ZacharyShaver/FPVTank_Prototype/research/README.md

# Research sprint (2026-10-13 to 2026-10-27)

Evidence for the research plan "Checks That Can Fail" (UM-LANL SPARC AI Research Fellow application, due
2026-10-27). The plan and the sprint schedule live in the FPVTank_Control session folder (`research-plan/`).

| Path | What |
|---|---|
| `data/iterations.csv` | Workstream A: one row per design finding, Sep 27 to Oct 12 (P), plus earlier drivetrain and electronics escapes (E). Retrospective. |
| `data/check_failures.csv` | Every recorded case of an automated check itself being wrong (false pass, false fail, weak control). |
| `analysis/iterations.py` | Statistics (`results/iterations_summary.json`) and `figures/iterations.png`. |
| `paper/` | The research plan, draft v6 (2026-10-25): `checks-that-can-fail-v6.html` and its PDF, Figure 1 `fig1_v6.png` from `make_fig1.py`; the PDF comes from Edge's print dialog, Save as PDF, or `pagefit.py --pdf` (US Letter, 3 pages; `pagefit.py --print` checks the fit first). `review-v3.md`, `review-v4.md` and `review-v5.md` (a cold read by a fresh agent) hold the reviews that made v4, v5 and v6. **Superseded:** drafts v5 and v4 (`checks-that-can-fail-v5.html`, `-v4.html`, their PDFs, `fig1_v4.png`) and draft v3 (`checks-that-can-fail-v3.html`, its PDF, `fig1.png`), kept as they were. The Oct 13 draft stays in the session folder. |

**How the data was made.** Finding times come from the session transcripts (Zach's message reporting the finding) or
from the check or slicer run. Fix times come from G-code and superseded-folder timestamps, or from `docs/decisions.md`
dates. `time_basis` says which: `exact` (minute), `approx`, `day`, `reconstructed`. Only `exact` rows enter the
cycle-time statistics. The transcripts themselves stay out of the repo; findings are paraphrased.

**Categories.** `found_by`:
- `bench`: physical handling or test.
- `review`: Zach looking at a model or view before printing.
- `check`: an automated check during design.
- `agent review`: the AI noticing a fault while designing.
- `slicer`: print preparation.
- `print`: a failure while printing.

Everything except `bench` and `print` counts as caught before printing. `check_had_passed` is `yes` when an existing
automated check had passed the defect.

Prospective data, logged as findings happen from 2026-10-13, goes in `data/iterations_live.csv` and is kept separate. Its times are the times of the commits that recorded each finding (the hash is in `notes`); IDs follow the order things were logged, and are never renumbered, because commits and PROTOCOL.md cite them.

**Hypothesis names.** `tumble/PROTOCOL.md` registered the 30 cm drops as its "H4"; in the paper they are H3b, and the paper's H4 is cycle time. The paper's H3c (15 cm) is PROTOCOL's H3c.
