ZacharyShaver/FPVTank_Prototype/docs/lessons/README.md

# Lessons

One dated file per lesson learned the hard way in CAD work, e.g. `2026-09-19-coincident-faces-and-insertion.md`.

The first three came over from FPVTank_Control's `docs/lessons/` in phase B (2026-09-27). Control keeps
its own drivetrain lesson.
