ZacharyShaver/FPVTank_Prototype/reference/solids/README.md

# Fit-check dummies

Solids of the real hardware, which the checks place next to Zach's parts:
- the servo, turned, with its tabs as bought and as snipped;
- the camera;
- the 6704 bearing;
- screw heads.

Nothing is stored here yet. Until then:
- the servo is built in code (`tools/kit.py`: `servo`, `servo_trimmed`);
- the camera is read from the generator's `camera/camera_dummy.step`;
- the bearing comes from the generator's `bearing_dummy.py`.

The generator is in `head-v2/generator/` now; export them here when a check needs them as files.
