ZacharyShaver/FPVTank_Prototype/head-v2/fusion/rev1-2026-09-24/README.md

# Zach's Fusion revision 1 (exported 2026-09-24)

These are his files as he sent them. `tools/config.py` (`ZACH`) maps them to parts:

| File | Part |
|---|---|
| `BODY_NUMBA1 (1) (1).stl` | ball_plus: the half the servo and camera go into |
| `ball_minus_revised.stl` | ball_minus |
| `ball_servo_post_revised.stl` | the post the tilt servo's spline presses into |

In this revision:
- the tilt servo is turned 90° and boxed in plates;
- the servo's case top stops on a plate at Y 21.24;
- the camera board sits on the front of his wall, at X 10.5.

Rev 2 (`head-v2/fixes/`) is these files plus the fixes.
