ZacharyShaver/FPVTank_Prototype/research/data/drops/README.md

# Physical drop tests (workstream E): raw data

Recorded by hand on paper, one mark per drop, and videoed. Transcribed from the sheet photo before any scoring;
the predictions were committed first (research/results/drop_predictions.json, commit 0718c2f).

## Run 1 (2026-10-13): 3 bodies x 6 starts x 5 drops = 90 drops, 12 US quarters

- `run1_sheet.jpg` is the sheet; `run1.csv` is the transcription, one row per drop.
- Zach's marks: X inverted, O upright, N nose down, T tail down (nose up), R right side, L left side, F front
  (read as nose down).
- Bodies are identified on the sheet by drawn icons. Zach, before scoring: top to bottom E2, E3, E1, so oval =
  E2_dome, rounded square = E3_tall, hill = E1_tub.
- Loading: coins first, then the spacer (Zach), which is **mass high** in DROP_TEST.md. The card asked for mass low
  first; the order of the two runs does not change either prediction.

## The E1 video (`IMG_1617.MOV`, Zach's Downloads, 174 MB, not in git)

- The same 6 cm session as the sheet. The video starts partway through: it holds the last 2 nose-down drops and
  all 25 after them, 27 in total. One more pick-up at 1:24 lifts the body out of frame and isn't a drop.
- `video_E1.csv` is my reading of each drop's landing from the frames, matched to the card's order of starting
  attitudes. It agrees with the sheet's E1 row on 24 of 27. The 3 that differ are drops 2-4 of the left-side block
  (video X O X, sheet O X O). Zach's call (2026-10-13): **go with the video** for E1.
- Correction to my first pass: I read drops 12 and 16 as "standing on end". They are lying on their side (base to
  one side), which is what Zach wrote (R). With that fixed, the right-side, tail-down, upside-down and 45 blocks
  match the sheet exactly.
- Release height: about 4-8 cm by eye. The simulation moves no E1 probability by more than 0.03 across 40-80 mm
  (`results/drop_predictions_E1_40mm.md`, `_E1_80mm.md`), so no drop is redone for height. A rerun at 60 mm reproduced
  the committed predictions exactly.
- **Nose and tail are swapped against the card.** Zach did the nose-down block first (2026-10-13), and the video
  cut off its first 3 drops. In its last 2 (video 1-2), the side profile is widest at the top, where the head's bump
  is. So "nose down" was flown with the head end **up**. In the tail-down block (video 4-7), the head end (the pointed
  end seen from the base) is plainly down. So Zach's "nose down" is the model's tail down, and vice versa. The
  scoring maps by the physical end, and assumes the same convention for E2 and E3 (same session, no video).
- Left and right: all three bodies are mirror-symmetric, so "left side" and "right side" (starts and rest states)
  are the same physics and get merged into "side" when scoring.
- Found while checking this: `tumble.classify` names the on-end rest states opposite to `scale_model.ATTITUDES`
  (+X up is called "nose down"). It doesn't touch P(upright) or anything already reported; when scoring, the
  predicted "nose up"/"nose down" rest labels are swapped back. Probabilities are unchanged.
- `results/drop_predictions_30cm.*` are the same model at 300 mm, for the 30 cm drops (recorded elsewhere, no
  video). They were run after those drops, so they count as post hoc.

## Slow-motion video 1 (`IMG_1628.MOV`, 2026-10-14, 240 fps, 434 MB, not in git)
- 5 drops of E3, weight low, filmed looking along the floor from about a metre away.
- Released from well above 6 cm: the body is in view and falling for about 0.18 s before it lands, already more than
  a 6 cm fall takes (0.11 s), so it fell at least 15 cm.
- The bodies land tilted and tumble; none landed flat.
- The 5th drop split the tape: the coins and the spacer spilled out.
- **Not usable for restitution**, which needs flat drops from 6 cm filmed from the side, close up.
- **Not part of H4.** H4's 30 cm data are the 2026-10-13 session's, which I still haven't seen. These drops I have
  seen, so they can't be a blind test.
- Qualitatively they agree with the bounce reading: after impact the body keeps moving, rocking onto its side and
  back, rather than stopping where it lands.

## Run 3: the 30 cm redo (2026-10-14), H4's primary data
- `run3_30cm_raw.txt` is Zach's message verbatim; `run3_30cm.csv` is the transcription, one row per drop.
- Heights were marked: a US letter sheet on edge plus a finger-width. No video.
- **Readings fixed before scoring.** Zach confirmed 1 and 2 after scoring ("second set was weight low"; x upside down,
  o right side up), so no rescoring was needed. He corrected 3:
  1. x = upside down, o = upright, as in runs 1 and 2. (A literal "x = on its bottom" would have the flat-topped
     E1 righting itself from most upside-down starts.)
  2. The second block, "weight in first then coins then tape", is mass low: the spacer first, coins by the base.
     The first block is mass high.
  3. "c" (E3, mass low, left side down, drop 5) is an unknown mark and is left out. Zach, after the first scoring:
     a typo for x. Corrected, and the run rescored on all 180 drops; the first scoring (179) is in git history.

## Slow-motion videos of the PLA ball (2026-10-14, 240 fps, not in git)
The ball is `models/ball_pla_40.stl`, printed like the bodies: 2 walls, 10% infill. It is dropped by hand onto the
same floor.
- `IMG_1640.MOV`: rough. The camera was too close to read the drop height reliably. Restitution 0.45-0.65.
  Superseded.
- `IMG_1642.MOV` (iPhone 15, 642 MB, 58 s, 13,869 frames, 239.5 fps average): side-on from floor level, against a
  black board. It has 12 drops from 7-12 cm, by the ball's own scale (Zach aimed for 6 cm without a ruler). Measured
  by `tumble/measure_ball.py`, with results in `results/ball_restitution.md`. **First-impact restitution: 0.39 mean,
  range 0.24-0.61.** Later, slower bounces have a median of 0.78.

## Run 4: the 15 cm drops from the drop stand (2026-10-17), H3c's data
- `run4_15cm_raw.txt` is Zach's message verbatim; `run4_15cm.csv` is the transcription, one row per drop.
- Released from the printed drop stand (`tumble/drop_stand.py`, PROTOCOL.md H3c third amendment), with the lowest
  point set at 150 mm by its gauge.
- **Readings fixed before scoring:**
  1. The legend is run 3's: x upside down, o upright, n and t Zach's nose and tail, r and l the sides.
  2. "Quarters against tape" is mass low: the pocket opens in the base (DROP_TEST.md), so coins against the tape sit
     by the base. "Spacer on tape" is mass high. Low came first, as the protocol asks.
  3. Each line names its body (listed E3, E2, E1 this time).
  4. The "c" (E3, mass low, nose down, drop 4) is an unknown mark and was left out of the first scoring. Zach, after
     it: a typo for x, as in run 3. Corrected, and the run rescored on all 180 drops; the first scoring (179) is in
     git history.
- Scored by `tumble/score_15cm.py` (`results/drop_scores_15cm.md`); the result is in PROTOCOL.md, H3c results.
