ZacharyShaver/FPVTank_Prototype/docs/audit/2026-10-25-leak-report.md

# Leak audit, 2026-10-25

**Where it stands (2026-10-26).** Tasks 1-6 are done. For Task 6 Zach chose option B. The history was rewritten:
- emails became the noreply address;
- the Wi-Fi values, private IPs and user name were scrubbed;
- the third-party files not cleared for sharing were removed.

The repo is now public. The old history is archived, still private, as `FPVTank_Prototype-private-old`
(`docs/decisions.md`, 2026-10-26). **The table below describes the history before that rewrite**: rerunning
`leakscan --history` on the public repo gives 0 blocking findings. The gallery still publishes from its own repo.

Scanned: every blob reachable from every branch, local and origin; each commit's author and committer email and its
message; and the metadata in photos, PNGs, PDFs, STEP files, STL headers, MP4s and CAD zips. Values are redacted.
Generated by `python tools/leakscan.py --history`.

**Fixed in the tree (Task 5, committed):**
- The Wi-Fi network name and password in three 2024 files (two Arduino sketches and the MicroPython `code.py`) are read
  from gitignored local files: `wifi_secrets.h` beside each sketch and `wifi_secrets.py` beside `code.py` (templates:
  `wifi_secrets.example.*`). The real values stay only in those local files (Zach, 2026-10-26).
- The printer's address lives in the untracked `tools/config_local.py` (template: `tools/config_local.example.py`), or in `FPVTANK_PRINTER`.
- User paths are repo-relative, or allowlisted as history notes.
- A pre-commit hook, `.githooks/pre-commit`, runs `leakscan --staged`. It refuses a commit that adds a credential, a token or a located photo.

After that commit, HEAD has 0 blocking findings. The 'decide' rows left: 30 private claude.ai links, 4 private IPs (the 2024
archive), and 1 PDF author (the third-party guide).

**Needs Zach:**
- The old Wi-Fi values are gone from the public history. They remain only in the private archive and the local backup,
  so rotating the password matters only if those ever leak. The report's redacted form shows 3 of its characters.
- Turn the hook on once in each clone: `git config core.hooksPath .githooks`. (The audit work is committed, the hook
  with its executable bit.)
- Personal email: done. Every commit in the public history carries the noreply address.
- The four 2024 IPs (the old robot and controller): fine privately. They are off the gallery.
- Private claude.ai links in 9 files (READMEs, HANDOFF.md, NOTES.md, briefs, a .txt): harmless privately. The gallery strips them.
- Third-party models: the files in reference/ and chassis-v1/parts/, and the meshes the chassis 3D pages embed (FPV-Rover
  V2.0 by Markus_p, CC BY-NC-SA 4.0; the Adafruit-layout PCA9685 board, licence not recorded; the Raspberry Pi 5,
  CC0; the MG90S servo, origin not recorded). The gallery holds those pages until he decides.
- The fellowship application drafts (research/paper/): kept off the gallery.
- One third-party PDF in reference/ names its author (the guide's own author). History also holds the same guide under its
  pre-reorganisation folder, `3D - Model Tank/`. The reference/ line above covers it.

**Calls already made:**
- Fusion archives are ignored (Zach, 2026-10-25: nothing in them leaks). They are allowlisted as `unreadable *.f3d`;
  Python 3.10 can't read their zstd members.
- `--staged` scans only what is staged, not the whole index: about a second per commit instead of 30, and committed
  findings aren't flagged again.
- Each report row lists every path it covers.

**Known gaps** (what the scanner doesn't see):
- Credential names other than ssid, password, pwd, psk and pass. A generic `api_key=`, `token=` or `secret=` is caught
  only when the value has a known token prefix. MicroPython's positional `wlan.connect(...)` isn't matched either.
- A path after the escapes `\u000a`, `\x0a`, `\f`, `\b`, `\v` or `\0`, and text glued to a base64 run.
- Annotated-tag messages, and refs that point straight at a blob or tree.
- PDF authors in hex, UTF-16 or XMP; XMP GPS tags; Orca 3MF `.config` members; the zstd members of `.f3d` files.
- Binary types with no reader (gif, webp, woff2, wasm, pkl, npz, glb): reported as 'unreadable' only by `--path`.

| grade | rule | value (redacted) | where | first commit | note |
|---|---|---|---|---|---|
| must | credential | ne…s (13 chars) | FPVT Robot/DCMotorTest/DCMotorTest.ino, FPVT Robot/DCMotorTest/WiFiClient/WiFiClient.ino, FPVT Robot/code.py, archive/v1-2024/robot/DCMotorTest/DCMotorTest.ino, archive/v1-2024/robot/DCMotorTest/WiFiClient/WiFiClient.ino, archive/v1-2024/robot/code.py | 6e3191935f | a credential in source; replace with a placeholder and rotate it (6x) |
| must | credential | Go…! (9 chars) | FPVT Robot/DCMotorTest/DCMotorTest.ino, FPVT Robot/DCMotorTest/WiFiClient/WiFiClient.ino, FPVT Robot/code.py, archive/v1-2024/robot/DCMotorTest/DCMotorTest.ino, archive/v1-2024/robot/DCMotorTest/WiFiClient/WiFiClient.ino, archive/v1-2024/robot/code.py | 6e3191935f | a credential in source; replace with a placeholder and rotate it (6x) |
| decide | artifact_link | cl…H (41 chars) | head-v2/generator/ball-head-validation-handoff.md:26 | 2353965554 | a private claude.ai link (1x) |
| decide | artifact_link | cl…t (41 chars) | head-v2/generator/pan-coil-360-brief.md, head-v2/generator/tree-hood/README.md, head-v2/generator/tree-parts-b/HANDOFF.md | 2353965554 | a private claude.ai link (5x) |
| decide | artifact_link | cl…j (41 chars) | head-v2/fixes/pan_print_set_README.txt, head-v2/NOTES.md | c048280631 | a private claude.ai link (5x) |
| decide | artifact_link | cl…3 (41 chars) | chassis-v2/HANDOFF.md, chassis-v2/README.md | 8f9533fb87 | a private claude.ai link (2x) |
| decide | artifact_link | cl…4 (41 chars) | chassis-v2/HANDOFF.md, chassis-v2/README.md | 8f9533fb87 | a private claude.ai link (2x) |
| decide | artifact_link | cl…q (41 chars) | chassis-v2/HANDOFF.md, chassis-v2/README.md | 8f9533fb87 | a private claude.ai link (2x) |
| decide | artifact_link | cl…q (41 chars) | chassis-v2/HANDOFF.md, chassis-v2/README.md | 8f9533fb87 | a private claude.ai link (2x) |
| decide | artifact_link | cl…R (41 chars) | chassis-v2/HANDOFF.md:25 | 8f9533fb87 | a private claude.ai link (1x) |
| decide | artifact_link | cl…8 (41 chars) | chassis-v2/HANDOFF.md, chassis-v2/README.md | 8f9533fb87 | a private claude.ai link (2x) |
| decide | artifact_link | cl…Q (41 chars) | chassis-v2/HANDOFF.md, chassis-v2/README.md | 8f9533fb87 | a private claude.ai link (2x) |
| decide | artifact_link | cl…s (41 chars) | chassis-v2/HANDOFF.md, chassis-v2/README.md | 8f9533fb87 | a private claude.ai link (2x) |
| decide | artifact_link | cl…2 (41 chars) | chassis-v2/HANDOFF.md, chassis-v2/README.md | 8f9533fb87 | a private claude.ai link (2x) |
| decide | artifact_link | cl…A (41 chars) | chassis-v2/README.md:59 | 8f9533fb87 | a private claude.ai link (1x) |
| decide | artifact_link | cl…J (41 chars) | chassis-v2/README.md:220 | 8f9533fb87 | a private claude.ai link (1x) |
| decide | artifact_link | cl…T (41 chars) | chassis-v2/README.md:229 | 8f9533fb87 | a private claude.ai link (1x) |
| decide | artifact_link | cl…k (41 chars) | head-v2/NOTES.md, head-v2/fixes/print_rev2_README.txt | 8f9533fb87 | a private claude.ai link (2x) |
| decide | artifact_link | cl…k (41 chars) | head-v2/fixes/pan_print_set_README.txt:367 | 8f9533fb87 | a private claude.ai link (1x) |
| decide | author_email | zt…m (20 chars) | (commit metadata) | a061c113c5 | an author or committer email (91x) |
| decide | doc_author | … (3 chars) | 3D - Model Tank/3D Printed FPV Rover V2.0 : 11 Steps (with Pictures) - Instructables.pdf, reference/fpv-rover-v2/FPV Rover V2.0 - Instructables guide.pdf | 4ca9b695d0 | PDF author (2x) |
| decide | private_ip | 19…2 (11 chars) | FPVT Robot/DCMotorTest/WiFiClient/README.md, archive/v1-2024/robot/DCMotorTest/WiFiClient/README.md | 6e3191935f | an address on the home network (2x) |
| decide | private_ip | 10…1 (10 chars) | FPVT Robot/DCMotorTest/WiFiClient/WiFiClient.ino, FPVT Robot/code.py, archive/v1-2024/robot/DCMotorTest/WiFiClient/WiFiClient.ino, archive/v1-2024/robot/code.py | 6e3191935f | an address on the home network (4x) |
| decide | private_ip | 10…2 (9 chars) | FPVT Controller/SocketServer.py, archive/v1-2024/controller/SocketServer.py | 4ddbd823ef | an address on the home network (3x) |
| decide | private_ip | 10…4 (9 chars) | tools/config.py:39 | 8f9533fb87 | an address on the home network (1x) |
| decide | unreadable | … (0 chars) | research/results/search3/screen.npz | 466883b56d | over 8 MB, unscanned (1x) |
| decide | user_path | C:…a (14 chars) | HANDOFF.md, MOVE-PLAN.md, head-v2/NOTES.md, (commit message), head-v2/generator/generators/render2.py, head-v2/generator/generators/render_stl.py, research/results_run.log, research/sweep_run.log, research/results/wheels3/superseded - tune_ledges_soft_floor.log | a061c113c5 | an absolute path with the user name (33x) |
| decide | user_path | On…e (8 chars) | HANDOFF.md, MOVE-PLAN.md, head-v2/NOTES.md, (commit message) | a061c113c5 | an absolute path with the user name (25x) |
