ZacharyShaver/FPVTank_Prototype/head-v2/generator/generators/requirements-cad.txt

# Dev-machine only. NOTHING on the Pi imports any of this.
# Superseded 2026-10-30 by one pinned list for the whole repo: this file and tools/requirements.txt listed the same
# packages, neither with versions (code review). Kept so the old command still works.
#
#   pip install -r requirements-cad.txt
#
-r ../../../tools/requirements.txt
