ZacharyShaver/FPVTank_Prototype/head-v2/generator/tree-parts-b/mesh_report.txt

print/axle.stl               128944 faces  watertight=True  manifold=True  bodies=1  self-int=0  vol=3.67 cm3  bed 19.9 x 19.9, 13.5 tall
print/ball_minus.stl         249952 faces  watertight=True  manifold=True  bodies=1  self-int=0  vol=11.78 cm3  bed 59.2 x 61.4, 24.9 tall
print/ball_plus.stl          250000 faces  watertight=True  manifold=True  bodies=1  self-int=0  vol=11.56 cm3  bed 59.2 x 61.4, 30.3 tall
print/cap_minus.stl          158548 faces  watertight=True  manifold=True  bodies=1  self-int=0  vol=1.87 cm3  bed 35.0 x 35.0, 3.6 tall
print/fork.stl               249976 faces  watertight=True  manifold=True  bodies=1  self-int=0  vol=55.89 cm3  bed 70.3 x 68.0, 62.0 tall
print/post.stl               192076 faces  watertight=True  manifold=True  bodies=1  self-int=0  vol=2.79 cm3  bed 35.0 x 35.0, 8.0 tall
print/roots.stl              163012 faces  watertight=True  manifold=True  bodies=1  self-int=0  vol=17.78 cm3  bed 51.0 x 51.0, 10.5 tall
fusion/axle.obj                4000 faces  watertight=True  manifold=True  bodies=1  self-int=0  vol=3.67 cm3
fusion/ball_minus.obj         20000 faces  watertight=True  manifold=True  bodies=1  self-int=0  vol=11.78 cm3
fusion/ball_plus.obj          20000 faces  watertight=True  manifold=True  bodies=1  self-int=0  vol=11.56 cm3
fusion/cap_minus.obj           4000 faces  watertight=True  manifold=True  bodies=1  self-int=0  vol=1.87 cm3
fusion/fork.obj               60000 faces  watertight=True  manifold=True  bodies=1  self-int=0  vol=55.89 cm3
fusion/post.obj                5000 faces  watertight=True  manifold=True  bodies=1  self-int=0  vol=2.79 cm3
fusion/roots.obj              16000 faces  watertight=True  manifold=True  bodies=1  self-int=0  vol=17.78 cm3
ENVELOPE (assembled) [-42.3 -34.   -0. ] -> [28.5 34.  82.7]  size [70.8 68.  82.7]
print/fork.stl             550000 faces  watertight=True  manifold=True  bodies=1  self-int=26  vol=55.61 cm3   <-- CHECK
fusion/fork.obj             60000 faces  watertight=True  manifold=True  bodies=1  self-int=0  vol=55.61 cm3
ENVELOPE [-42.3 -34.   10.5] -> [28.  34.  72.5]  size [70.3 68.  62. ]
print/fork.stl             550000 faces  watertight=True  manifold=True  bodies=1  self-int=24  vol=55.02 cm3   <-- CHECK
fusion/fork.obj             60000 faces  watertight=True  manifold=True  bodies=1  self-int=0  vol=55.02 cm3
ENVELOPE [-42.3 -34.   10.5] -> [28.  34.  72.5]  size [70.3 68.  62. ]
print/fork.stl             550000 faces  watertight=True  manifold=True  bodies=1  self-int=44  vol=54.51 cm3   <-- CHECK
fusion/fork.obj             60000 faces  watertight=True  manifold=True  bodies=1  self-int=0  vol=54.51 cm3
print/stub.stl             250000 faces  watertight=True  manifold=True  bodies=1  self-int=0  vol=6.72 cm3
fusion/stub.obj              6000 faces  watertight=True  manifold=True  bodies=1  self-int=0  vol=6.72 cm3
ENVELOPE [-42.3 -34.   10.5] -> [28.  34.  72.5]  size [70.3 68.  62. ]
print/fork.stl             550000 faces  watertight=True  manifold=True  bodies=1  self-int=46  vol=54.48 cm3   <-- CHECK
fusion/fork.obj             60000 faces  watertight=True  manifold=True  bodies=1  self-int=0  vol=54.48 cm3
print/stub.stl             250000 faces  watertight=True  manifold=True  bodies=1  self-int=0  vol=6.72 cm3
fusion/stub.obj              6000 faces  watertight=True  manifold=True  bodies=1  self-int=0  vol=6.72 cm3
ENVELOPE [-42.3 -34.   10.5] -> [28.  34.  72.5]  size [70.3 68.  62. ]
print/fork.stl             550000 faces  watertight=True  manifold=True  bodies=1  self-int=44  vol=54.69 cm3   <-- CHECK
fusion/fork.obj             60000 faces  watertight=True  manifold=True  bodies=1  self-int=0  vol=54.69 cm3
ENVELOPE [-42.3 -34.   10.5] -> [28.  34.  72.5]  size [70.3 68.  62. ]
print/fork.stl             550000 faces  watertight=True  manifold=True  bodies=1  self-int=40  vol=55.79 cm3   <-- CHECK
fusion/fork.obj             60000 faces  watertight=True  manifold=True  bodies=1  self-int=0  vol=55.79 cm3
print/stub.stl             250000 faces  watertight=True  manifold=True  bodies=1  self-int=0  vol=6.02 cm3
fusion/stub.obj              6000 faces  watertight=True  manifold=True  bodies=1  self-int=0  vol=6.02 cm3
ENVELOPE [-42.3 -34.   10.5] -> [28.  34.  72.5]  size [70.3 68.  62. ]
print/fork.stl             550000 faces  watertight=True  manifold=True  bodies=1  self-int=40  vol=56.52 cm3   <-- CHECK
fusion/fork.obj             60000 faces  watertight=True  manifold=True  bodies=1  self-int=0  vol=56.52 cm3
ENVELOPE [-42.3 -34.   10.5] -> [28.  34.  72.5]  size [70.3 68.  62. ]
