ZacharyShaver/FPVTank_Prototype/checks/backtests/2026-10-24-adversary-P23/adversary/p_design.txt

design: slide least play to the base 0.20 mm, least travel to the drum 0.65 mm; drum met first at: none
design: turn  first meets the base at +-0.45 deg (0.17 mm at the rib)
