ZacharyShaver/FPVTank_Prototype/THIRD_PARTY.md

# Third-party files

The rest of this repository is Zach Shaver's own work. These files come from others; each folder's record says where
from.

**Tracked, under their own licences:**
- `reference/fpv-rover-v2/` and its copies in `chassis-v1/parts/`: FPV-Rover V2.0 (Tank) by Markus_p, CC BY-NC-SA 4.0
  (`reference/fpv-rover-v2/SOURCE.md`).
- `chassis-v1/parts/third-party/luengoa-flex-track/`: flexible TPU tracks by Luengoa, CC BY-NC (`LICENSE.txt`).
- `reference/raspberry-pi-5/*.stl` and the Pi 5 in `chassis-v1/from_fusion/`: Printables model 727155, CC0
  (`reference/raspberry-pi-5/SOURCE.md`).

**Kept locally and gitignored, not redistributed** (their records say how to get them):
- the saved Printables and Instructables pages for FPV-Rover V2.0 and the Pi 5 (copies of other people's web pages);
- the PCA9685 servo-driver models in `reference/pca9685/` (licence not recorded);
- the Pi 5 case in `reference/downloads/rpi5-case/`, from Printables (link and licence not recorded), which
  `twin/pi_box.py` reads;
- the MG90S servo and horn models in `head-v2/generator/pan-coil-b/` (licence not recorded).

These files were removed from the git history too, on 2026-10-26. The MG90S model's geometry still appears, exported
from Zach's assembly, in `head-v2/generator/pan-coil-b/fusion/servo.obj` and `horn.obj` and in that folder's
`viewer_pan_coil_b.js`. Those stay tracked by Zach's call (2026-10-26). The public gallery shows the servo as a plain
stand-in box.
