ZacharyShaver/FPVTank_Prototype/checks/predictions/2026-11-11-spring-stack.md

# Predictions: the spring stack (PLA plate 2026-11-10, TPU clips 2026-11-11)

The first file here. The TPU lines were written in `docs/decisions.md` before that print started and moved here after;
the PLA lines are the noise screen's numbers and the plate picture's "Tomorrow" steps. Scored 2026-11-11 from Zach's
bench (ledger L19, L20).

| # | Observable | Expected | Rests on | Score |
|---|---|---|---|---|
| 1 | The ESC and PCA boxes drop onto the patch | with no force (screen: 94 % and 88 % at 0.10 error) | error size, press limit: guesses | **held**: "no force, slightly loose", 3 of 3 |
| 2 | Each ESC goes into each box | both fit, the top doesn't press it | his 34.0 caliper | **held**: "both work" |
| 3 | The clips' prongs go in by hand and stay in | yes | prong 3.0 x 4.6 in 5.1: untested | **held**: "lock into the top very well" |
| 4 | Grams to press a clip flat | about 420, 870, 1370 g (0.8, 1.2, 1.6) | TPU stiffness 40 MPa: guess | not tested |
| 5 | The 1.2 blade stops the rattle under the hoop | yes | as 4 | not tested (blade not reported) |
| 6 | Sideways under a crash | not predicted | | **escape** (L20): a kick slides the stack along the hoop |
