ZacharyShaver/FPVTank_Prototype/docs/superpowers/plans/2026-10-25-leak-audit.md

# Repo Leak Audit Implementation Plan

> **For agentic workers:** REQUIRED SUB-SKILL: Use superpowers:subagent-driven-development (recommended) or superpowers:executing-plans to implement this plan task-by-task. Steps use checkbox (`- [ ]`) syntax for tracking.

**Goal:** Find everything in FPVTank_Prototype, in the working tree and in every commit, that shouldn't become public, fix what can be fixed in place, and settle how anything gets published.

**Architecture:** One scanner, `tools/leakscan.py`, with a rule table (regexes plus metadata readers for images, PDFs, STEP and zip-based CAD files). It scans a folder, the tracked files at HEAD, or every blob reachable from every ref plus commit metadata. Findings are deduplicated, redacted (a value is never printed whole) and graded `must` (blocks publishing) or `decide` (Zach's call). Every rule is tested against a planted case that must be found and a near-miss that must not (the repo's negative-control rule, CLAUDE.md). The same scanner gates the Pages site (plan `2026-10-25-pages-showcase.md`) and runs as a pre-commit hook.

**Tech Stack:** Python 3.10 standard library (`re`, `subprocess`, `zipfile`, `unittest`), Pillow 12 (EXIF), git 2.x, gh 2.95.

## Global Constraints

- Run with `python` (Zach's Microsoft Store Python 3.10). No new pip installs except `git-filter-repo`, and only in Task 6 option B, after Zach says yes.
- Never print, log, commit or paste a found secret's value. Reports show `ab…z (9 chars)` at most.
- The repo is PRIVATE (`gh repo view`: `visibility PRIVATE`). Nothing here makes it public; that is Task 6's decision, Zach's.
- Commit only when Zach asks (CLAUDE.md); never push without asking; never rewrite history without his explicit yes.
- Every check ships with a negative control: a planted case it must flag and a near-miss it must not.
- Write documents in the third person; keep them short (CLAUDE.md).

## What a first look already found (2026-10-25, before any of this was built)

| Finding | Where | Grade |
|---|---|---|
| A real Wi-Fi network name and password | `archive/v1-2024/robot/DCMotorTest/DCMotorTest.ino:45-46`, `archive/v1-2024/robot/DCMotorTest/WiFiClient/WiFiClient.ino:20-21`, in every commit since the archive was added | must |
| Zach's personal email as author of 91 commits | git metadata (the other 5 use the GitHub noreply address) | decide |
| Home-network addresses | `tools/config.py:39` (the K2 printer, whose Moonraker API has no login), `archive/v1-2024/controller/SocketServer.py:3`, `archive/v1-2024/robot/code.py:79`, `WiFiClient.ino:23` | decide |
| The Windows user name in absolute paths | 10 tracked files (`research`, `head-v2/generator/generators`, `docs/reorg-2026-09`, `docs/lessons`, `head-v2`) | decide |
| Third-party files: the FPV-Rover download (Instructables PDF, STLs), Raspberry Pi 5 and PCA9685 models | `reference/`, `chassis-v1/parts/` | decide (licences) |
| The fellowship application drafts | `research/paper/` | decide |
| Clean: no EXIF or GPS in `research/data/drops/run1_sheet.jpg`; STEP headers say only "Author"; no API tokens or private keys; nothing sensitive ever deleted from history | | ok |

The tool below makes this repeatable and complete (every blob in history, every binary's metadata), rather than a one-off grep.

---

### Task 1: The scanner's rules, on text, with planted cases

**Files:**
- Create: `tools/leakscan.py`
- Create: `tools/tests/__init__.py` (empty)
- Create: `tools/tests/test_leakscan.py`

**Interfaces:**
- Produces: `Finding` (dataclass: `rule: str`, `grade: str` (`'must'` or `'decide'`), `path: str`, `line: int`, `value: str`, `note: str`, `commit: str = ''`); `scan_text(path: str, text: str) -> list[Finding]`; `redact(value: str) -> str`.

- [ ] **Step 1: Write the failing tests**

```python
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
