ZacharyShaver/FPVTank_Prototype/head-v2/generator/concept/ball_head_render_sheet.png

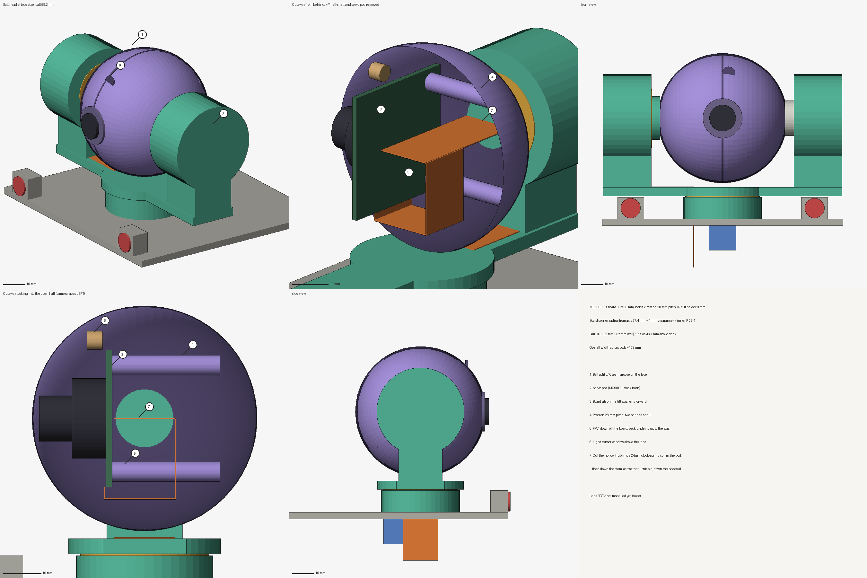
head-v2/generator/concept/ball_head_render_sheet.png
