ZacharyShaver/FPVTank_Prototype/research/data/drops/run1_sheet.jpg

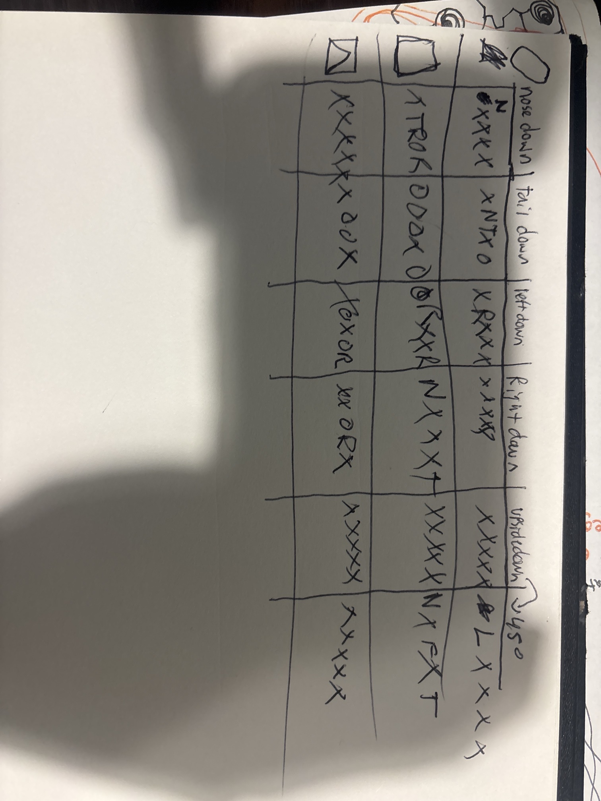
research/data/drops/run1_sheet.jpg
