ZacharyShaver/FPVTank_Prototype/research/figures/chassis3_finalists.png

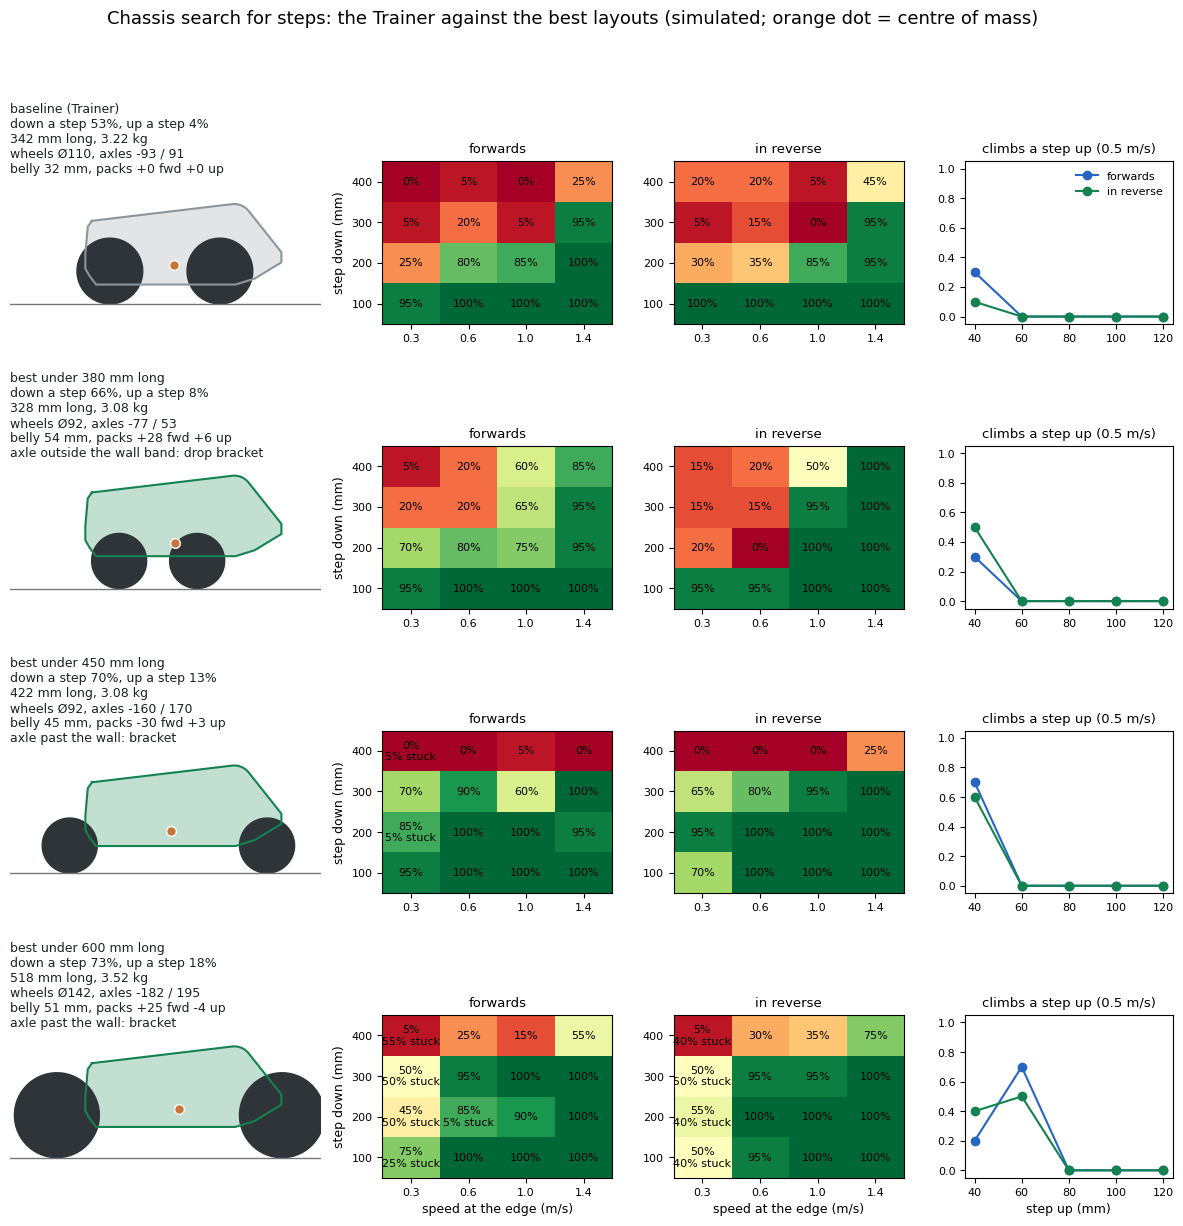
research/figures/chassis3_finalists.png
