ZacharyShaver/FPVTank_Prototype/research/figures/e4_ground.png

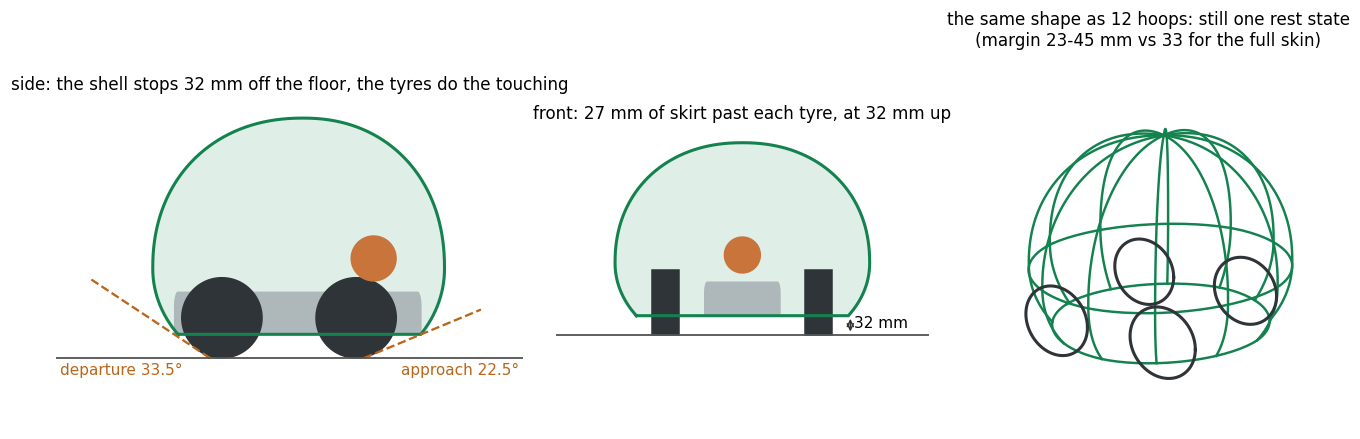
research/figures/e4_ground.png
