ZacharyShaver/FPVTank_Prototype/research/figures/iterations.png

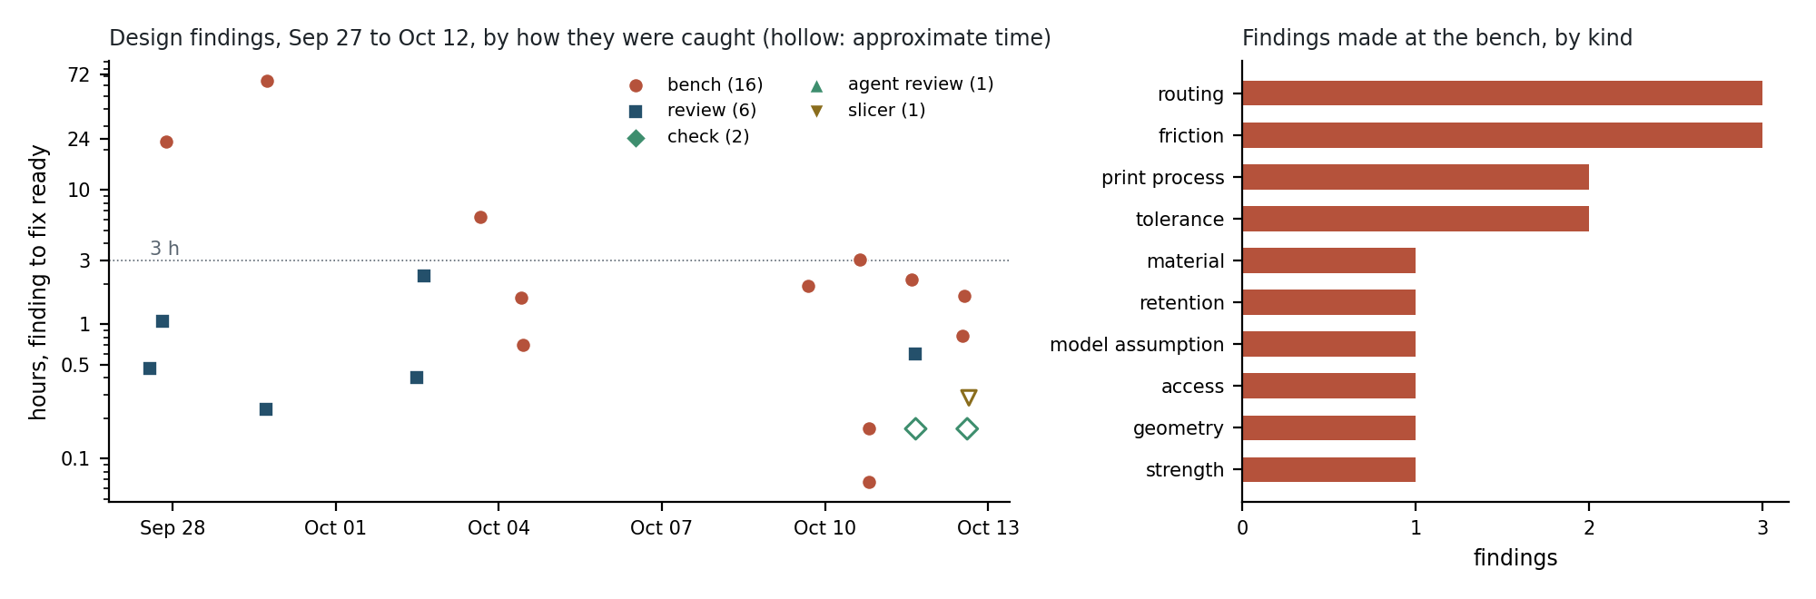
research/figures/iterations.png
