ZacharyShaver/FPVTank_Prototype/research/figures/mutation.png

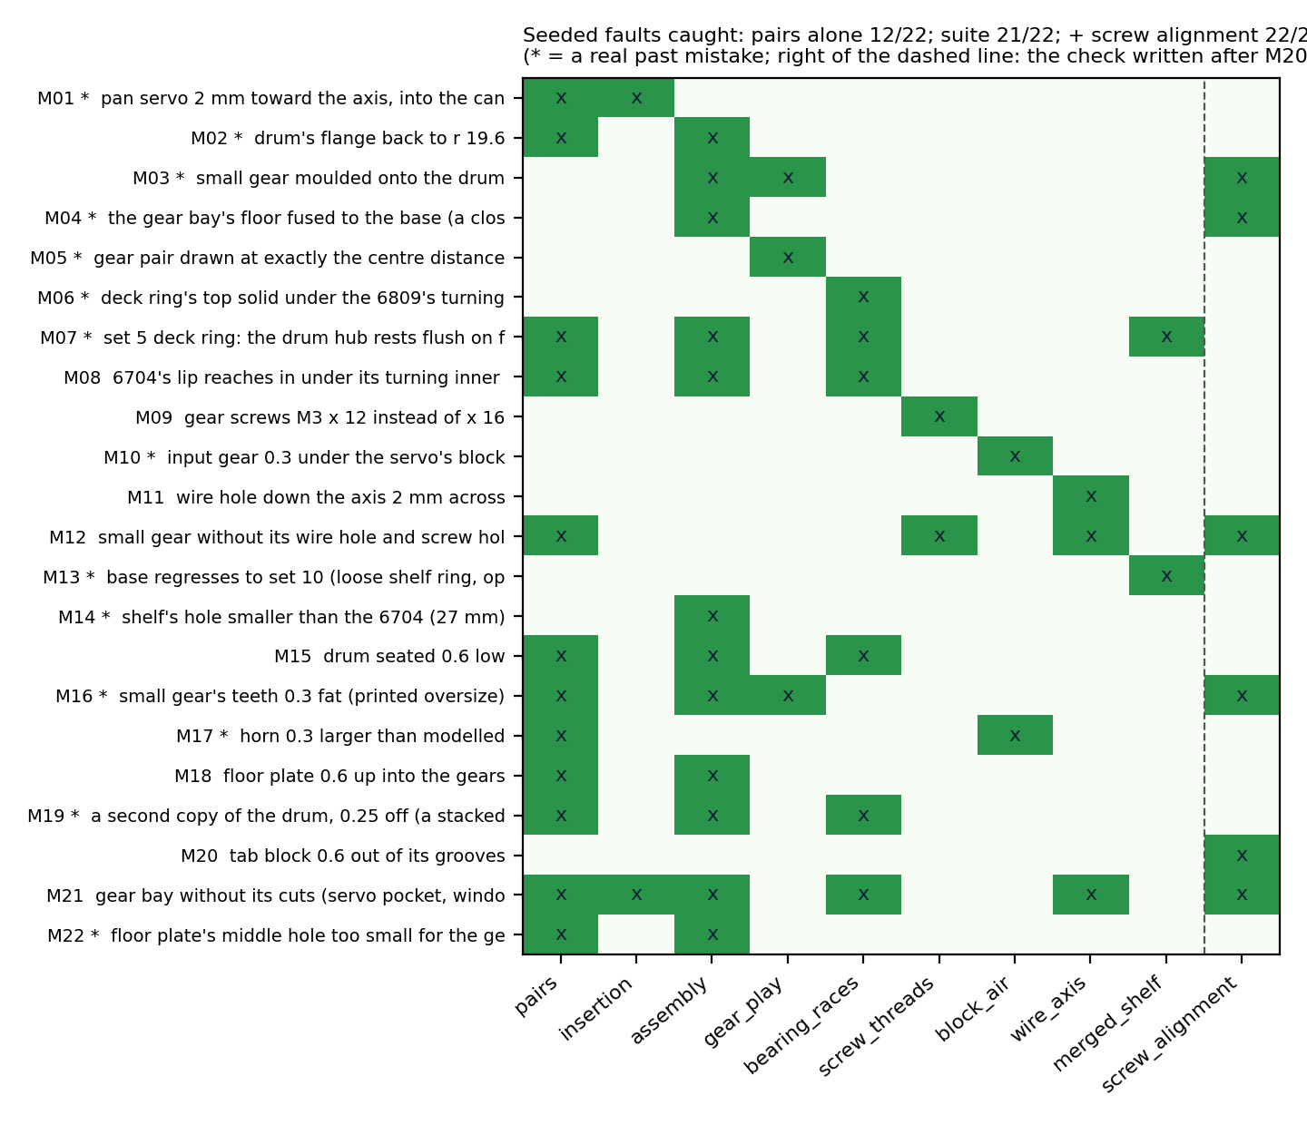
research/figures/mutation.png
