ZacharyShaver/FPVTank_Prototype/research/figures/pose3_poses.png

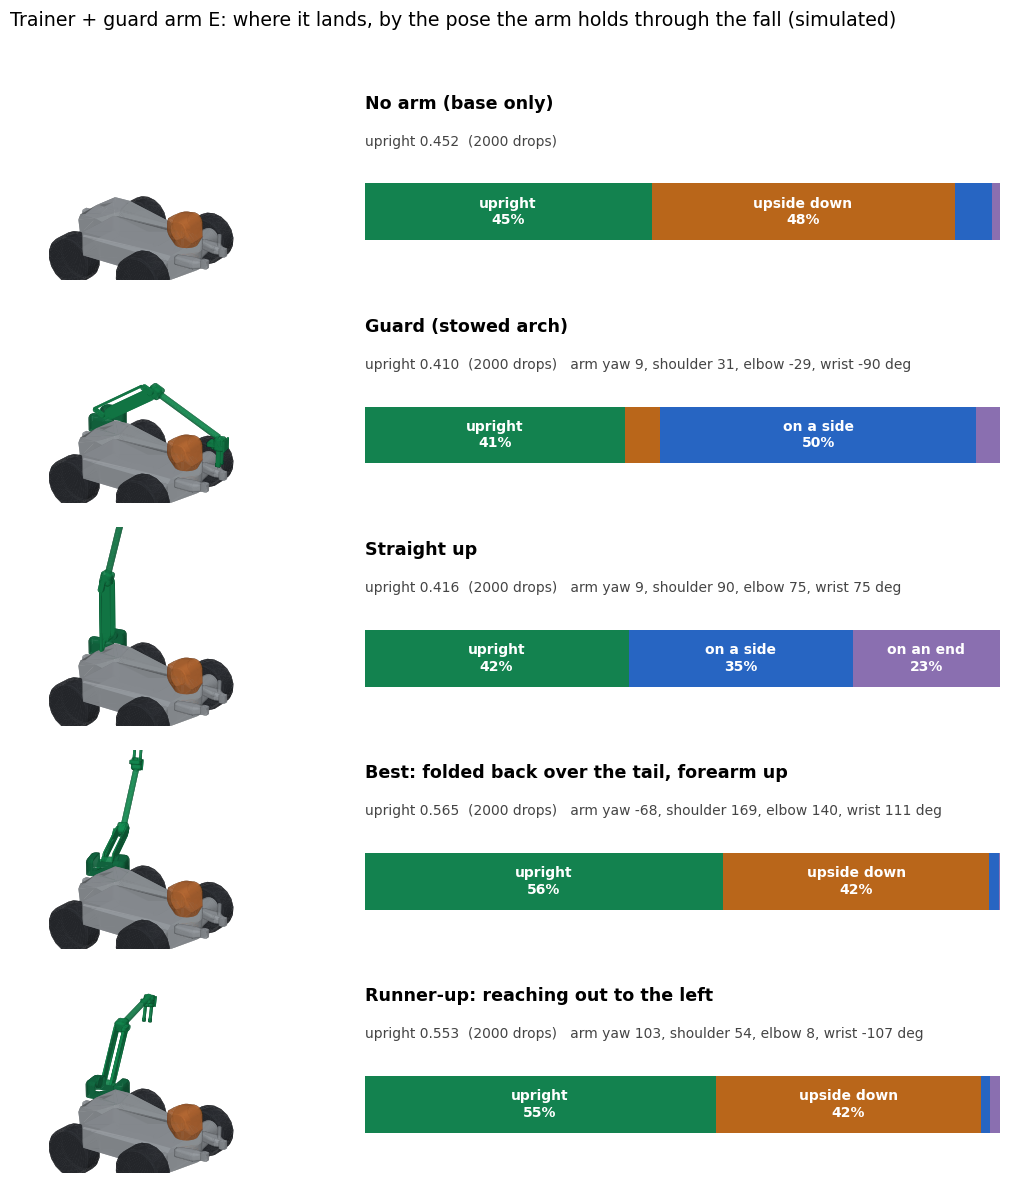
research/figures/pose3_poses.png
