ZacharyShaver/FPVTank_Prototype/research/figures/search3_top_designs.png

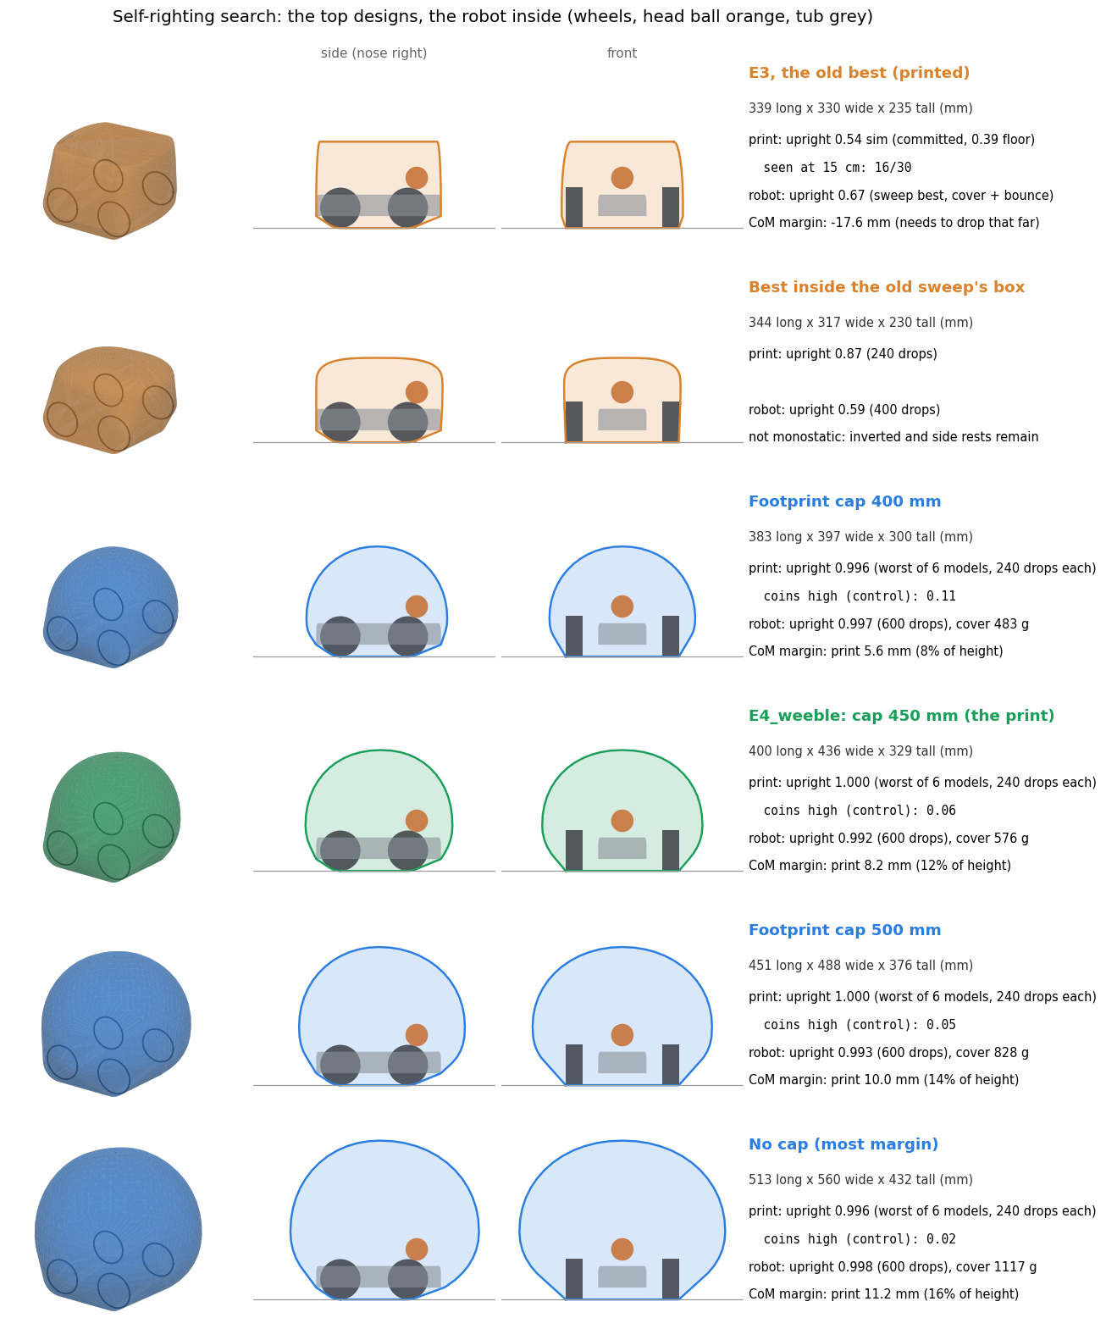
research/figures/search3_top_designs.png
