ZacharyShaver/FPVTank_Prototype/research/figures/sim_drops.png

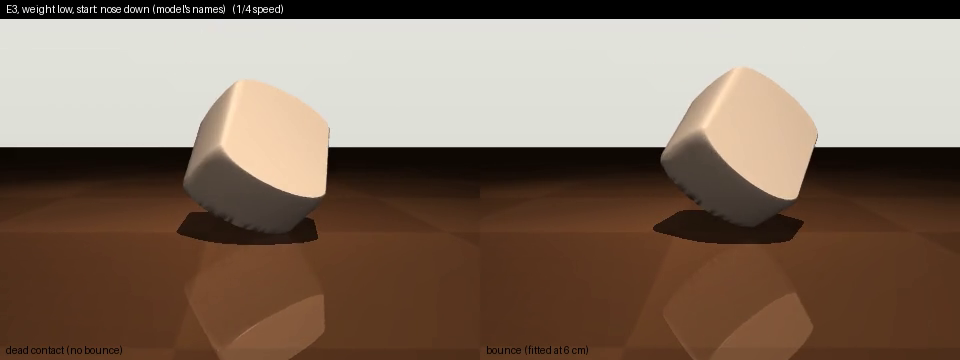
research/figures/sim_drops.png
