ZacharyShaver/FPVTank_Prototype/research/figures/sim_vs_reality.png

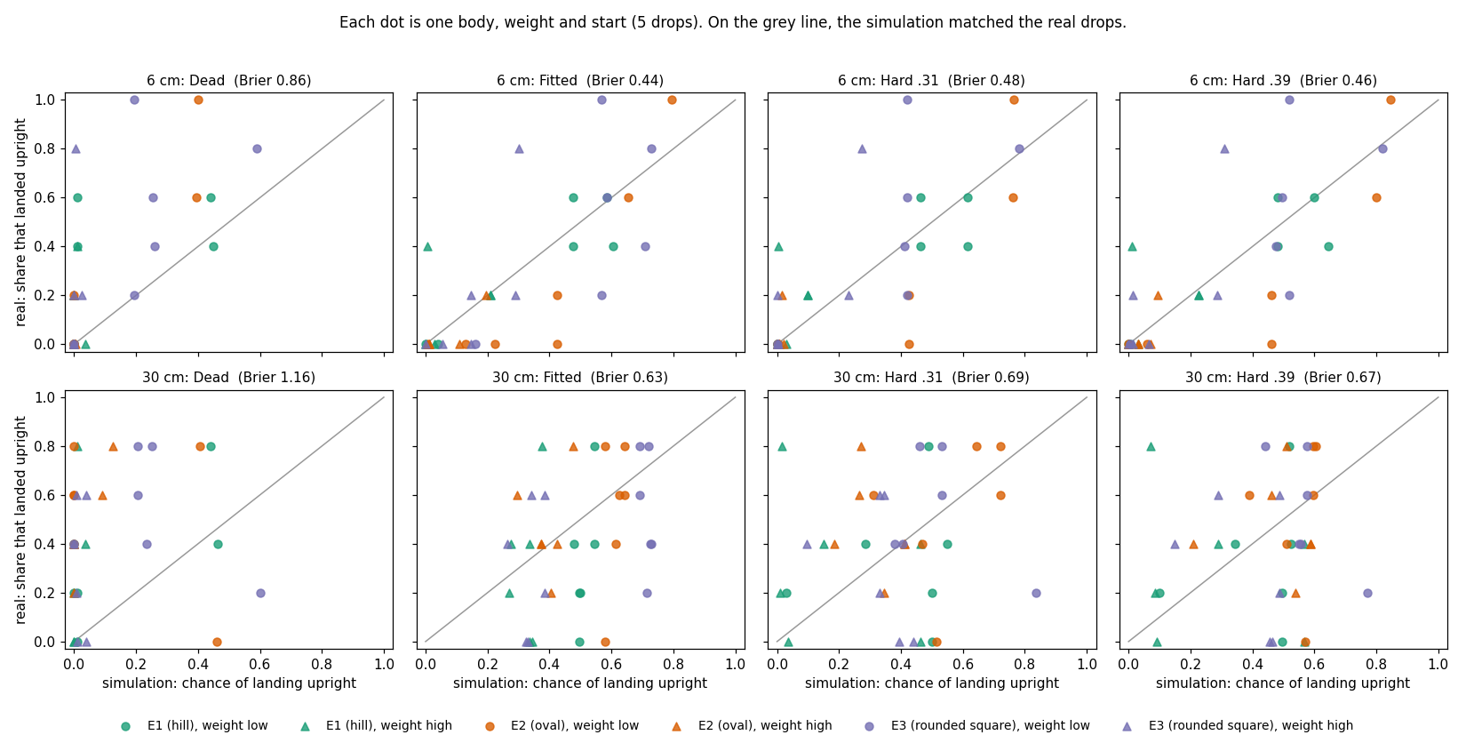
research/figures/sim_vs_reality.png
