ZacharyShaver/FPVTank_Prototype/research/figures/surrogate.png

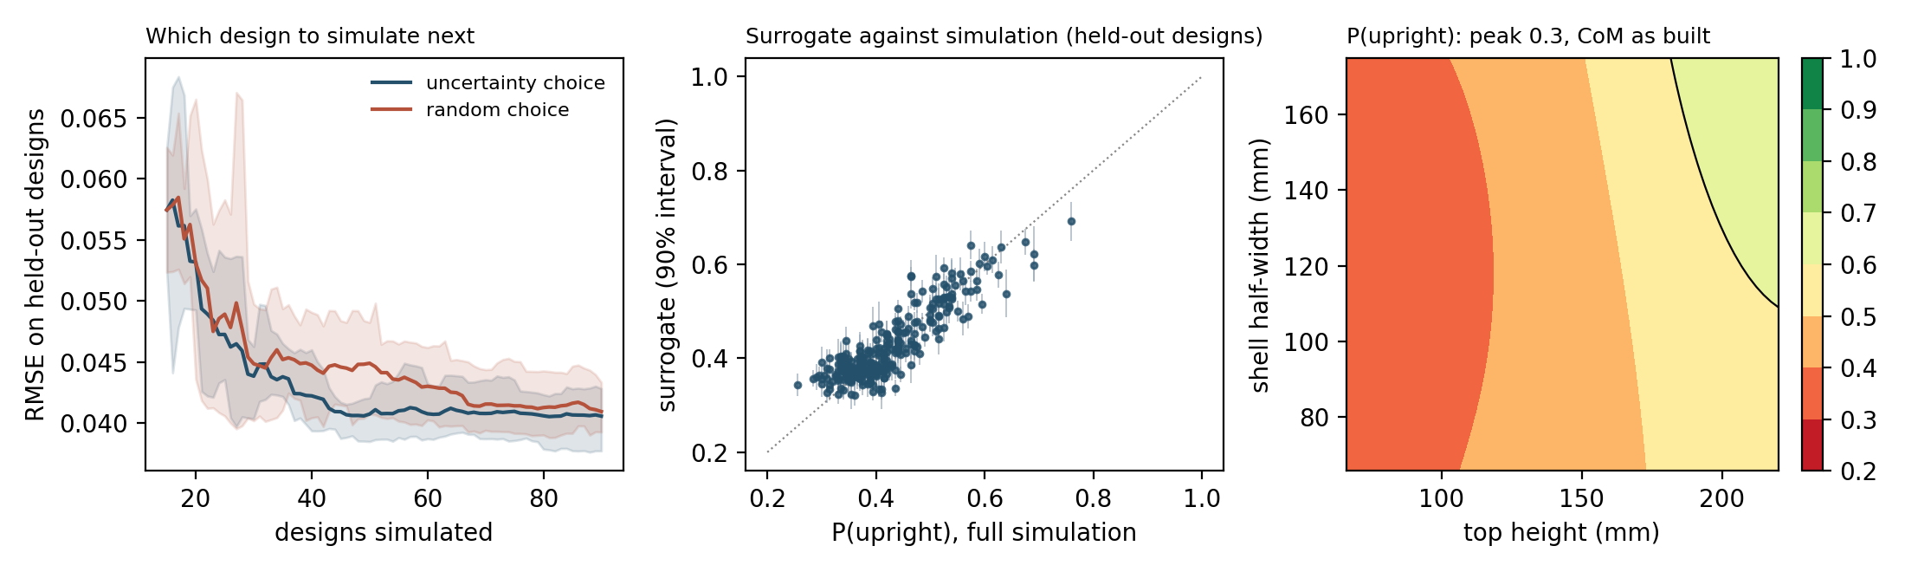
research/figures/surrogate.png
