ZacharyShaver/FPVTank_Prototype/research/figures/surrogate_gp.png

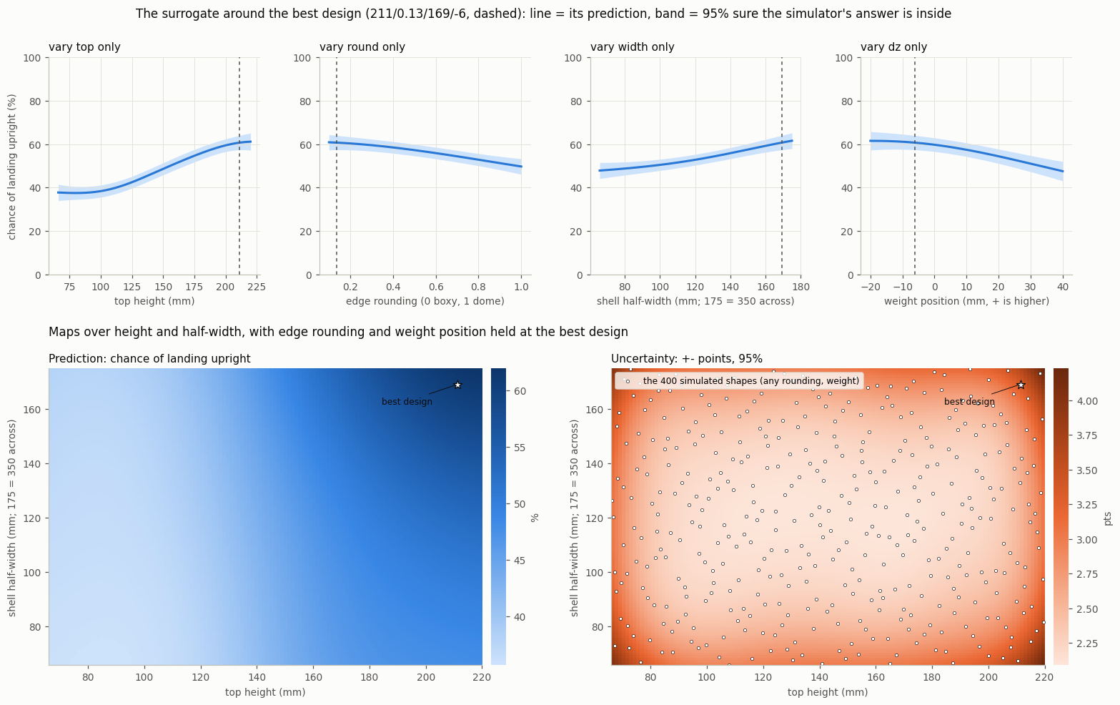
research/figures/surrogate_gp.png
