ZacharyShaver/FPVTank_Prototype/head-v2/generator/tree-parts-b/features.md

# Variant B: feature table for the two MESH parts

Only `fork` and `roots` are here. The other five parts -- `post`, `axle`, `cap_minus`,
`ball_plus`, `ball_minus` -- are not meshes at all any more: they are real solids in
`step/`, with every feature already cut and editable. Nothing below applies to them.

Frame: mm, X forward, Y along the tilt axis (+Y = post side), Z up from the deck top.
Tilt axis at X 0, Z 52. Pan axis is the Z axis.

Workflow: import `fusion-solid/<part>_blank.obj`, convert it to a body, then cut these
natively so they stay editable when a measurement moves. Two rows are marked ALREADY IN
THE BLANK -- they are organic, they could not be redrawn by hand, and they are already there.

Generated by `generators/step_mesh_prep.py`.

## fork

| Feature | Where | Size / note |
|---|---|---|
| +Y bearing seat (6704) | tilt axis, Y 26.5..30.5 | Ø27.1, teardrop roof |
| +Y ball-stub clearance | tilt axis, Y 25..26.5 | Ø20.8 |
| +Y post bore | tilt axis, Y 30.5..35 | Ø16 |
| +Y flange recess | tilt axis, Y 32.2..34 | Ø35.5 × 1.8 deep -- post flange sits flush |
| +Y flange pilots ×3 (M2 thread-forming) | r 15.5 at 30°/150°/270° (from +X toward +Z), from Y 34 inboard | Ø1.7 × 9 |
| -Y bearing seat (6704) | tilt axis, Y -30.5..-26.5 | Ø27.1, teardrop roof |
| -Y axle bore, inboard | tilt axis, Y -30.5..-24.5 | Ø20.8 |
| -Y axle bore, outboard | tilt axis, Y -35..-30.5 | Ø20.8 |
| -Y flange recess | tilt axis, Y -34..-32.2 | Ø35.5 × 1.8 deep -- cap_minus sits flush |
| -Y flange pilots ×3 (M2 thread-forming) | r 15.5 at 30°/150°/270° (from +X toward +Z), from Y -34 inboard | Ø1.7 × 9 |
| Pan horn pocket, up from the underside | X ±17.2, Y ±3.1, Z 10.5..13.2 | plus Ø8.4 boss clearance on the pan axis; corners r1 |
| Pan shaft bore | pan axis (X0 Y0), Z 10.5..24.5 | Ø5.6 |
| Ribbon trough — ALREADY IN THE BLANK, do not re-cut | bezier from the track exit down the trunk, Y centred 0 | 22 × 3 section |
| Rolling-loop track — ALREADY IN THE BLANK, do not re-cut | -76° to 19° from straight back, Y ±11.2 | 8 mm gap outside the ball |

## roots

| Feature | Where | Size / note |
|---|---|---|
| Pan servo body pocket, through | X -17.15..6.15, Y ±6.35, Z 0..top | shaft on the Z axis |
| Pan servo tab recess, from below | X -22.00..11.00, Y ±6.35 | Z 0..1.7 |
| Tab screw pilots ×2 (M2 thread-forming) | X -19.25 and 8.25, Y 0, up from Z 1.7 | Ø1.7 × 6 |
| Deck screw holes ×4 (M3 clearance) | r 30 on the 45° diagonals | Ø3.4 through |
| Slide land (keep as solid) | ring r 15.0..18.0 | top at Z 10.5 = fork underside; rest of roots top at Z 9.5 |
