ZacharyShaver/FPVTank_Prototype/head-v2/generator/tree-parts/features.md

# Tree head parts: feature table

Every pocket, bore and hole in the printable parts, in the shared assembly frame
(mm; X forward, Y along the tilt axis with +Y the servo side, Z up from the deck top).
Import a `_blank.obj`, convert it, then rebuild these as native Fusion features so they stay
editable when the fit coupons change a number. Generated by `generators/tree_parts.py`.

Tilt axis: X 0, Z 48.5. Pan axis: the Z axis.

## roots

| Feature | Where | Size / note |
|---|---|---|
| Pan servo body pocket, through | X -17.15..6.15, Y ±6.35, Z 0..top | shaft on the Z axis |
| Pan servo tab recess, from below | X -22.00..11.00, Y ±6.35 | Z 0..1.7 |
| Tab screw pilots ×2 (M2 thread-forming) | X -19.25 and 8.25, Y 0, up from Z 1.7 | Ø1.7 × 6 |
| Deck screw holes ×4 (M3 clearance) | r 30 on the 45° diagonals | Ø3.4 through |
| Slide land (keep as solid) | ring r 15.0..18.0 | top at Z 10.5 = fork underside; rest of roots top at Z 9.5 |

## fork

| Feature | Where | Size / note |
|---|---|---|
| +Y tilt servo body pocket, open outboard | X ±6.35, Y 27.45..51.5, Z 42.35..65.65 | shaft end DOWN, shaft on the tilt axis |
| +Y tab slot | X ±6.35, Y 33.95..51.5, Z 37.50..70.50 | tabs land on the Y ledge |
| +Y spline boss hole | Ø13.2 on the tilt axis + 13.2 × 6 slot upward, Y 23.0..27.7 |  |
| +Y tab screw pilots ×2 | X 0, Z 40.25 and 67.75, from Y 34.2 inboard | Ø1.7 × 8 |
| +Y servo lead groove | X -9.6..-6.0, Y 46.5..51.5, full pocket height | leads down into the branch channel |
| +Y cap pilots ×4 | (X 14.5, Z 42.5), (X -14.5, Z 42.5), (X 11, Z 61.0), (X -11, Z 61.0), from Y 51.5 | Ø1.7 × 8 |
| -Y axle hole | Ø20.8 on the tilt axis, Y -23.0..-29.0 |  |
| -Y 6704 seat | Ø27.1 × 4.0, Y -25.0..-29.0 | 2 mm inboard lip holds the outer race |
| -Y coil chamber, open outboard | Ø37.6, Y -29.0..-51.5 |  |
| -Y cap pilot | (X 0, Z 72.1) | Ø1.7 × 8 |
| +Y servo lead channel | elliptical 8.3 × 5.2 along the branch centreline, then a curved run out the back of the saddle at Y +13 | servo plug passes; no sharp corner anywhere |
| -Y ribbon trough, enclosed | 17.2 × 2.2 swept down the pod wall and the stem skirt, band centred on Y -39.0 | every turn an in-plane curve, R >= 3.0; opens into the coil chamber at the top and downward at Z 10.5 |
| Pan horn pocket, underside | 34.4 × 6.2 arms along X + Ø8.4 centre, 2.7 deep from Z 10.5 | GENERIC -- measure your horn |
| Pan horn screw access | Ø5.6 on the Z axis, through the saddle |  |

## ball_plus

| Feature | Where | Size / note |
|---|---|---|
| Lens hole | Ø12.4 along X on the tilt axis | through the bezel |
| Light-sensor window | Ø6 along X at Y 2.7, Z 69.0 |  |
| Board post pilots ×2 (this half) | Y +14, Z 34.5 / 62.5, from X 5.6 forward | Ø1.7 × 6; board back face at X 4.0, front at 5.6 |
| Horn pocket | 34.4 × 6.2 arms along Z + Ø8.4 centre, 2.7 deep into the ball flat at Y 24.0 | GENERIC -- measure your horn |
| Horn screw pilots ×2 | X 0, Z 38.5 / 58.5 | Ø1.7 × 6 |
| Seam screw holes ×3 (M2 clearance + head counterbore) | (X -18.0, Z 61.5), (X -18.0, Z 35.5), (X 15.0, Z 29.5) | Ø2.2 through, Ø4.2 × 2.2 from outside |

## ball_minus

| Feature | Where | Size / note |
|---|---|---|
| Lens hole | Ø12.4 along X on the tilt axis |  |
| Board post pilots ×2 (this half) | Y -14, Z 34.5 / 62.5, from X 5.6 forward | Ø1.7 × 6 |
| Axle D-socket | Ø20.1, flat on top at Z axis+8.05, Y -24.0..-17.8 | keys the axle so the coil turns with the ball |
| Ribbon slot | 17.2 × 2.0 (width along X), Y -24.0..-8 |  |
| Seam screw pilots ×3 | (X -18.0, Z 61.5), (X -18.0, Z 35.5), (X 15.0, Z 29.5) | Ø1.7 × 10 from the seam |

## axle

| Feature | Where | Size / note |
|---|---|---|
| Ribbon slot | 17.2 × 2.0 (width along X), Y -46.0..-12.4 (open at the ball end) |  |
| Coil exit slit | 1.2 wide in X, Y -46.0..-30.0, from the slot out through the -Z wall | ribbon folds 90° here and starts the coil |
| D flat | top, at Z axis+7.95, Y -24.1..-17.4 |  |

## cap_servo

| Feature | Where | Size / note |
|---|---|---|
| Screw holes ×4 (M2 clearance) | (X 14.5, Z 42.5), (X -14.5, Z 42.5), (X 11, Z 61.0), (X -11, Z 61.0) | Ø2.2 |

## cap_coil

| Feature | Where | Size / note |
|---|---|---|
| Screw hole (M2 clearance) | (X 0, Z 72.1) | Ø2.2; spigot ring locates it, stub stops the axle walking out |
