ZacharyShaver/FPVTank_Prototype/checks/registry.csv

id | name | class | claim | scope | runner | control | born_from | harness_key | status | status_since | notes
K01 | pairs | invariant | No two parts share solid, turning parts swept over the pan range | pan coil | head-v2/generator/generators/pan_coil_b_check.py::main | --broken: the servo back where Zach saw it, 4 mm in and 2.5 mm up | M01 | pairs | active | 2026-10-13 | The first check (2026-09-19). No unique kill: assembly also kills all 12 of its mutants. Kept as the cheap first look. Backtest 1 (2026-10-24): its 1 mm3 threshold passes slide-fit interference (0.34 mm3 at 0.1 deep); it crashes on any ribbon mutant (at_pan calls P.ribbon itself), which the harness counts as a kill (C18, C19).
K02 | insertion | invariant | The servo reaches its seat through the side window along its real path (-Y) | pan coil | head-v2/generator/generators/pan_coil_b_check.py::insertion | --broken: the shaft's channel out through the window closed (SHAFT_SLOT_R 0), the fault this sweep found 2026-09-28; seated it is clear, so it must read BLOCKED | C02 | insertion | active | 2026-10-13 | No unique kill: its 2 mutants are also killed by other checks. Had no working control until 2026-10-30: its `broken` flag was never used, so --broken couldn't make it fail (found 2026-10-24, building the P23 backtest; C16). Control added 2026-10-30 (code review), and --broken now exits 1 when any controlled check passes.
K03 | assembly | invariant | Each part reaches its seat in assembly order | pan coil | head-v2/generator/generators/pan_coil_b_check.py::assembly | broken: the drum's gear moulded back on, the bay floor glued back on; every row must read BLOCKED | P01;C04 | assembly | active | 2026-10-13 | Unique kill: M14.
K04 | gear_play | invariant | The gear pair has free play, and teeth overlap through a pitch | pan coil | head-v2/generator/generators/pan_coil_b_check.py::gear_play | GEAR_GAP 0 must read 0.0 deg and fail | C04 | gear_play | active | 2026-10-13 | Unique kill: M05.
K05 | bearing_races | invariant | A bearing's turning race touches only turning parts, and its fixed race lands on its ledge | pan coil | head-v2/generator/generators/pan_coil_b_check.py::bearing_races | no relief: the inner race reads 100% | C04;P12 | bearing_races | active | 2026-10-13 | Unique kill: M06. Also runs hub_face (P12), races_688 and races_6704. Race shoulders from the catalogue (source: datasheet). Backtest 1 (2026-10-24): hub_face's control rebuilds set 5 from live code, so an edit to that dead branch fails the check with the design unchanged; freeze it (C17).
K06 | screw_threads | fix guard | The gear screw's thread lies above the step it pulls against (none below, 5 mm above) | drum | head-v2/generator/generators/pan_coil_b_check.py::screw_threads | set 7's drum must read thread in the seat | P14 | screw_threads | active | 2026-10-13 | Unique kill: M09. Runs screw_threads_6704 on the hollow axis. Invariant candidate: thread engagement sits on the load path.
K07 | block_air | fix guard | Air between the servo's block and the turning gear and hub (gear 0.9+, hub 0.5+) | input gear | head-v2/generator/generators/pan_coil_b_check.py::block_air | set 6 as Zach had it, gear 1.0 up, must read the gear into the block | P16 | block_air | active | 2026-10-13 | Unique kill: M10. Born of a real part (spline 1.0 shorter) differing from the model.
K08 | wire_axis | fix guard | The wire bundle's path straight down the pan axis is open (probe r 1.3) | drum | head-v2/generator/generators/pan_coil_b_check.py::wire_axis | set 9, solid barrel, must read blocked | P15 | wire_axis | active | 2026-10-13 | Unique kill: M11.
K09 | merged_shelf | fix guard | The shelf ring is part of the base: floor and cup solid, the old exit hole closed | base | head-v2/generator/generators/pan_coil_b_check.py::merged_shelf | set 10's base must read the floor missing and the hole open | P23 | merged_shelf | active | 2026-10-13 | Unique kill: M13.
K10 | screw_alignment | invariant | Every screw's way is open where it threads in | pan coil | head-v2/generator/generators/pan_coil_b_check.py::screw_alignment | the probes moved 0.6 off axis must read material | C11;M20 | screw_alignment | active | 2026-10-13 | Unique kill: M20, the one S1 survivor.
K11 | snap pins | fix guard | Rev 2 snap pins seat with their designed preload, and the 1.0 mm socket walls hold no air | ball | head-v2/checks/check_snap.py | the same rows on Zach's originals |  |  | legacy | 2026-10-24
K12 | pin free play | fix guard | How far a clicked pin slides inside one socket | ball | head-v2/checks/freeplay.py | the first pins (0.75 mm) |  |  | legacy | 2026-10-24
K13 | ball vs nest | invariant | Both ball halves clear the nest through the whole tilt range | ball | head-v2/checks/ball_nest.py | Zach's originals |  |  | legacy | 2026-10-24
K14 | lens clearance | invariant | The lens clears the nest through the whole tilt range | ball | head-v2/checks/lens_clear.py | none |  |  | legacy | 2026-10-24 | The regression table lists no control for it.
K15 | tilt-axis reach | invariant | The stack along the tilt axis clears at every ball position | post;ball | head-v2/checks/reach_check.py | Zach's post against v3 |  |  | legacy | 2026-10-24
K16 | camera posts | fix guard | The camera snap posts slide in, seat and clear the camera, and nothing else changes | ball | head-v2/checks/check_campost.py | rev 2's parts; a post with barbs |  |  | legacy | 2026-10-24
K17 | camera posts rev 2 | fix guard | The camera posts against Zach's Fusion rev 2 with the real board | ball | head-v2/checks/check_campost_rev2.py | his tubes on the rev-1 axes |  |  | legacy | 2026-10-24
K18 | rev 2 vs nest | invariant | Zach's rev 2 halves and the real lens clear the nest through the tilt range | ball | head-v2/checks/rev2_nest.py | see the script |  |  | legacy | 2026-10-24
K19 | mesh report | export | Print meshes carry no self-intersections, non-manifold edges or stray bodies | all exports | head-v2/checks/mesh_report.py | Zach's own exports, which carry those faults |  |  | legacy | 2026-10-24
K20 | real servo fit | invariant | Zach's MG90S model seats in the pan servo pocket and slides in through the window | pan coil | head-v2/checks/pan_servo_fit.py | see the script | P03 |  | legacy | 2026-10-24
K21 | plug passage | invariant | The tilt servo's plug passes from the bowl into the pan coil's chamber | cradle;pan coil | head-v2/checks/plug_passage.py | see the script | P02;C05 |  | legacy | 2026-10-24
K22 | +Y sleeve fit | fix guard | The ball goes into the +Y sleeve, and the sleeve and the 6704 reach their seats | ball | head-v2/checks/plus_sleeve_fit.py | see the script |  |  | legacy | 2026-10-24
K23 | snap surface | fix guard | Nothing stands proud of the ball and the old screw holes are shut | ball | head-v2/checks/snap_surface.py | Zach's revision |  |  | legacy | 2026-10-24
K24 | wire route round 1 | fix guard | The tilt servo's wires get through, with wall round the hole, and the stub fits | ball;cradle | head-v2/checks/wire_route.py | see the script |  |  | legacy | 2026-10-24
K25 | bench stand clearance | fix guard | The turning screw heads clear the stand's ledge (1.0 wanted) | bench stand | head-v2/fixes/bench_stand.py | no hollow and no trim (redefined after C10) | C10;P25 |  | legacy | 2026-10-24
K26 | clamp-ring lip contact | fix guard | The clamp ring's lip meets its seat on the flat band | nose section | chassis-v2/nose.py::clamp_checks | see the function | C09 |  | legacy | 2026-10-24
K27 | chassis-v2 body checks | invariant | Per-module body checks (concept, hull, rugged, trainer, tail arms, guard arm, flippers) | chassis-v2;nose section | chassis-v2/hull.py::checks | varies by module | P26 |  | legacy | 2026-10-24 | P26 (deck ledges floating 4.2 mm) passed every body check; the slicer caught it. No mutant yet.
K28 | floor penetration | physics | Bodies don't sink into the floor on impact (stiff contact: 0.2 to 1.7 mm) | tumble model | research/tumble/audit/audit_sim.py | see AUDIT.md | C13;L12 |  | legacy | 2026-10-24 | C13: first measured only at rest; now tested on impact.
K29 | time-step convergence | physics | The drop predictions are settled at the 0.5 ms step (rerun at 0.1 ms) | tumble model | research/tumble/audit/hard_floor_convergence.py | see AUDIT.md | C14;L13 |  | legacy | 2026-10-24
K30 | start attitude | physics | Each simulated drop starts with the intended face down | tumble model | research/tumble/scale_model.py::start_check | the old heading code fails 5 of 6 | C12;L06 |  | legacy | 2026-10-24
K31 | drop predictions vs real drops | physics | Committed predictions beat the naive guess and land near the best possible Brier score | tumble model | research/tumble/score_drops.py | the naive predictor; coins moving the centre of mass | C12;L02;L11;L17 |  | legacy | 2026-10-24
K32 | surrogate accuracy and coverage | surrogate | Held-out RMS error and 90% intervals that hold about 90% of the time | surrogate | research/tumble/surrogate.py::evaluate | the training mean and a straight-line fit | C15;L15 |  | watch | 2026-10-24 | C15: holds on average (86.8%), but 1 of 6 at the best designs. Must also be scored where decisions are made.
K33 | surrogate gating | surrogate | Decides P(upright) >= threshold only when the 90% interval clears it | surrogate | research/tumble/surrogate.py::gate | none |  |  | watch | 2026-10-24 | Few real positives: 10 of 280 held-out designs above 0.6 (1 wrongly rejected, 3 accepted), 1 above 0.7. Checked 2026-10-24.
K34 | surrogate sentinels | surrogate | A few sentinel simulations catch a physics change the surrogate can't see | surrogate | research/tumble/surrogate.py::surrogate_mutants | a hidden friction change |  |  | watch | 2026-10-24 | Its registered control failed (paper, H2): the sentinels could not see the friction change, which moved answers by at most 4 points.
K35 | surrogate at the best designs | surrogate | The intervals hold at the best designs against 1000-drop reruns | surrogate | research/tumble/audit/surrogate_peak_check.py | see AUDIT.md | C15;L15 |  | legacy | 2026-10-24
K36 | shell mass | physics | The sweep's shell mass scales with its area | tumble model | research/tumble/audit/shell_mass_check.py | the fixed 600 g shell | L07 |  | legacy | 2026-10-24
K37 | orca plate check | export | Every part sent to Orca lands on the plate that gets sliced | all exports | tools/orca.py | the original six-part drop stand slice fails, naming the four parts left off | L16 |  | legacy | 2026-10-24
K38 | spring stack fit | fix guard | The spring stack (ESC + PCA on two loose pegs, TPU clips, the test hoop) goes together: pegs clear, clips squeeze 0.75, the stop holds before the pegs lift out | brain box: spring stack | twin/spring_stack.py::check | in its output: a box 5 mm off its holes, the top 3.5 lower, a clip 1 mm across, clips moved by the squeeze, a 2.5 travel, a stack 4 mm taller | L18 |  | legacy | 2026-11-11 | Registered 2026-11-11. Its bench: L19 (the PLA parts held) and L20 (the clips held; a kick slides the stack along the hoop, which nothing here reads: K43).
K39 | print noise screen | screen | The share of printed copies of a peg joint that go together, with each peg and hole off by a random error | brain box joints | twin/print_noise.py | control: one pack peg 0.4 out of place reads as a squeeze | L18 |  | legacy | 2026-11-11 | Registered 2026-11-11. Predicted 94 % (ESC box) and 88 % (PCA box) at 0.10 of error; the bench put 3 of 3 boxes together (L19). The error size and the hand-press limit are still guesses.
K40 | part boxes fit | invariant | Each holder box sits on its floor holes, its part fits it, and the boxes stack | brain box: part boxes | twin/part_boxes.py::check | in its output: each box 5 mm off its holes, a case 1 mm longer, a stack 5 mm off | L18 |  | legacy | 2026-11-11 | Registered 2026-11-11. The ESC and PCA boxes are superseded by K38s; the pack, Pi and ESP32 boxes still carry friction pegs.
K41 | peg test fit | fix guard | The peg test piece and ESC frame v2 seat on the floor patch | brain box: floor patch | twin/peg_test.py::check | an ESC 0.4 longer reads as the press; v2 5 mm off its holes | L18 |  | legacy | 2026-11-11 | Registered 2026-11-11. Its bench (2026-11-08): a 5.0 peg wants a 5.1 hole.
K42 | pi box rebuild | fix guard | The rebuilt Pi box matches his printed toolpaths, its notch clears the header, and the bored rings clear the screw heads | brain box: Pi box | twin/pi_box.py | the untouched download; the Pi turned 180 degrees |  |  | legacy | 2026-11-11 | Registered 2026-11-11. Its ring test printed 2026-11-08: "perfect fit".
K43 | sideways stop | invariant | Under a crash, something other than peg and clip friction stops each stack sliding sideways (a wall, a neighbour, an end stop) | brain box | none yet | none yet | L20 |  | proposed | 2026-11-11 | Proposed 2026-11-11 from L20. Partly a test-rig artefact: the hoop has no end stops and the robot's floor and walls do. Needs the layout's walls before it can run.
