ZacharyShaver/FPVTank_Prototype/chassis-v1/parts/SOURCE.md

# chassis-v1 parts: source

The STLs here are byte-identical copies of FPV-Rover V2.0 (Tank) by Markus_p, CC BY-NC-SA 4.0. Their source and
licence are in `reference/fpv-rover-v2/SOURCE.md`.

`third-party/luengoa-flex-track/` holds the flexible TPU tracks for FPV-Rover V2.0 by Luengoa on Thingiverse,
CC BY-NC; see its `LICENSE.txt` and `README.txt`.
