ZacharyShaver/FPVTank_Prototype/reference/fpv-rover-v2/camera-mount-main-v11.stl

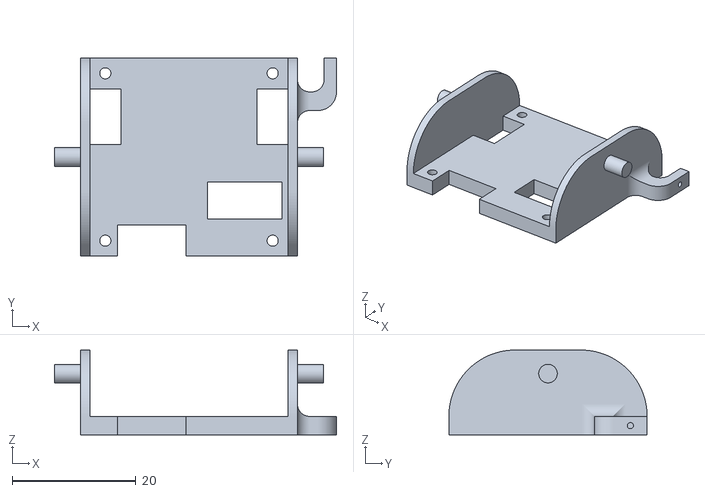
[picture p41: CAD file, 2024-10-14]
reference/fpv-rover-v2/camera-mount-main-v11.stl
45.5 x 32.0 x 13.7
