ZacharyShaver/FPVTank_Prototype/head-v2/fusion/rev1-2026-09-24/BODY_NUMBA1 (1) (1).stl

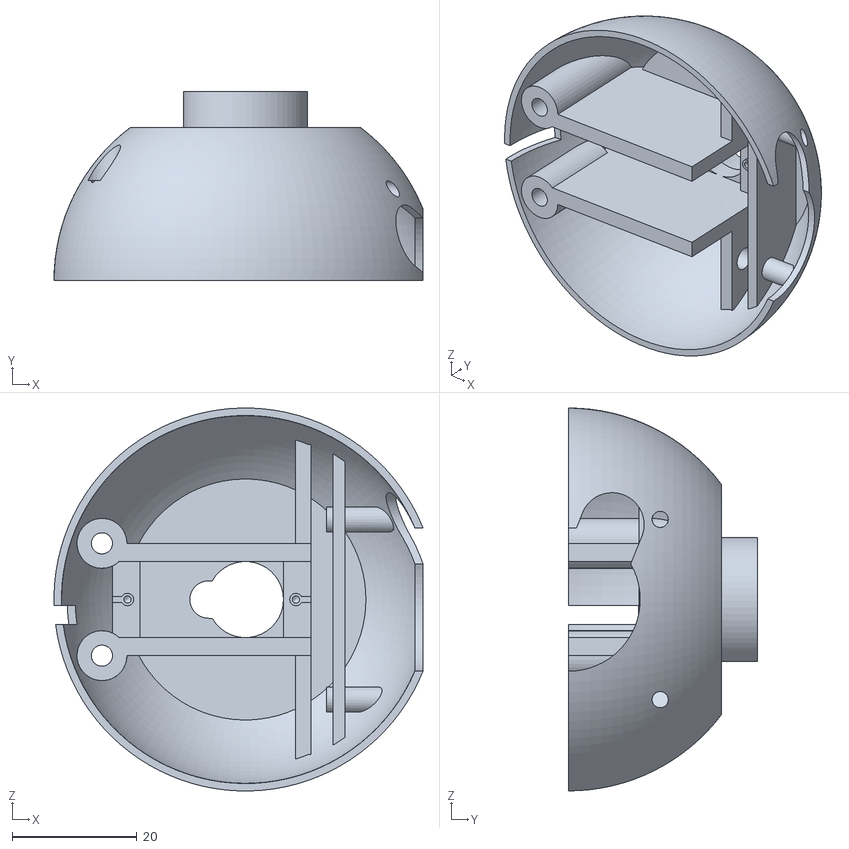
[picture p42: CAD file, 2026-09-26]
head-v2/fusion/rev1-2026-09-24/BODY_NUMBA1 (1) (1).stl
59.2 x 30.3 x 61.4
