ZacharyShaver/FPVTank_Prototype/head-v2/fusion/rev2-2026-09-27/ball_plus_revised_9_27.stl

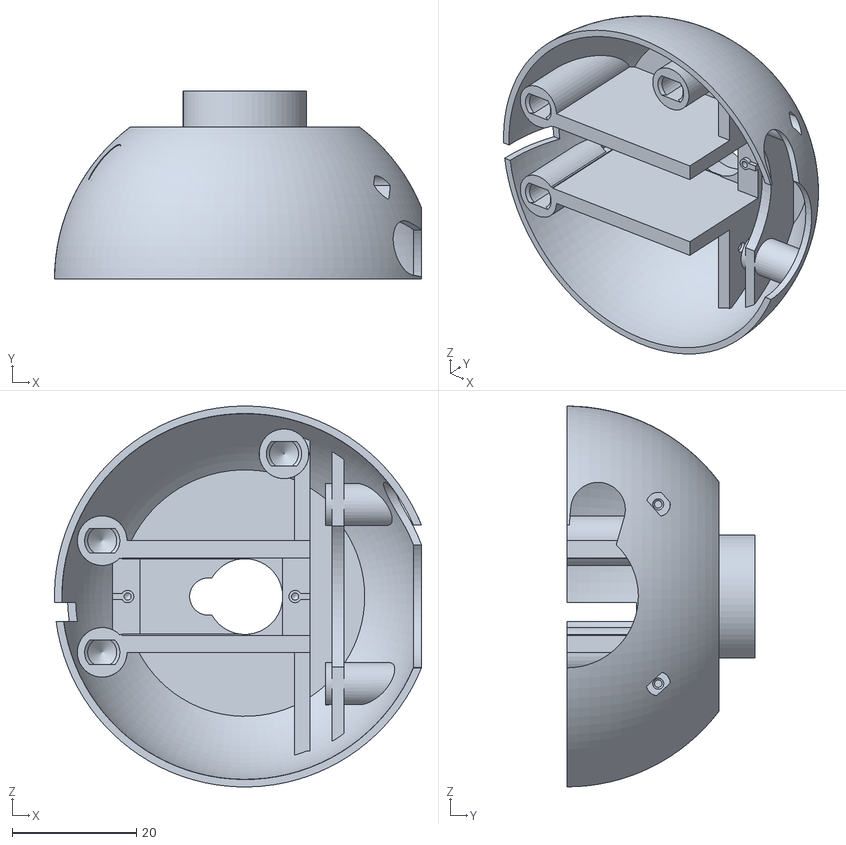
[picture p43: CAD file, 2026-10-02]
head-v2/fusion/rev2-2026-09-27/ball_plus_revised_9_27.stl
59.2 x 30.3 x 61.4
