ZacharyShaver/FPVTank_Prototype/head-v2/generator/camera/camera_dummy_centred.step

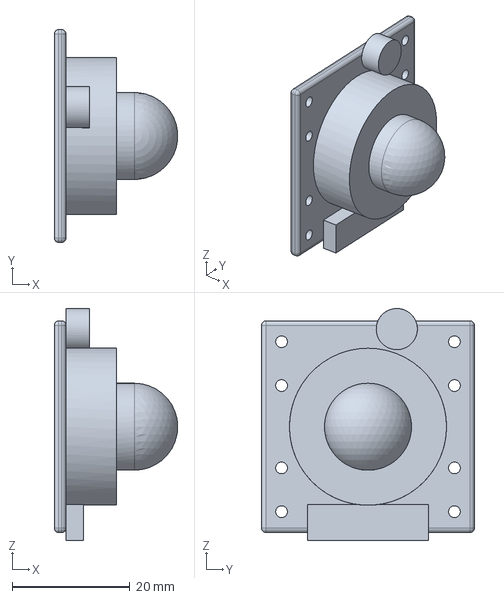
[picture p44: CAD file, 2026-10-02]
head-v2/generator/camera/camera_dummy_centred.step
21.0 x 36.2 x 39.4 mm
