ZacharyShaver/FPVTank_Prototype/head-v2/generator/coil-test/coil_test_lid.stl

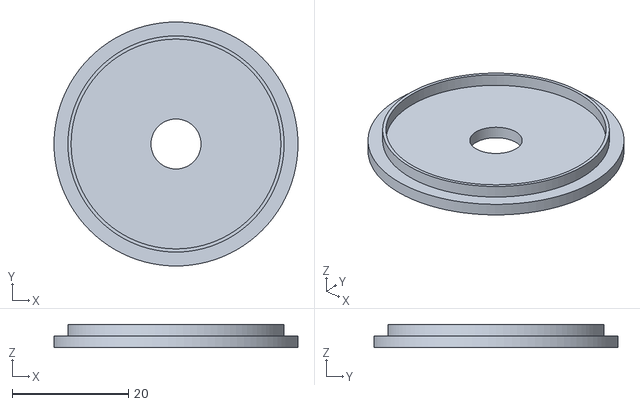
[picture p45: CAD file, 2026-09-27]
head-v2/generator/coil-test/coil_test_lid.stl
42.0 x 42.0 x 4.00
