ZacharyShaver/FPVTank_Prototype/head-v2/generator/concept/ball_concept_fixed.stl

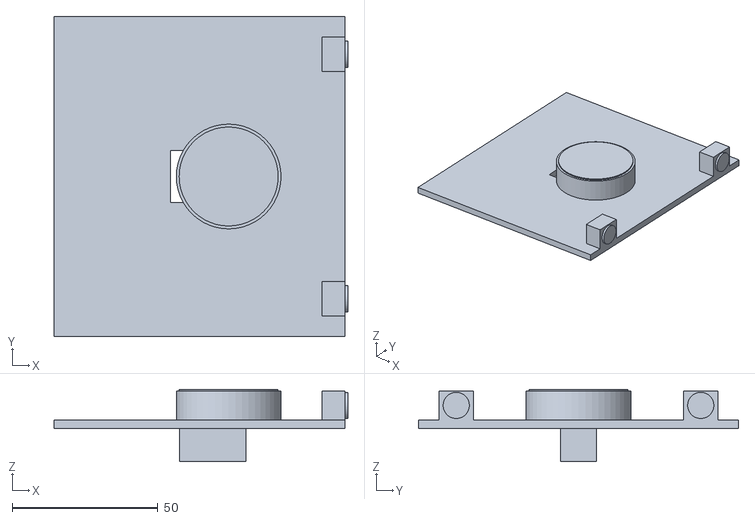
[picture p46: CAD file, 2026-09-27]
head-v2/generator/concept/ball_concept_fixed.stl
101.0 x 110.0 x 24.8
