ZacharyShaver/FPVTank_Prototype/head-v2/generator/pan-coil-b/fusion/bearing688.obj

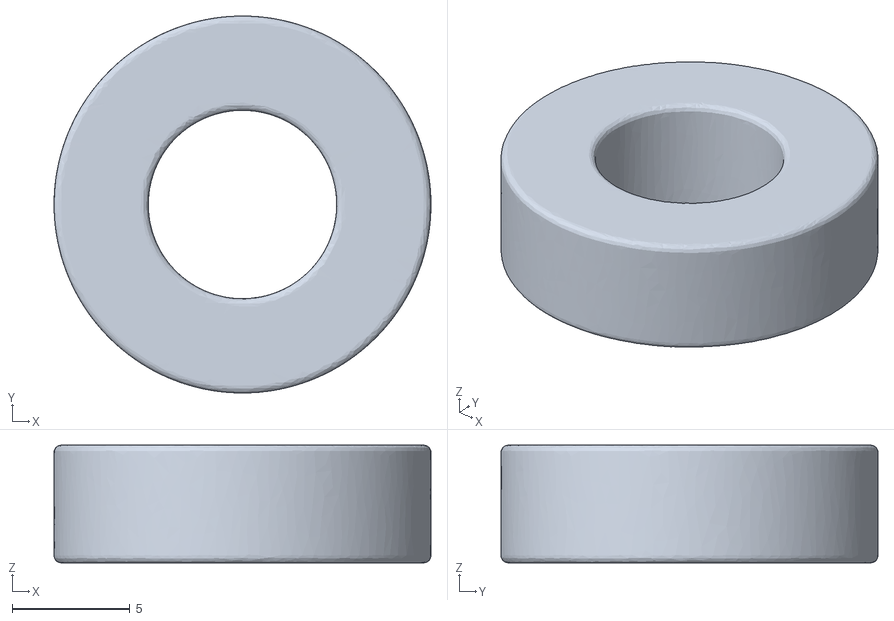
[picture p47: CAD file, 2026-10-13]
head-v2/generator/pan-coil-b/fusion/bearing688.obj
16.0 x 16.0 x 5.00
