ZacharyShaver/FPVTank_Prototype/head-v2/generator/pan-coil/fusion/drum.obj

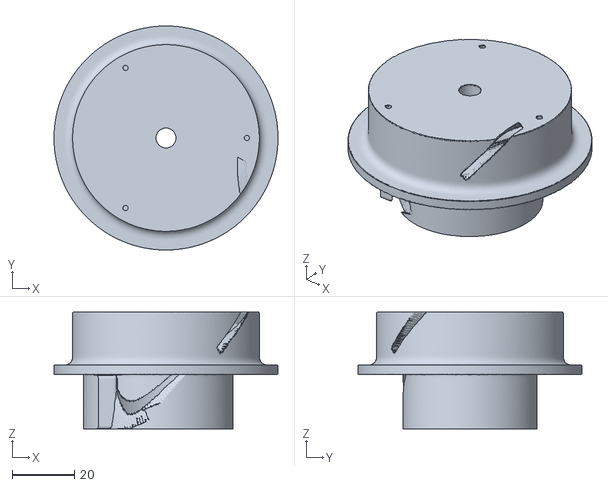
[picture p48: CAD file, 2026-09-27]
head-v2/generator/pan-coil/fusion/drum.obj
72.0 x 72.0 x 37.5
