ZacharyShaver/FPVTank_Prototype/head-v2/generator/tree-arm-test/tree_arm_test_hub.stl

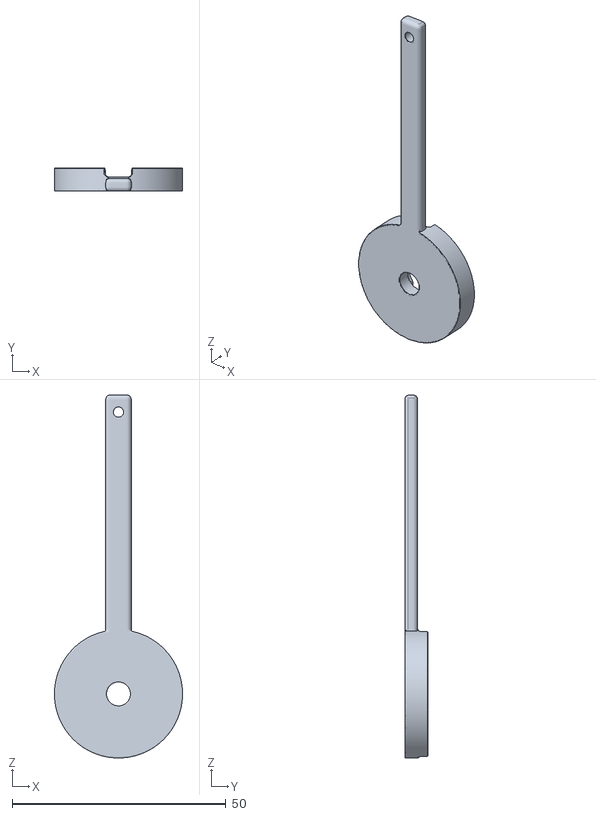
[picture p49: CAD file, 2026-09-27]
head-v2/generator/tree-arm-test/tree_arm_test_hub.stl
30.0 x 5.50 x 85.0
