ZacharyShaver/FPVTank_Prototype/head-v2/generator/tree-hood/fusion/crank.obj

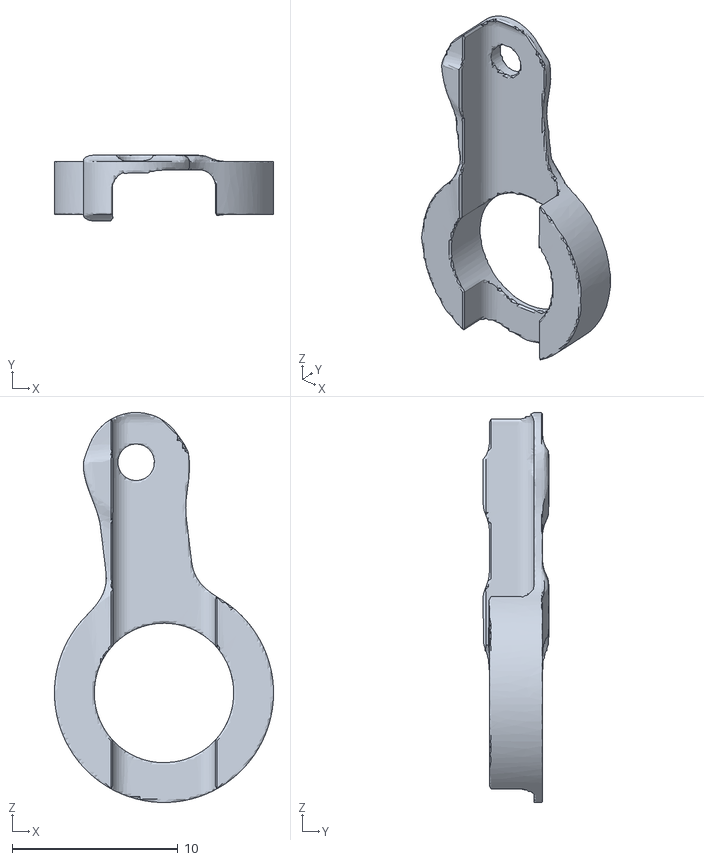
[picture p50: CAD file, 2026-09-27]
head-v2/generator/tree-hood/fusion/crank.obj
13.2 x 3.95 x 23.5
