ZacharyShaver/FPVTank_Prototype/head-v2/generator/tree-parts-b/fusion-convert/ball_minus.obj

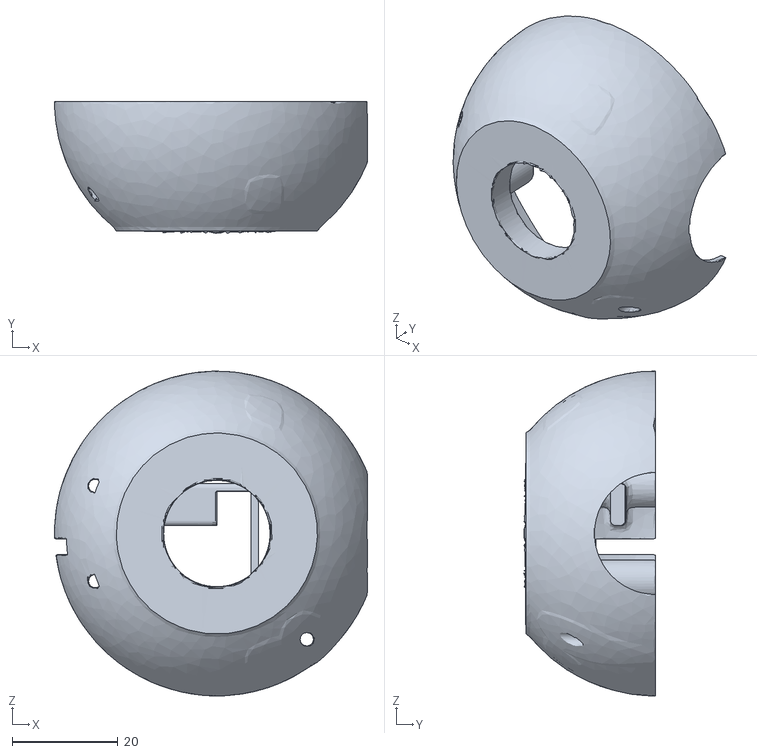
[picture p51: CAD file, 2026-09-27]
head-v2/generator/tree-parts-b/fusion-convert/ball_minus.obj
59.2 x 24.9 x 61.4
