ZacharyShaver/FPVTank_Prototype/head-v2/generator/tree-parts-b/fusion-solid/fork_blank.obj

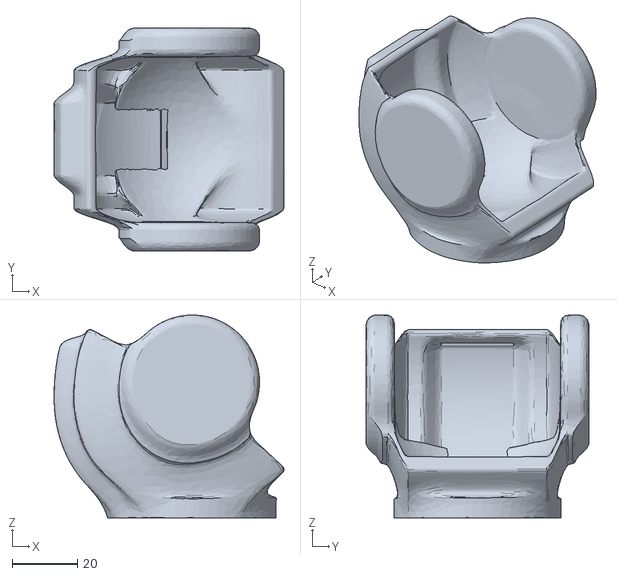
[picture p52: CAD file, 2026-09-27]
head-v2/generator/tree-parts-b/fusion-solid/fork_blank.obj
70.3 x 68.0 x 62.0
