ZacharyShaver/FPVTank_Prototype/head-v2/generator/tree-parts-b/fusion/fork.obj

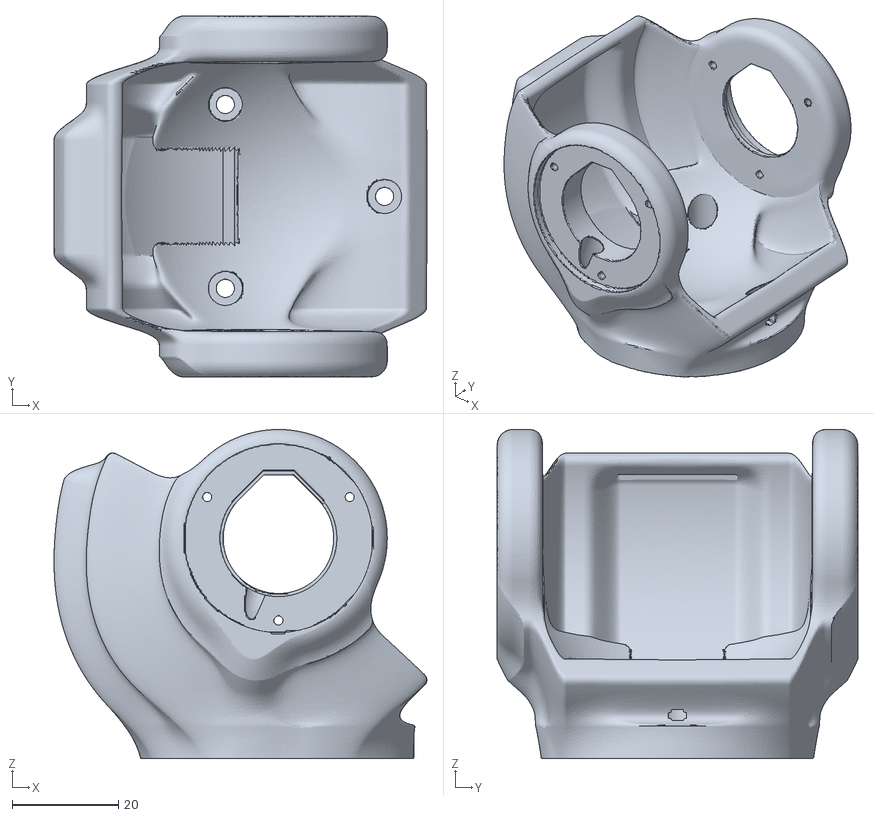
[picture p53: CAD file, 2026-10-13]
head-v2/generator/tree-parts-b/fusion/fork.obj
70.3 x 68.0 x 62.0
