ZacharyShaver/FPVTank_Prototype/head-v2/generator/tree-parts-b/step/post.step

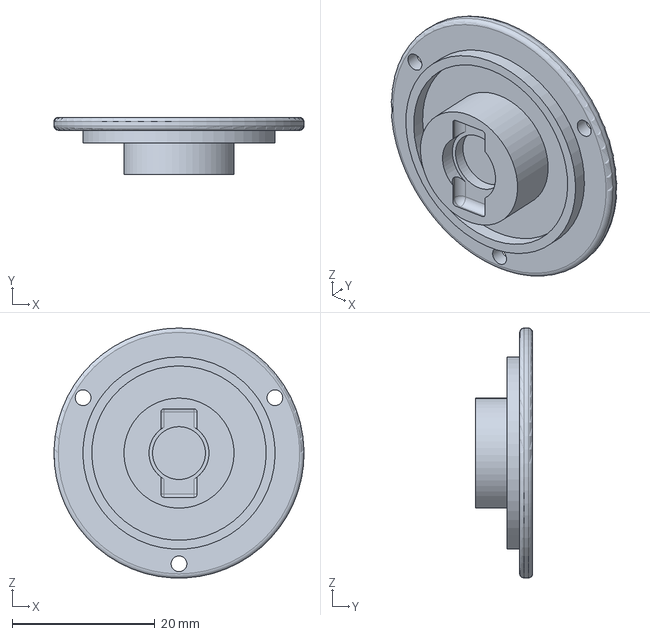
[picture p54: CAD file, 2026-09-27]
head-v2/generator/tree-parts-b/step/post.step
35.0 x 8.00 x 35.0 mm
