ZacharyShaver/FPVTank_Prototype/head-v2/generator/tree-parts-b/test-parts/bearing_dummy.stl

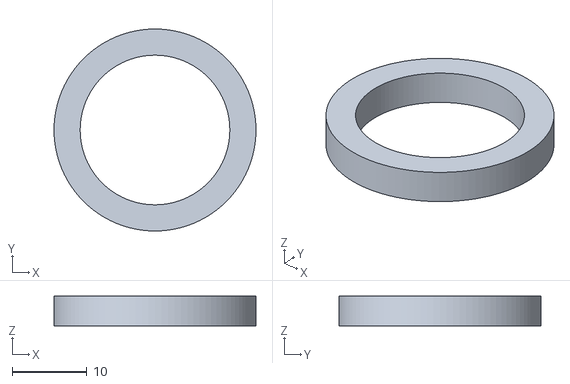
[picture p55: CAD file, 2026-09-27]
head-v2/generator/tree-parts-b/test-parts/bearing_dummy.stl
27.0 x 27.0 x 4.00
