ZacharyShaver/FPVTank_Prototype/head-v2/generator/tree-parts/fusion/cap_coil.obj

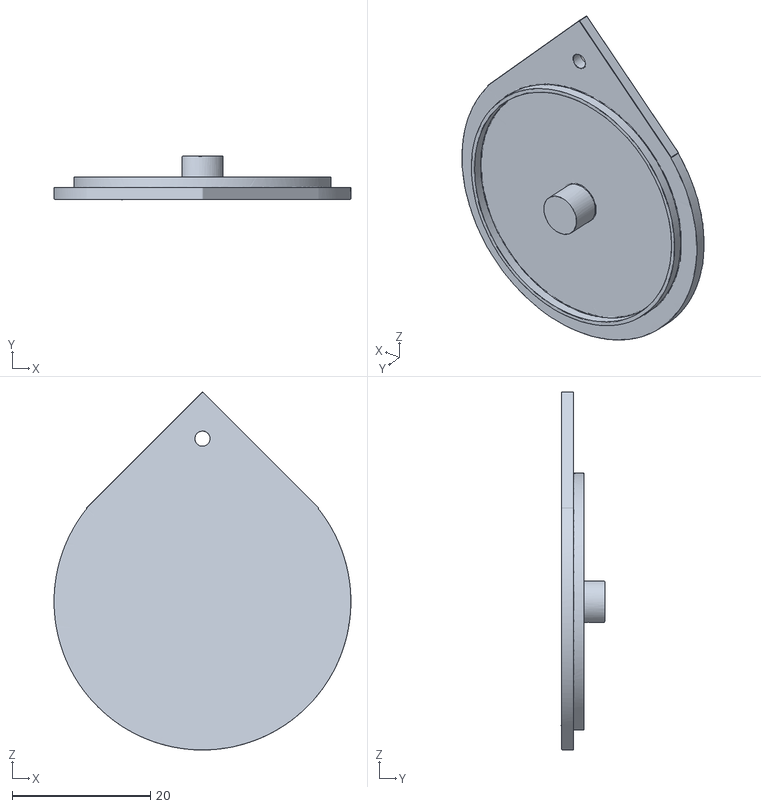
[picture p56: CAD file, 2026-09-27]
head-v2/generator/tree-parts/fusion/cap_coil.obj
43.0 x 6.31 x 51.9
