ZacharyShaver/FPVTank_Prototype/reference/raspberry-pi-5/raspberry_pi_5.stl

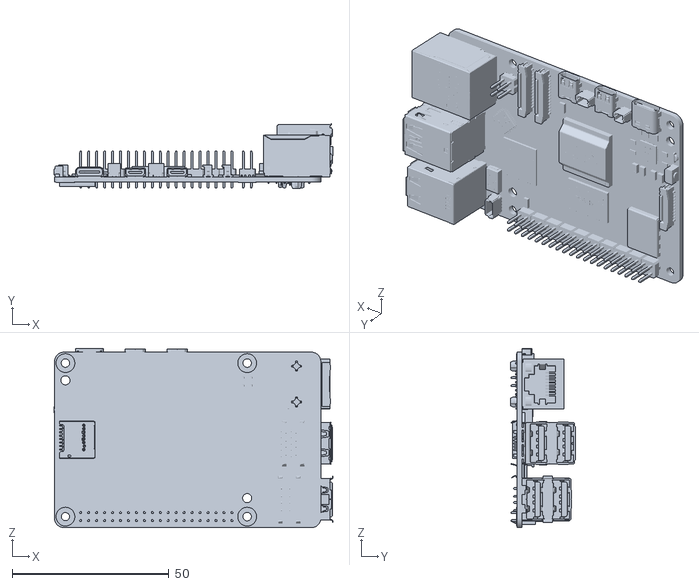
[picture p57: CAD file, 2026-09-26]
reference/raspberry-pi-5/raspberry_pi_5.stl
89.0 x 20.8 x 57.2
