ZacharyShaver/FPVTank_Prototype/research/models/E4_weeble.stl

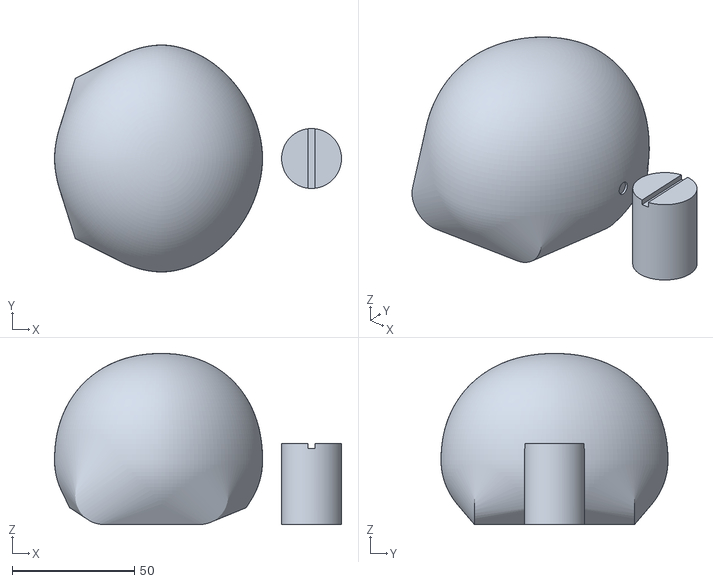
[picture p58: CAD file, 2026-10-25]
research/models/E4_weeble.stl
117.2 x 92.7 x 69.9
