ZacharyShaver/FPVTank_Prototype/head-v2/fusion/rev1-2026-09-24/ball_servo_post_revised.stl

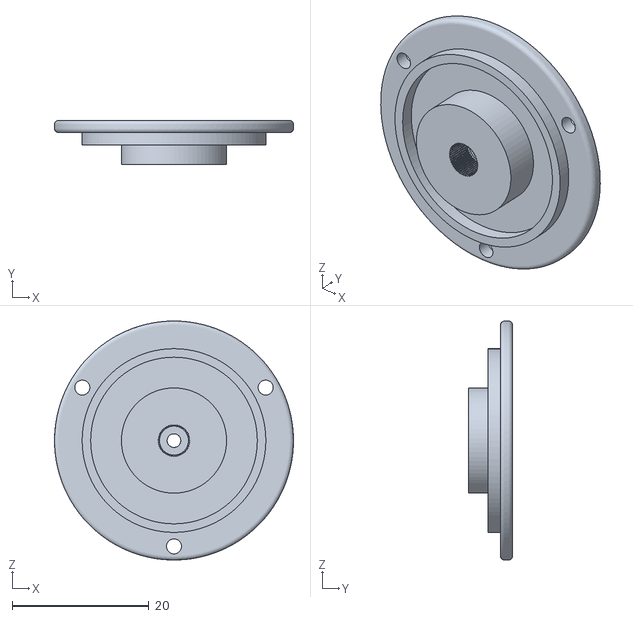
[picture p59: CAD file, 2026-09-26]
head-v2/fusion/rev1-2026-09-24/ball_servo_post_revised.stl
35.0 x 6.50 x 35.0
