ZacharyShaver/FPVTank_Prototype/head-v2/fusion/rev2-2026-09-27/ball_minus_revised_27.stl

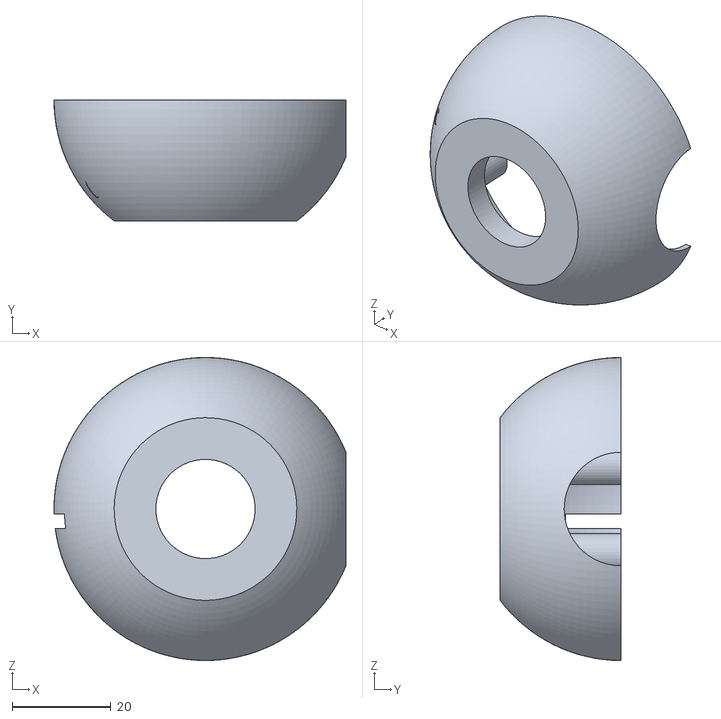
[picture p60: CAD file, 2026-10-02]
head-v2/fusion/rev2-2026-09-27/ball_minus_revised_27.stl
59.2 x 24.5 x 61.4
