ZacharyShaver/FPVTank_Prototype/head-v2/generator/camera/camera_dummy.step

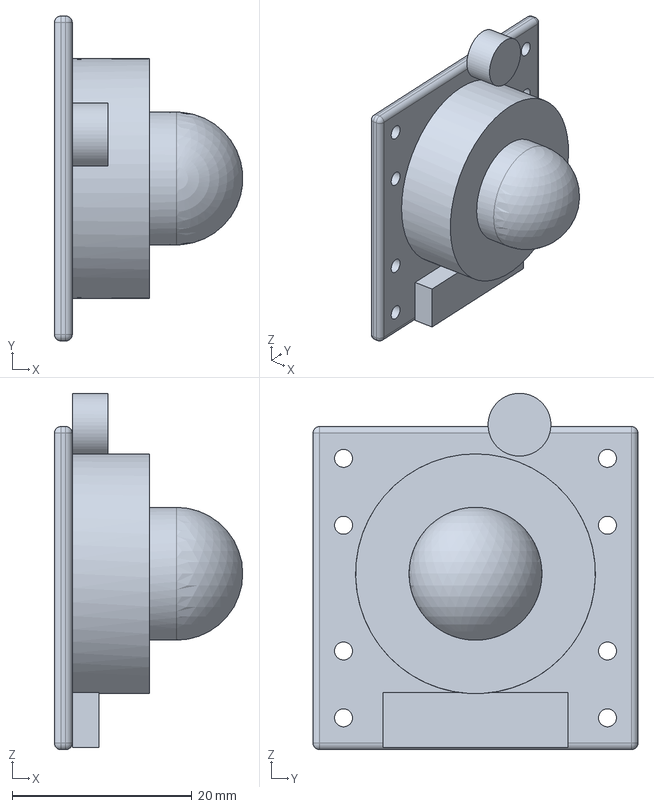
[picture p61: CAD file, 2026-10-02]
head-v2/generator/camera/camera_dummy.step
21.0 x 36.2 x 39.7 mm
