ZacharyShaver/FPVTank_Prototype/head-v2/generator/coil-test/coil_test_knob.stl

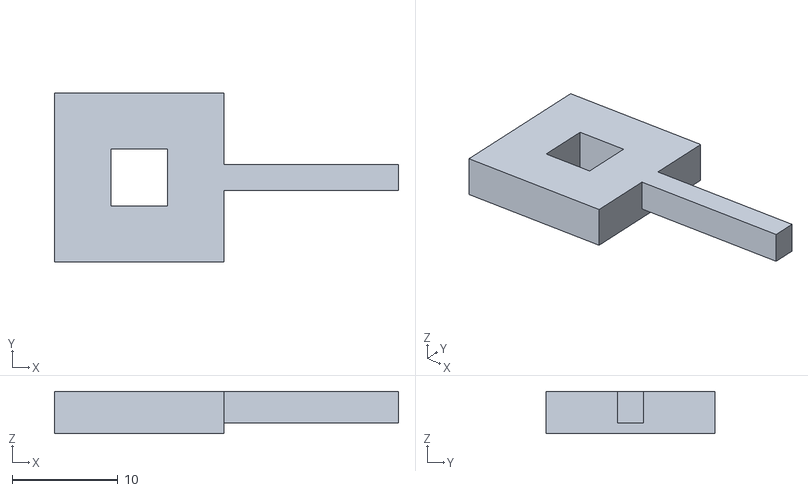
[picture p62: CAD file, 2026-09-27]
head-v2/generator/coil-test/coil_test_knob.stl
32.5 x 16.0 x 4.00
