ZacharyShaver/FPVTank_Prototype/head-v2/generator/concept/ball_concept_pan.stl

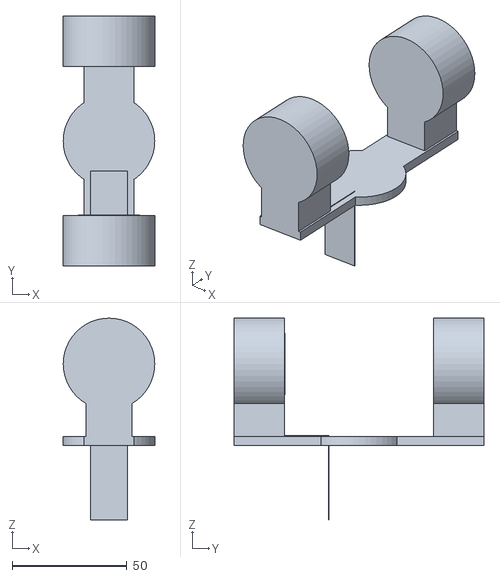
[picture p63: CAD file, 2026-09-27]
head-v2/generator/concept/ball_concept_pan.stl
40.0 x 109.2 x 88.1
