ZacharyShaver/FPVTank_Prototype/head-v2/generator/pan-coil-b/fusion/gear_out.obj

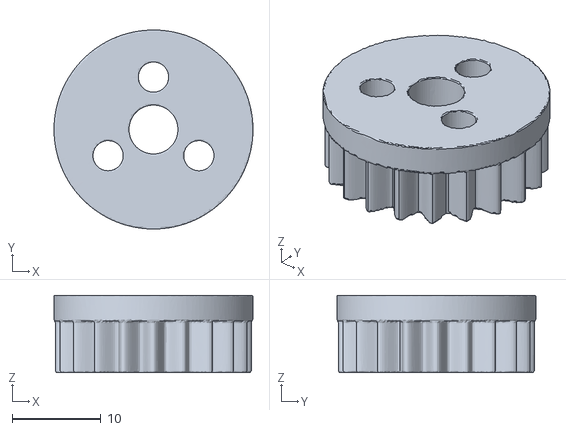
[picture p64: CAD file, 2026-10-13]
head-v2/generator/pan-coil-b/fusion/gear_out.obj
22.4 x 22.4 x 8.70
