ZacharyShaver/FPVTank_Prototype/head-v2/generator/pan-coil/fusion/island.obj

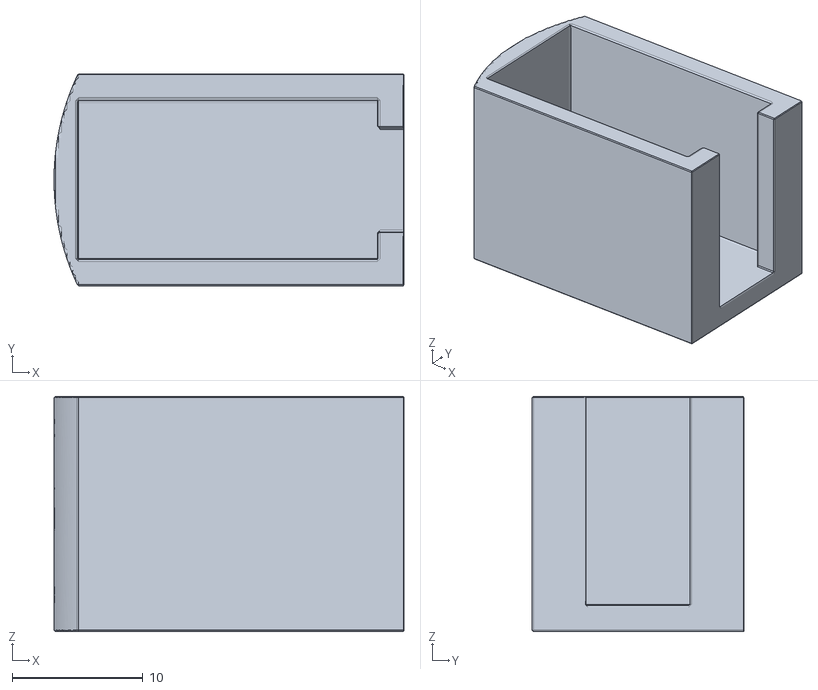
[picture p65: CAD file, 2026-09-27]
head-v2/generator/pan-coil/fusion/island.obj
26.8 x 16.2 x 18.0
