ZacharyShaver/FPVTank_Prototype/head-v2/generator/test-print-2/y_tilt_face.stl

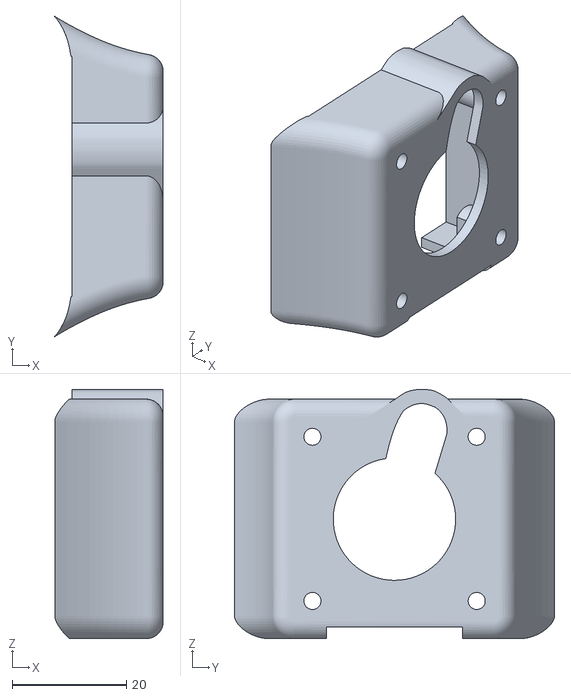
[picture p66: CAD file, 2026-09-27]
head-v2/generator/test-print-2/y_tilt_face.stl
19.0 x 56.1 x 43.7
