ZacharyShaver/FPVTank_Prototype/head-v2/generator/tree-arm-test/tree_arm_servo_side.stl

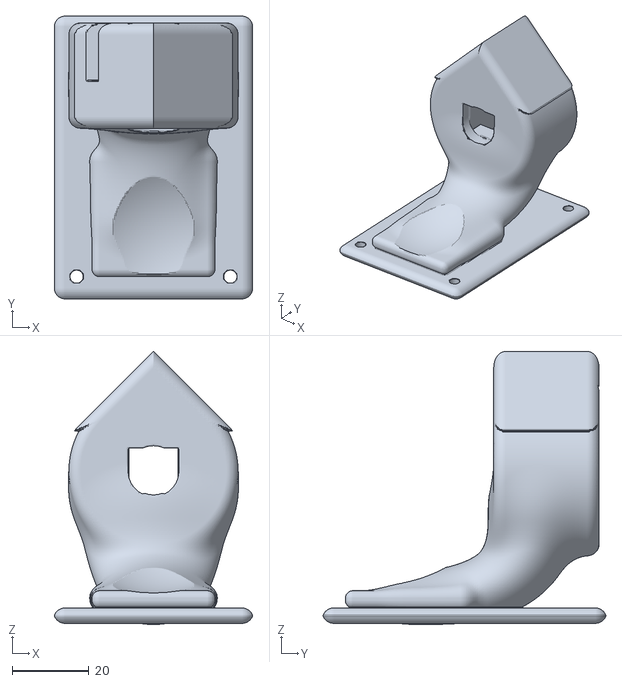
[picture p67: CAD file, 2026-09-27]
head-v2/generator/tree-arm-test/tree_arm_servo_side.stl
51.5 x 73.5 x 71.0
