ZacharyShaver/FPVTank_Prototype/head-v2/generator/tree-hood/fusion/spine.obj

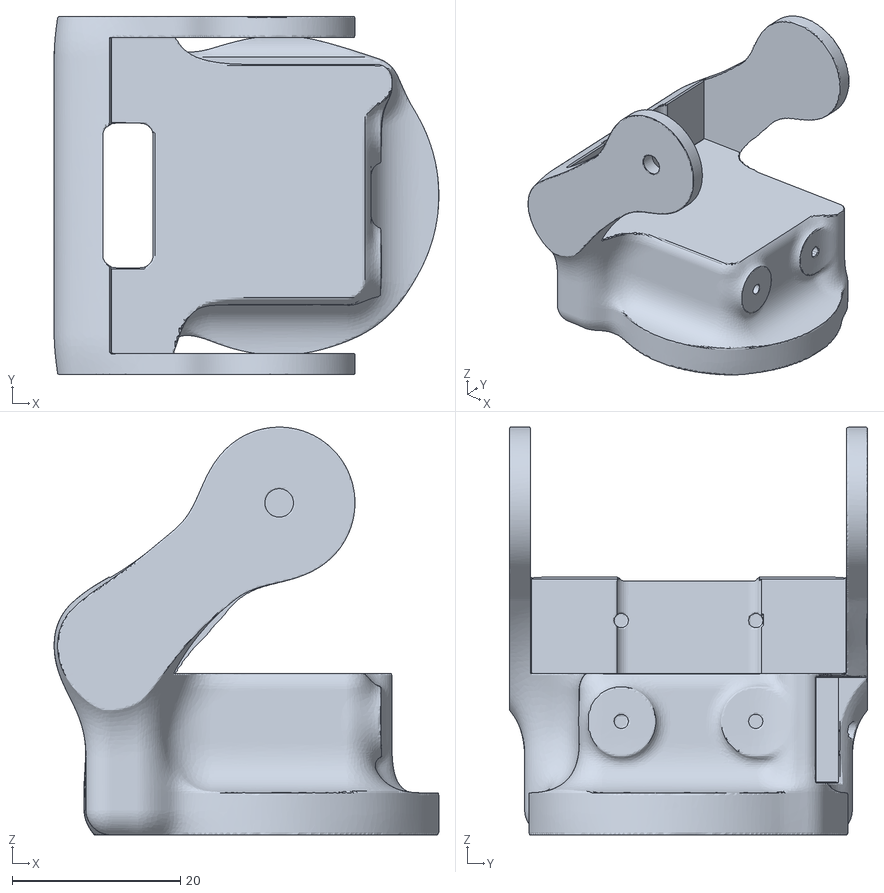
[picture p68: CAD file, 2026-09-27]
head-v2/generator/tree-hood/fusion/spine.obj
45.8 x 42.6 x 48.5
