ZacharyShaver/FPVTank_Prototype/head-v2/generator/tree-parts-b/fusion-solid/roots_blank.obj

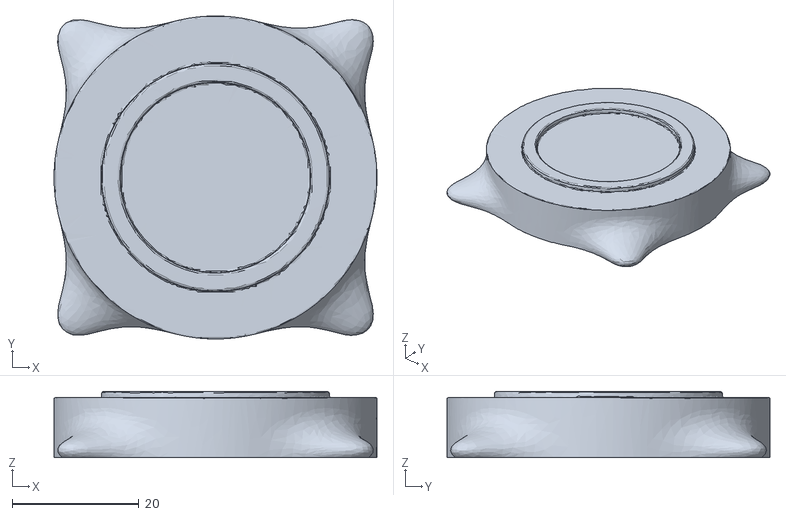
[picture p69: CAD file, 2026-09-27]
head-v2/generator/tree-parts-b/fusion-solid/roots_blank.obj
51.0 x 51.0 x 10.5
