ZacharyShaver/FPVTank_Prototype/head-v2/generator/tree-parts-b/fusion/stub.obj

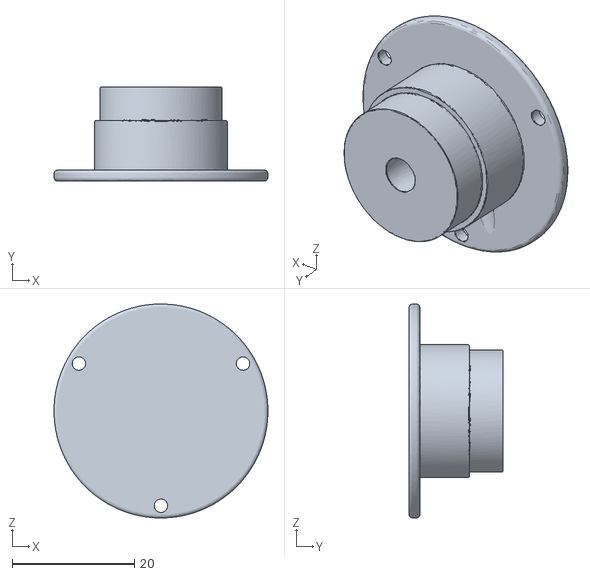
[picture p70: CAD file, 2026-10-13]
head-v2/generator/tree-parts-b/fusion/stub.obj
35.0 x 15.4 x 35.0
