ZacharyShaver/FPVTank_Prototype/head-v2/generator/tree-parts-b/step/ball_plus.step

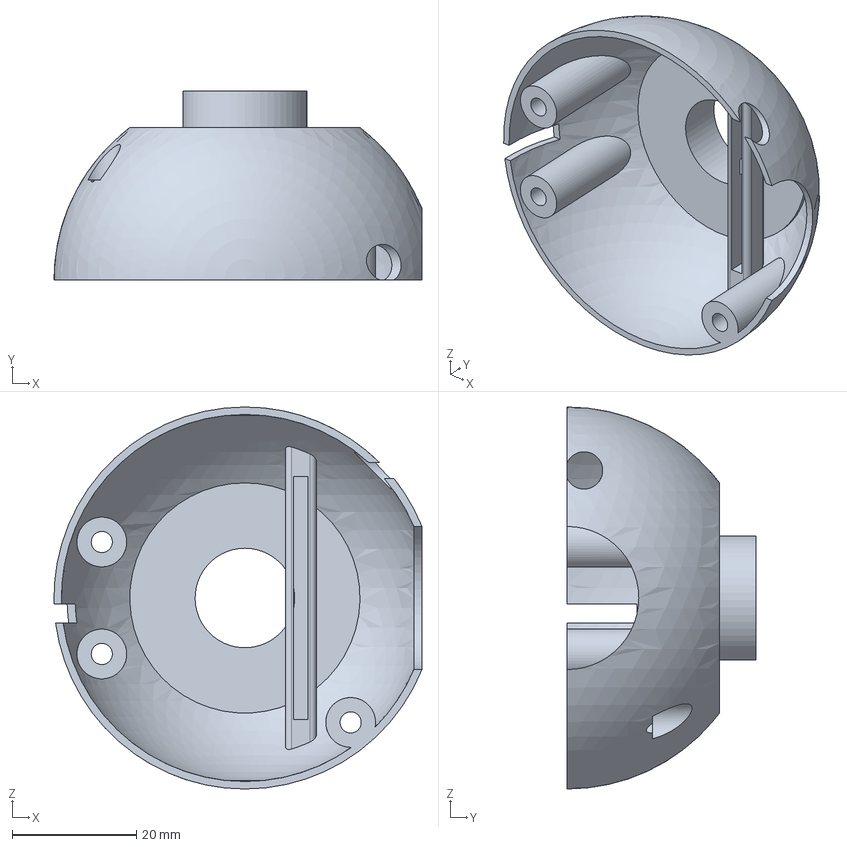
[picture p71: CAD file, 2026-09-27]
head-v2/generator/tree-parts-b/step/ball_plus.step
59.1 x 30.3 x 61.4 mm
