ZacharyShaver/FPVTank_Prototype/head-v2/generator/tree-parts/fusion/axle.obj

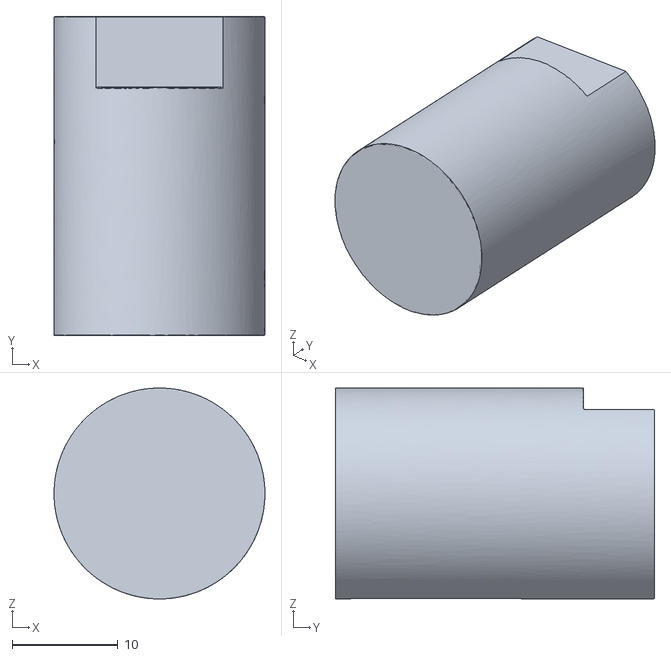
[picture p72: CAD file, 2026-09-27]
head-v2/generator/tree-parts/fusion/axle.obj
19.9 x 30.1 x 19.9
