ZacharyShaver/FPVTank_Prototype/reference/fpv-rover-v2/inner-frame-right-v15.stl

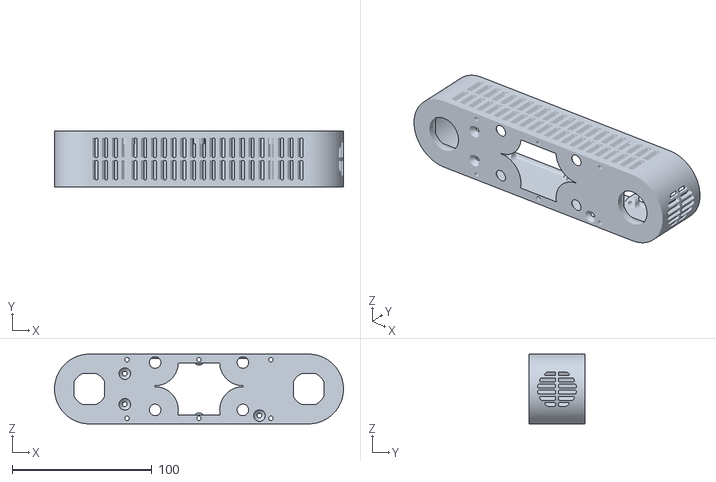
[picture p73: CAD file, 2024-10-14]
reference/fpv-rover-v2/inner-frame-right-v15.stl
207.1 x 40.0 x 50.0
