ZacharyShaver/FPVTank_Prototype/reference/raspberry-pi-5/raspberry_pi_5_with_active_cooler.stl

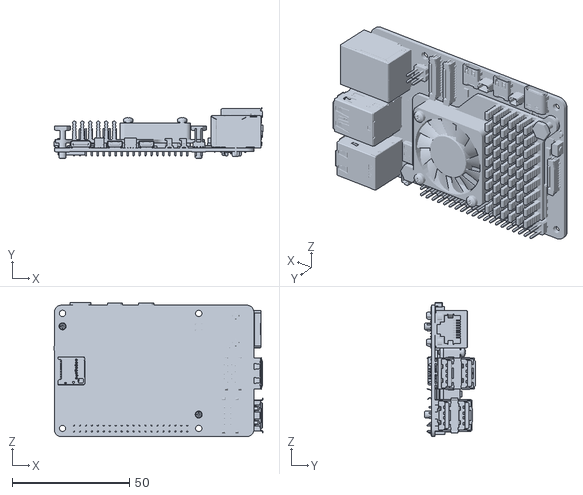
[picture p74: CAD file, 2026-09-26]
reference/raspberry-pi-5/raspberry_pi_5_with_active_cooler.stl
89.0 x 21.6 x 57.2
