ZacharyShaver/FPVTank_Prototype/research/models/drop_stand_base.stl

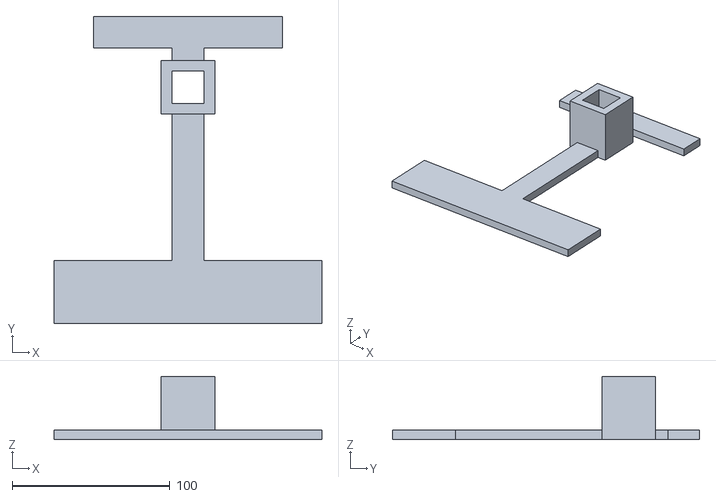
[picture p75: CAD file, 2026-10-17]
research/models/drop_stand_base.stl
170.0 x 195.0 x 40.0
