ZacharyShaver/FPVTank_Prototype/head-v2/generator/coil-test/coil_test_cup.stl

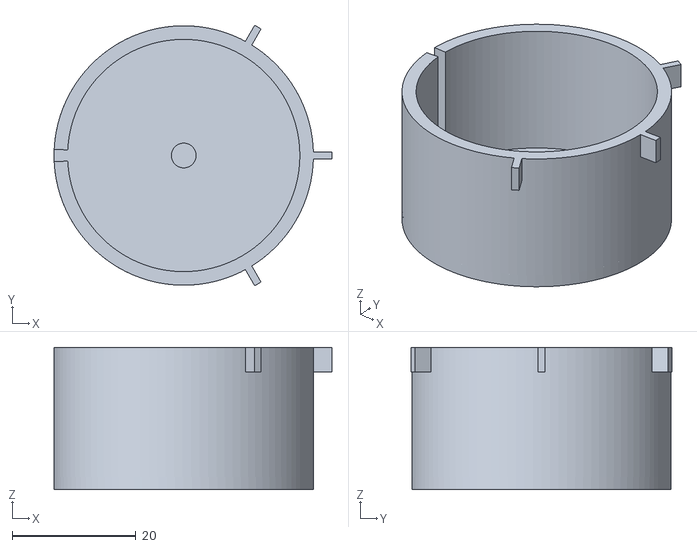
[picture p76: CAD file, 2026-09-27]
head-v2/generator/coil-test/coil_test_cup.stl
45.0 x 42.2 x 23.0
