ZacharyShaver/FPVTank_Prototype/head-v2/generator/concept/ball_concept_tilt.stl

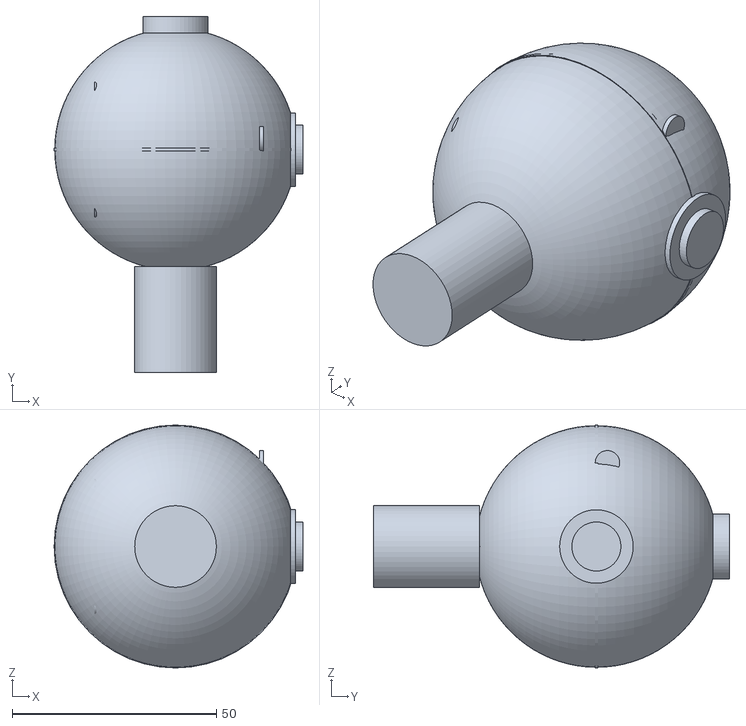
[picture p77: CAD file, 2026-09-27]
head-v2/generator/concept/ball_concept_tilt.stl
60.9 x 87.2 x 59.5
