ZacharyShaver/FPVTank_Prototype/head-v2/generator/pan-coil-b/fusion/drum.obj

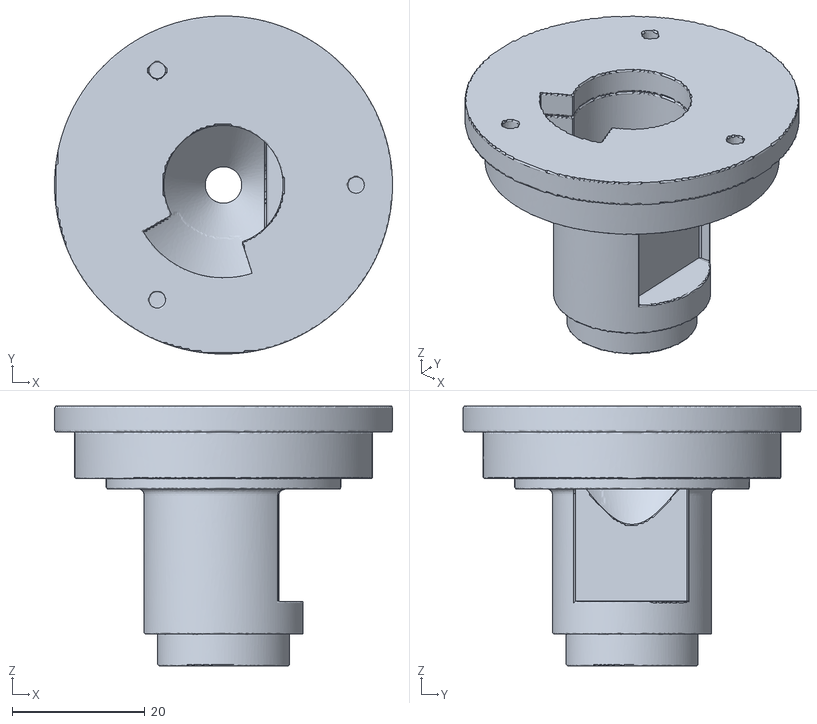
[picture p78: CAD file, 2026-10-13]
head-v2/generator/pan-coil-b/fusion/drum.obj
51.0 x 51.0 x 39.2
