ZacharyShaver/FPVTank_Prototype/head-v2/generator/pan-coil/fusion/well_cut.obj

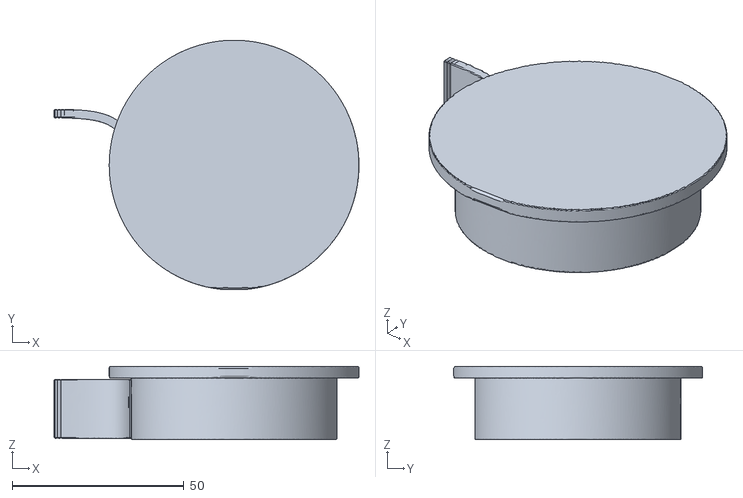
[picture p79: CAD file, 2026-09-27]
head-v2/generator/pan-coil/fusion/well_cut.obj
88.9 x 72.7 x 21.4
