ZacharyShaver/FPVTank_Prototype/head-v2/generator/test-print-2/z_mount_bottom.stl

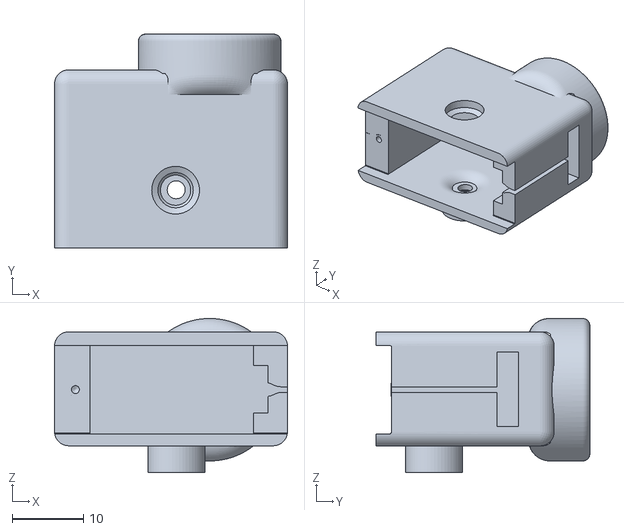
[picture p80: CAD file, 2026-09-27]
head-v2/generator/test-print-2/z_mount_bottom.stl
32.7 x 30.0 x 21.6
