ZacharyShaver/FPVTank_Prototype/head-v2/generator/tree-hood/fusion/yoke.obj

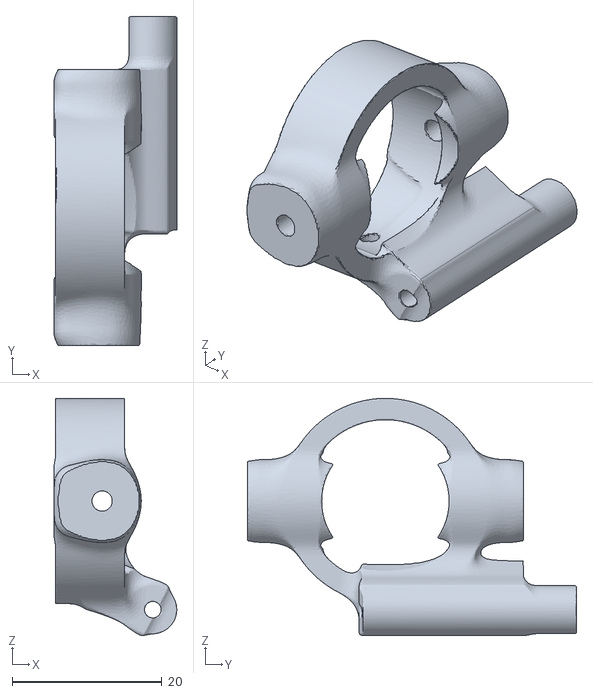
[picture p81: CAD file, 2026-09-27]
head-v2/generator/tree-hood/fusion/yoke.obj
16.4 x 43.9 x 31.7
