ZacharyShaver/FPVTank_Prototype/head-v2/generator/tree-parts-b/step/Body1.3mf

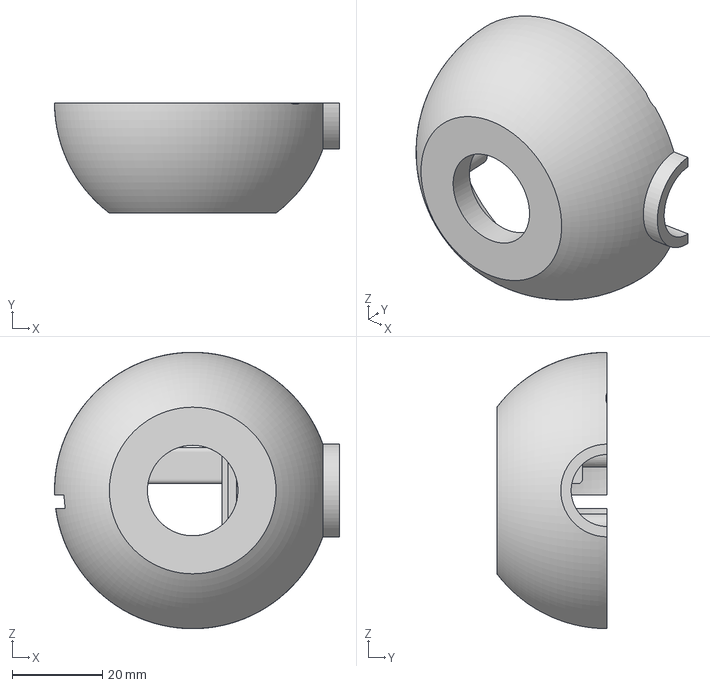
[picture p82: CAD file, 2026-09-27]
head-v2/generator/tree-parts-b/step/Body1.3mf
63.3 x 24.5 x 61.4 mm
