ZacharyShaver/FPVTank_Prototype/head-v2/generator/tree-parts/fusion/cap_servo_blank.obj

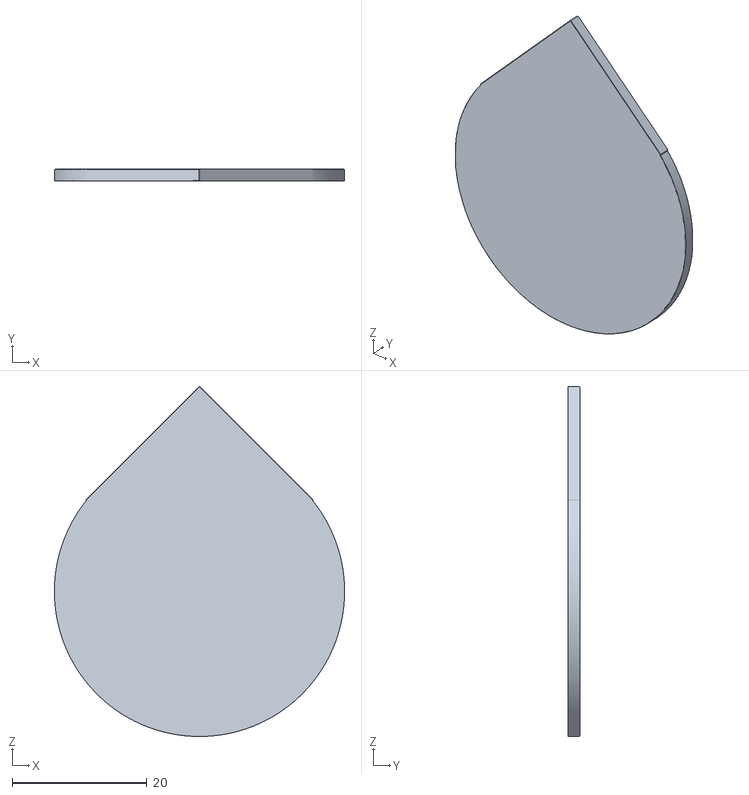
[picture p83: CAD file, 2026-09-27]
head-v2/generator/tree-parts/fusion/cap_servo_blank.obj
43.0 x 1.81 x 51.9
