ZacharyShaver/FPVTank_Prototype/reference/fpv-rover-v2/esc-mount-right-v12.stl

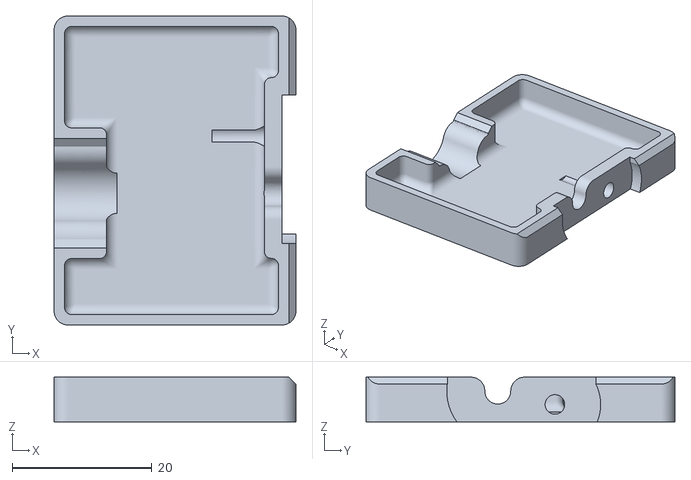
[picture p84: CAD file, 2024-10-14]
reference/fpv-rover-v2/esc-mount-right-v12.stl
34.6 x 44.2 x 6.40
