ZacharyShaver/FPVTank_Prototype/research/models/drop_stand_arm.stl

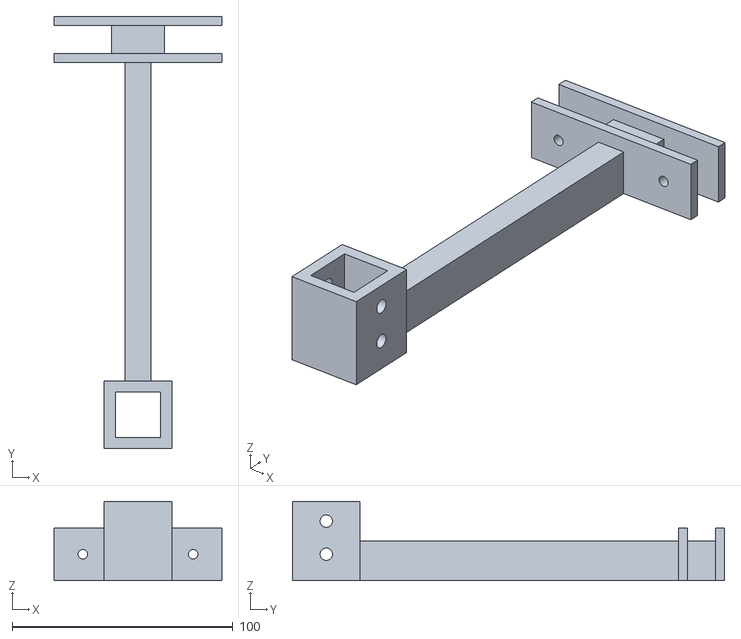
[picture p85: CAD file, 2026-10-17]
research/models/drop_stand_arm.stl
76.0 x 195.7 x 36.0
