ZacharyShaver/FPVTank_Prototype/head-v2/generator/coil-test/coil_test_spool.stl

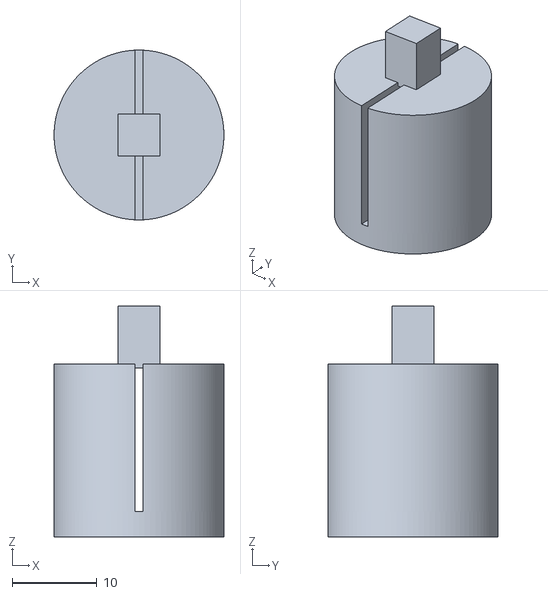
[picture p86: CAD file, 2026-09-27]
head-v2/generator/coil-test/coil_test_spool.stl
20.0 x 20.0 x 27.2
