ZacharyShaver/FPVTank_Prototype/head-v2/generator/pan-coil-b/fusion/floor.obj

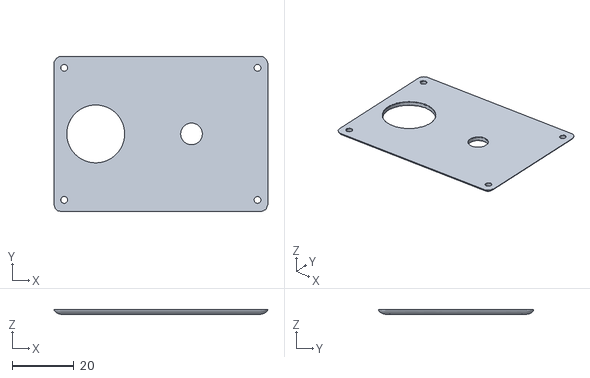
[picture p87: CAD file, 2026-10-13]
head-v2/generator/pan-coil-b/fusion/floor.obj
69.3 x 50.3 x 1.50
