ZacharyShaver/FPVTank_Prototype/head-v2/generator/tree-hood/fusion/hood.obj

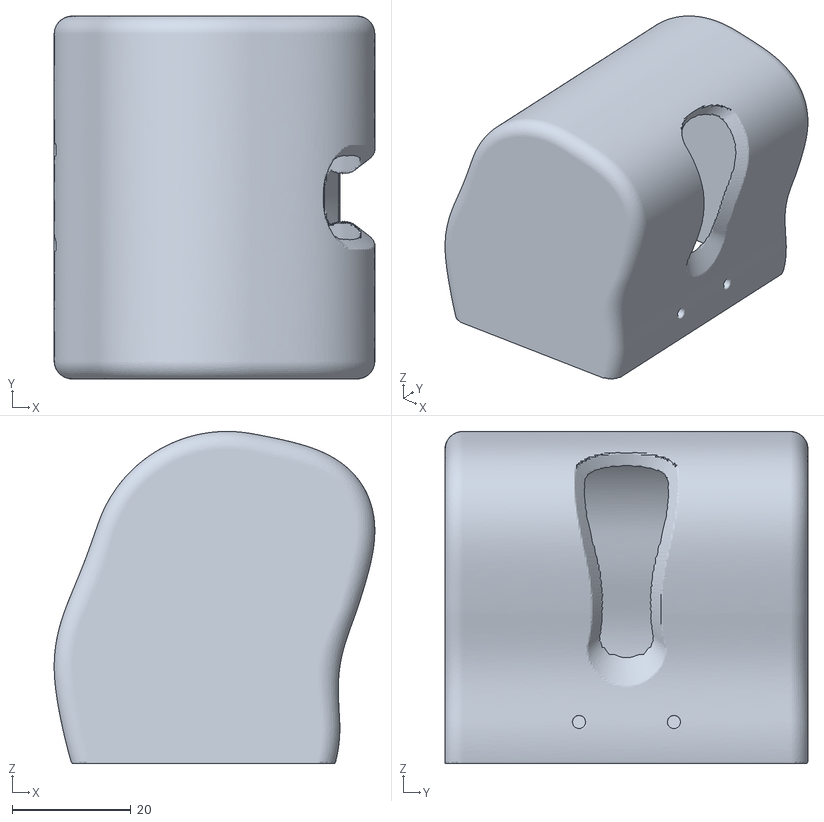
[picture p88: CAD file, 2026-09-27]
head-v2/generator/tree-hood/fusion/hood.obj
54.1 x 61.2 x 56.0
