ZacharyShaver/FPVTank_Prototype/head-v2/generator/tree-parts-b/fusion-convert/axle.obj

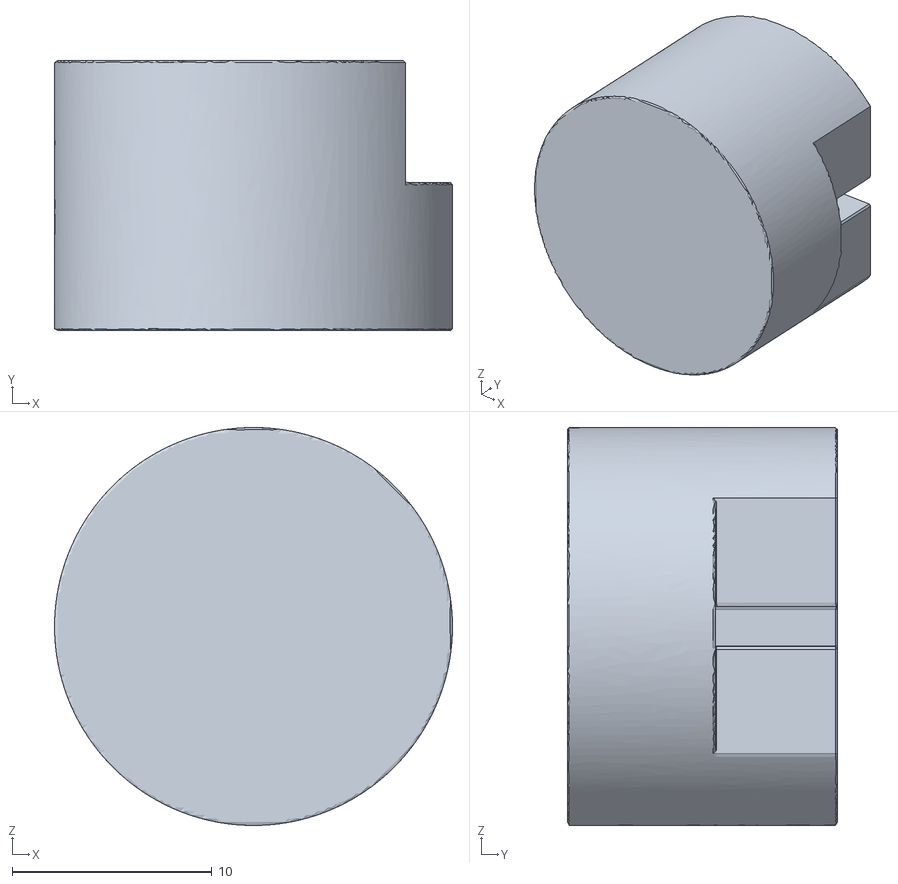
[picture p89: CAD file, 2026-09-27]
head-v2/generator/tree-parts-b/fusion-convert/axle.obj
19.9 x 13.5 x 19.9
