ZacharyShaver/FPVTank_Prototype/head-v2/generator/tree-parts/fusion/roots.obj

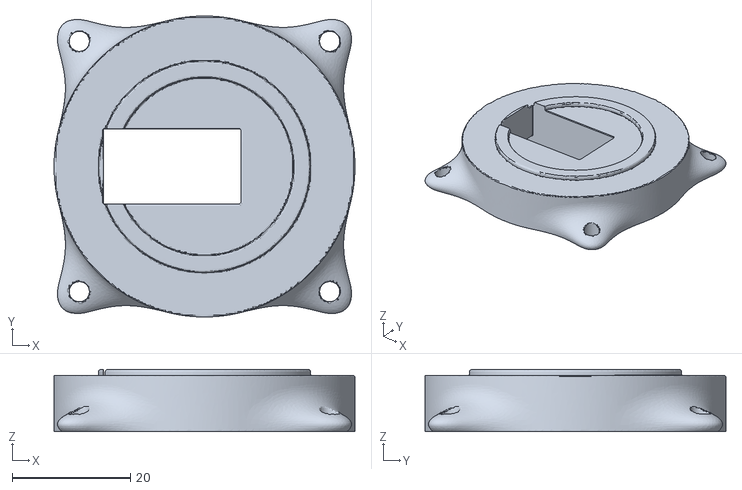
[picture p90: CAD file, 2026-09-27]
head-v2/generator/tree-parts/fusion/roots.obj
51.0 x 51.0 x 10.5
