ZacharyShaver/FPVTank_Prototype/reference/fpv-rover-v2/camera-mount-left-v11.stl

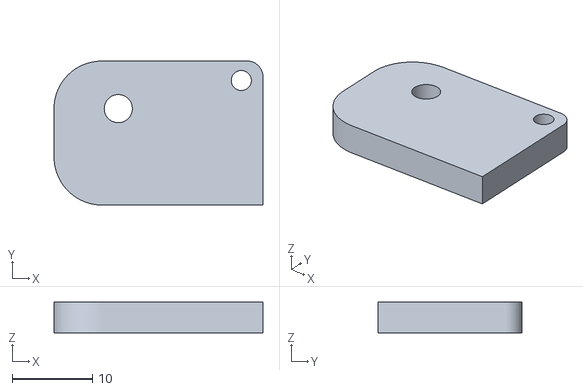
[picture p91: CAD file, 2024-10-14]
reference/fpv-rover-v2/camera-mount-left-v11.stl
26.0 x 17.9 x 3.80
