ZacharyShaver/FPVTank_Prototype/research/models/drop_stand_gauge.stl

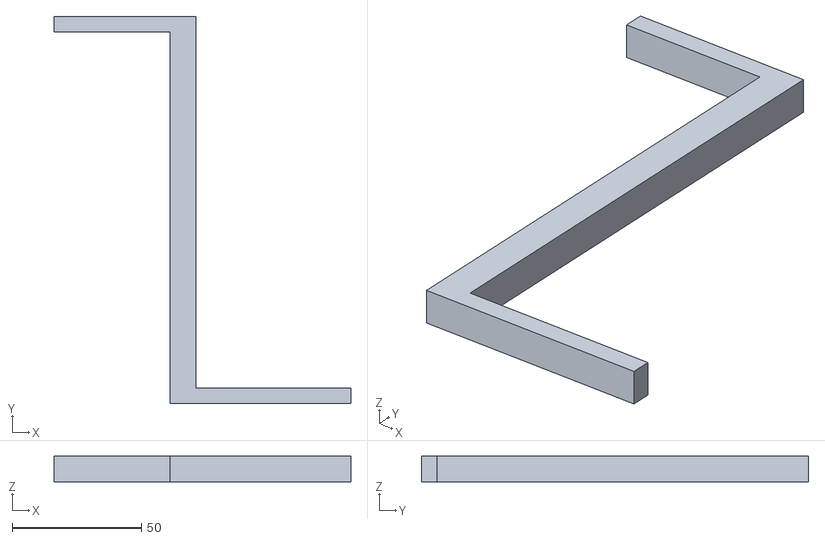
[picture p92: CAD file, 2026-10-17]
research/models/drop_stand_gauge.stl
115.0 x 150.0 x 10.0
