ZacharyShaver/FPVTank_Prototype/head-v2/generator/pan-coil-b/fusion/bay.obj

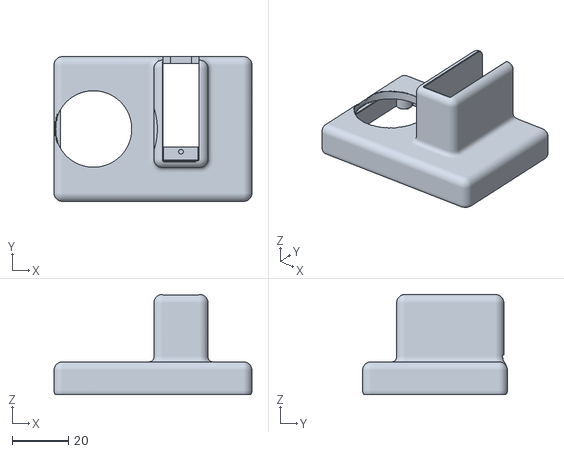
[picture p93: CAD file, 2026-10-13]
head-v2/generator/pan-coil-b/fusion/bay.obj
70.2 x 51.3 x 35.5
