ZacharyShaver/FPVTank_Prototype/head-v2/generator/tree-parts-b/fusion-convert/ball_plus.obj

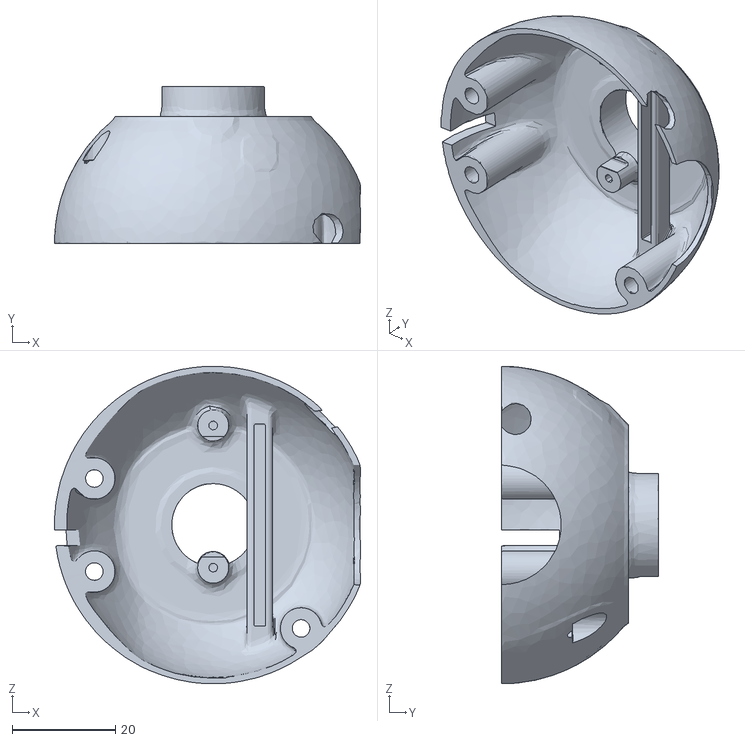
[picture p94: CAD file, 2026-09-27]
head-v2/generator/tree-parts-b/fusion-convert/ball_plus.obj
59.2 x 30.3 x 61.4
