ZacharyShaver/FPVTank_Prototype/head-v2/generator/tree-parts-b/fusion/cap_minus.obj

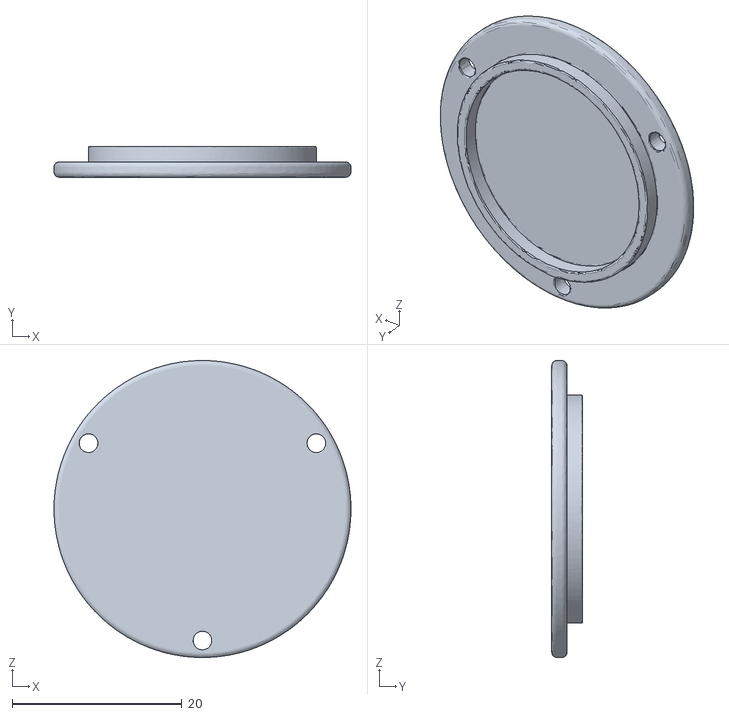
[picture p95: CAD file, 2026-09-27]
head-v2/generator/tree-parts-b/fusion/cap_minus.obj
35.0 x 3.61 x 35.0
