ZacharyShaver/FPVTank_Prototype/head-v2/generator/tree-parts/fusion/ball_minus_blank.obj

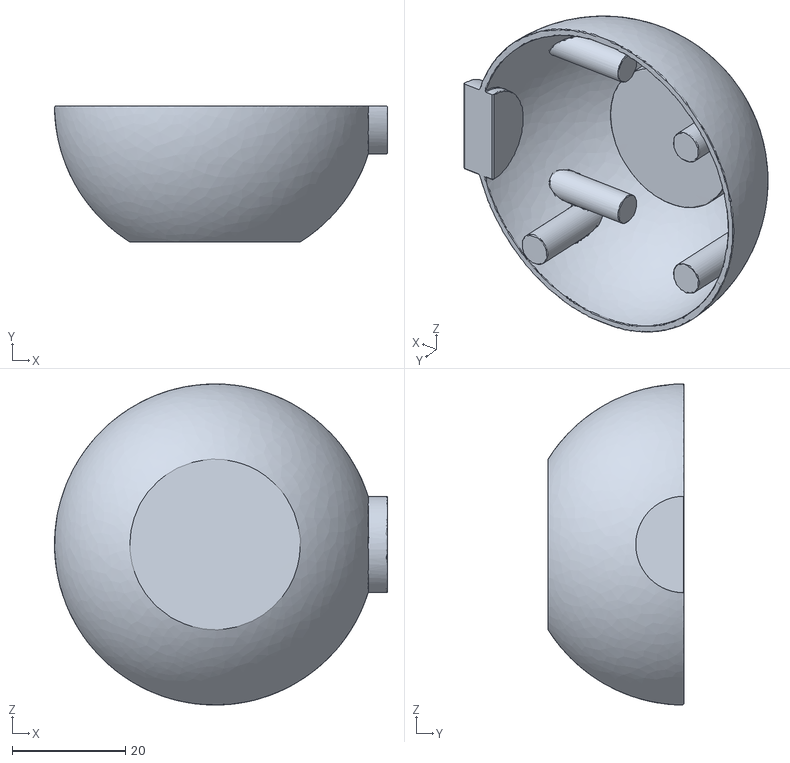
[picture p96: CAD file, 2026-09-27]
head-v2/generator/tree-parts/fusion/ball_minus_blank.obj
58.7 x 24.0 x 56.6
