ZacharyShaver/FPVTank_Prototype/reference/fpv-rover-v2/camera-mount-right-v11.stl

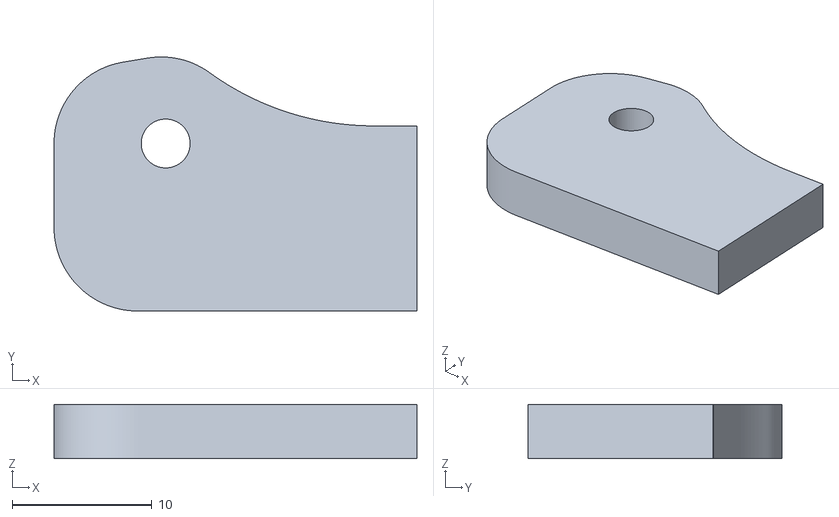
[picture p97: CAD file, 2024-10-14]
reference/fpv-rover-v2/camera-mount-right-v11.stl
26.0 x 18.2 x 3.90
