ZacharyShaver/FPVTank_Prototype/research/models/drop_stand_post.stl

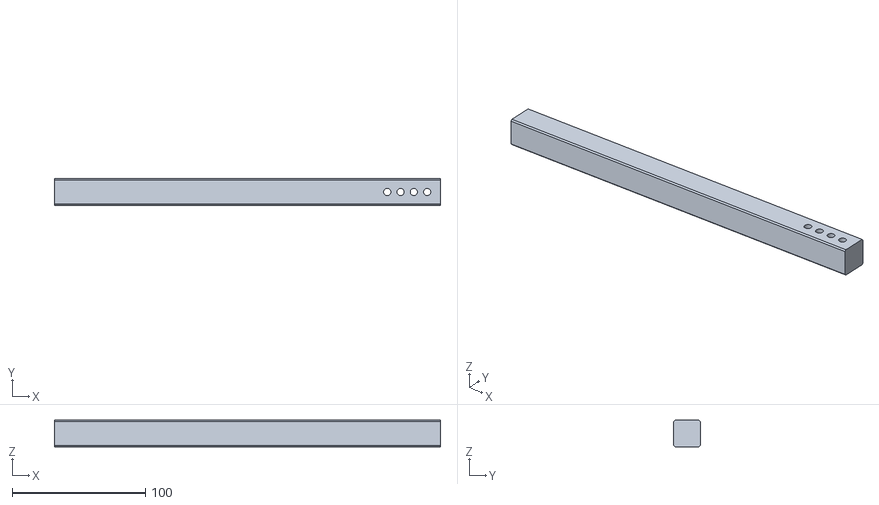
[picture p98: CAD file, 2026-10-17]
research/models/drop_stand_post.stl
290.0 x 20.0 x 20.0
