ZacharyShaver/FPVTank_Prototype/head-v2/generator/pan-coil-b/fusion/well.obj

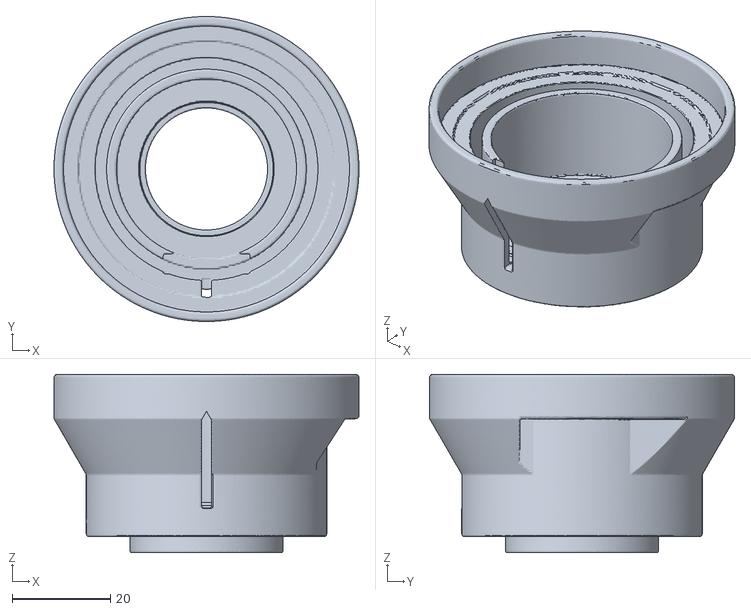
[picture p99: CAD file, 2026-10-13]
head-v2/generator/pan-coil-b/fusion/well.obj
62.0 x 62.0 x 36.2
