ZacharyShaver/FPVTank_Prototype/head-v2/generator/tree-hood/fusion/rod.obj

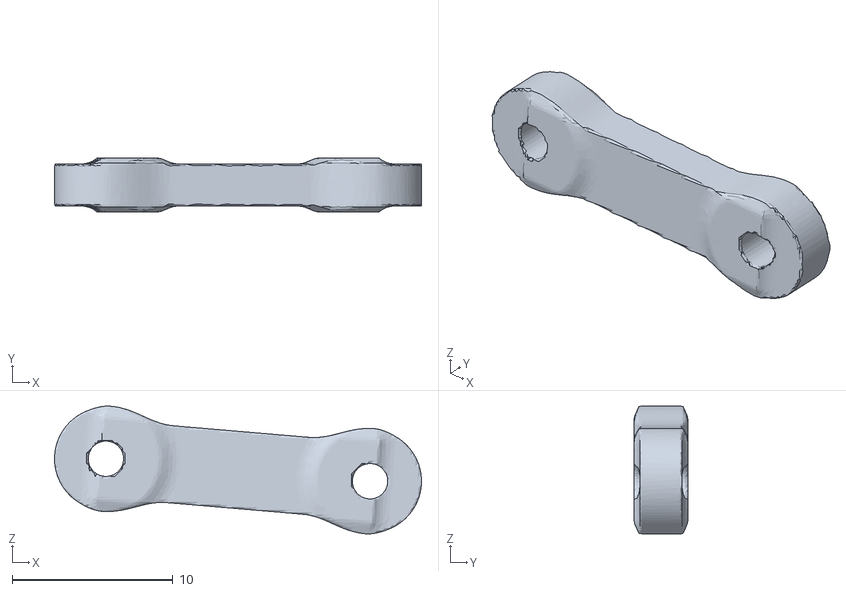
[picture p100: CAD file, 2026-09-27]
head-v2/generator/tree-hood/fusion/rod.obj
22.8 x 3.35 x 7.96
