ZacharyShaver/FPVTank_Prototype/research/models/drop_stand_pins.stl

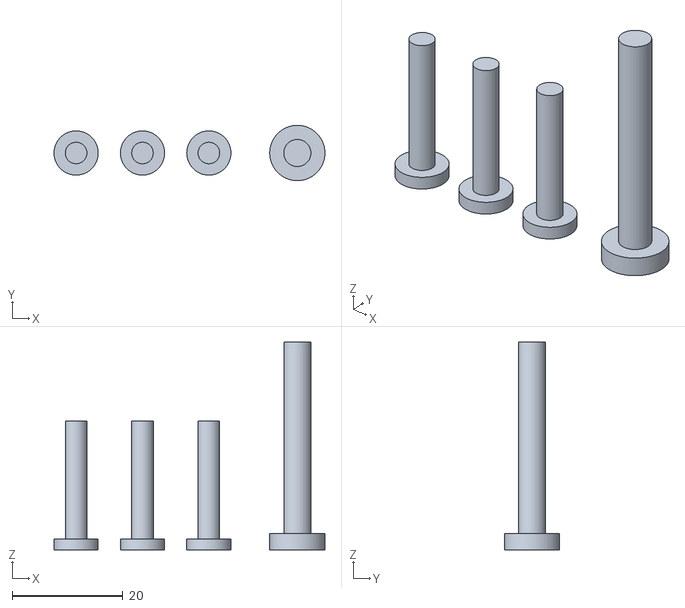
[picture p101: CAD file, 2026-10-17]
research/models/drop_stand_pins.stl
49.0 x 10.0 x 37.6
