ZacharyShaver/FPVTank_Prototype/head-v2/generator/pan-coil-b/fusion/base.obj

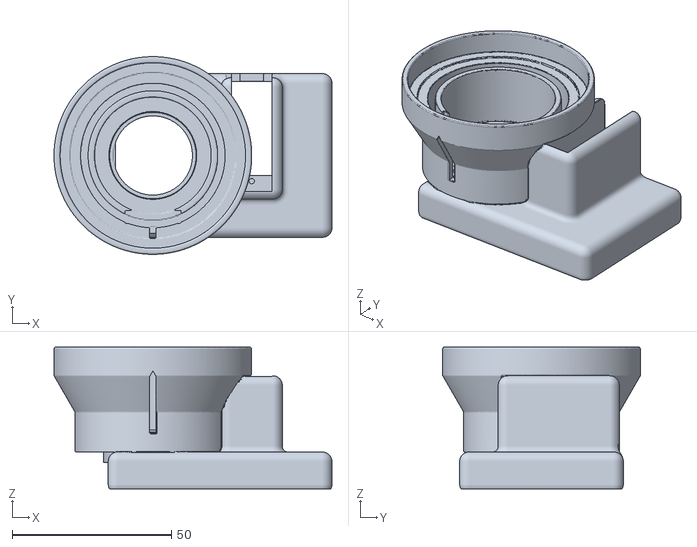
[picture p102: CAD file, 2026-10-13]
head-v2/generator/pan-coil-b/fusion/base.obj
87.2 x 62.0 x 44.5
