ZacharyShaver/FPVTank_Prototype/head-v2/generator/tree-parts/fusion/ball_plus.obj

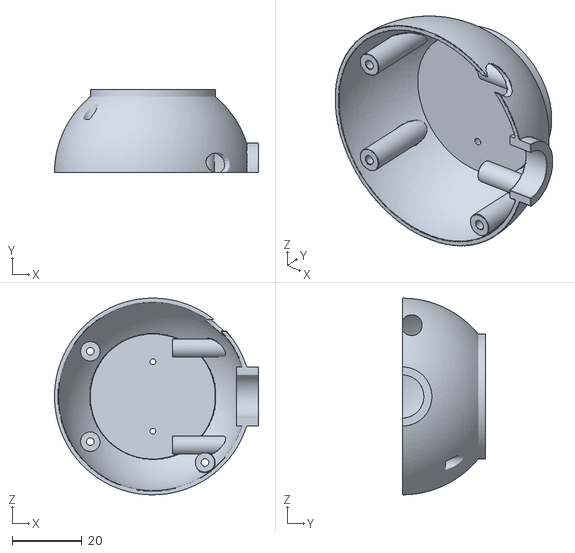
[picture p103: CAD file, 2026-09-27]
head-v2/generator/tree-parts/fusion/ball_plus.obj
58.7 x 24.0 x 56.6
