ZacharyShaver/FPVTank_Prototype/research/models/drop_stand_jaws.stl

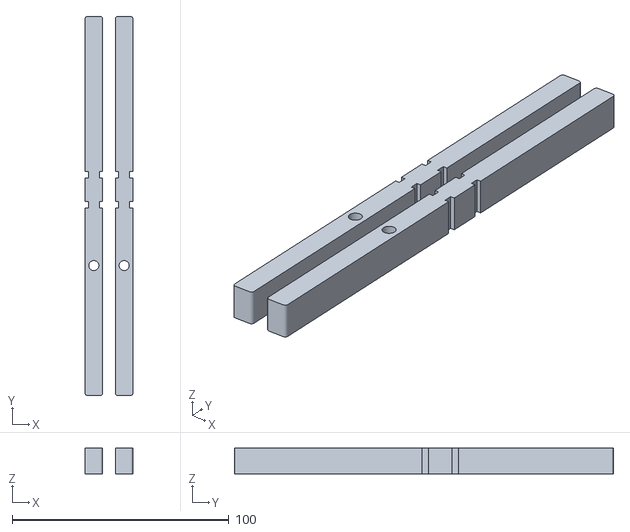
[picture p104: CAD file, 2026-10-17]
research/models/drop_stand_jaws.stl
22.0 x 175.0 x 12.0
