ZacharyShaver/FPVTank_Prototype/head-v2/generator/pan-coil-b/fusion/shelf_ring.obj

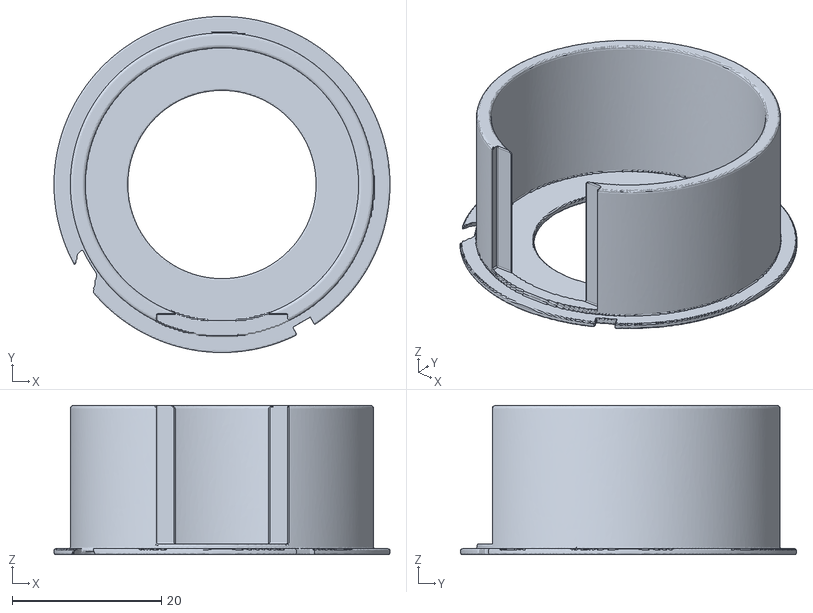
[picture p105: CAD file, 2026-10-13]
head-v2/generator/pan-coil-b/fusion/shelf_ring.obj
45.0 x 45.0 x 20.0
