ZacharyShaver/FPVTank_Prototype/research/models/phone_mount_iphone15.stl

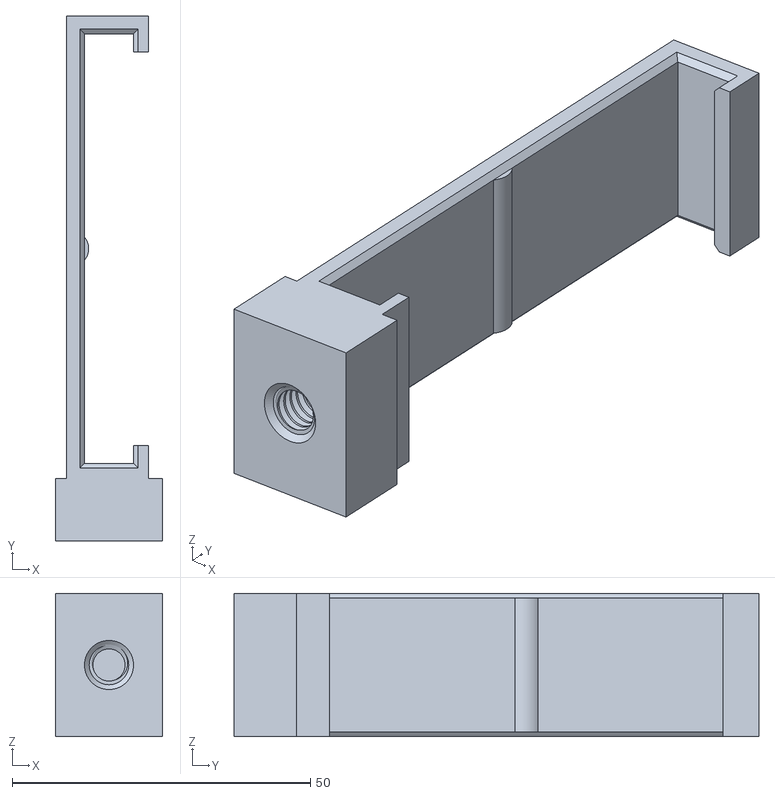
[picture p107: CAD file, 2026-10-14]
research/models/phone_mount_iphone15.stl
18.0 x 88.0 x 24.0
