ZacharyShaver/FPVTank_Prototype/head-v2/generator/pan-coil-b/fusion/gear_in.obj

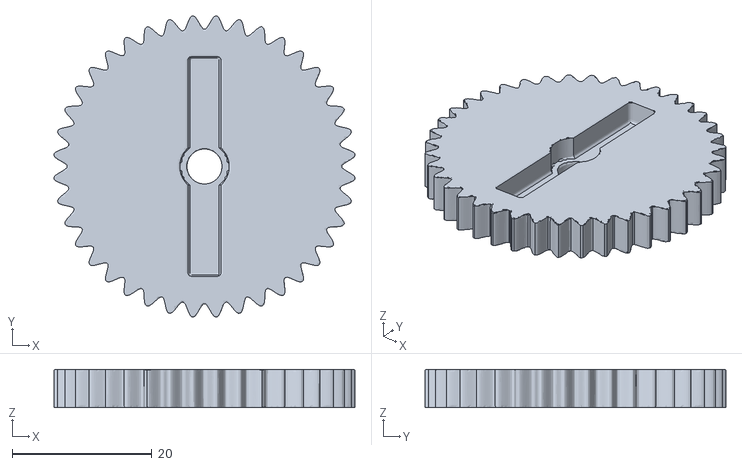
[picture p108: CAD file, 2026-10-13]
head-v2/generator/pan-coil-b/fusion/gear_in.obj
43.1 x 43.1 x 5.51
