ZacharyShaver/FPVTank_Prototype/head-v2/generator/tree-parts/fusion/axle_blank.obj

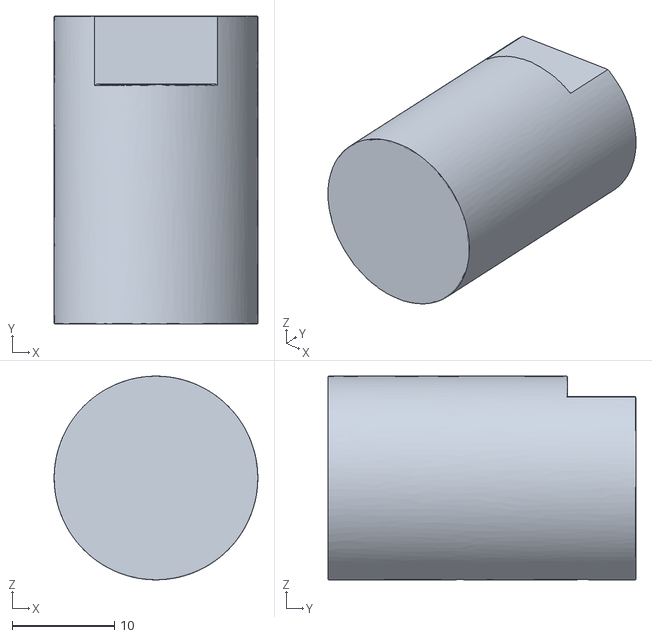
[picture p109: CAD file, 2026-09-27]
head-v2/generator/tree-parts/fusion/axle_blank.obj
19.9 x 30.1 x 19.9
