ZacharyShaver/FPVTank_Prototype/research/models/ball_pla_40.stl

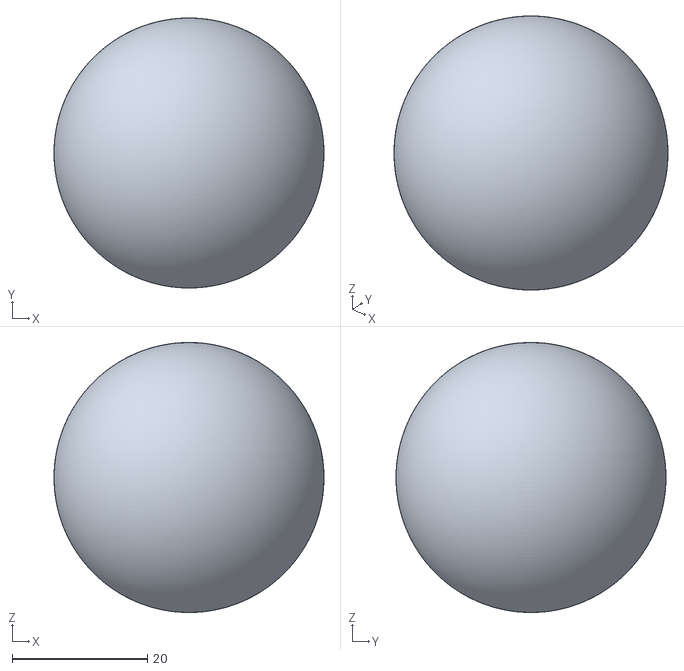
[picture p110: CAD file, 2026-10-14]
research/models/ball_pla_40.stl
40.0 x 40.0 x 40.0
