ZacharyShaver/FPVTank_Prototype/research/models/spacer_v2_E2.stl

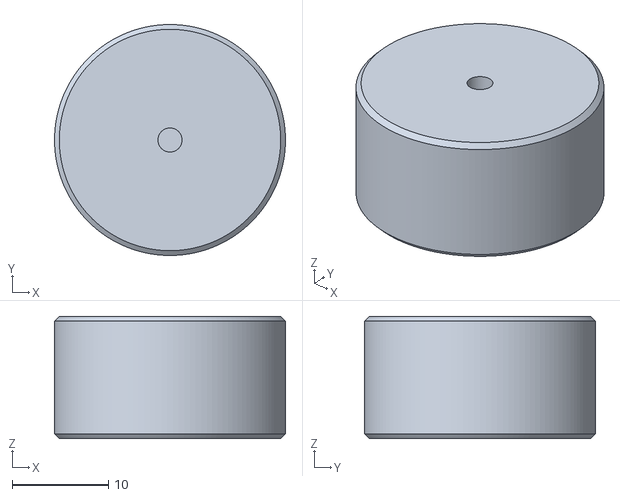
[picture p111: CAD file, 2026-10-14]
research/models/spacer_v2_E2.stl
24.0 x 24.0 x 12.7
