ZacharyShaver/FPVTank_Prototype/head-v2/generator/pan-coil-b/fusion/horn.obj

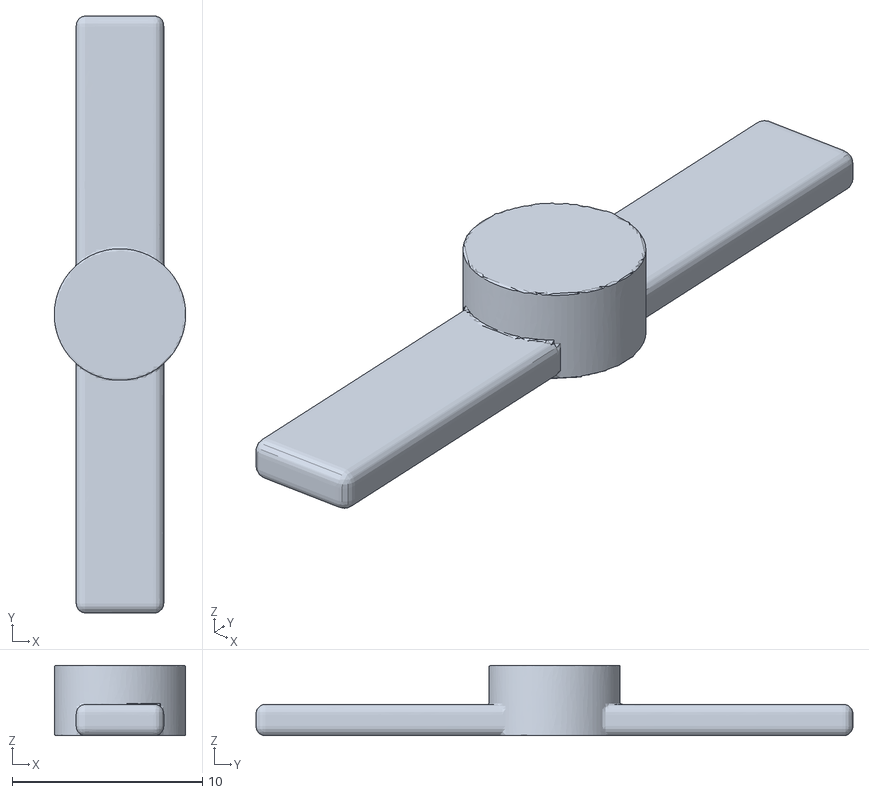
[picture p112: CAD file, 2026-10-13]
head-v2/generator/pan-coil-b/fusion/horn.obj
6.90 x 31.4 x 3.70
