ZacharyShaver/FPVTank_Prototype/research/models/spacer_v2_E3.stl

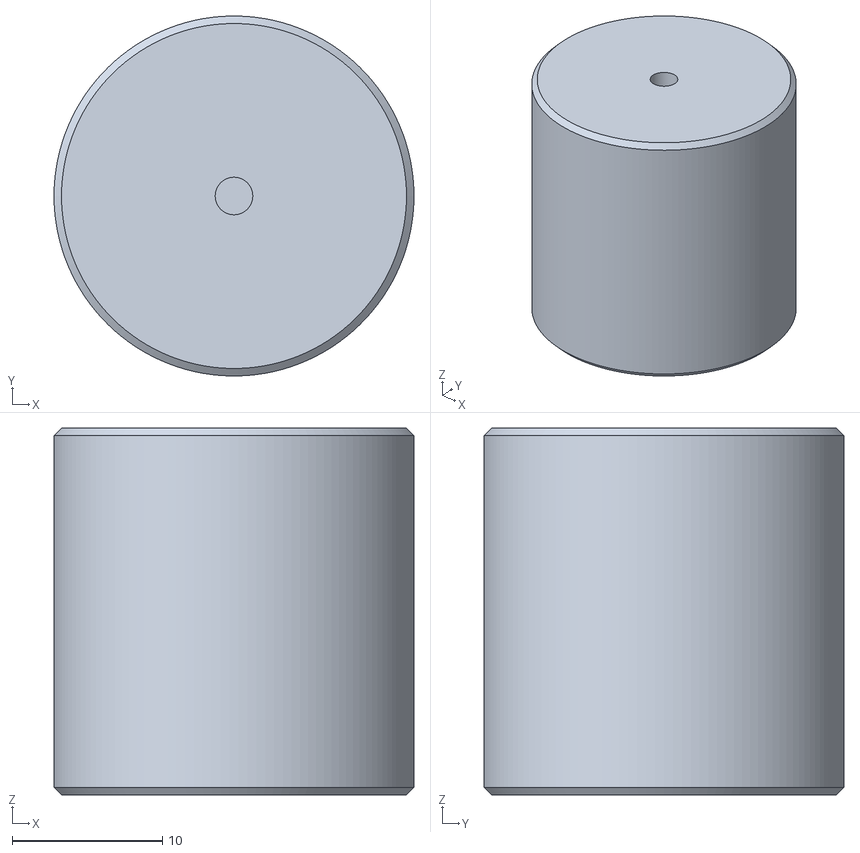
[picture p113: CAD file, 2026-10-14]
research/models/spacer_v2_E3.stl
24.0 x 24.0 x 24.4
