ZacharyShaver/FPVTank_Prototype/research/models/spacer_v2_E1.stl

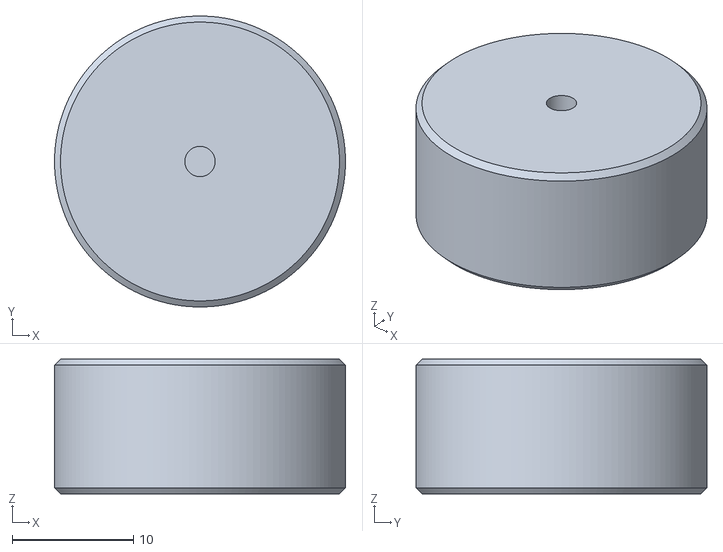
[picture p114: CAD file, 2026-10-14]
research/models/spacer_v2_E1.stl
24.0 x 24.0 x 11.1
