ZacharyShaver/FPVTank_Prototype/head-v2/generator/pan-coil-b/fusion/servo.obj

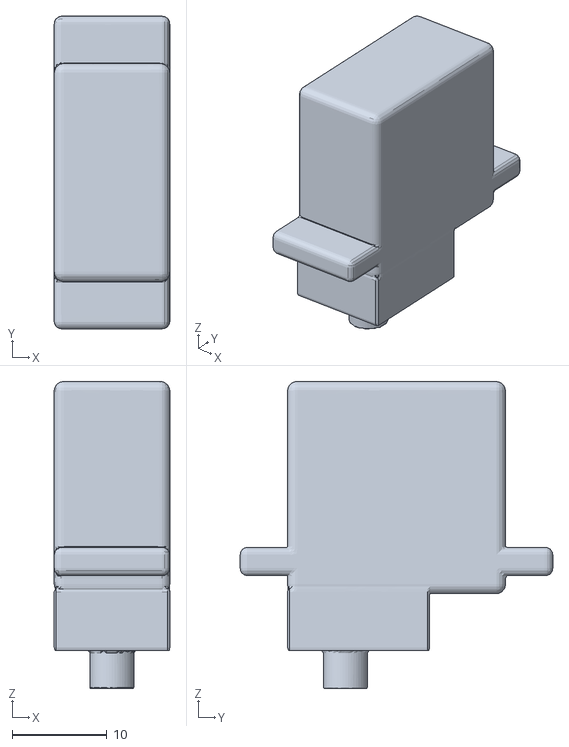
[picture p115: CAD file, 2026-10-02]
head-v2/generator/pan-coil-b/fusion/servo.obj
12.2 x 33.0 x 32.4
