ZacharyShaver/FPVTank_Prototype/head-v2/generator/tree-parts/fusion/fork.obj

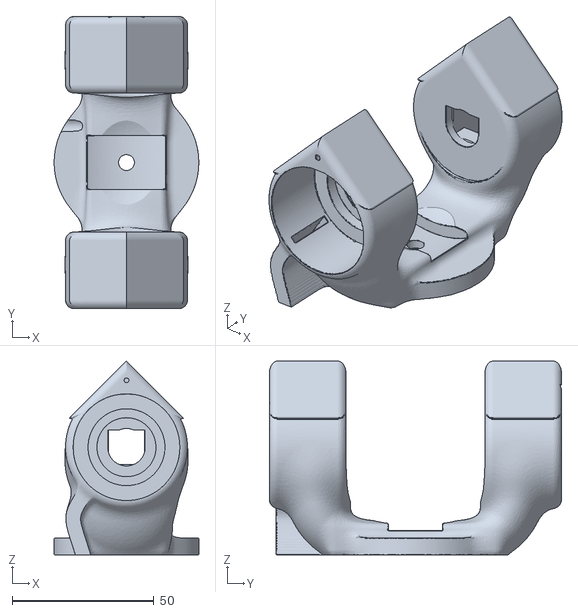
[picture p116: CAD file, 2026-09-27]
head-v2/generator/tree-parts/fusion/fork.obj
51.0 x 103.1 x 68.4
