ZacharyShaver/FPVTank_Prototype/research/models/E3_tall.stl

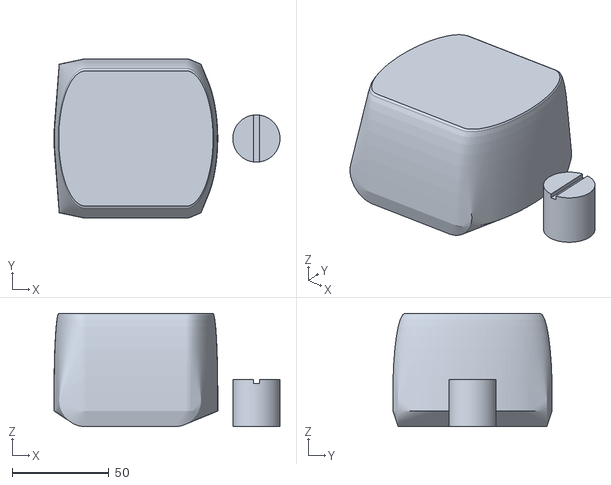
[picture p117: CAD file, 2026-10-13]
research/models/E3_tall.stl
117.1 x 82.5 x 58.8
