ZacharyShaver/FPVTank_Prototype/head-v2/generator/pan-coil-b/fusion/tab_block.obj

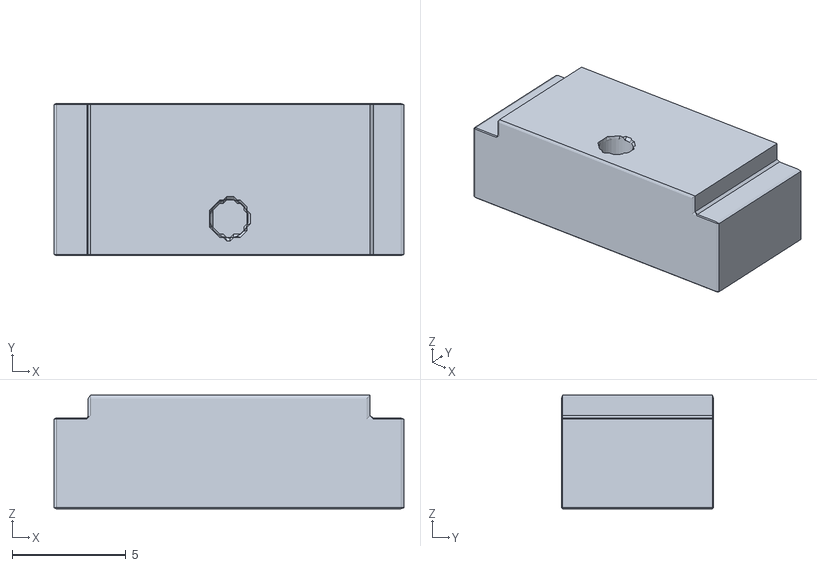
[picture p118: CAD file, 2026-10-02]
head-v2/generator/pan-coil-b/fusion/tab_block.obj
15.4 x 6.70 x 5.00
