ZacharyShaver/FPVTank_Prototype/research/models/test_tall.stl

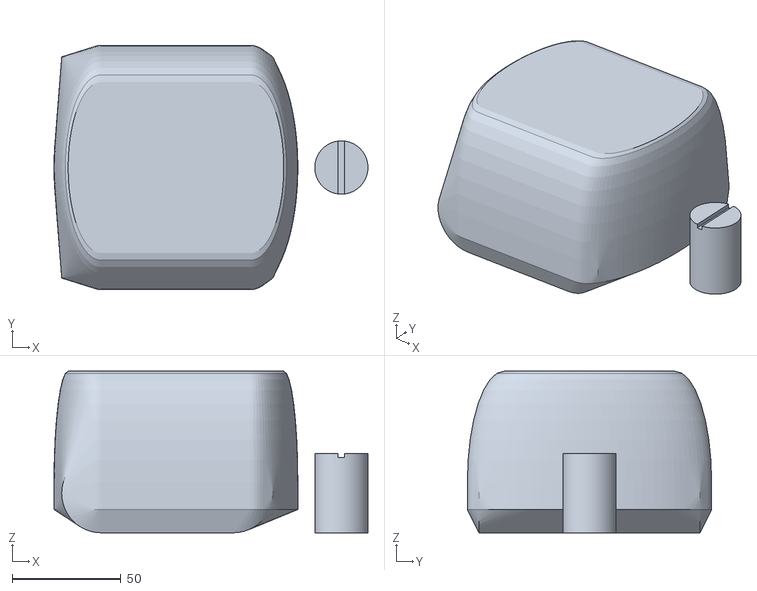
[picture p119: CAD file, 2026-10-13]
research/models/test_tall.stl
144.2 x 112.2 x 74.2
