ZacharyShaver/FPVTank_Prototype/head-v2/generator/pan-coil-b/fusion/ribbon.obj

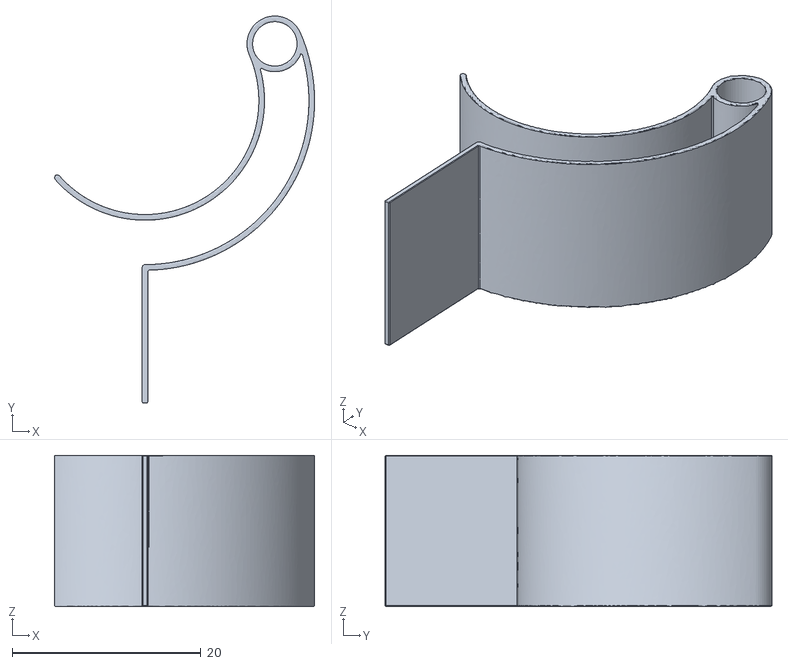
[picture p120: CAD file, 2026-09-27]
head-v2/generator/pan-coil-b/fusion/ribbon.obj
27.5 x 41.0 x 16.0
