ZacharyShaver/FPVTank_Prototype/research/models/E1_tub.stl

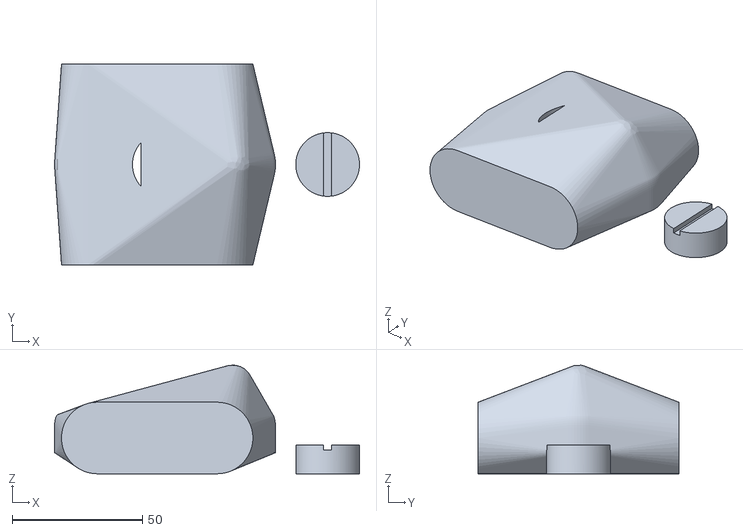
[picture p121: CAD file, 2026-10-13]
research/models/E1_tub.stl
117.1 x 77.0 x 41.7
