ZacharyShaver/FPVTank_Prototype/head-v2/generator/pan-coil-b/fusion/twist_gap.obj

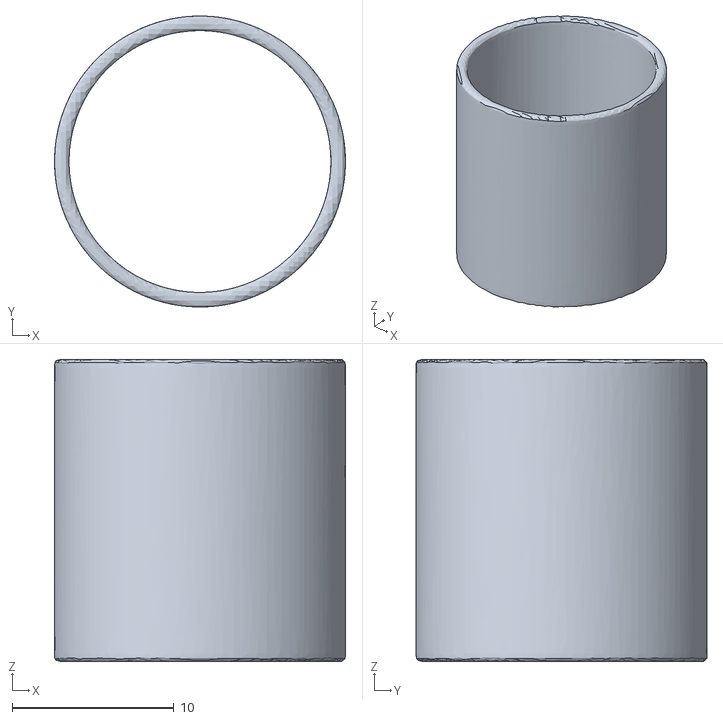
[picture p122: CAD file, 2026-09-27]
head-v2/generator/pan-coil-b/fusion/twist_gap.obj
18.0 x 18.0 x 18.7
