ZacharyShaver/FPVTank_Prototype/research/models/E2_dome.stl

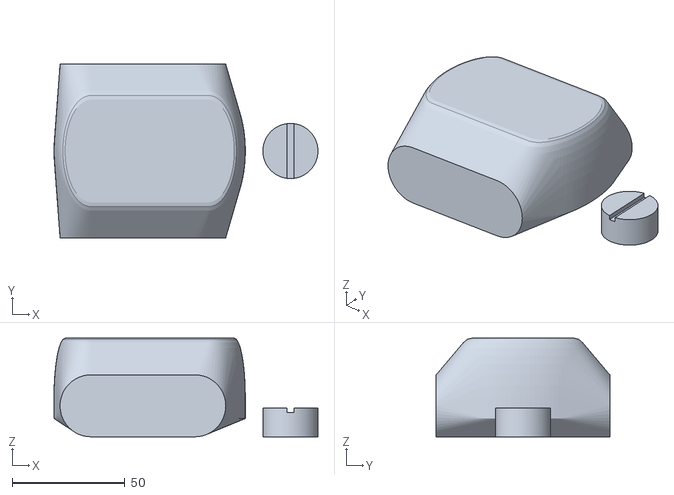
[picture p123: CAD file, 2026-10-13]
research/models/E2_dome.stl
117.1 x 77.0 x 43.8
