ZacharyShaver/FPVTank_Prototype/head-v2/generator/pan-coil-b/fusion/bearing.obj

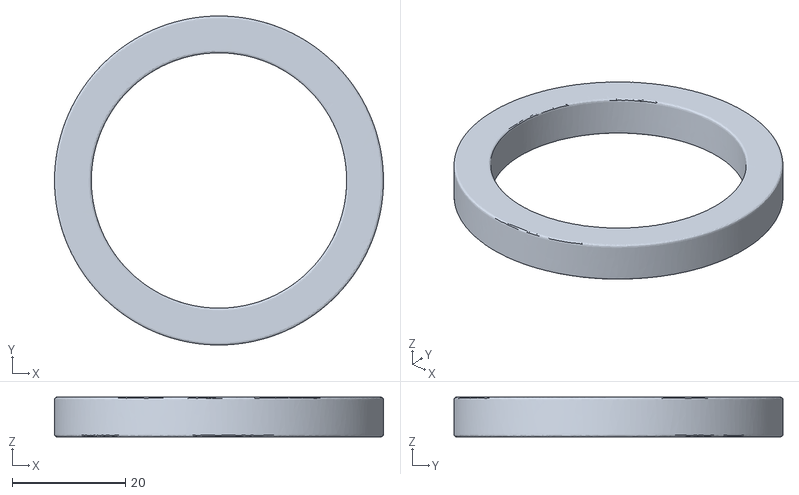
[picture p124: CAD file, 2026-09-27]
head-v2/generator/pan-coil-b/fusion/bearing.obj
58.0 x 58.0 x 7.00
