ZacharyShaver/FPVTank_Prototype/(list of files, cad)

Other CAD files:
head-v2/generator/tree-parts-b/fusion-convert/post.obj
head-v2/fusion/rev1-2026-09-24/ball_minus_revised.stl
head-v2/generator/camera/camera_dummy_centred_origin.step
head-v2/generator/tree-parts-b/fusion-convert/fork.obj
head-v2/generator/tree-parts-b/fusion/ball_minus.obj
head-v2/generator/camera/camera_dummy_origin.step
head-v2/generator/tree-parts-b/fusion/post.obj
head-v2/generator/tree-parts-b/step/ball_minus.step
head-v2/generator/tree-hood/fusion/roots.obj
head-v2/generator/tree-parts-b/step/cap_minus.step
head-v2/generator/tree-parts-b/fusion/roots.obj
head-v2/generator/tree-parts-b/step/axle.step
head-v2/generator/tree-parts/fusion/ball_plus_blank.obj
reference/fpv-rover-v2/inner-frame-left-v15.stl
head-v2/generator/tree-parts-b/fusion-convert/roots.obj
reference/fpv-rover-v2/esc-mount-left-v12.stl
head-v2/generator/tree-parts-b/fusion/ball_plus.obj
head-v2/generator/pan-coil-b/fusion/bearing6704.obj
head-v2/generator/tree-parts/fusion/roots_blank.obj
head-v2/generator/tree-parts/fusion/cap_coil_blank.obj
head-v2/generator/tree-parts/fusion/ball_minus.obj
head-v2/generator/tree-parts/fusion/cap_servo.obj
archive/pan-tilt-2026-08/Body15.stl
archive/pan-tilt-2026-08/Body31.stl
archive/pan-tilt-2026-08/Body55.stl
archive/pan-tilt-2026-08/Body56.stl
archive/pan-tilt-2026-08/Pan_Tilt_pan_cap.stl
archive/pan-tilt-2026-08/pan-tilt-pan-v3.stl
archive/pan-tilt-2026-08/pan-tilt-x-y-v2.stl
archive/pan-tilt-2026-08/tank body section.stl
chassis-v1/from_fusion/Configuration 1.step
chassis-v1/from_fusion/TEST-PRINT-2_Configuration 1_LeftBattery.stl
chassis-v1/from_fusion/TEST-PRINT-2_Configuration 1_Pan_Tilt_pan_cap.stl
chassis-v1/from_fusion/TEST-PRINT-2_Configuration 1_RASPBERRY_PI_5_WITH_ACTIVE_COOLER.stl
chassis-v1/from_fusion/TEST-PRINT-2_Configuration 1_RightBattery.stl
chassis-v1/from_fusion/TEST-PRINT-2_Configuration 1_Tank_body.stl
chassis-v1/from_fusion/TEST-PRINT-2_Configuration 1_ball_brearing_r (1).stl
chassis-v1/from_fusion/TEST-PRINT-2_Configuration 1_ball_brearing_r.stl
chassis-v1/from_fusion/TEST-PRINT-2_Configuration 1_y-tilt-servo.stl
chassis-v1/from_fusion/TEST-PRINT-2_Configuration 1_y_tilt_face.stl
chassis-v1/from_fusion/TEST-PRINT-2_Configuration 1_y_tilt_mount_left (2).stl
chassis-v1/from_fusion/TEST-PRINT-2_Configuration 1_y_tilt_mount_right (1).stl
chassis-v1/from_fusion/TEST-PRINT-2_Configuration 1_z_mount_bottom.stl
chassis-v1/from_fusion/TEST-PRINT-2_Configuration 1_z_mount_top.stl
chassis-v1/from_fusion/Version_1.1.f3d
chassis-v1/parts/big-bevel-gear-21-v11.stl
chassis-v1/parts/big-bevel-gear-41-v13.stl
chassis-v1/parts/big_track_v11.stl
chassis-v1/parts/body-rover-v13.stl
chassis-v1/parts/front-cover-v13.stl
chassis-v1/parts/front-main-cog-v13.stl
chassis-v1/parts/inner-frame-left-high-v10.stl
chassis-v1/parts/inner-frame-right-high-v10.stl
chassis-v1/parts/led-mount-v12.stl
chassis-v1/parts/motor-mount-v13.stl
chassis-v1/parts/outer-frame-v13.stl
chassis-v1/parts/rear-cover-v12.stl
chassis-v1/parts/rear-main-cog-v13.stl
chassis-v1/parts/rubbertrack-v12.stl
chassis-v1/parts/small-bevel-gear-21-v11.stl
chassis-v1/parts/small-bevel-gear-41-v11.stl
chassis-v1/parts/small-cog-v2.stl
chassis-v1/parts/top-parts-v15.stl
chassis-v1/parts/tow-bar-plug-v12.stl
chassis-v1/parts/track-v13.stl
head-v2/generator/camera/camera_dummy.stl
head-v2/generator/camera/camera_dummy_centred.stl
head-v2/generator/camera/camera_dummy_centred_origin.stl
head-v2/generator/camera/camera_dummy_origin.stl
head-v2/generator/pan-coil-b/fusion/screw_out.obj
head-v2/generator/test-print-2/y_tilt_mount_onepiece_superseded.stl
