ZacharyShaver/FPVTank_Prototype/head-v2/generator/test-print-2/review_assembled.png

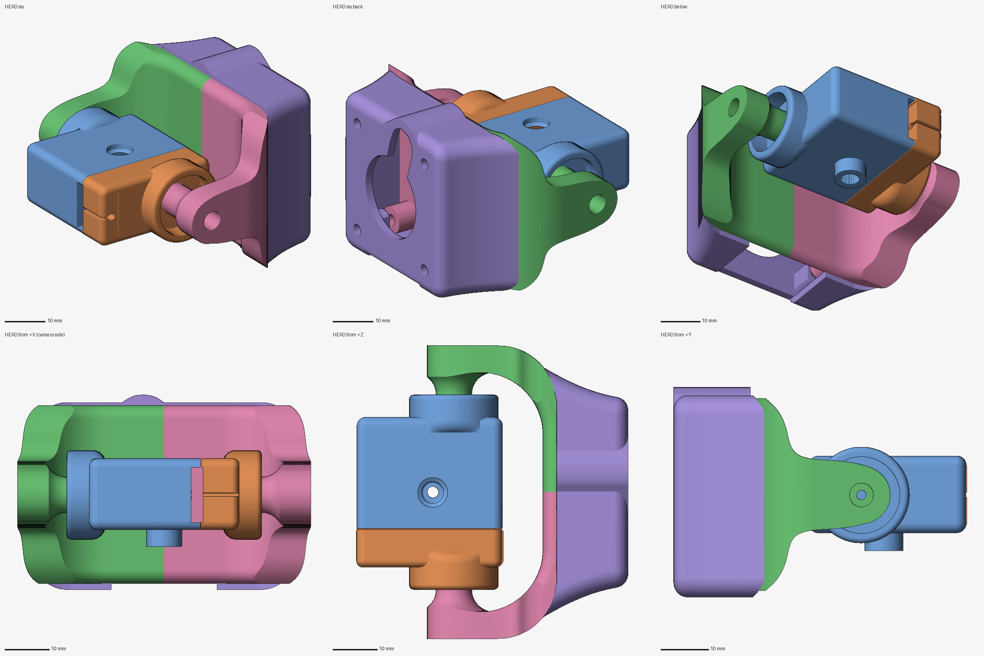
head-v2/generator/test-print-2/review_assembled.png
