ZacharyShaver/FPVTank_Prototype/head-v2/generator/test-print-2/review_tilt_down_collision.png

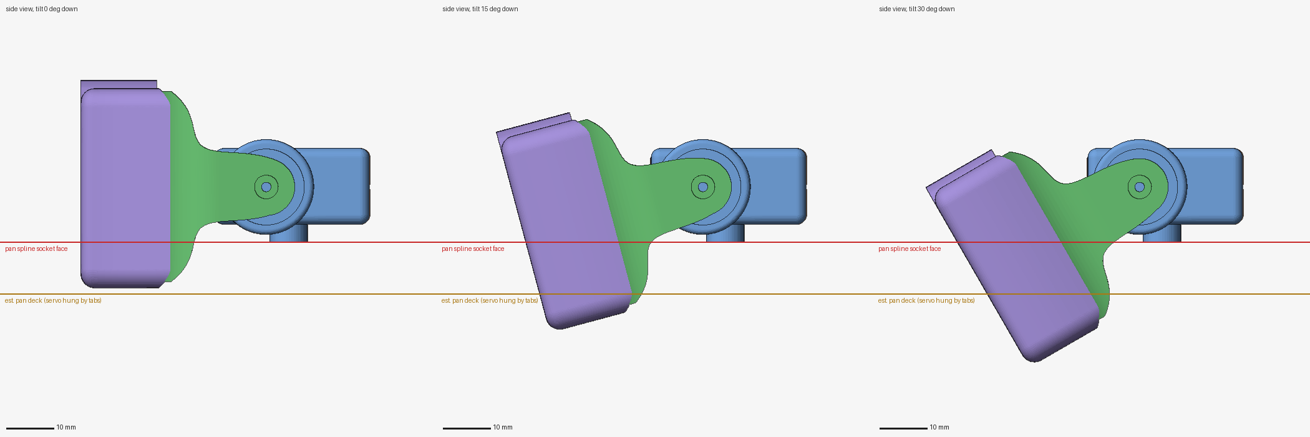
head-v2/generator/test-print-2/review_tilt_down_collision.png
