ZacharyShaver/FPVTank_Prototype/head-v2/generator/tree-parts-b/step/step_vs_obj.png

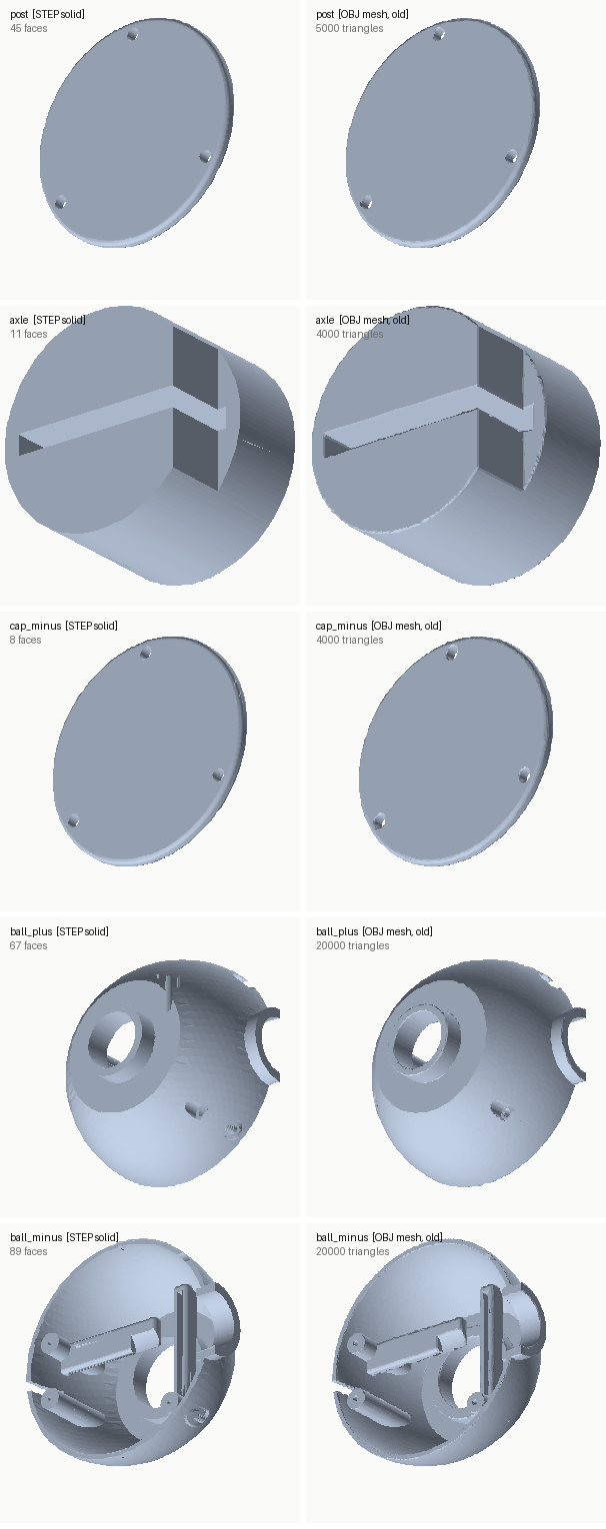
head-v2/generator/tree-parts-b/step/step_vs_obj.png
