ZacharyShaver/FPVTank_Prototype/research/figures/step_down.png

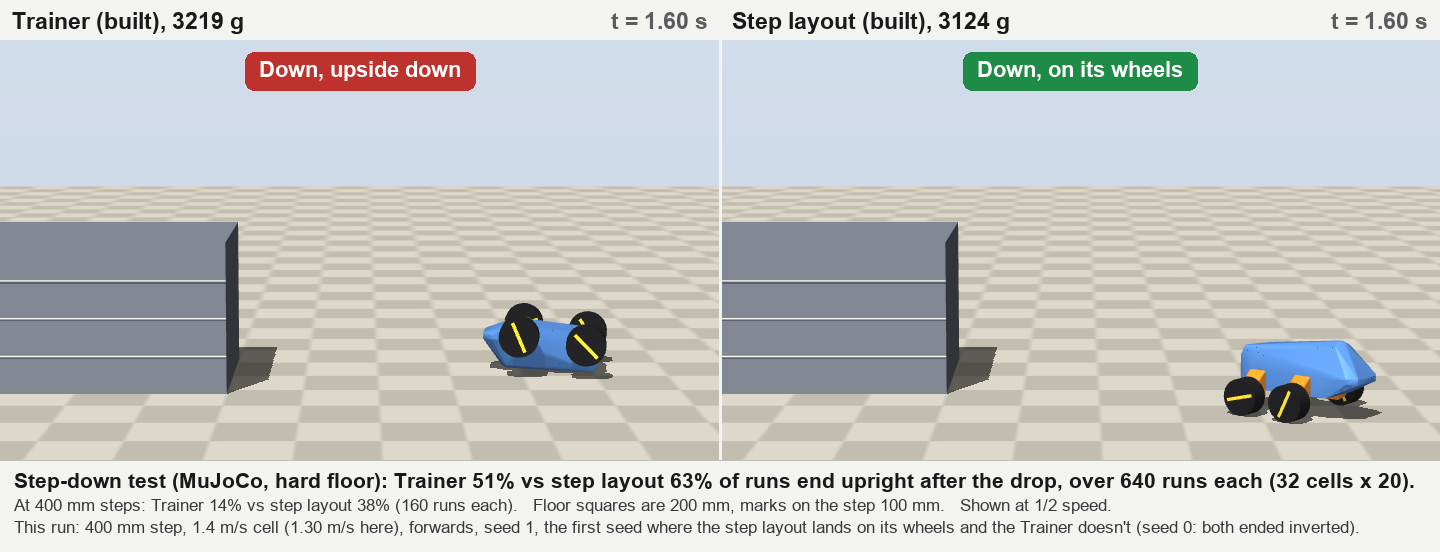
research/figures/step_down.png
