ZacharyShaver/FPVTank_Prototype/research/results/drop_predictions_15cm_E4_weeble_softfit.md

# Drop predictions, E4_weeble, 15 cm from the stand: soft floor, bounce fitted at 6 cm

Committed before the body is dropped. 200 simulated drops per start, +-15 deg jitter, release height 150 mm.
Mass layout: {'gcode': 'E4_weeble_orca_PLA_1h36m.gcode', 'body_g': 60.17, 'spacer_g': 5.07, 'body_com': [2.45, 0.01, 31.84], 'registration_mm': [-0.68, -0.44]}.

## E4_weeble mass low (mass 133.3 g, CoM z 21.2 mm): P(upright) over the six starts 1.000

| start | upright | inverted | side | on an end |
|---|---|---|---|---|
| nose down | 1.000 | 0.000 | 0.000 | 0.000 |
| tail down | 1.000 | 0.000 | 0.000 | 0.000 |
| left side down | 1.000 | 0.000 | 0.000 | 0.000 |
| right side down | 1.000 | 0.000 | 0.000 | 0.000 |
| upside down | 1.000 | 0.000 | 0.000 | 0.000 |
| upside down, 45 to the left | 1.000 | 0.000 | 0.000 | 0.000 |

## E4_weeble mass high (mass 133.3 g, CoM z 37.5 mm): P(upright) over the six starts 0.181

| start | upright | inverted | side | on an end |
|---|---|---|---|---|
| nose down | 0.010 | 0.990 | 0.000 | 0.000 |
| tail down | 0.115 | 0.885 | 0.000 | 0.000 |
| left side down | 0.005 | 0.995 | 0.000 | 0.000 |
| right side down | 0.005 | 0.995 | 0.000 | 0.000 |
| upside down | 0.010 | 0.990 | 0.000 | 0.000 |
| upside down, 45 to the left | 0.940 | 0.060 | 0.000 | 0.000 |
