ZacharyShaver/FPVTank_Prototype/research/results/posthoc_stiff.md

# Post hoc: a hard floor with the measured bounce

Naive: 6 cm 1.293, 30 cm 1.506.

| model | Brier, 6 cm (181) | Brier, 30 cm (180) | top state right, 30 cm |
|---|---|---|---|
| dead contact (start fixed) | 0.861 | 1.156 | 0.283 |
| soft floor, bounce fitted at 6 cm | 0.443 | 0.634 | 0.472 |
| soft floor, bounce measured | - | 0.784 | 0.417 |
| hard floor, bounce measured (this run) | 0.472 | 0.638 | 0.45 |

Hard floor, predicted P(upright) at 30 cm, mass low vs high (seen: E1 10/30 vs 9/30, E2 16/30 vs 14/30, E3 16/30 vs 9/30): E1_tub 0.46 vs 0.32; E2_dome 0.54 vs 0.48; E3_tall 0.66 vs 0.3
