ZacharyShaver/FPVTank_Prototype/research/results/posthoc_cover_weight.md

# Post hoc: P(upright) vs the cover's weight (mm of solid PLA over the shell area beyond the tub)

400 drops each; binomial SE about 0.024 at P = 0.4. The tub has no cover, so its row is the reference.

| design | 0.0 mm | 0.5 mm | 1.0 mm | 1.5 mm | 2.0 mm | 3.0 mm | 5.6 mm |
|---|---|---|---|---|---|---|---|
| tub | 0.39 (3304 g, CoM 42.6) | 0.39 (3304 g, CoM 42.6) | 0.39 (3304 g, CoM 42.6) | 0.39 (3304 g, CoM 42.6) | 0.39 (3304 g, CoM 42.6) | 0.39 (3304 g, CoM 42.6) | 0.39 (3304 g, CoM 42.6) |
| E2-like dome | 0.46 (3304 g, CoM 42.6) | 0.44 (3378 g, CoM 44.6) | 0.42 (3452 g, CoM 46.5) | 0.41 (3526 g, CoM 48.3) | 0.41 (3600 g, CoM 50.1) | 0.39 (3747 g, CoM 53.4) | 0.35 (4132 g, CoM 60.8) |
| E3-like tall | 0.68 (3304 g, CoM 39.9) | 0.66 (3449 g, CoM 45.2) | 0.62 (3594 g, CoM 50.1) | 0.58 (3739 g, CoM 54.6) | 0.54 (3884 g, CoM 58.8) | 0.49 (4174 g, CoM 66.3) | 0.33 (4927 g, CoM 81.6) |
| tall wide 200/0.3/170 | 0.67 (3304 g, CoM 42.6) | 0.65 (3436 g, CoM 47.0) | 0.61 (3568 g, CoM 51.2) | 0.59 (3701 g, CoM 55.0) | 0.55 (3833 g, CoM 58.5) | 0.47 (4097 g, CoM 64.9) | 0.34 (4785 g, CoM 78.2) |
| tall low CoM 180/0.2/150/-20 | 0.62 (3304 g, CoM 37.2) | 0.58 (3414 g, CoM 40.8) | 0.55 (3524 g, CoM 44.2) | 0.53 (3635 g, CoM 47.4) | 0.47 (3745 g, CoM 50.5) | 0.44 (3965 g, CoM 56.0) | 0.38 (4539 g, CoM 67.8) |
