ZacharyShaver/FPVTank_Prototype/research/results/mutation_matrix_S1.csv

mutant | pairs | insertion | assembly | gear_play | bearing_races | screw_threads | block_air | wire_axis | merged_shelf | killed_by_S0 | killed_by_S1 | expected | historical | description
none | 0 | 0 | 0 | 0 | 0 | 0 | 0 | 0 | 0 | 0 | 0 |  |  | unmutated design
M01 | 1 | 1 | 0 | 0 | 0 | 0 | 0 | 0 | 0 | 1 | 1 | pairs, insertion | 2026-09-19: the servo passed through the well; Zach saw it by eye | pan servo 2 mm toward the axis, into the can
M02 | 1 | 0 | 1 | 0 | 0 | 0 | 0 | 0 | 0 | 1 | 1 | pairs | 2026-09-19: the flange ploughed 270 mm3 through the deck ring | drum's flange back to r 19.6
M03 | 0 | 0 | 1 | 1 | 0 | 0 | 0 | 0 | 0 | 0 | 1 | assembly | 2026-09-27 set 1: could not be assembled; all seated checks read zero | small gear moulded onto the drum
M04 | 0 | 0 | 1 | 0 | 0 | 0 | 0 | 0 | 0 | 0 | 1 | assembly | 2026-09-27 set 1 | the gear bay's floor fused to the base (a closed box)
M05 | 0 | 0 | 0 | 1 | 0 | 0 | 0 | 0 | 0 | 0 | 1 | gear_play | 2026-09-27: 0.0 deg of free play | gear pair drawn at exactly the centre distance
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
