ZacharyShaver/FPVTank_Prototype/research/results/drop_predictions_30cm_hard_floor_ball2.md

# POST HOC (the 30 cm drops were seen): hard floor at 0.1 ms, bounce 0.39 (the PLA ball, IMG_1642), 30 cm

Release height 300 mm (lowest point of the body above the table). Contact damping ratio: 0.35. Start: fixed (world heading).

Each cell: the most likely rest state and its probability at the nominal friction, then the range of that
probability across 0.65x to 1.5x friction. 200 simulated drops per cell.

## E1_tub mass low  (mass 108.5 g, CoM z 13.0 mm)

| start | most likely | p | across friction | others |
|---|---|---|---|---|
| nose down | upright | 0.53 | 0.53-0.53 | inverted 0.34, right side 0.07, left side 0.07 |
| tail down | upright | 0.52 | 0.52-0.52 | inverted 0.43, right side 0.03, left side 0.01, nose down 0.01 |
| left side down | upright | 0.60 | 0.60-0.60 | inverted 0.38, left side 0.01, right side 0.01 |
| right side down | inverted | 0.58 | 0.58-0.58 | upright 0.39, right side 0.03, left side 0.01 |
| upside down | inverted | 0.89 | 0.89-0.89 | upright 0.10, right side 0.01 |
| upside down, 45 to the left | inverted | 0.62 | 0.62-0.62 | upright 0.34, left side 0.01, right side 0.01 |

## E1_tub mass high  (mass 108.5 g, CoM z 19.5 mm)

| start | most likely | p | across friction | others |
|---|---|---|---|---|
| nose down | inverted | 0.93 | 0.93-0.93 | upright 0.07 |
| tail down | inverted | 0.69 | 0.69-0.69 | upright 0.29, left side 0.01, right side 0.01 |
| left side down | inverted | 0.50 | 0.50-0.50 | upright 0.48, left side 0.01, right side 0.01 |
| right side down | upright | 0.66 | 0.66-0.66 | inverted 0.32, right side 0.01, left side 0.01 |
| upside down | inverted | 0.90 | 0.90-0.90 | upright 0.09, right side 0.01, left side 0.01 |
| upside down, 45 to the left | inverted | 0.89 | 0.89-0.89 | upright 0.09, left side 0.01, right side 0.01 |

## E2_dome mass low  (mass 118.9 g, CoM z 15.2 mm)

| start | most likely | p | across friction | others |
|---|---|---|---|---|
| nose down | upright | 0.60 | 0.60-0.60 | inverted 0.34, left side 0.02, nose up 0.02, right side 0.01, nose down 0.01 |
| tail down | upright | 0.57 | 0.57-0.57 | inverted 0.33, left side 0.07, right side 0.03, nose up 0.01, nose down 0.01 |
| left side down | upright | 0.63 | 0.63-0.63 | inverted 0.28, right side 0.06, left side 0.03 |
| right side down | upright | 0.56 | 0.56-0.56 | inverted 0.39, left side 0.03, right side 0.02, nose up 0.01 |
| upside down | inverted | 0.47 | 0.47-0.47 | upright 0.39, right side 0.08, left side 0.06, nose down 0.01 |
| upside down, 45 to the left | upright | 0.51 | 0.51-0.51 | inverted 0.40, left side 0.04, right side 0.04, nose up 0.01 |

## E2_dome mass high  (mass 118.9 g, CoM z 21.9 mm)

| start | most likely | p | across friction | others |
|---|---|---|---|---|
| nose down | upright | 0.51 | 0.51-0.51 | inverted 0.42, nose up 0.04, nose down 0.01, left side 0.01, right side 0.01 |
| tail down | inverted | 0.49 | 0.49-0.49 | upright 0.46, nose down 0.03, right side 0.01, left side 0.01 |
| left side down | upright | 0.54 | 0.54-0.54 | inverted 0.40, left side 0.05, nose up 0.01, nose down 0.01 |
| right side down | upright | 0.64 | 0.64-0.64 | inverted 0.29, right side 0.04, nose up 0.02, nose down 0.01 |
| upside down | inverted | 0.71 | 0.71-0.71 | upright 0.21, left side 0.03, right side 0.03, nose down 0.01, nose up 0.01 |
| upside down, 45 to the left | upright | 0.54 | 0.54-0.54 | inverted 0.36, left side 0.09, nose down 0.01 |

## E3_tall mass low  (mass 140.1 g, CoM z 20.4 mm)

| start | most likely | p | across friction | others |
|---|---|---|---|---|
| nose down | upright | 0.56 | 0.56-0.56 | inverted 0.29, nose down 0.10, right side 0.03, nose up 0.01, left side 0.01 |
| tail down | upright | 0.44 | 0.44-0.44 | inverted 0.30, left side 0.11, right side 0.10, nose up 0.03, nose down 0.01 |
| left side down | upright | 0.61 | 0.61-0.61 | inverted 0.30, left side 0.07, right side 0.02 |
| right side down | upright | 0.54 | 0.54-0.54 | inverted 0.32, right side 0.13, left side 0.01 |
| upside down | upright | 0.55 | 0.55-0.55 | inverted 0.18, left side 0.10, right side 0.10, nose up 0.03, nose down 0.03 |
| upside down, 45 to the left | upright | 0.77 | 0.77-0.77 | inverted 0.10, nose down 0.07, right side 0.03, left side 0.02, nose up 0.01 |

## E3_tall mass high  (mass 140.1 g, CoM z 31.2 mm)

| start | most likely | p | across friction | others |
|---|---|---|---|---|
| nose down | upright | 0.46 | 0.46-0.46 | inverted 0.34, nose down 0.08, left side 0.06, right side 0.04, nose up 0.02 |
| tail down | inverted | 0.43 | 0.43-0.43 | upright 0.29, left side 0.13, right side 0.11, nose down 0.04, nose up 0.01 |
| left side down | upright | 0.47 | 0.47-0.47 | inverted 0.35, right side 0.10, left side 0.07, nose down 0.01 |
| right side down | upright | 0.51 | 0.51-0.51 | inverted 0.28, right side 0.11, left side 0.09, nose up 0.01, nose down 0.01 |
| upside down | inverted | 0.49 | 0.49-0.49 | upright 0.15, nose down 0.11, left side 0.10, right side 0.07, nose up 0.07 |
| upside down, 45 to the left | upright | 0.47 | 0.47-0.47 | inverted 0.24, right side 0.12, left side 0.10, nose down 0.05, nose up 0.01 |
