ZacharyShaver/FPVTank_Prototype/research/results/drop_predictions_6cm_bounce_fit.md

# POST HOC (fitted to the 6 cm drops): soft floor, bounce fitted (damping 0.2), start fixed, 6 cm; per-drop numbers for posthoc_bounce_fit (Brier 0.443)

Release height 60 mm (lowest point of the body above the table). Contact damping ratio: 0.2. Start: fixed (world heading).

Each cell: the most likely rest state and its probability at the nominal friction, then the range of that
probability across 0.65x to 1.5x friction. 200 simulated drops per cell.

## E1_tub mass low  (mass 108.5 g, CoM z 13.0 mm)

| start | most likely | p | across friction | others |
|---|---|---|---|---|
| nose down | upright | 0.58 | 0.58-0.58 | inverted 0.34, nose up 0.07, left side 0.01 |
| tail down | upright | 0.60 | 0.60-0.60 | inverted 0.26, nose down 0.06, left side 0.05, right side 0.03 |
| left side down | upright | 0.48 | 0.48-0.48 | inverted 0.40, right side 0.12 |
| right side down | upright | 0.47 | 0.47-0.47 | inverted 0.42, left side 0.10 |
| upside down | inverted | 1.00 | 1.00-1.00 |  |
| upside down, 45 to the left | inverted | 0.95 | 0.95-0.95 | upright 0.04, left side 0.01 |

## E1_tub mass high  (mass 108.5 g, CoM z 19.5 mm)

| start | most likely | p | across friction | others |
|---|---|---|---|---|
| nose down | inverted | 0.99 | 0.99-0.99 | upright 0.01, left side 0.01 |
| tail down | inverted | 0.97 | 0.97-0.97 | upright 0.03 |
| left side down | inverted | 0.74 | 0.74-0.74 | upright 0.17, right side 0.09 |
| right side down | inverted | 0.69 | 0.69-0.69 | upright 0.24, left side 0.06 |
| upside down | inverted | 1.00 | 1.00-1.00 |  |
| upside down, 45 to the left | inverted | 0.99 | 0.99-0.99 | left side 0.01, right side 0.01 |

## E2_dome mass low  (mass 118.9 g, CoM z 15.2 mm)

| start | most likely | p | across friction | others |
|---|---|---|---|---|
| nose down | upright | 0.80 | 0.80-0.80 | inverted 0.12, nose up 0.09 |
| tail down | upright | 0.66 | 0.66-0.66 | inverted 0.25, nose down 0.07, left side 0.01, right side 0.01 |
| left side down | inverted | 0.44 | 0.44-0.44 | upright 0.43, right side 0.12, nose down 0.01 |
| right side down | inverted | 0.47 | 0.47-0.47 | upright 0.41, left side 0.10, right side 0.02 |
| upside down | inverted | 0.81 | 0.81-0.81 | upright 0.13, right side 0.04, left side 0.03, nose down 0.01 |
| upside down, 45 to the left | inverted | 0.68 | 0.68-0.68 | upright 0.23, right side 0.06, left side 0.04 |

## E2_dome mass high  (mass 118.9 g, CoM z 21.9 mm)

| start | most likely | p | across friction | others |
|---|---|---|---|---|
| nose down | inverted | 0.57 | 0.57-0.57 | nose up 0.23, upright 0.20 |
| tail down | inverted | 0.71 | 0.71-0.71 | nose down 0.17, upright 0.11, left side 0.01 |
| left side down | inverted | 0.97 | 0.97-0.97 | right side 0.02, upright 0.01 |
| right side down | inverted | 0.96 | 0.96-0.96 | upright 0.01, left side 0.01, right side 0.01 |
| upside down | inverted | 0.98 | 0.98-0.98 | upright 0.01, nose up 0.01, nose down 0.01 |
| upside down, 45 to the left | inverted | 0.90 | 0.90-0.90 | left side 0.07, upright 0.01, nose up 0.01, nose down 0.01 |

## E3_tall mass low  (mass 140.1 g, CoM z 20.4 mm)

| start | most likely | p | across friction | others |
|---|---|---|---|---|
| nose down | upright | 0.71 | 0.71-0.71 | inverted 0.17, nose up 0.11, right side 0.01 |
| tail down | upright | 0.58 | 0.58-0.58 | nose down 0.14, inverted 0.12, right side 0.09, left side 0.07 |
| left side down | upright | 0.57 | 0.57-0.57 | right side 0.21, inverted 0.20, nose down 0.01 |
| right side down | upright | 0.56 | 0.56-0.56 | left side 0.24, inverted 0.20 |
| upside down | inverted | 0.83 | 0.83-0.83 | upright 0.16, left side 0.01 |
| upside down, 45 to the left | upright | 0.73 | 0.73-0.73 | inverted 0.20, right side 0.04, left side 0.03, nose down 0.01 |

## E3_tall mass high  (mass 140.1 g, CoM z 31.2 mm)

| start | most likely | p | across friction | others |
|---|---|---|---|---|
| nose down | inverted | 0.56 | 0.56-0.56 | upright 0.30, nose up 0.14, left side 0.01 |
| tail down | inverted | 0.41 | 0.41-0.41 | upright 0.29, right side 0.12, left side 0.10, nose down 0.09 |
| left side down | inverted | 0.56 | 0.56-0.56 | right side 0.24, upright 0.19, nose down 0.01 |
| right side down | inverted | 0.60 | 0.60-0.60 | left side 0.29, upright 0.10 |
| upside down | inverted | 0.95 | 0.95-0.95 | nose up 0.03, right side 0.02, left side 0.01 |
| upside down, 45 to the left | inverted | 0.52 | 0.52-0.52 | left side 0.20, nose down 0.12, nose up 0.07, upright 0.06, right side 0.06 |
