ZacharyShaver/FPVTank_Prototype/research/results/drop_predictions_6cm_hard_floor_ball2.md

# POST HOC (the 6 cm drops were seen): hard floor at 0.1 ms, bounce 0.39 (the PLA ball, IMG_1642), 6 cm

Release height 60 mm (lowest point of the body above the table). Contact damping ratio: 0.35. Start: fixed (world heading).

Each cell: the most likely rest state and its probability at the nominal friction, then the range of that
probability across 0.65x to 1.5x friction. 200 simulated drops per cell.

## E1_tub mass low  (mass 108.5 g, CoM z 13.0 mm)

| start | most likely | p | across friction | others |
|---|---|---|---|---|
| nose down | upright | 0.60 | 0.60-0.60 | inverted 0.33, nose up 0.07 |
| tail down | upright | 0.65 | 0.65-0.65 | inverted 0.28, nose down 0.07 |
| left side down | upright | 0.49 | 0.49-0.49 | inverted 0.47, right side 0.04 |
| right side down | upright | 0.47 | 0.47-0.47 | inverted 0.47, left side 0.04, nose up 0.01 |
| upside down | inverted | 1.00 | 1.00-1.00 |  |
| upside down, 45 to the left | inverted | 0.99 | 0.99-0.99 | upright 0.01 |

## E1_tub mass high  (mass 108.5 g, CoM z 19.5 mm)

| start | most likely | p | across friction | others |
|---|---|---|---|---|
| nose down | inverted | 0.99 | 0.99-0.99 | upright 0.01 |
| tail down | inverted | 0.97 | 0.97-0.97 | upright 0.03 |
| left side down | inverted | 0.67 | 0.67-0.67 | upright 0.23, right side 0.10 |
| right side down | inverted | 0.69 | 0.69-0.69 | upright 0.23, left side 0.09 |
| upside down | inverted | 1.00 | 1.00-1.00 |  |
| upside down, 45 to the left | inverted | 1.00 | 1.00-1.00 |  |

## E2_dome mass low  (mass 118.9 g, CoM z 15.2 mm)

| start | most likely | p | across friction | others |
|---|---|---|---|---|
| nose down | upright | 0.84 | 0.84-0.84 | nose up 0.15, right side 0.01 |
| tail down | upright | 0.80 | 0.80-0.80 | nose down 0.18, inverted 0.01, left side 0.01 |
| left side down | inverted | 0.48 | 0.48-0.48 | upright 0.46, right side 0.05, left side 0.01 |
| right side down | inverted | 0.51 | 0.51-0.51 | upright 0.47, left side 0.02, right side 0.01 |
| upside down | inverted | 0.99 | 0.99-0.99 | left side 0.01 |
| upside down, 45 to the left | inverted | 0.86 | 0.86-0.86 | right side 0.07, upright 0.06, left side 0.01 |

## E2_dome mass high  (mass 118.9 g, CoM z 21.9 mm)

| start | most likely | p | across friction | others |
|---|---|---|---|---|
| nose down | inverted | 0.56 | 0.56-0.56 | nose up 0.34, upright 0.10 |
| tail down | inverted | 0.69 | 0.69-0.69 | nose down 0.23, upright 0.07 |
| left side down | inverted | 0.87 | 0.87-0.87 | right side 0.09, upright 0.04, nose up 0.01 |
| right side down | inverted | 0.89 | 0.89-0.89 | left side 0.09, upright 0.03, right side 0.01 |
| upside down | inverted | 1.00 | 1.00-1.00 |  |
| upside down, 45 to the left | inverted | 1.00 | 1.00-1.00 |  |

## E3_tall mass low  (mass 140.1 g, CoM z 20.4 mm)

| start | most likely | p | across friction | others |
|---|---|---|---|---|
| nose down | nose up | 0.53 | 0.53-0.53 | upright 0.47 |
| tail down | upright | 0.49 | 0.49-0.49 | nose down 0.48, left side 0.01, right side 0.01 |
| left side down | upright | 0.51 | 0.51-0.51 | right side 0.49, nose up 0.01 |
| right side down | upright | 0.54 | 0.54-0.54 | left side 0.43, nose up 0.02, right side 0.01 |
| upside down | inverted | 0.99 | 0.99-0.99 | upright 0.01 |
| upside down, 45 to the left | upright | 0.82 | 0.82-0.82 | inverted 0.13, nose down 0.03, left side 0.01, nose up 0.01 |

## E3_tall mass high  (mass 140.1 g, CoM z 31.2 mm)

| start | most likely | p | across friction | others |
|---|---|---|---|---|
| nose down | inverted | 0.54 | 0.54-0.54 | upright 0.31, nose up 0.15 |
| tail down | inverted | 0.29 | 0.29-0.29 | upright 0.28, right side 0.15, nose down 0.14, left side 0.13 |
| left side down | inverted | 0.64 | 0.64-0.64 | right side 0.34, upright 0.01, left side 0.01, nose up 0.01, nose down 0.01 |
| right side down | inverted | 0.57 | 0.57-0.57 | left side 0.36, right side 0.02, upright 0.01, nose up 0.01, nose down 0.01 |
| upside down | inverted | 1.00 | 1.00-1.00 |  |
| upside down, 45 to the left | inverted | 0.59 | 0.59-0.59 | left side 0.18, nose down 0.12, upright 0.07, right side 0.03, nose up 0.01 |
