ZacharyShaver/FPVTank_Prototype/research/results/ball_restitution.md

# The PLA ball's restitution on the drop-test floor (IMG_1642.MOV)

12 drops by hand from 68-121 mm, impact at 1.15-1.54 m/s. `tumble/measure_ball.py`.

**First impact: restitution 0.392 mean (95% CI 0.325-0.46), median 0.389, sd 0.123, range 0.235-0.605.**

Later, slower bounces (0.22-0.93 m/s): median 0.781 over 23.

| video time (s) | release (mm) | impact speed (m/s) | restitution | blob-centroid check | later bounces (e @ m/s) | gravity by ball width (m/s^2) | rms (px) |
|---|---|---|---|---|---|---|---|
| 7.95 | 121.2 | 1.54 | 0.605 | 0.605 | 0.71 @ 0.93, 0.89 @ 0.67, 0.80 @ 0.60, 0.58 @ 0.47, 0.67 @ 0.28 | 10.32 | 0.46 |
| 14.38 | 105.3 | 1.44 | 0.378 | 0.379 | - | 10.23 | 0.33 |
| 17.54 | 104.9 | 1.43 | 0.501 | 0.501 | 0.74 @ 0.72, 0.86 @ 0.53, 0.90 @ 0.46, 0.78 @ 0.42, 0.73 @ 0.33, 0.78 @ 0.24 | 10.09 | 0.78 |
| 20.77 | 108.1 | 1.46 | 0.54 | 0.541 | 0.81 @ 0.79, 0.82 @ 0.64, 0.79 @ 0.53, 0.68 @ 0.42, 0.71 @ 0.28 | 10.28 | 0.98 |
| 32.8 | 86.5 | 1.3 | 0.235 | 0.235 | - | 9.82 | 0.3 |
| 37.33 | 94.6 | 1.36 | 0.236 | 0.234 | - | 10.1 | 0.19 |
| 39.64 | 75.2 | 1.21 | 0.252 | 0.252 | - | 11.02 | 0.48 |
| 41.99 | 84.1 | 1.28 | 0.399 | 0.399 | 0.69 @ 0.51, 0.81 @ 0.35, 0.90 @ 0.29, 0.84 @ 0.26, 0.86 @ 0.22 | 10.05 | 0.9 |
| 45.98 | 79.9 | 1.25 | 0.358 | 0.358 | - | 10.19 | 0.28 |
| 50.63 | 67.9 | 1.15 | 0.469 | 0.468 | 0.49 @ 0.54 | 9.98 | 0.33 |
| 52.98 | 86.7 | 1.3 | 0.296 | 0.294 | - | 10.54 | 0.3 |
| 55.16 | 69.2 | 1.16 | 0.432 | 0.436 | 0.56 @ 0.50 | 10.93 | 1.48 |
