ZacharyShaver/FPVTank_Prototype/research/results/drop_predictions_15cm_hard_floor_ball2.md

# Drop predictions at 15 cm: hard floor at a converged 0.1 ms step, bounce 0.39 (the PLA ball, measured: 12 drops, IMG_1642); committed before any 15 cm drop

Release height 150 mm (lowest point of the body above the table). Contact damping ratio: 0.35. Start: fixed (world heading).

Each cell: the most likely rest state and its probability at the nominal friction, then the range of that
probability across 0.65x to 1.5x friction. 200 simulated drops per cell.

## E1_tub mass low  (mass 108.5 g, CoM z 13.0 mm)

| start | most likely | p | across friction | others |
|---|---|---|---|---|
| nose down | upright | 0.57 | 0.57-0.57 | inverted 0.38, left side 0.02, nose up 0.02, right side 0.01 |
| tail down | upright | 0.54 | 0.54-0.54 | inverted 0.36, left side 0.05, right side 0.04, nose down 0.02 |
| left side down | inverted | 0.49 | 0.49-0.49 | upright 0.49, right side 0.01, left side 0.01 |
| right side down | upright | 0.53 | 0.53-0.53 | inverted 0.46, right side 0.01, left side 0.01 |
| upside down | inverted | 0.99 | 0.99-0.99 | upright 0.01 |
| upside down, 45 to the left | inverted | 0.81 | 0.81-0.81 | upright 0.17, left side 0.03 |

## E1_tub mass high  (mass 108.5 g, CoM z 19.5 mm)

| start | most likely | p | across friction | others |
|---|---|---|---|---|
| nose down | inverted | 0.97 | 0.97-0.97 | right side 0.01, left side 0.01, upright 0.01 |
| tail down | inverted | 0.87 | 0.87-0.87 | upright 0.08, left side 0.04, right side 0.01 |
| left side down | inverted | 0.63 | 0.63-0.63 | upright 0.35, left side 0.01 |
| right side down | inverted | 0.49 | 0.49-0.49 | upright 0.48, right side 0.01, left side 0.01 |
| upside down | inverted | 1.00 | 1.00-1.00 |  |
| upside down, 45 to the left | inverted | 0.96 | 0.96-0.96 | upright 0.03, left side 0.01 |

## E2_dome mass low  (mass 118.9 g, CoM z 15.2 mm)

| start | most likely | p | across friction | others |
|---|---|---|---|---|
| nose down | upright | 0.69 | 0.69-0.69 | inverted 0.24, nose up 0.06, right side 0.01 |
| tail down | upright | 0.55 | 0.55-0.55 | inverted 0.34, nose down 0.05, left side 0.04, right side 0.03 |
| left side down | upright | 0.53 | 0.53-0.53 | inverted 0.41, left side 0.06, right side 0.01, nose down 0.01 |
| right side down | upright | 0.66 | 0.66-0.66 | inverted 0.31, right side 0.02, left side 0.01, nose down 0.01 |
| upside down | inverted | 0.81 | 0.81-0.81 | upright 0.10, right side 0.06, left side 0.04 |
| upside down, 45 to the left | upright | 0.44 | 0.44-0.44 | inverted 0.41, right side 0.07, left side 0.06, nose down 0.01, nose up 0.01 |

## E2_dome mass high  (mass 118.9 g, CoM z 21.9 mm)

| start | most likely | p | across friction | others |
|---|---|---|---|---|
| nose down | inverted | 0.62 | 0.62-0.62 | upright 0.24, nose up 0.14 |
| tail down | inverted | 0.69 | 0.69-0.69 | upright 0.20, nose down 0.04, right side 0.04, left side 0.02, nose up 0.01 |
| left side down | inverted | 0.67 | 0.67-0.67 | upright 0.26, left side 0.05, nose down 0.02, right side 0.01, nose up 0.01 |
| right side down | inverted | 0.60 | 0.60-0.60 | upright 0.29, right side 0.09, nose up 0.01, nose down 0.01, left side 0.01 |
| upside down | inverted | 0.96 | 0.96-0.96 | upright 0.01, right side 0.01, nose down 0.01, left side 0.01 |
| upside down, 45 to the left | inverted | 0.69 | 0.69-0.69 | left side 0.15, upright 0.14, nose up 0.01, nose down 0.01 |

## E3_tall mass low  (mass 140.1 g, CoM z 20.4 mm)

| start | most likely | p | across friction | others |
|---|---|---|---|---|
| nose down | upright | 0.57 | 0.57-0.57 | inverted 0.34, right side 0.04, nose up 0.04, left side 0.01 |
| tail down | upright | 0.54 | 0.54-0.54 | inverted 0.23, right side 0.10, left side 0.10, nose down 0.04 |
| left side down | upright | 0.55 | 0.55-0.55 | inverted 0.34, right side 0.07, left side 0.02, nose up 0.01, nose down 0.01 |
| right side down | upright | 0.55 | 0.55-0.55 | inverted 0.34, left side 0.08, nose up 0.01, right side 0.01, nose down 0.01 |
| upside down | inverted | 0.76 | 0.76-0.76 | upright 0.20, right side 0.02, left side 0.01, nose down 0.01 |
| upside down, 45 to the left | upright | 0.83 | 0.83-0.83 | inverted 0.07, left side 0.07, nose down 0.03, right side 0.01 |

## E3_tall mass high  (mass 140.1 g, CoM z 31.2 mm)

| start | most likely | p | across friction | others |
|---|---|---|---|---|
| nose down | inverted | 0.59 | 0.59-0.59 | upright 0.33, nose up 0.05, left side 0.01, right side 0.01 |
| tail down | inverted | 0.48 | 0.48-0.48 | upright 0.29, right side 0.12, left side 0.10, nose down 0.01 |
| left side down | inverted | 0.64 | 0.64-0.64 | upright 0.23, right side 0.11, left side 0.01, nose down 0.01 |
| right side down | inverted | 0.60 | 0.60-0.60 | upright 0.24, left side 0.10, right side 0.03, nose down 0.02, nose up 0.01 |
| upside down | inverted | 0.92 | 0.92-0.92 | left side 0.04, right side 0.03, upright 0.01, nose up 0.01, nose down 0.01 |
| upside down, 45 to the left | inverted | 0.28 | 0.28-0.28 | upright 0.26, nose down 0.21, left side 0.17, nose up 0.05, right side 0.03 |
