ZacharyShaver/FPVTank_Prototype/research/results/drop_predictions_30cm_hard_floor_converged.md

# Post hoc: 30 cm, hard floor converged (0.1 ms), bounce 0.31

Release height 300 mm (lowest point of the body above the table). Contact damping ratio: 0.45. Start: fixed (world heading).

Each cell: the most likely rest state and its probability at the nominal friction, then the range of that
probability across 0.65x to 1.5x friction. 200 simulated drops per cell.

## E1_tub mass low  (mass 108.5 g, CoM z 13.0 mm)

| start | most likely | p | across friction | others |
|---|---|---|---|---|
| nose down | upright | 0.55 | 0.55-0.55 | inverted 0.35, left side 0.04, right side 0.04, nose up 0.01 |
| tail down | upright | 0.49 | 0.49-0.49 | inverted 0.39, left side 0.06, right side 0.06, nose down 0.01 |
| left side down | upright | 0.47 | 0.47-0.47 | inverted 0.47, right side 0.04, left side 0.03 |
| right side down | upright | 0.53 | 0.53-0.53 | inverted 0.42, right side 0.03, left side 0.02 |
| upside down | inverted | 0.93 | 0.93-0.93 | upright 0.03, right side 0.02, left side 0.01, nose up 0.01 |
| upside down, 45 to the left | inverted | 0.70 | 0.70-0.70 | upright 0.28, left side 0.01 |

## E1_tub mass high  (mass 108.5 g, CoM z 19.5 mm)

| start | most likely | p | across friction | others |
|---|---|---|---|---|
| nose down | inverted | 0.97 | 0.97-0.97 | upright 0.01, right side 0.01 |
| tail down | inverted | 0.78 | 0.78-0.78 | upright 0.15, left side 0.04, right side 0.04 |
| left side down | inverted | 0.57 | 0.57-0.57 | upright 0.40, left side 0.02, right side 0.01 |
| right side down | upright | 0.53 | 0.53-0.53 | inverted 0.43, left side 0.02, right side 0.02 |
| upside down | inverted | 0.97 | 0.97-0.97 | upright 0.01, right side 0.01, left side 0.01 |
| upside down, 45 to the left | inverted | 0.96 | 0.96-0.96 | upright 0.04 |

## E2_dome mass low  (mass 118.9 g, CoM z 15.2 mm)

| start | most likely | p | across friction | others |
|---|---|---|---|---|
| nose down | upright | 0.65 | 0.65-0.65 | inverted 0.29, nose up 0.04, left side 0.01, right side 0.01 |
| tail down | upright | 0.52 | 0.52-0.52 | inverted 0.37, left side 0.06, right side 0.04, nose down 0.02 |
| left side down | upright | 0.70 | 0.70-0.70 | inverted 0.23, right side 0.04, left side 0.03 |
| right side down | upright | 0.74 | 0.74-0.74 | inverted 0.23, right side 0.02, left side 0.01, nose down 0.01 |
| upside down | inverted | 0.60 | 0.60-0.60 | upright 0.31, right side 0.05, left side 0.04 |
| upside down, 45 to the left | upright | 0.47 | 0.47-0.47 | inverted 0.44, right side 0.05, left side 0.04, nose down 0.01 |

## E2_dome mass high  (mass 118.9 g, CoM z 21.9 mm)

| start | most likely | p | across friction | others |
|---|---|---|---|---|
| nose down | inverted | 0.64 | 0.64-0.64 | upright 0.27, nose up 0.09, right side 0.01 |
| tail down | inverted | 0.64 | 0.64-0.64 | upright 0.27, left side 0.04, nose down 0.03, right side 0.03 |
| left side down | inverted | 0.48 | 0.48-0.48 | upright 0.40, left side 0.09, nose down 0.02, right side 0.01 |
| right side down | inverted | 0.52 | 0.52-0.52 | upright 0.42, right side 0.05, nose down 0.01 |
| upside down | inverted | 0.72 | 0.72-0.72 | upright 0.18, nose down 0.05, left side 0.01, nose up 0.01, right side 0.01 |
| upside down, 45 to the left | inverted | 0.50 | 0.50-0.50 | upright 0.34, left side 0.14, nose down 0.01 |

## E3_tall mass low  (mass 140.1 g, CoM z 20.4 mm)

| start | most likely | p | across friction | others |
|---|---|---|---|---|
| nose down | upright | 0.41 | 0.41-0.41 | inverted 0.36, nose down 0.15, right side 0.04, left side 0.03, nose up 0.02 |
| tail down | upright | 0.46 | 0.46-0.46 | inverted 0.32, left side 0.09, right side 0.08, nose up 0.04, nose down 0.01 |
| left side down | upright | 0.54 | 0.54-0.54 | inverted 0.41, right side 0.06, nose down 0.01 |
| right side down | upright | 0.53 | 0.53-0.53 | inverted 0.41, left side 0.04, right side 0.01, nose up 0.01 |
| upside down | inverted | 0.50 | 0.50-0.50 | upright 0.38, left side 0.06, right side 0.04, nose up 0.01, nose down 0.01 |
| upside down, 45 to the left | upright | 0.83 | 0.83-0.83 | inverted 0.07, left side 0.04, right side 0.02, nose down 0.02, nose up 0.01 |

## E3_tall mass high  (mass 140.1 g, CoM z 31.2 mm)

| start | most likely | p | across friction | others |
|---|---|---|---|---|
| nose down | upright | 0.40 | 0.40-0.40 | inverted 0.39, nose down 0.12, left side 0.04, right side 0.04, nose up 0.04 |
| tail down | inverted | 0.40 | 0.40-0.40 | upright 0.34, left side 0.13, right side 0.09, nose up 0.03, nose down 0.01 |
| left side down | inverted | 0.48 | 0.48-0.48 | upright 0.34, right side 0.12, left side 0.05, nose down 0.01 |
| right side down | inverted | 0.45 | 0.45-0.45 | upright 0.33, left side 0.14, right side 0.07, nose down 0.01 |
| upside down | inverted | 0.64 | 0.64-0.64 | upright 0.10, left side 0.09, nose down 0.08, right side 0.07, nose up 0.04 |
| upside down, 45 to the left | upright | 0.44 | 0.44-0.44 | inverted 0.30, left side 0.16, nose down 0.06, nose up 0.03, right side 0.01 |
