ZacharyShaver/FPVTank_Prototype/research/results/drop_predictions_6cm_hard_floor_converged.md

# Post hoc: 6 cm, hard floor converged (0.1 ms), bounce 0.31

Release height 60 mm (lowest point of the body above the table). Contact damping ratio: 0.45. Start: fixed (world heading).

Each cell: the most likely rest state and its probability at the nominal friction, then the range of that
probability across 0.65x to 1.5x friction. 200 simulated drops per cell.

## E1_tub mass low  (mass 108.5 g, CoM z 13.0 mm)

| start | most likely | p | across friction | others |
|---|---|---|---|---|
| nose down | upright | 0.61 | 0.61-0.61 | inverted 0.31, nose up 0.07 |
| tail down | upright | 0.61 | 0.61-0.61 | inverted 0.28, nose down 0.11 |
| left side down | upright | 0.47 | 0.47-0.47 | inverted 0.43, right side 0.10, nose up 0.01 |
| right side down | inverted | 0.46 | 0.46-0.46 | upright 0.46, left side 0.09 |
| upside down | inverted | 1.00 | 1.00-1.00 |  |
| upside down, 45 to the left | inverted | 1.00 | 1.00-1.00 |  |

## E1_tub mass high  (mass 108.5 g, CoM z 19.5 mm)

| start | most likely | p | across friction | others |
|---|---|---|---|---|
| nose down | inverted | 0.99 | 0.99-0.99 | upright 0.01 |
| tail down | inverted | 0.97 | 0.97-0.97 | upright 0.03 |
| left side down | inverted | 0.69 | 0.69-0.69 | right side 0.20, upright 0.12 |
| right side down | inverted | 0.71 | 0.71-0.71 | left side 0.20, upright 0.08 |
| upside down | inverted | 1.00 | 1.00-1.00 |  |
| upside down, 45 to the left | inverted | 1.00 | 1.00-1.00 |  |

## E2_dome mass low  (mass 118.9 g, CoM z 15.2 mm)

| start | most likely | p | across friction | others |
|---|---|---|---|---|
| nose down | upright | 0.77 | 0.77-0.77 | nose up 0.23, right side 0.01 |
| tail down | upright | 0.76 | 0.76-0.76 | nose down 0.23, inverted 0.01, left side 0.01 |
| left side down | inverted | 0.47 | 0.47-0.47 | upright 0.42, right side 0.10 |
| right side down | inverted | 0.51 | 0.51-0.51 | upright 0.43, left side 0.06 |
| upside down | inverted | 1.00 | 1.00-1.00 |  |
| upside down, 45 to the left | inverted | 0.93 | 0.93-0.93 | right side 0.07, upright 0.01 |

## E2_dome mass high  (mass 118.9 g, CoM z 21.9 mm)

| start | most likely | p | across friction | others |
|---|---|---|---|---|
| nose down | inverted | 0.51 | 0.51-0.51 | nose up 0.48, upright 0.01 |
| tail down | inverted | 0.68 | 0.68-0.68 | nose down 0.30, upright 0.02 |
| left side down | inverted | 0.77 | 0.77-0.77 | right side 0.23, upright 0.01 |
| right side down | inverted | 0.73 | 0.73-0.73 | left side 0.26, upright 0.01 |
| upside down | inverted | 1.00 | 1.00-1.00 |  |
| upside down, 45 to the left | inverted | 1.00 | 1.00-1.00 |  |

## E3_tall mass low  (mass 140.1 g, CoM z 20.4 mm)

| start | most likely | p | across friction | others |
|---|---|---|---|---|
| nose down | nose up | 0.59 | 0.59-0.59 | upright 0.41 |
| tail down | nose down | 0.58 | 0.58-0.58 | upright 0.42 |
| left side down | right side | 0.57 | 0.57-0.57 | upright 0.43 |
| right side down | left side | 0.58 | 0.58-0.58 | upright 0.41, nose up 0.01 |
| upside down | inverted | 1.00 | 1.00-1.00 |  |
| upside down, 45 to the left | upright | 0.78 | 0.78-0.78 | inverted 0.20, nose down 0.01, left side 0.01 |

## E3_tall mass high  (mass 140.1 g, CoM z 31.2 mm)

| start | most likely | p | across friction | others |
|---|---|---|---|---|
| nose down | inverted | 0.49 | 0.49-0.49 | upright 0.28, nose up 0.23 |
| tail down | nose down | 0.38 | 0.38-0.38 | inverted 0.27, upright 0.23, right side 0.07, left side 0.06 |
| left side down | inverted | 0.54 | 0.54-0.54 | right side 0.46, nose down 0.01 |
| right side down | inverted | 0.53 | 0.53-0.53 | left side 0.47, nose up 0.01 |
| upside down | inverted | 1.00 | 1.00-1.00 |  |
| upside down, 45 to the left | inverted | 0.83 | 0.83-0.83 | nose down 0.07, right side 0.04, left side 0.03, nose up 0.01, upright 0.01 |
