ZacharyShaver/FPVTank_Prototype/research/results/drop_predictions_15cm_bounce_fit.md

# Drop predictions at 15 cm: start fixed, soft floor with the bounce fitted at 6 cm; committed before any 15 cm drop

Release height 150 mm (lowest point of the body above the table). Contact damping ratio: 0.2. Start: fixed (world heading).

Each cell: the most likely rest state and its probability at the nominal friction, then the range of that
probability across 0.65x to 1.5x friction. 200 simulated drops per cell.

## E1_tub mass low  (mass 108.5 g, CoM z 13.0 mm)

| start | most likely | p | across friction | others |
|---|---|---|---|---|
| nose down | upright | 0.54 | 0.54-0.57 | inverted 0.36, right side 0.04, left side 0.04, nose up 0.01 |
| tail down | upright | 0.51 | 0.49-0.56 | inverted 0.42, left side 0.04, right side 0.02, nose down 0.01 |
| left side down | upright | 0.49 | 0.48-0.49 | inverted 0.46, right side 0.03, left side 0.01 |
| right side down | upright | 0.55 | 0.47-0.55 | inverted 0.41, left side 0.04, right side 0.01 |
| upside down | inverted | 0.68 | 0.45-0.68 | upright 0.27, right side 0.03, left side 0.02, nose up 0.01 |
| upside down, 45 to the left | inverted | 0.56 | 0.41-0.66 | upright 0.43, right side 0.01 |

## E1_tub mass high  (mass 108.5 g, CoM z 19.5 mm)

| start | most likely | p | across friction | others |
|---|---|---|---|---|
| nose down | inverted | 0.95 | 0.94-0.95 | upright 0.05 |
| tail down | inverted | 0.86 | 0.85-0.92 | upright 0.12, right side 0.01, left side 0.01 |
| left side down | inverted | 0.56 | 0.51-0.56 | upright 0.42, right side 0.01, left side 0.01 |
| right side down | inverted | 0.51 | 0.47-0.51 | upright 0.47, left side 0.01, right side 0.01 |
| upside down | inverted | 0.58 | 0.52-0.81 | upright 0.35, right side 0.05, left side 0.02 |
| upside down, 45 to the left | inverted | 0.83 | 0.81-0.83 | upright 0.12, right side 0.04 |

## E2_dome mass low  (mass 118.9 g, CoM z 15.2 mm)

| start | most likely | p | across friction | others |
|---|---|---|---|---|
| nose down | upright | 0.71 | 0.66-0.75 | inverted 0.23, right side 0.03, nose up 0.02, left side 0.01 |
| tail down | upright | 0.57 | 0.56-0.57 | inverted 0.28, left side 0.07, right side 0.04, nose up 0.01, nose down 0.01 |
| left side down | upright | 0.60 | 0.54-0.68 | inverted 0.30, right side 0.05, left side 0.04 |
| right side down | upright | 0.67 | 0.62-0.71 | inverted 0.24, left side 0.05, right side 0.04 |
| upside down | upright | 0.72 | 0.71-0.77 | inverted 0.23, right side 0.03, left side 0.01, nose up 0.01 |
| upside down, 45 to the left | upright | 0.55 | 0.52-0.62 | inverted 0.37, left side 0.06, right side 0.01, nose down 0.01 |

## E2_dome mass high  (mass 118.9 g, CoM z 21.9 mm)

| start | most likely | p | across friction | others |
|---|---|---|---|---|
| nose down | inverted | 0.55 | 0.53-0.55 | upright 0.33, nose down 0.06, nose up 0.04, left side 0.02, right side 0.01 |
| tail down | inverted | 0.68 | 0.68-0.69 | upright 0.26, nose up 0.03, nose down 0.03, right side 0.01 |
| left side down | inverted | 0.58 | 0.58-0.71 | upright 0.34, left side 0.04, nose up 0.01, nose down 0.01, right side 0.01 |
| right side down | inverted | 0.65 | 0.56-0.67 | upright 0.29, right side 0.04, nose up 0.01, nose down 0.01 |
| upside down | upright | 0.55 | 0.53-0.55 | inverted 0.38, nose up 0.04, nose down 0.03, left side 0.01 |
| upside down, 45 to the left | upright | 0.52 | 0.45-0.52 | inverted 0.46, left side 0.01, nose up 0.01, nose down 0.01 |

## E3_tall mass low  (mass 140.1 g, CoM z 20.4 mm)

| start | most likely | p | across friction | others |
|---|---|---|---|---|
| nose down | upright | 0.56 | 0.51-0.65 | inverted 0.34, left side 0.04, right side 0.04, nose down 0.02, nose up 0.01 |
| tail down | upright | 0.55 | 0.54-0.67 | inverted 0.22, left side 0.12, right side 0.09, nose up 0.01, nose down 0.01 |
| left side down | inverted | 0.55 | 0.41-0.55 | upright 0.38, right side 0.06, left side 0.02 |
| right side down | inverted | 0.49 | 0.42-0.52 | upright 0.43, left side 0.04, right side 0.03, nose down 0.01 |
| upside down | upright | 0.70 | 0.70-0.73 | inverted 0.16, left side 0.05, right side 0.04, nose up 0.03, nose down 0.02 |
| upside down, 45 to the left | upright | 0.79 | 0.67-0.82 | inverted 0.10, left side 0.05, nose down 0.03, right side 0.03 |

## E3_tall mass high  (mass 140.1 g, CoM z 31.2 mm)

| start | most likely | p | across friction | others |
|---|---|---|---|---|
| nose down | upright | 0.36 | 0.34-0.41 | inverted 0.35, nose down 0.10, left side 0.09, right side 0.07, nose up 0.04 |
| tail down | upright | 0.29 | 0.27-0.29 | inverted 0.29, right side 0.16, left side 0.15, nose up 0.07, nose down 0.03 |
| left side down | upright | 0.64 | 0.45-0.64 | inverted 0.20, left side 0.07, right side 0.06, nose up 0.03 |
| right side down | upright | 0.63 | 0.40-0.65 | inverted 0.17, left side 0.10, right side 0.09, nose down 0.01, nose up 0.01 |
| upside down | upright | 0.40 | 0.28-0.47 | inverted 0.26, right side 0.10, nose up 0.10, nose down 0.08, left side 0.07 |
| upside down, 45 to the left | upright | 0.40 | 0.39-0.44 | inverted 0.27, left side 0.14, right side 0.10, nose down 0.07, nose up 0.02 |
