ZacharyShaver/FPVTank_Prototype/research/results/drop_predictions_15cm_dead.md

# Drop predictions at 15 cm: start fixed, dead soft contact (the control); committed before any 15 cm drop

Release height 150 mm (lowest point of the body above the table). Contact damping ratio: default (dead). Start: fixed (world heading).

Each cell: the most likely rest state and its probability at the nominal friction, then the range of that
probability across 0.65x to 1.5x friction. 200 simulated drops per cell.

## E1_tub mass low  (mass 108.5 g, CoM z 13.0 mm)

| start | most likely | p | across friction | others |
|---|---|---|---|---|
| nose down | upright | 0.45 | 0.45-0.45 | nose up 0.45, inverted 0.10 |
| tail down | upright | 0.47 | 0.46-0.47 | nose down 0.37, inverted 0.17 |
| left side down | right side | 0.97 | 0.97-0.97 | upright 0.02, inverted 0.01 |
| right side down | left side | 0.99 | 0.98-0.99 | inverted 0.01 |
| upside down | inverted | 1.00 | 1.00-1.00 |  |
| upside down, 45 to the left | inverted | 1.00 | 1.00-1.00 |  |

## E1_tub mass high  (mass 108.5 g, CoM z 19.5 mm)

| start | most likely | p | across friction | others |
|---|---|---|---|---|
| nose down | inverted | 0.99 | 0.99-0.99 | upright 0.01 |
| tail down | inverted | 0.96 | 0.96-0.96 | upright 0.04 |
| left side down | right side | 0.88 | 0.81-0.88 | inverted 0.12 |
| right side down | left side | 0.93 | 0.90-0.94 | inverted 0.07 |
| upside down | inverted | 1.00 | 1.00-1.00 |  |
| upside down, 45 to the left | inverted | 1.00 | 1.00-1.00 |  |

## E2_dome mass low  (mass 118.9 g, CoM z 15.2 mm)

| start | most likely | p | across friction | others |
|---|---|---|---|---|
| nose down | nose up | 0.59 | 0.59-0.59 | upright 0.41 |
| tail down | nose down | 0.56 | 0.54-0.59 | upright 0.44 |
| left side down | right side | 0.98 | 0.97-0.98 | inverted 0.02 |
| right side down | left side | 0.98 | 0.98-0.98 | inverted 0.01 |
| upside down | inverted | 1.00 | 1.00-1.00 |  |
| upside down, 45 to the left | inverted | 0.68 | 0.65-0.68 | right side 0.32 |

## E2_dome mass high  (mass 118.9 g, CoM z 21.9 mm)

| start | most likely | p | across friction | others |
|---|---|---|---|---|
| nose down | nose up | 0.94 | 0.92-0.96 | upright 0.04, inverted 0.02 |
| tail down | nose down | 0.77 | 0.76-0.79 | inverted 0.19, upright 0.04 |
| left side down | right side | 0.72 | 0.69-0.72 | inverted 0.28 |
| right side down | left side | 0.74 | 0.71-0.78 | inverted 0.26 |
| upside down | inverted | 1.00 | 1.00-1.00 |  |
| upside down, 45 to the left | inverted | 1.00 | 1.00-1.00 |  |

## E3_tall mass low  (mass 140.1 g, CoM z 20.4 mm)

| start | most likely | p | across friction | others |
|---|---|---|---|---|
| nose down | nose up | 0.70 | 0.68-0.73 | upright 0.25, right side 0.03, left side 0.02 |
| tail down | nose down | 0.73 | 0.69-0.81 | upright 0.27 |
| left side down | right side | 0.78 | 0.77-0.80 | upright 0.23 |
| right side down | left side | 0.81 | 0.81-0.84 | upright 0.18 |
| upside down | inverted | 1.00 | 1.00-1.00 |  |
| upside down, 45 to the left | upright | 0.59 | 0.55-0.64 | inverted 0.41 |

## E3_tall mass high  (mass 140.1 g, CoM z 31.2 mm)

| start | most likely | p | across friction | others |
|---|---|---|---|---|
| nose down | nose up | 0.88 | 0.79-0.98 | upright 0.04, right side 0.04, inverted 0.03, left side 0.02 |
| tail down | nose down | 0.92 | 0.86-0.99 | upright 0.04, inverted 0.04, right side 0.01 |
| left side down | right side | 0.61 | 0.61-0.67 | inverted 0.39 |
| right side down | left side | 0.59 | 0.58-0.63 | inverted 0.41 |
| upside down | inverted | 1.00 | 1.00-1.00 |  |
| upside down, 45 to the left | inverted | 0.93 | 0.92-0.93 | right side 0.07 |
