ZacharyShaver/FPVTank_Prototype/research/results/drop_predictions_15cm_hard_floor.md

# Drop predictions at 15 cm: start fixed, hard floor (time constant 0.002 s), bounce from the slow-motion measurement (restitution ~0.3); committed before any 15 cm drop

Release height 150 mm (lowest point of the body above the table). Contact damping ratio: 0.35. Start: fixed (world heading).

Each cell: the most likely rest state and its probability at the nominal friction, then the range of that
probability across 0.65x to 1.5x friction. 200 simulated drops per cell.

## E1_tub mass low  (mass 108.5 g, CoM z 13.0 mm)

| start | most likely | p | across friction | others |
|---|---|---|---|---|
| nose down | upright | 0.58 | 0.56-0.58 | inverted 0.37, nose up 0.03, left side 0.01, right side 0.01 |
| tail down | upright | 0.55 | 0.51-0.56 | inverted 0.33, left side 0.07, right side 0.04, nose down 0.01 |
| left side down | upright | 0.55 | 0.51-0.56 | inverted 0.42, left side 0.03, right side 0.01 |
| right side down | upright | 0.51 | 0.50-0.57 | inverted 0.47, right side 0.03 |
| upside down | inverted | 0.96 | 0.91-0.99 | upright 0.03, left side 0.01, nose up 0.01 |
| upside down, 45 to the left | inverted | 0.70 | 0.46-0.83 | upright 0.28, left side 0.01 |

## E1_tub mass high  (mass 108.5 g, CoM z 19.5 mm)

| start | most likely | p | across friction | others |
|---|---|---|---|---|
| nose down | inverted | 0.98 | 0.97-0.98 | upright 0.01, right side 0.01 |
| tail down | inverted | 0.84 | 0.84-0.87 | upright 0.11, left side 0.03, right side 0.02 |
| left side down | inverted | 0.53 | 0.53-0.59 | upright 0.45, left side 0.02 |
| right side down | upright | 0.49 | 0.41-0.49 | inverted 0.48, right side 0.01, left side 0.01 |
| upside down | inverted | 1.00 | 0.99-1.00 |  |
| upside down, 45 to the left | inverted | 0.95 | 0.77-0.97 | upright 0.04, left side 0.01 |

## E2_dome mass low  (mass 118.9 g, CoM z 15.2 mm)

| start | most likely | p | across friction | others |
|---|---|---|---|---|
| nose down | upright | 0.69 | 0.69-0.69 | inverted 0.24, nose up 0.05, right side 0.01 |
| tail down | upright | 0.55 | 0.55-0.56 | inverted 0.35, left side 0.04, right side 0.04, nose down 0.03 |
| left side down | upright | 0.54 | 0.46-0.65 | inverted 0.38, left side 0.06, right side 0.01, nose down 0.01 |
| right side down | upright | 0.67 | 0.57-0.76 | inverted 0.24, right side 0.09, left side 0.01 |
| upside down | inverted | 0.74 | 0.60-0.77 | upright 0.12, left side 0.09, right side 0.06 |
| upside down, 45 to the left | upright | 0.58 | 0.32-0.85 | inverted 0.33, left side 0.04, right side 0.04, nose down 0.01 |

## E2_dome mass high  (mass 118.9 g, CoM z 21.9 mm)

| start | most likely | p | across friction | others |
|---|---|---|---|---|
| nose down | inverted | 0.63 | 0.55-0.63 | upright 0.25, nose up 0.12, left side 0.01 |
| tail down | inverted | 0.67 | 0.67-0.73 | upright 0.23, nose down 0.04, right side 0.04, left side 0.01, nose up 0.01 |
| left side down | inverted | 0.61 | 0.56-0.61 | upright 0.32, left side 0.07, nose down 0.01 |
| right side down | inverted | 0.57 | 0.52-0.57 | upright 0.35, right side 0.07, left side 0.01 |
| upside down | inverted | 0.94 | 0.90-0.94 | upright 0.03, left side 0.01, right side 0.01, nose down 0.01 |
| upside down, 45 to the left | inverted | 0.64 | 0.32-0.73 | upright 0.23, left side 0.12, nose down 0.02, nose up 0.01 |

## E3_tall mass low  (mass 140.1 g, CoM z 20.4 mm)

| start | most likely | p | across friction | others |
|---|---|---|---|---|
| nose down | upright | 0.57 | 0.46-0.61 | inverted 0.34, right side 0.04, nose up 0.03, left side 0.01, nose down 0.01 |
| tail down | upright | 0.52 | 0.43-0.70 | inverted 0.24, left side 0.12, right side 0.07, nose down 0.05 |
| left side down | upright | 0.62 | 0.53-0.72 | inverted 0.27, right side 0.06, nose up 0.03, left side 0.01, nose down 0.01 |
| right side down | upright | 0.66 | 0.52-0.74 | inverted 0.24, left side 0.06, right side 0.03, nose up 0.02, nose down 0.01 |
| upside down | inverted | 0.57 | 0.46-0.76 | upright 0.34, right side 0.04, left side 0.03, nose up 0.01, nose down 0.01 |
| upside down, 45 to the left | upright | 0.87 | 0.79-0.87 | left side 0.10, inverted 0.03, nose down 0.01 |

## E3_tall mass high  (mass 140.1 g, CoM z 31.2 mm)

| start | most likely | p | across friction | others |
|---|---|---|---|---|
| nose down | inverted | 0.59 | 0.53-0.59 | upright 0.33, nose up 0.04, right side 0.03, left side 0.01, nose down 0.01 |
| tail down | inverted | 0.47 | 0.47-0.48 | upright 0.30, left side 0.10, right side 0.10, nose down 0.01, nose up 0.01 |
| left side down | inverted | 0.61 | 0.53-0.61 | upright 0.19, left side 0.07, nose down 0.07, right side 0.06, nose up 0.01 |
| right side down | inverted | 0.57 | 0.47-0.57 | upright 0.20, right side 0.08, left side 0.07, nose down 0.06, nose up 0.01 |
| upside down | inverted | 0.92 | 0.80-0.92 | upright 0.03, right side 0.03, left side 0.01, nose down 0.01, nose up 0.01 |
| upside down, 45 to the left | upright | 0.34 | 0.14-0.50 | nose down 0.23, inverted 0.21, left side 0.14, nose up 0.07, right side 0.01 |
