ZacharyShaver/FPVTank_Prototype/research/results/drop_predictions_30cm_bounce_measured.md

# Drop predictions at 30 cm: start fixed, bounce from the slow-motion measurement (restitution ~0.3, preliminary; damping ratio 0.48); committed before any 30 cm data were seen

Release height 300 mm (lowest point of the body above the table). Contact damping ratio: 0.48. Start: fixed (world heading).

Each cell: the most likely rest state and its probability at the nominal friction, then the range of that
probability across 0.65x to 1.5x friction. 200 simulated drops per cell.

## E1_tub mass low  (mass 108.5 g, CoM z 13.0 mm)

| start | most likely | p | across friction | others |
|---|---|---|---|---|
| nose down | upright | 0.51 | 0.50-0.56 | inverted 0.34, nose up 0.09, right side 0.04, left side 0.03 |
| tail down | upright | 0.54 | 0.54-0.54 | inverted 0.29, nose down 0.12, left side 0.03, right side 0.03 |
| left side down | right side | 0.40 | 0.35-0.41 | upright 0.34, inverted 0.26 |
| right side down | left side | 0.39 | 0.36-0.41 | upright 0.32, inverted 0.30 |
| upside down | inverted | 0.66 | 0.66-0.77 | upright 0.34, right side 0.01 |
| upside down, 45 to the left | inverted | 0.97 | 0.93-0.98 | upright 0.03 |

## E1_tub mass high  (mass 108.5 g, CoM z 19.5 mm)

| start | most likely | p | across friction | others |
|---|---|---|---|---|
| nose down | inverted | 0.95 | 0.94-0.95 | upright 0.05 |
| tail down | inverted | 0.92 | 0.91-0.94 | upright 0.09 |
| left side down | inverted | 0.71 | 0.68-0.71 | right side 0.17, upright 0.12 |
| right side down | inverted | 0.71 | 0.68-0.71 | left side 0.16, upright 0.13 |
| upside down | inverted | 0.99 | 0.99-0.99 | right side 0.01 |
| upside down, 45 to the left | inverted | 1.00 | 0.99-1.00 |  |

## E2_dome mass low  (mass 118.9 g, CoM z 15.2 mm)

| start | most likely | p | across friction | others |
|---|---|---|---|---|
| nose down | upright | 0.71 | 0.71-0.72 | nose up 0.14, inverted 0.12, right side 0.02, left side 0.01 |
| tail down | upright | 0.57 | 0.54-0.58 | inverted 0.20, nose down 0.11, right side 0.06, left side 0.05 |
| left side down | right side | 0.38 | 0.36-0.40 | inverted 0.33, upright 0.29 |
| right side down | inverted | 0.39 | 0.38-0.39 | left side 0.34, upright 0.28 |
| upside down | inverted | 0.90 | 0.79-0.91 | upright 0.07, right side 0.03, left side 0.01 |
| upside down, 45 to the left | inverted | 0.60 | 0.60-0.68 | upright 0.24, right side 0.09, left side 0.05, nose down 0.01 |

## E2_dome mass high  (mass 118.9 g, CoM z 21.9 mm)

| start | most likely | p | across friction | others |
|---|---|---|---|---|
| nose down | inverted | 0.59 | 0.58-0.62 | upright 0.23, nose up 0.18 |
| tail down | inverted | 0.60 | 0.58-0.68 | upright 0.20, nose down 0.14, right side 0.03, nose up 0.03, left side 0.01 |
| left side down | inverted | 0.85 | 0.84-0.89 | right side 0.10, upright 0.03, left side 0.02 |
| right side down | inverted | 0.85 | 0.84-0.87 | left side 0.09, upright 0.04, right side 0.02 |
| upside down | inverted | 0.97 | 0.96-0.97 | nose down 0.01, nose up 0.01, upright 0.01 |
| upside down, 45 to the left | inverted | 0.36 | 0.35-0.43 | upright 0.34, left side 0.30 |

## E3_tall mass low  (mass 140.1 g, CoM z 20.4 mm)

| start | most likely | p | across friction | others |
|---|---|---|---|---|
| nose down | upright | 0.40 | 0.29-0.47 | inverted 0.20, right side 0.13, nose up 0.11, left side 0.09, nose down 0.07 |
| tail down | upright | 0.40 | 0.33-0.54 | left side 0.19, right side 0.17, nose down 0.12, inverted 0.11, nose up 0.01 |
| left side down | upright | 0.43 | 0.43-0.45 | inverted 0.33, right side 0.20, left side 0.04 |
| right side down | upright | 0.41 | 0.38-0.42 | inverted 0.34, left side 0.23, right side 0.02 |
| upside down | inverted | 0.93 | 0.90-0.94 | upright 0.07 |
| upside down, 45 to the left | upright | 0.77 | 0.73-0.82 | inverted 0.17, right side 0.05, left side 0.01 |

## E3_tall mass high  (mass 140.1 g, CoM z 31.2 mm)

| start | most likely | p | across friction | others |
|---|---|---|---|---|
| nose down | inverted | 0.24 | 0.24-0.30 | nose up 0.23, nose down 0.15, right side 0.14, upright 0.12, left side 0.12 |
| tail down | nose down | 0.23 | 0.20-0.27 | right side 0.23, inverted 0.23, left side 0.21, upright 0.06, nose up 0.04 |
| left side down | inverted | 0.30 | 0.27-0.33 | upright 0.30, right side 0.27, left side 0.13 |
| right side down | left side | 0.30 | 0.29-0.33 | inverted 0.27, upright 0.24, right side 0.19 |
| upside down | inverted | 0.96 | 0.96-0.98 | left side 0.03, right side 0.01 |
| upside down, 45 to the left | left side | 0.35 | 0.12-0.48 | inverted 0.33, upright 0.25, right side 0.05, nose up 0.01, nose down 0.01 |
