ZacharyShaver/FPVTank_Prototype/research/results/posthoc_sweep_v2.md

# Post hoc: the sweep again, with a 1.5 mm printed cover, dead contact and with bounce

Top 6 of 400 designs (200 drops each) rerun at 1000 drops; the tub (66/0.08/65.75/0) at 1000 drops for reference. top, round, width, dz in mm except round (the share of the half-width the top curve takes).

## weightless shell, dead (as the sweep ran)

Tub: P(upright) 0.401

| top | round | width | dz | P(upright), 1000 drops | mass g | CoM z |
|---|---|---|---|---|---|---|
| 211 | 0.13 | 169 | -6 | 0.750 | 3304 | 40.9 |
| 196 | 0.19 | 162 | -19 | 0.739 | 3304 | 37.4 |
| 191 | 0.39 | 163 | -8 | 0.698 | 3304 | 40.5 |
| 204 | 0.23 | 144 | -6 | 0.674 | 3304 | 41.0 |
| 219 | 0.10 | 97 | -14 | 0.660 | 3304 | 38.7 |
| 209 | 0.12 | 138 | 16 | 0.625 | 3304 | 47.0 |

Correlation of each setting with P(upright) over the 400: {'top': 0.67, 'round': -0.21, 'width': 0.17, 'dz': -0.33}

## cover, dead

Tub: P(upright) 0.401

| top | round | width | dz | P(upright), 1000 drops | mass g | CoM z |
|---|---|---|---|---|---|---|
| 211 | 0.13 | 169 | -6 | 0.649 | 3755 | 56.1 |
| 196 | 0.19 | 162 | -19 | 0.617 | 3696 | 50.2 |
| 191 | 0.39 | 163 | -8 | 0.556 | 3654 | 51.2 |
| 219 | 0.43 | 156 | 1 | 0.554 | 3689 | 55.8 |
| 219 | 0.10 | 97 | -14 | 0.527 | 3607 | 50.7 |
| 211 | 0.75 | 133 | 11 | 0.469 | 3590 | 54.7 |

Correlation of each setting with P(upright) over the 400: {'top': 0.46, 'round': -0.17, 'width': 0.13, 'dz': -0.43}

## cover, bounce

Tub: P(upright) 0.401

| top | round | width | dz | P(upright), 1000 drops | mass g | CoM z |
|---|---|---|---|---|---|---|
| 211 | 0.13 | 169 | -6 | 0.671 | 3755 | 56.1 |
| 196 | 0.19 | 162 | -19 | 0.652 | 3696 | 50.2 |
| 191 | 0.39 | 163 | -8 | 0.605 | 3654 | 51.2 |
| 219 | 0.43 | 156 | 1 | 0.589 | 3689 | 55.8 |
| 193 | 0.31 | 175 | 19 | 0.575 | 3696 | 59.0 |
| 204 | 0.23 | 144 | -6 | 0.564 | 3663 | 53.1 |

Correlation of each setting with P(upright) over the 400: {'top': 0.5, 'round': -0.19, 'width': 0.16, 'dz': -0.4}
