ZacharyShaver/FPVTank_Prototype/research/results/drop_predictions_30cm_dead.md

# Drop predictions at 30 cm: start fixed, dead contact (the control for the bounce); committed before any 30 cm data were seen

Release height 300 mm (lowest point of the body above the table). Contact damping ratio: default (dead). Start: fixed (world heading).

Each cell: the most likely rest state and its probability at the nominal friction, then the range of that
probability across 0.65x to 1.5x friction. 200 simulated drops per cell.

## E1_tub mass low  (mass 108.5 g, CoM z 13.0 mm)

| start | most likely | p | across friction | others |
|---|---|---|---|---|
| nose down | upright | 0.47 | 0.46-0.47 | nose up 0.43, inverted 0.10 |
| tail down | upright | 0.44 | 0.44-0.46 | nose down 0.35, inverted 0.21 |
| left side down | right side | 0.98 | 0.97-0.98 | upright 0.01, inverted 0.01 |
| right side down | left side | 0.99 | 0.98-0.99 | upright 0.01, inverted 0.01 |
| upside down | inverted | 1.00 | 1.00-1.00 |  |
| upside down, 45 to the left | inverted | 1.00 | 1.00-1.00 |  |

## E1_tub mass high  (mass 108.5 g, CoM z 19.5 mm)

| start | most likely | p | across friction | others |
|---|---|---|---|---|
| nose down | inverted | 0.99 | 0.99-0.99 | upright 0.01 |
| tail down | inverted | 0.96 | 0.96-0.96 | upright 0.04 |
| left side down | right side | 0.88 | 0.84-0.88 | inverted 0.12 |
| right side down | left side | 0.93 | 0.93-0.94 | inverted 0.07 |
| upside down | inverted | 1.00 | 1.00-1.00 |  |
| upside down, 45 to the left | inverted | 1.00 | 1.00-1.00 |  |

## E2_dome mass low  (mass 118.9 g, CoM z 15.2 mm)

| start | most likely | p | across friction | others |
|---|---|---|---|---|
| nose down | nose up | 0.59 | 0.59-0.60 | upright 0.41 |
| tail down | nose down | 0.54 | 0.52-0.58 | upright 0.46 |
| left side down | right side | 0.97 | 0.97-0.98 | inverted 0.03 |
| right side down | left side | 0.98 | 0.98-0.98 | inverted 0.01 |
| upside down | inverted | 1.00 | 1.00-1.00 |  |
| upside down, 45 to the left | inverted | 0.71 | 0.69-0.71 | right side 0.28 |

## E2_dome mass high  (mass 118.9 g, CoM z 21.9 mm)

| start | most likely | p | across friction | others |
|---|---|---|---|---|
| nose down | nose up | 0.82 | 0.79-0.86 | upright 0.12, inverted 0.05 |
| tail down | nose down | 0.70 | 0.70-0.73 | inverted 0.20, upright 0.09 |
| left side down | right side | 0.71 | 0.69-0.71 | inverted 0.29 |
| right side down | left side | 0.77 | 0.77-0.79 | inverted 0.23 |
| upside down | inverted | 1.00 | 1.00-1.00 |  |
| upside down, 45 to the left | inverted | 1.00 | 1.00-1.00 |  |

## E3_tall mass low  (mass 140.1 g, CoM z 20.4 mm)

| start | most likely | p | across friction | others |
|---|---|---|---|---|
| nose down | nose up | 0.66 | 0.63-0.69 | upright 0.23, right side 0.07, left side 0.03 |
| tail down | nose down | 0.75 | 0.62-0.81 | upright 0.25 |
| left side down | right side | 0.78 | 0.78-0.79 | upright 0.23 |
| right side down | left side | 0.81 | 0.81-0.84 | upright 0.18 |
| upside down | inverted | 1.00 | 1.00-1.00 |  |
| upside down, 45 to the left | upright | 0.60 | 0.57-0.65 | inverted 0.40 |

## E3_tall mass high  (mass 140.1 g, CoM z 31.2 mm)

| start | most likely | p | across friction | others |
|---|---|---|---|---|
| nose down | nose up | 0.69 | 0.59-0.91 | inverted 0.14, right side 0.09, upright 0.04, left side 0.04 |
| tail down | nose down | 0.87 | 0.78-0.97 | inverted 0.08, upright 0.04, left side 0.01, right side 0.01 |
| left side down | right side | 0.61 | 0.60-0.68 | inverted 0.38, upright 0.01 |
| right side down | left side | 0.58 | 0.58-0.64 | inverted 0.41, upright 0.01 |
| upside down | inverted | 1.00 | 1.00-1.00 |  |
| upside down, 45 to the left | inverted | 0.93 | 0.92-0.93 | right side 0.07, upright 0.01 |
