ZacharyShaver/FPVTank_Prototype/research/results/drop_predictions_30cm_bounce_fit.md

# Drop predictions at 30 cm: start fixed, bounce fitted to the 6 cm drops (damping ratio 0.2, restitution 0.56); committed before any 30 cm data were seen

Release height 300 mm (lowest point of the body above the table). Contact damping ratio: 0.2. Start: fixed (world heading).

Each cell: the most likely rest state and its probability at the nominal friction, then the range of that
probability across 0.65x to 1.5x friction. 200 simulated drops per cell.

## E1_tub mass low  (mass 108.5 g, CoM z 13.0 mm)

| start | most likely | p | across friction | others |
|---|---|---|---|---|
| nose down | upright | 0.55 | 0.54-0.56 | inverted 0.40, left side 0.03, right side 0.03 |
| tail down | upright | 0.55 | 0.53-0.65 | inverted 0.38, right side 0.06, left side 0.02 |
| left side down | upright | 0.48 | 0.48-0.51 | inverted 0.47, right side 0.03, left side 0.01 |
| right side down | upright | 0.51 | 0.48-0.51 | inverted 0.43, left side 0.03, right side 0.03 |
| upside down | upright | 0.50 | 0.40-0.62 | inverted 0.47, left side 0.02, right side 0.01 |
| upside down, 45 to the left | inverted | 0.48 | 0.41-0.48 | upright 0.48, right side 0.03, left side 0.01, nose up 0.01 |

## E1_tub mass high  (mass 108.5 g, CoM z 19.5 mm)

| start | most likely | p | across friction | others |
|---|---|---|---|---|
| nose down | inverted | 0.60 | 0.51-0.60 | upright 0.38, left side 0.02, right side 0.01 |
| tail down | inverted | 0.70 | 0.67-0.73 | upright 0.28, left side 0.01, right side 0.01 |
| left side down | inverted | 0.62 | 0.62-0.64 | upright 0.34, right side 0.03 |
| right side down | inverted | 0.66 | 0.60-0.66 | upright 0.33, left side 0.01 |
| upside down | inverted | 0.73 | 0.61-0.73 | upright 0.27 |
| upside down, 45 to the left | inverted | 0.63 | 0.62-0.68 | upright 0.34, right side 0.03 |

## E2_dome mass low  (mass 118.9 g, CoM z 15.2 mm)

| start | most likely | p | across friction | others |
|---|---|---|---|---|
| nose down | upright | 0.58 | 0.58-0.68 | inverted 0.28, left side 0.06, right side 0.06, nose up 0.01, nose down 0.01 |
| tail down | upright | 0.58 | 0.54-0.60 | inverted 0.29, left side 0.07, right side 0.06, nose up 0.01 |
| left side down | upright | 0.66 | 0.64-0.70 | inverted 0.26, right side 0.04, left side 0.04, nose down 0.01 |
| right side down | upright | 0.62 | 0.55-0.63 | inverted 0.26, right side 0.06, left side 0.05, nose down 0.01 |
| upside down | upright | 0.62 | 0.62-0.70 | inverted 0.30, right side 0.04, left side 0.04 |
| upside down, 45 to the left | upright | 0.61 | 0.61-0.77 | inverted 0.29, right side 0.05, left side 0.04, nose down 0.01 |

## E2_dome mass high  (mass 118.9 g, CoM z 21.9 mm)

| start | most likely | p | across friction | others |
|---|---|---|---|---|
| nose down | inverted | 0.49 | 0.48-0.64 | upright 0.47, nose down 0.01, right side 0.01, nose up 0.01 |
| tail down | inverted | 0.62 | 0.57-0.62 | upright 0.29, nose up 0.04, nose down 0.03, left side 0.01, right side 0.01 |
| left side down | inverted | 0.60 | 0.56-0.63 | upright 0.34, left side 0.03, nose up 0.01, nose down 0.01, right side 0.01 |
| right side down | inverted | 0.53 | 0.47-0.61 | upright 0.41, right side 0.05, left side 0.01, nose up 0.01, nose down 0.01 |
| upside down | inverted | 0.48 | 0.46-0.52 | upright 0.42, nose up 0.04, nose down 0.03, left side 0.01, right side 0.01 |
| upside down, 45 to the left | inverted | 0.55 | 0.49-0.58 | upright 0.41, left side 0.03, right side 0.01, nose up 0.01 |

## E3_tall mass low  (mass 140.1 g, CoM z 20.4 mm)

| start | most likely | p | across friction | others |
|---|---|---|---|---|
| nose down | upright | 0.73 | 0.65-0.78 | right side 0.08, inverted 0.07, left side 0.06, nose up 0.04, nose down 0.02 |
| tail down | upright | 0.72 | 0.69-0.78 | inverted 0.11, right side 0.06, left side 0.05, nose down 0.04, nose up 0.01 |
| left side down | upright | 0.68 | 0.65-0.80 | inverted 0.15, right side 0.07, left side 0.06, nose down 0.03, nose up 0.01 |
| right side down | upright | 0.70 | 0.65-0.75 | inverted 0.17, right side 0.09, left side 0.04, nose down 0.01 |
| upside down | upright | 0.72 | 0.66-0.80 | inverted 0.10, right side 0.08, left side 0.04, nose down 0.04, nose up 0.02 |
| upside down, 45 to the left | upright | 0.71 | 0.66-0.84 | inverted 0.10, right side 0.07, left side 0.06, nose up 0.03, nose down 0.03 |

## E3_tall mass high  (mass 140.1 g, CoM z 31.2 mm)

| start | most likely | p | across friction | others |
|---|---|---|---|---|
| nose down | inverted | 0.35 | 0.31-0.43 | upright 0.33, left side 0.10, right side 0.10, nose up 0.06, nose down 0.06 |
| tail down | upright | 0.34 | 0.31-0.34 | inverted 0.32, right side 0.13, left side 0.10, nose down 0.07, nose up 0.04 |
| left side down | upright | 0.36 | 0.30-0.36 | inverted 0.34, left side 0.18, right side 0.07, nose down 0.04, nose up 0.01 |
| right side down | upright | 0.41 | 0.30-0.41 | inverted 0.35, right side 0.15, left side 0.05, nose up 0.02, nose down 0.01 |
| upside down | inverted | 0.40 | 0.32-0.51 | upright 0.27, left side 0.10, nose up 0.10, right side 0.07, nose down 0.06 |
| upside down, 45 to the left | inverted | 0.36 | 0.35-0.37 | upright 0.33, right side 0.09, left side 0.08, nose down 0.07, nose up 0.06 |
