ZacharyShaver/FPVTank_Prototype/research/results/posthoc_bounce_fit.md

# Post hoc, exploratory: contact bounce vs the 181 drops (start-fixed model)

| damping ratio | restitution | Brier (naive 1.293) | top state right | end drops: stays on end, pred / seen | side drops: stays on side | end drops: upright |
|---|---|---|---|---|---|---|
| default | 0.127 | 0.861 | 0.431 | 0.61 / 0.09 | 0.84 / 0.16 | 0.19 / 0.43 |
| 0.6 | 0.236 | 0.704 | 0.486 | 0.51 / 0.09 | 0.70 / 0.16 | 0.23 / 0.43 |
| 0.4 | 0.348 | 0.529 | 0.575 | 0.36 / 0.09 | 0.47 / 0.16 | 0.30 / 0.43 |
| 0.3 | 0.435 | 0.465 | 0.691 | 0.24 / 0.09 | 0.30 / 0.16 | 0.37 / 0.43 |
| 0.2 | 0.555 | 0.443 | 0.696 | 0.10 / 0.09 | 0.14 / 0.16 | 0.41 / 0.43 |
| 0.1 | 0.724 | 0.575 | 0.586 | 0.03 / 0.09 | 0.05 / 0.16 | 0.41 / 0.43 |
