ZacharyShaver/FPVTank_Prototype/research/results/drop_predictions_30cm.md

# Drop predictions at 30 cm (model unchanged except the release height)

Release height 300 mm (lowest point of the body above the table).

Each cell: the most likely rest state and its probability at the nominal friction, then the range of that
probability across 0.65x to 1.5x friction. 200 simulated drops per cell.

## E1_tub mass low  (mass 108.5 g, CoM z 13.0 mm)

| start | most likely | p | across friction | others |
|---|---|---|---|---|
| nose down | upright | 0.29 | 0.29-0.33 | left side 0.22, right side 0.20, inverted 0.16, nose up 0.09, nose down 0.04 |
| tail down | upright | 0.32 | 0.30-0.32 | left side 0.21, right side 0.17, inverted 0.14, nose up 0.10, nose down 0.06 |
| left side down | upright | 0.35 | 0.34-0.35 | inverted 0.20, left side 0.17, right side 0.17, nose up 0.07, nose down 0.04 |
| right side down | upright | 0.33 | 0.33-0.34 | right side 0.21, left side 0.18, inverted 0.15, nose up 0.09, nose down 0.04 |
| upside down | inverted | 1.00 | 1.00-1.00 |  |
| upside down, 45 to the left | inverted | 1.00 | 1.00-1.00 |  |

## E1_tub mass high  (mass 108.5 g, CoM z 19.5 mm)

| start | most likely | p | across friction | others |
|---|---|---|---|---|
| nose down | inverted | 0.72 | 0.72-0.76 | right side 0.14, left side 0.12, upright 0.01 |
| tail down | inverted | 0.76 | 0.76-0.81 | left side 0.11, right side 0.11, upright 0.03 |
| left side down | inverted | 0.77 | 0.77-0.81 | left side 0.10, right side 0.09, upright 0.04 |
| right side down | inverted | 0.75 | 0.75-0.78 | left side 0.12, right side 0.10, upright 0.04 |
| upside down | inverted | 1.00 | 1.00-1.00 |  |
| upside down, 45 to the left | inverted | 1.00 | 1.00-1.00 |  |

## E2_dome mass low  (mass 118.9 g, CoM z 15.2 mm)

| start | most likely | p | across friction | others |
|---|---|---|---|---|
| nose down | upright | 0.34 | 0.29-0.34 | left side 0.23, right side 0.20, nose up 0.10, nose down 0.09, inverted 0.05 |
| tail down | upright | 0.34 | 0.29-0.34 | left side 0.20, right side 0.18, nose up 0.12, nose down 0.10, inverted 0.07 |
| left side down | upright | 0.39 | 0.34-0.39 | left side 0.17, right side 0.16, nose up 0.12, inverted 0.09, nose down 0.07 |
| right side down | upright | 0.34 | 0.32-0.36 | left side 0.20, right side 0.18, nose up 0.12, nose down 0.10, inverted 0.04 |
| upside down | inverted | 1.00 | 1.00-1.00 |  |
| upside down, 45 to the left | inverted | 0.81 | 0.76-0.81 | right side 0.11, left side 0.06, upright 0.03 |

## E2_dome mass high  (mass 118.9 g, CoM z 21.9 mm)

| start | most likely | p | across friction | others |
|---|---|---|---|---|
| nose down | inverted | 0.59 | 0.59-0.61 | nose up 0.13, nose down 0.12, left side 0.07, right side 0.07, upright 0.01 |
| tail down | inverted | 0.56 | 0.56-0.60 | nose up 0.17, nose down 0.11, right side 0.07, left side 0.06, upright 0.03 |
| left side down | inverted | 0.58 | 0.56-0.60 | nose up 0.14, nose down 0.12, left side 0.07, upright 0.04, right side 0.04 |
| right side down | inverted | 0.56 | 0.56-0.59 | nose down 0.14, nose up 0.14, left side 0.07, right side 0.07, upright 0.03 |
| upside down | inverted | 1.00 | 1.00-1.00 |  |
| upside down, 45 to the left | inverted | 0.99 | 0.99-0.99 | nose down 0.01 |

## E3_tall mass low  (mass 140.1 g, CoM z 20.4 mm)

| start | most likely | p | across friction | others |
|---|---|---|---|---|
| nose down | left side | 0.28 | 0.28-0.30 | right side 0.28, nose down 0.20, upright 0.16, nose up 0.07 |
| tail down | left side | 0.27 | 0.22-0.27 | right side 0.27, nose down 0.21, upright 0.15, nose up 0.09 |
| left side down | right side | 0.27 | 0.23-0.28 | left side 0.23, nose down 0.21, upright 0.21, nose up 0.09 |
| right side down | left side | 0.28 | 0.26-0.28 | right side 0.24, nose down 0.21, upright 0.17, nose up 0.09 |
| upside down | inverted | 1.00 | 1.00-1.00 |  |
| upside down, 45 to the left | upright | 0.58 | 0.46-0.72 | inverted 0.41, right side 0.01 |

## E3_tall mass high  (mass 140.1 g, CoM z 31.2 mm)

| start | most likely | p | across friction | others |
|---|---|---|---|---|
| nose down | left side | 0.30 | 0.28-0.30 | right side 0.23, nose down 0.21, inverted 0.18, nose up 0.07, upright 0.01 |
| tail down | right side | 0.28 | 0.25-0.28 | left side 0.27, nose down 0.26, inverted 0.10, nose up 0.09 |
| left side down | right side | 0.29 | 0.26-0.30 | left side 0.28, nose down 0.23, inverted 0.12, nose up 0.05, upright 0.02 |
| right side down | left side | 0.26 | 0.26-0.26 | right side 0.23, nose down 0.20, inverted 0.17, nose up 0.13, upright 0.01 |
| upside down | inverted | 1.00 | 1.00-1.00 |  |
| upside down, 45 to the left | inverted | 0.89 | 0.77-0.93 | right side 0.04, left side 0.03, nose down 0.02, nose up 0.01, upright 0.01 |
