ZacharyShaver/FPVTank_Prototype/research/results/drop_predictions_E1_80mm.md

# Sensitivity: E1 at 80 mm

Release height 80 mm (lowest point of the body above the table).

Each cell: the most likely rest state and its probability at the nominal friction, then the range of that
probability across 0.65x to 1.5x friction. 200 simulated drops per cell.

## E1_tub mass low  (mass 108.5 g, CoM z 13.0 mm)

| start | most likely | p | across friction | others |
|---|---|---|---|---|
| nose down | upright | 0.30 | 0.30-0.31 | left side 0.23, right side 0.18, inverted 0.14, nose up 0.09, nose down 0.06 |
| tail down | upright | 0.30 | 0.30-0.33 | left side 0.21, right side 0.17, inverted 0.12, nose up 0.12, nose down 0.09 |
| left side down | upright | 0.34 | 0.34-0.36 | inverted 0.18, left side 0.17, right side 0.17, nose up 0.07, nose down 0.07 |
| right side down | upright | 0.34 | 0.33-0.34 | right side 0.20, left side 0.18, inverted 0.14, nose up 0.08, nose down 0.06 |
| upside down | inverted | 1.00 | 1.00-1.00 |  |
| upside down, 45 to the left | inverted | 1.00 | 1.00-1.00 |  |

## E1_tub mass high  (mass 108.5 g, CoM z 19.5 mm)

| start | most likely | p | across friction | others |
|---|---|---|---|---|
| nose down | inverted | 0.78 | 0.78-0.82 | right side 0.12, left side 0.09, upright 0.01 |
| tail down | inverted | 0.77 | 0.77-0.82 | right side 0.11, left side 0.10, upright 0.03 |
| left side down | inverted | 0.82 | 0.82-0.83 | left side 0.08, right side 0.07, upright 0.03 |
| right side down | inverted | 0.79 | 0.79-0.83 | right side 0.10, left side 0.08, upright 0.04 |
| upside down | inverted | 1.00 | 1.00-1.00 |  |
| upside down, 45 to the left | inverted | 1.00 | 1.00-1.00 |  |
