ZacharyShaver/FPVTank_Prototype/research/results/drop_predictions.md

# Drop predictions (committed before any drop)

Each cell: the most likely rest state and its probability at the nominal friction, then the range of that
probability across 0.65x to 1.5x friction. 200 simulated drops per cell.

## E1_tub mass low  (mass 108.5 g, CoM z 13.0 mm)

| start | most likely | p | across friction | others |
|---|---|---|---|---|
| nose down | upright | 0.29 | 0.29-0.32 | left side 0.23, right side 0.18, inverted 0.14, nose up 0.09, nose down 0.07 |
| tail down | upright | 0.31 | 0.29-0.33 | left side 0.21, right side 0.17, inverted 0.12, nose up 0.12, nose down 0.07 |
| left side down | upright | 0.35 | 0.34-0.36 | inverted 0.17, left side 0.17, right side 0.17, nose up 0.07, nose down 0.06 |
| right side down | upright | 0.32 | 0.32-0.34 | right side 0.20, left side 0.18, inverted 0.15, nose up 0.09, nose down 0.07 |
| upside down | inverted | 1.00 | 1.00-1.00 |  |
| upside down, 45 to the left | inverted | 1.00 | 1.00-1.00 |  |

## E1_tub mass high  (mass 108.5 g, CoM z 19.5 mm)

| start | most likely | p | across friction | others |
|---|---|---|---|---|
| nose down | inverted | 0.79 | 0.79-0.83 | right side 0.12, left side 0.08, upright 0.01 |
| tail down | inverted | 0.77 | 0.77-0.82 | right side 0.11, left side 0.10, upright 0.03 |
| left side down | inverted | 0.82 | 0.82-0.83 | right side 0.07, left side 0.07, upright 0.03 |
| right side down | inverted | 0.78 | 0.78-0.82 | right side 0.11, left side 0.08, upright 0.04 |
| upside down | inverted | 1.00 | 1.00-1.00 |  |
| upside down, 45 to the left | inverted | 1.00 | 1.00-1.00 |  |

## E2_dome mass low  (mass 118.9 g, CoM z 15.2 mm)

| start | most likely | p | across friction | others |
|---|---|---|---|---|
| nose down | upright | 0.31 | 0.28-0.31 | left side 0.23, right side 0.20, nose down 0.12, nose up 0.10, inverted 0.06 |
| tail down | upright | 0.27 | 0.26-0.27 | left side 0.20, right side 0.18, nose down 0.15, nose up 0.13, inverted 0.07 |
| left side down | upright | 0.34 | 0.31-0.34 | left side 0.18, right side 0.16, nose up 0.12, nose down 0.12, inverted 0.08 |
| right side down | upright | 0.32 | 0.30-0.32 | left side 0.20, right side 0.18, nose up 0.14, nose down 0.12, inverted 0.06 |
| upside down | inverted | 1.00 | 1.00-1.00 |  |
| upside down, 45 to the left | inverted | 0.80 | 0.78-0.80 | right side 0.11, left side 0.07, upright 0.03 |

## E2_dome mass high  (mass 118.9 g, CoM z 21.9 mm)

| start | most likely | p | across friction | others |
|---|---|---|---|---|
| nose down | inverted | 0.69 | 0.65-0.69 | nose up 0.15, nose down 0.10, left side 0.04, right side 0.02 |
| tail down | inverted | 0.66 | 0.62-0.66 | nose up 0.19, nose down 0.09, right side 0.03, left side 0.02, upright 0.01 |
| left side down | inverted | 0.57 | 0.56-0.60 | nose up 0.18, nose down 0.14, left side 0.06, right side 0.03, upright 0.01 |
| right side down | inverted | 0.62 | 0.61-0.62 | nose up 0.17, nose down 0.12, right side 0.06, left side 0.03, upright 0.01 |
| upside down | inverted | 1.00 | 1.00-1.00 |  |
| upside down, 45 to the left | inverted | 0.99 | 0.99-0.99 | nose down 0.01 |

## E3_tall mass low  (mass 140.1 g, CoM z 20.4 mm)

| start | most likely | p | across friction | others |
|---|---|---|---|---|
| nose down | left side | 0.24 | 0.23-0.26 | nose down 0.23, right side 0.22, nose up 0.17, upright 0.14 |
| tail down | nose down | 0.24 | 0.12-0.26 | left side 0.22, right side 0.21, nose up 0.19, upright 0.14 |
| left side down | nose down | 0.23 | 0.15-0.26 | left side 0.20, upright 0.20, nose up 0.19, right side 0.18 |
| right side down | nose down | 0.24 | 0.15-0.26 | left side 0.21, nose up 0.20, right side 0.20, upright 0.14 |
| upside down | inverted | 1.00 | 1.00-1.00 |  |
| upside down, 45 to the left | inverted | 0.56 | 0.56-0.57 | upright 0.43, left side 0.01, nose down 0.01 |

## E3_tall mass high  (mass 140.1 g, CoM z 31.2 mm)

| start | most likely | p | across friction | others |
|---|---|---|---|---|
| nose down | left side | 0.24 | 0.22-0.24 | nose up 0.23, right side 0.21, nose down 0.21, inverted 0.10 |
| tail down | nose down | 0.26 | 0.24-0.27 | nose up 0.24, left side 0.22, right side 0.21, inverted 0.07 |
| left side down | nose down | 0.26 | 0.24-0.29 | nose up 0.25, right side 0.21, left side 0.20, inverted 0.07, upright 0.01 |
| right side down | nose down | 0.26 | 0.25-0.28 | right side 0.23, nose up 0.23, left side 0.21, inverted 0.06, upright 0.01 |
| upside down | inverted | 1.00 | 1.00-1.00 |  |
| upside down, 45 to the left | inverted | 0.94 | 0.94-0.94 | nose down 0.03, left side 0.02, right side 0.01 |
