ZacharyShaver/FPVTank_Prototype/head-v2/generator/coil-test/coil_test_preview.png

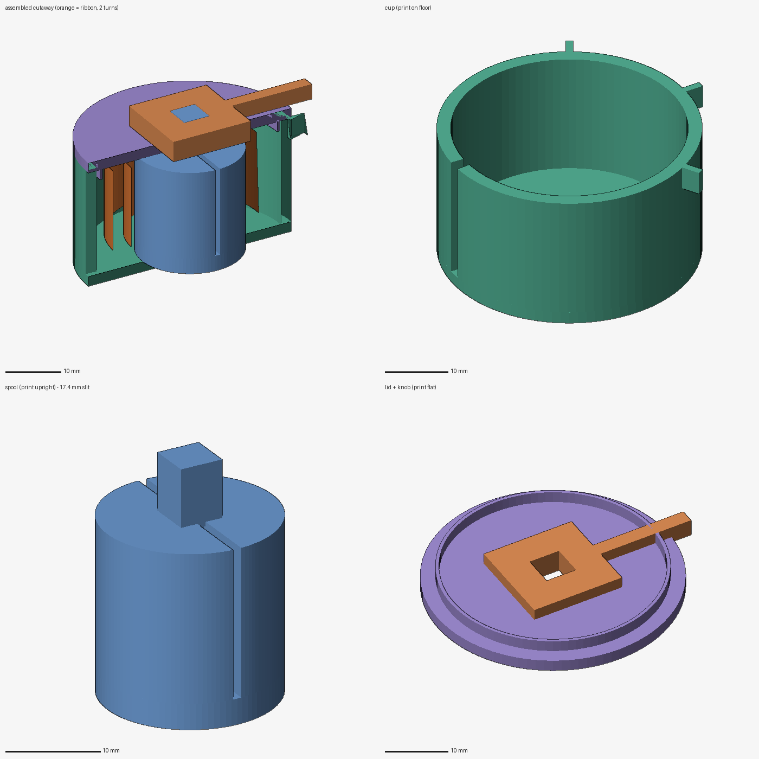
head-v2/generator/coil-test/coil_test_preview.png
