ZacharyShaver/FPVTank_Prototype/head-v2/fixes/fit_view_template.html

# Head and pan coil fit

New: bench stand v2 ("Bench stand v2" below): the head stands 12 mm up, with a pocket under it where the tilt servo wires drop straight down a slotted tube, out an arch and into a clip, clear of the spinning screw heads. It's meant as a slice of the body's nose floor. Before that, set 11 ("Set 11" below): the shelf ring is part of the base again, the empty wire lane is filled in, and the wires' old exit hole on the outside is closed. Before that, set 10: the servo wires run straight down the middle of the pan axis, through a hollow drum barrel in a 6704, and the small gear bolts on with three M3 × 16 through a solid hub. Before that, a bench stand, so the head stands on the bench without anything touching the gears. Before that, set 9: the pan servo couldn't turn the drum. The input gear now carries your servo's own horn, sits 1.0 under the servo's block, and the drum's barrel runs in a 688 instead of plastic. Before that, how the ribbon is laid ("Laying the ribbon" below): one wrap round the drum, one U-turn, one wrap back along the wall, not a coil. Set 8: the small gear's screw threads into the drum's barrel above the step, so tightening it no longer pulls the stub off; the stub and the gear's bore are a square; and the wires go down a straight hole beside the cone and out through an open groove under the drum ("Set 8" below). Before that, set 7: the shelf the ribbon stands on is its own ring (gold) that drops into the base. Before that, set 6: the drum's bore floor is a 30° cone and the input gear takes the spline straight in. Before that: the cradle's wire ridge blends into the wall (looks only). The servo wires' own route: round 1 (the stub and the cradle's wire hole) and round 2 (the wires' own lane in the pan coil) are built and checked. Head rev 2 (your halves, the IR cutout extended, the new camera posts and the board) and pan coil set 5 (set 4 with the drum's wire notch), with the post and the cradle, all in their real positions (mm, Z up from the deck top). Pull apart spreads the parts out the way each one goes in. The base (well and gear bay, one print) is see-through.

FrontSideUnderneath3/4 Cut in halfLift cradle offPull apart

drag to turn · scroll to zoom · right-drag to pan

## Bench stand v2: room under the head, the wires pinned

wires in the gears

A pocket under the head

The old stand held the floor plate 3 mm over the table, so the wires coming out of the middle had nowhere to go but sideways, through the three screw heads that spin just inside the floor plate's hole. Now the head stands 12 mm up on a hollow riser: the floor plate rests on a ledge round its edge (654 mm²), and under it is open.

Show the cutShow it whole

pin them

Straight down a tube, out, into a clip

Right under the middle a slotted tube (4.8 bore) takes the wires straight down, inside the circle the screw heads spin in (they start at r 3.05; the bore is r 2.4). At its foot they turn through a doorway toward the servo side, run along the floor, out an arch and press down into a V clip on the plate. The tube's slot faces away from that pull, so they can't pop out of it. Lay them in the slot with the head held over the stand, lower it, pull the slack out through the arch.

Show

body

A slice of the nose floor

The body plan stands the base straight on the hull floor, which needs this same pocket: the nose floor dips 12 under the head, or the head sits 12 higher. The socket holds the gear bay 0.4 a side, 8 up its side, as before.

print

1 h 7 m, 45 g, no supports

The ledge's underside slopes at 30° and the arch and doorway have pointed tops, so nothing in the pocket needs support. Uploaded to the K2, not started. The screws can't be reached from below any more: lift the head out.

guesses

OK these

The wires' way out toward the servo side, where your PCA9685 sits; the clip's V from 0.6 to 3.2 wide (any wire wedges at its own width); the M2 heads 3.8 × 2.0.

## Set 11: the shelf ring back in the base

ring fell out

One base, nothing loose

Upside down, which the base has to be for the small gear and the floor plate, the drop-in shelf ring could fall out of its lock: only a rib held it. With the wires down the middle the lane under it is empty, so it fills solid up to the ribbon's floor, and the ring's wall stands on that as part of the base. Nothing overhangs inside, so it prints with no supports in the can. The rib and its notch are gone.

Show

hole outside

The old wire hole is closed

The hole the wires used to leave by, and the bump it ran through, are gone; the outside is round there now.

Show

order

The 6704 still drops in first

It goes down through a 27.5 hole in the new floor (0.25 a side) to its seat, before the drum. Then drum + 6809; input gear + horn; wires down the axis; small gear + 3 M3 from below; floor plate.

print

Reprint the base only

Supports on, as set 10's base: about 1 h 21 m, 39 g. Drum, small gear, floor plate, input gear, horn, tab block and cradle don't change. The shelf ring you have is spare.

guesses

OK these, or measure

The 6704 drops through the 27.5 hole freely (holes print small); the ribbon's inner wrap rides on the drum over the 1.75 gap round it and doesn't drop in. The ribbon's own wall (the ring's) is kept as it was.

## Set 10: the wires down the middle

wires squashed

Straight down the pan axis

From the cradle the wires slide down the drum's cone to its point and drop straight down a 5.5 mm hole: through the drum's barrel, the small gear and the floor plate's middle hole, and out the bottom. Turning the head twists them a little instead of rolling them round the lane, so nothing squashes them, and they no longer limit how far the head turns (the ribbon still does). The lane and your shelf ring stay as they are, just empty.

ShowShow the wires' way

688 too thin

A 6704 on a hollow barrel

Hollowed out, the 688's 8 mm barrel had no wall left for screws. The barrel is 19.9 now, through a 6704 (20 × 27 × 4, one of yours) where the 688 was: same height, its top level with the lane's floor, on a lip under its outer ring only.

Show

screw on the axis

Your plate: the gear on 3 × M3 × 16

The small gear carries a solid hub on top, 22.4 across, that meets the barrel's end face to face just under the 6704. Three M3 × 16 go up through gear and hub, 7.3 mm into the barrel. The button heads sit under the gear and turn in a wider hole in the floor plate (18.7 across), 0.35 inside its underside. The hub's top stops 0.4 under the 6704's inner ring, so the drum can't lift out: the job the M3 did.

Show

looked flimsy

No thin walls round the screws

The first draft (same day, never printed) sank the heads into the gear's underside, leaving 0.9 between each pocket and the wire hole or the teeth, and centred the gear with a 1.1 collar. Now every hole has 1.4 of wall (M3) for the gear's full 8.7, and the gear has more plastic in it (2.5 cm³, was 1.75). The three screws centre it.

order

The 6704 goes in before the shelf ring

It's wider than the ring's hole. 6704 into its seat; shelf ring; drum + 6809; input gear + horn; wires down the axis; small gear + 3 M2 from below; floor plate, the wires out its middle hole. Leave a few cm of slack under the head before tying them down: that's where they twist.

print

Reprint the drum, the base, the small gear and the floor plate

Two plates, as set 9: drum, small gear and floor plate with supports off; the base on its own with them on. Shelf ring, input gear, horn, tab block and cradle don't change. Hardware: one 6704 and three M3 × 16.

guesses

OK these, or measure

The 6704's rings, so the lip from r 12.4 (typical: inner r 10.0–11.3, outer 12.3–13.5; not calipered); its seat 27.1 and the barrel 19.9 (the tilt seats' fits); button heads on your M3 × 16 (5.7 × 1.65; socket caps, 3.0 tall, would stand 1.0 below the base); the wire hole 5.5 (one jumper plug with two wires beside it); the hub 0.4 under the inner ring.

## Set 9: the servo can turn the drum

gear slipped

Your horn in the gear

The printed spline bore wore smooth, so the screw turned and the gear didn't. Now the double-arm horn (31.4 long) presses into a pocket of its own outline from the top, 0.10 a side (a second gear at 0.15): zero offset was so tight the horn flew out. Gear and horn go up onto the spline together. The floor is open under the horn, so its own screw goes up through the gear, seats on the horn's web and gets 4.5 mm into the shaft. The arms carry the turning, 15 mm out, not the plastic round the spline.

Show

rubbed the block

1.0 mm under the servo's block

The gear's top was 0.5 under the block, and with your 9.0 spline the screw pulled it 1.0 up, into the block: tighter screw, more drag. Now the horn sits where the spline stops it, and the gear's top is 1.0 under the block, the horn's hub 0.75. The screw can't lift either. Checked against set 6 pulled up 1.0: that reads −0.5.

Show

dragged leaning

A 688 on the barrel

Leaning, the drum's barrel bore on the base's plastic journal. Now it runs through a 688 (8 × 16 × 5, one of yours) seated in the base, its top level with the wire lane's floor. The 6809 still carries the drum; the drum's underside stands 0.4 clear of the 688, so the 688 only keeps it upright. The barrel is 7.9 below the drum, and the square stub shrank 7.0 → 6.0 to pass through the bearing. Drop the 688 in from the top before the drum.

Show

print

Two plates: drum + gears, then the base

Supports would fill the drum's bore, so the drum and gears print with supports off and the base on its own with them. The small gear is 0.10 a side: the 0.05 tore the stub off. Floor, shelf ring, tab block and cradle are unchanged.

guesses

OK these, or measure

The horn's flat face 4.45 under the block (your 9.0 tilt spline, the horn's 1.45 web, the 6.0 block); the gear 1.0 under the block; the 688 seat 16.1 and the barrel 7.9; the lip under the 688's outer ring from r 7.1; the small gear at 0.10; the horn pocket at 0.10 / 0.15.

## Laying the ribbon

not a coil

One layer on the drum, one U, one layer on the wall

Head facing front, so the drum's slot faces the servo. From the slot, lay the ribbon clockwise seen from above (toward the exit slit's side) about half a turn round the drum, fold it back once, and run it along the cup wall to the slit. About 70 mm stays inside; the rest goes out the slit. Wound round and round, the layers rub and wind tighter as the head turns. Laid this way, the head turns 317° one way and 235° the other before the U runs out; the other way round from the slot only 137°.

Show Turn the head0°

The drum's flange and disc are cut off above the ribbon so you can see in, the drum and the well are see-through, and the shelf ring and gear bay are hidden. You're looking from behind the head: front is up, the exit slit is on the right. Drag the slider: the U rolls, nothing slides. + is anticlockwise from above.

## Set 8: drum and small gear

snapped

The screw squeezes the stub now

The M3 × 8 had 4.2 of its 6.2 mm of thread in the stub, below the step the gear pushes up on, so tightening pulled the stub off across its layers. Now the stub has a clear hole and an M3 × 12 threads 5.8 mm into the barrel above the step. Tightening squeezes the step instead.

Show

slipped

A square instead of the D

The gear could turn 7.5° on the D before its flat bit. The square is 7.0 across with rounded corners that stay inside the barrel, and turns 2.2° at 0.05 a side. Two small gears to try: 0.05, and 0.10 if that one won't go on. Any of the four ways round fits.

Show

stuck at the cone

A straight hole, then an open groove

The old hole started at the cone's point and turned from straight down to sideways out of sight. The new one is a straight 5 mm hole right under where the wires come down the notch, behind the ribbon. It comes out of the drum's underside, where an open groove takes the wires out into their lane. Push them straight through, bend them into the groove, drop the drum in.

ShowUnderneath

guess

Numbers to OK or measure

The square, 7.0 across with r 0.8 corners; the gear's fit, 0.05 / 0.10 a side; M3 × 12 (your 2026-09-27 list, not checked today); the hole at r 8, −127°, 0.5 mm off the barrel and 1.5 inside the drum's face; the groove 5 wide, 2.9 deep. Lay the loop with about 74 mm of wire in the lane.

## Set 7: the shelf drops in

supports trapped

The shelf is its own ring

In set 5's base the shelf stuck 8 mm in over the 3.5 mm wire lane, so Orca filled the lane with supports nobody could get out. The shelf and the ribbon cup's wall are now one ring that prints shelf face down with nothing overhanging (12 min), and drops in from the top onto a ledge on the lane wall. A rib on the ledge fits a notch in its rim: it keeps the ribbon's drag from turning the ring and lines the ring's ribbon notch up with the base's slit. Orca, your settings: the lane went from 3850 support moves to 0; the base from 2 h 51 to about 2 h.

Show

drum on plastic

Nothing under the drum's hub

The ring needs a wider hole in the deck ring, which takes the deck ring out from under the drum's hub. It sat flush on it before (r 19.5 to 20.4), so the drum rested on plastic as well as on the bearing. The deck ring stands on a skirt now, with a cone 30° off vertical under its outer part.

Show

guess

The ribbon's way out

Past the ring's notch the ribbon goes straight out, on edge, through a 2 mm slit in the skirt and the cone. Its roof is pointed (30° off vertical); under the bearing's turning inner ring it's open to the top. The wires' exit hole has a pointed top too.

Show

## Set 6: no supports in the drum, gear on the spline

needed supports

The drum's bore floor is a cone

The drum prints upside down, so its flat 18 mm floor was a ceiling over tree supports. It's now a cone 30° off vertical, and its point is the wire hole's mouth: wherever the wires drop, they slide to it. The notch's floor is steepened to the same 30°. Slice with supports off: what's left is the ribbon slot's roof, a 17 mm bridge, and the arch over the 5 mm hole.

Show

screw too short

The spline goes straight into the input gear

The old pocket was a placeholder, and your MG90S's shaft hit its roof, so the gear hung low. Now the spline presses into the gear like post v3 (bore 4.44), with a 1.5 lip under its tip. The servo's own screw goes up through the lip: about 2.5 mm into the shaft for a 4 mm screw.

Show

## Servo wires: their own route

rounds 1 + 2

The whole way down, hidden

Parts go see-through. Your servo's own lead and plug stay coiled in the ball (dark grey). Three jumper wires (red) plug into it and run down 5 mm holes. Nothing cut, nothing soldered.

Show

round 1: stub

On the axis: they twist, they don't bend

The green stub replaces the −Y axle and the cap, and doesn't turn. The −Y 6704 (gold) sits in a cup in your ball: its outer ring turns with the ball, and the stub runs through its inner ring and shoulders on it. The cradle's collar is a plain bore. The wires run through the stub's middle, then drop into the cradle. 3 × M2 × 6 in the cap's old holes.

Show

round 1: cradle

Down inside the wall, under the drum screw

A 5 mm hole down the −Y wall (a 1.6 mm ridge outside where the wall was thin), under the drum screw's head, into the plug chute's mouth and down the drum's hole beside the ribbon. Checked: a 4.4 mm probe rides the whole way with 2.4 mm to spare; thinnest wall 0.6.

Show

new: looks

The ridge blends into the wall

The printed ridge stood out as a narrow vein with a notch under the collar. Its blend radius went 1.5 → 6 mm: it swells into the wall now, its +Y twin too. The outside moves out 1.1 mm at most; the hole and every clearance are unchanged. Reprint only for the looks.

Show

round 2: set 4

Their own rolling loop, under the ribbon

Down a 5 mm hole in the drum's core into a lane of their own: 3.5 tall, its own wall at r 21 (a 9 mm gap, so the moving U is 3.6 mm radius), under a fixed 0.8 shelf the ribbon sits on. Out through a boss at −145°, clear of the ribbon's slot. The floor dropped 4.3; gears, servo, floor plate and tab block didn't move. Leave 74 mm of wire in the lane.

Show

## Cradle: servo plug chute (new)

was stuck

The plug couldn't get down

The groove was 3.0 thick with a 6.3 mm bend, and it met the ribbon track only as a hairline near the centre line. Now the groove is 4.0 and a straight 4.0 chute, 50° from vertical and 22 wide, runs from the bowl's floor into the drum's hole. Feed the plug down it with the ball out.

Show

set 3 drum

Your 14 × 8 connector passes the drum

On set 2's drum it jammed at 3.0 thick, turning from the hole into the side slot. Set 3's side slot is 1.5 mm taller: it passes up to 3.5 thick.

Show

## Head rev 2

rebuilt

Camera posts on your moved tubes

Both tubes +2.00 in Z (Y 14.70, Z 37.95 / 66.85). The lens sits centred between them, 0.40 above the tilt axis. Pin tip 1.48 in your 1.78 wall holes.

Show

extended

IR cutout, 2 mm toward the posts

Your 32 mm circle moved 2.0 toward +Y, Z 42.4–62.4, 1 mm off both tubes. Edge at Y 18.0 (was 16.0).

Show

## What changed in sets 2 and 3

set 3: didn't fit

Your MG90S, gears 5.6 mm lower

Built on your MG90S model. Its 15 × 12.2 block and shaft ran into the input gear, and its tabs sat 4.6 higher than the datasheet box. The gear plane dropped 5.6, the drum's barrel and the bay grew to match, and the window slot takes the boss. Reprint base and drum; the gears and floor are unchanged.

Show

screw in air

Tab block under the window-end tab

The servo slides in through that end, so its tab screw had no plastic under it (set 2 too). The orange block slides in after the servo on two rails, and the tab's own M2 × 6 goes into it: 3 mm of thread.

Show

was stuck

Small gear is its own part

It was moulded onto the drum, 22.6 mm across, under a 10.5 mm hole. Now it pushes up onto a D-shaped stub (one flat side) from below, with one M3 × 8 button head.

Show

was closed

Floor comes off

The gear bay was a closed box. Its floor is now a plate on 4 × M2 × 6, so both gears go in from underneath.

Show

one print

Well and gear bay fused

Nowhere on the well could take a screw, so they print as one base.

Show

would jam

Gear play

The teeth touched on both sides. The small gear is now 0.3 mm smaller all round: 1.9° of play at the head as drawn, about 1° printed.

Show

would drag

Bearing sits on its outer ring only

The 6809's turning inner ring sat on the fixed ledge. A 0.4 mm recess now clears it. Seat 58.1, hub 44.9, and a sharp step where it seats on the drum.

Show

## Cradle to drum

fixed

Three bolt holes

M3 × 12 at 20 mm out, 0°/120°/240°, matching the drum. A 3.4 hole through the bottom 5.5 mm, then a 6.4 recess open to the bowl, so a driver reaches from above before the ball goes in.

Show

was wrong

Ribbon path open

The groove drops straight into the drum's 18 mm hole, and the tightest bend is 6.3 mm radius. Superseded: "clear the whole way" missed the groove's entry, a hairline from the track. The plug chute opens it.

Show

fixed

Groove on the centre line

It used to land 9 mm forward, at the hole's edge. One soft 45° fold at the drum's side slot then turns the ribbon on edge, so no twist and no fold pocket are needed. Bolt the drum with that slot facing forward.

Show

fine

Nothing collides

The coil's clash check reads 0.00 mm³ for the cradle against all six coil parts. The cradle's base and the drum's disc are the same size (Ø51).

Show

no longer needed

The 40 mm twist

The orange ghost is the run a quarter twist would have needed, running up into the ball. One fold at the drum replaces it.

Show

## Parts
