ZacharyShaver/FPVTank_Prototype/head-v2/fixes/plus_sleeve_view_template.html

# +Y hub as a sleeve

The cradle's +Y arm snaps because the hub on your ball_plus stands 5.8 mm past the ball's flat face, into the collar. The fix you picked: the hub comes off and is printed as a sleeve that goes in from outside after the ball, like the −Y stub. The print files are in head-v2/out/print-rev2/ (plate_plus_sleeve.3mf). Use the slider to put the head together, and switch to Today to watch the arm bend. All parts sit where your geometry puts them (mm, Z up from the deck).

TodayHub as sleeve 3/4From the lensFrom +Y Cut in halfSee-through ball

drag to turn · scroll to zoom · right-drag to pan

Play

apart1 ball in2 sleeve + 67043 post4 −Y stub

today

## Why the arm bends

The hub (r 8.0–9.95) runs from the flat face at Y 24.5 out to 30.3. The collar's inner face is at Y 25.1. The −Y side gives under 1 mm, so the +Y arm has to spread about 5 mm while the hub goes past, then snap back round it.

Show it bend

chosen

## What changes

- ball_plus (your rev 2, IR cutout extended): the hub cut off flush, and a 1.5 mm socket in the flat face, with a flat on the lens side as a key.
- Sleeve (new, ~10 min print): your hub's bore (16.0) and the notch for the servo's gear bump, 8.6 long. The 6704 presses on (20.0 or 20.1, two to try) up to a lip, so the bearing really turns.
- Unchanged: cradle, post v3, both 6704s, the servo, the −Y stub.

Show the sleeve

## Putting it together

1. Ball straight down into the nest. Nothing bends.
2. On the bench, press the 6704 onto the sleeve from the flat end until it stops on the lip.
3. Sleeve and bearing together in from outside, flat to the lens side, until the sleeve drops into the socket.
4. Post v3 on, 3 × M2 as before.
5. −Y stub in, 3 × M2 × 6 as before.

checked

## What was measured

- Drop: today, 1,520 columns of the hub hit the +Y collar on the way down. With the sleeve: 0.
- In place: both sleeves touch nothing but the 6704's inner ring (the press): cut ball, post v3, the cradle, the outer ring, your MG90S, all 0 mm³. Controls: 0.3 deeper it hits the ball (21.5 mm³); without the notch it hits the servo's gear bump (11.4 mm³).
- Way in: the sleeve with the 6704 on slides in from +Y unblocked. Control: into today's ball, 4,733 lines blocked.

guessed

## Numbers to OK or measure

20.0 / 20.1

the press: the sleeve's outside under the 6704

r 11.0

the stop lip; a 6704's inner ring is about 22.6 across

1.5 mm

socket depth; your plate is ~2.2 thick at the bottom, so 0.69 is left there

0.15

every sliding gap at the socket (your slide rule); 0.3 to its floor

X 9.0

the key's flat, socket and sleeve

0.3 mm

sleeve end to the post's flange, so it can't walk out

Y 26.24

servo tower top, taken from post v3's fit

Y 27.0

where the notch stops: past post v3's inner end, so the bearing presses onto a full 2 mm wall

## Also found

The collar's shoulder (r 10.45 out) faces the 6704's inner ring (r 10.0–11.3) as well as its outer one, so a fixed face rubs the turning ring. It always has; this change doesn't touch it.

In both versions the ribbon track's top lip at the back reaches about 1 mm over the ball's widest point (X −30, Z 66). It's a small snag, not the 5 mm one.
