ZacharyShaver/FPVTank_Prototype/gauges/unibody.py

"""One-piece bodies, grown where they're weak (2026-10-29, a prototype). Zach, on body_tree's sheet: "it doesnt look right
like it is a realistic thing id be able to print the shape seems weak in key areas", "the bodies seem weakest if there
dropped onto a single wheel at an angle", "it needs to feel more like one shape and less like a shape with 3d printed
trees on it. Maybe trees were the wrong path".

body_tree built parts (a hull, rods, tubes) and blended them after. Here the robot is one signed distance field from the
start, and its strength comes from the shape's own sections, the way a print gets it (walls far apart), not from solid
rods:
  1. Required, from body_tree's anchors (the same wheel layouts): the body (body.shell's profile, its edges rounded by
     a knob), a boss round each motor, the parts bay (a cavity, 3 mm of body round it at least).
  2. Random, by the knobs: an arm from each boss into the body's side, a deep oval rather than a rod; a pod along each
     side joining its bosses; a beam across an end pair that clears the body; blobs between the body and the wheels;
     a low ripple (off since 2026-10-30). One smooth union joins them, its radius K a knob (15-60 mm: webs, not body_tree's 8 mm fillets).
     Mirror symmetric.
  3. Cut sharp: each wheel's room, each motor's bore (closed 3 mm past its inner end, open to the tyre), the cavity,
     everything under the belly or the bosses.
  The motor (2026-10-29, Zach: "the motor i have has screws and a face plate"): the Trainer's corner module. The pod
     ends in a lip the gearbox face screws to, the wheel is a dish over the pod (or, for a wheel too small to wrap it,
     outboard on a shaft extension), and a landing goes into the shape through the gearbox face.
  4. Grown: fem.py lands the robot on one wheel (each wheel on the left, the right mirrors it): 1.5x* its 300 mm drop
     into one tyre's 30 N/mm spring (snap.py's), up, 45 degrees in, out, forward and back, and flat sideways. Where the
     printed wall's stress passes the allowed (snap.py's 25 MPa over 2), the field swells, up to GROW* a round, carried
     REACH* out to the surface, then it's cut and landed again (Mattheck's CAO, 1990: shape optimization by biological
     growth); and cut where nothing within REACH carries SKO_LOW (SKO, Mattheck's soft kill, 1992). Each round does
     both, until it holds and its mass settles. The motor's seat is read apart: its peak is the mount's.
  5. Under a weight cap (2026-10-30): over CAP_G* the cut deepens, up to everything not carrying the allowed, and the
     trim knob's limit lifts. The falls (G1's, drops.py) are the verdict, dropped on the drawn shape and the finished
     one, not grown against (that made warts and broke more often); the body meets the floor on soft TPU bumpers.

    python gauges/unibody.py section [seed] [k]  -> out/unibody/section.png: a cut through a wheel's pod, the motor in it

    python gauges/unibody.py check [seed]     the drawn shape's tests, with their controls: the core meshes flat, the mesh
                                                 has no folds (exits 1 on a failure)
    python gauges/unibody.py sheet [seed]     -> out/unibody/sheet.png: Sobol designs, grown, one shape each
    python gauges/unibody.py compare          -> out/unibody/compare.png: body_tree's sheet designs (seed 23823) against
                                                 a unibody on the same wheels, the same landing on both
"""
import os, sys, math, pickle
os.environ.setdefault('SCORPION_SEARCH', 'search_hills')
os.environ.setdefault('PYTORCH_CUDA_ALLOC_CONF', 'expandable_segments:True')   # workers share one 12 GB card (2026-10-29: three ran it out)
import numpy as np
HERE = os.path.dirname(os.path.abspath(__file__))
sys.path.insert(0, HERE); sys.path.insert(0, os.path.join(HERE, '..', 'tools'))
import config, stamp
import robots as RB, body as B, body_tree as T, fem as FE

OUT = os.path.join(config.GAUGES_OUT, 'unibody')
VOX, FEM_H = 2.0, 4.0                       # mm: the field's grid, the stress solve's
WHEEL_GAP, BAY_WALL = 5.0, 6.0              # mm round each tyre; the least body round the parts bay (a printed sandwich: wall, infill, wall)*
SIGMA_ULT, SF = 25.0, 2.0                   # as snap.py: PLA across its layers*, the safety factor*
ALLOW = SIGMA_ULT / SF
LAND, DROP_M, TYRE_K = 1.5, 0.3, 30.0       # the landing: LAND* times a 300 mm drop into one tyre's spring (N/mm)*
GROW, ROUNDS, REACH = 5.0, 12, 12.0         # mm a round at most*, rounds at most, mm the growth reaches* (grow_map)
GROW_BLUR, SHAPE_BLUR = 10.0, 3.0           # mm: each round's growth blurred (4 until 2026-10-30), and the grown shape before its
                                            # cuts (none until then). Zach, on the grown sheet: "its effective but ugly. that a kind of
                                            # balooning is going to make this annoying to print. smooth it"
GROW_FROM = 0.9                             # growth starts at 0.9x the allowed (2026-10-30: from 1.0x, with 6 rounds, every
                                            # sheet design ended 14-26 MPa, the arm roots still falling 0.3-0.6 a round)
CAP_GIVE = 1.1                              # the cap gives 10 % while the landings are over
SKO_LOW, SHRINK, SKO_REACH = 0.5 * ALLOW, 6.0, 6.0   # SKO: where nothing within SKO_REACH mm carries half the allowed*, the shape
                                            # shrinks up to SHRINK mm a round* (first tried 4 MPa within 12 mm: 7 % off in 3 rounds)
SEAT = 14.0                                 # mm: body_tree's collar round its motor, read apart (the motor levers in a short collar)*
MOTOR_R = B.MOTOR['half'][0]
# The drive (2026-10-29, Zach: "the motor i have has screws and a face plate"): the Trainer's corner module
# (chassis-v2/wheels.py). A pod round the 37 mm gearmotor ends in a wall, the lip, that the gearbox face screws to (6 M3
# on a 31 circle*); the wheel is a dish whose rim wraps back over the pod, its hub on the shaft just past the lip. A
# wheel too small to wrap the pod (rim under POD_R + 2 + WHEEL_GAP) sits outboard of it instead, its hub on a shaft
# extension (flagged: a long lever on the gearbox). The numbers are the 37D class's datasheet*, not his motor's.
MOT = dict(gb_d=37.0, gb_l=22.0, m_d=34.5, m_l=33.0, enc_d=30.5, enc_l=11.0, shaft_d=6.0, shaft_l=15.5, holes=6, pcd=31.0)
MOT_L = MOT['gb_l'] + MOT['m_l'] + MOT['enc_l']             # 66: the face to the encoder's end
FACE_OUT = MOT['shaft_l'] + 1.55                            # the gearbox face in from the wheel's outer face (the Trainer's)
POD_R, POD_IR, LIP, SHAFT_HOLE = T.TUBE_R, 19.0, 5.0, 6.5   # mm: the pod (24.5: 6 mm wall*), its bore (the Trainer's 38), the lip* and its shaft hole
RIM_IN = 11.5                                               # the dish's rim this far inside the tyre's radius (the Trainer's)
MOUNT = 8.0                                                 # mm round the gearbox face's seat, read apart (where the load goes in)*
# TPU bumpers (2026-10-29: the falls' worst hits are on the body's top edges, 3.4-3.8 kN on a hard body; the same falls
# on a 30 N/mm bumper read 17 MPa against 25, drops.py bumpers): a knob, the body meeting the floor on a spring in the
# falls; their mass a TPU skin BUMPER_T* thick over BUMPER_SHARE* of the shape's surface. Not drawn: where they sit.
# 2026-10-30: always on (stiff ones barely helped), so the knob is their stiffness alone, soft.
BUMPER_T, BUMPER_SHARE, TPU = 3.0, 0.3, 1.21e-3
# The weight cap (2026-10-30): of the sheet's 12 shapes, only the lightest (1.6 kg of PLA, no bumpers) came through its
# falls, 4 of 24 over the allowed; the rest 13-24 (falls_vs_mass.png). Thin evidence (one design, and the bumpered
# shapes' TPU was overcounted), so the cap is a test: the falls' worst hits are the body landing on its edges, and
# those grow with the mass while the edges don't.
CAP_G = 2000.0                                              # g: the printed shape's cap*
LEG_KEYS = ('tree', 'members', 'spread_x', 'spread_z', 'root_x', 'fork_y', 'fork_z', 'bend')
SHAPE = [   # (key, low, high, what it is)
    ('K', 15.0, 60.0, 'the smooth union\'s radius, mm (how far one piece flows into the next)'),
    ('round', 0.0, 30.0, "the body's edges rounded, mm"),
    ('arm_d', 40.0, 120.0, "an arm's depth (up and down), mm"),
    ('arm_t', 24.0, 70.0, "an arm's thickness (along the body), mm"),
    ('rake', -1.0, 1.0, "the arm's root along the side: out toward the wheel's end (-1) to in toward the middle (1), 60 mm"),
    ('pod', 0.0, 1.0, "a pod along each side joining its wheels' bosses (above half)"),
    ('pod_r', 18.0, 45.0, "the pod's radius, mm"),
    ('beam', 0.0, 1.0, 'a beam across each end pair that clears the body (above half)'),
    ('blobs', 0.0, 6.999, 'blobs a side, between the body and the wheels'),
    ('blob_r', 15.0, 60.0, "the blobs' size, mm"),
    ('seed', 0.0, 1.0, "the blobs' and ripple's draw"),
    ('ripple', 0.0, 0.0, "the surface's ripple, mm (0-6 until 2026-10-30; off since, Zach: \"ripple off\": it only ever "
                         "added bumps. Kept at 0 so each seed's Sobol draws keep the same other knobs)"),
    ('ripple_l', 40.0, 160.0, "the ripple's wavelength, mm"),
    ('trim', 0.0, 40.0, "the most SKO may cut back from the drawn shape, mm (0: the drawn shape, grown only; 40: stress-cut, legs "
                        "return); lifted over the weight cap"),
    ('bumper_k', 20.0, 60.0, "the TPU bumpers' stiffness, N/mm (a printed lattice; the body meets the floor on them, as the tyres "
                             "do. 2026-10-29: 20-150, the stiff half barely helped)")]
KNOBS = [k for k in T.KNOBS if k[0] not in LEG_KEYS] + SHAPE
KEYS = [k for k, *_ in KNOBS]


# ---------- distance fields (torch, mm, negative inside) ----------
def _torch():
    import torch
    return torch, ('cuda' if torch.cuda.is_available() else 'cpu')


def smin(a, b, k):
    torch = _torch()[0]; h = torch.clamp(0.5 + 0.5 * (b - a) / k, 0.0, 1.0)
    return b * (1 - h) + a * h - k * h * (1 - h)


def ellip(Px, Py, Pz, r):
    """an ellipsoid of semi-axes r at the origin, local coordinates (IQ's bound)"""
    torch = _torch()[0]
    k0 = torch.sqrt((Px / r[0]) ** 2 + (Py / r[1]) ** 2 + (Pz / r[2]) ** 2)
    k1 = torch.sqrt((Px / r[0] ** 2) ** 2 + (Py / r[1] ** 2) ** 2 + (Pz / r[2] ** 2) ** 2).clamp_min(1e-9)
    return k0 * (k0 - 1) / k1


def ecapsule(G, p0, p1, a, b):
    """a capsule from p0 to p1 whose section is an oval: a deep (toward z, or x when the axis is upright), b wide"""
    X, Y, Z = G; p0, p1 = np.asarray(p0, float), np.asarray(p1, float); e = p1 - p0; L = max(np.linalg.norm(e), 1e-6); u = e / L
    v = np.array([0.0, 0.0, 1.0]) - u[2] * u
    if np.linalg.norm(v) < 0.3:
        v = np.array([1.0, 0.0, 0.0]) - u[0] * u
    v /= np.linalg.norm(v); w = np.cross(u, v)
    rx, ry, rz = X - p0[0], Y - p0[1], Z - p0[2]
    t = ((rx * u[0] + ry * u[1] + rz * u[2]) / L).clamp(0, 1)
    qx, qy, qz = rx - t * e[0], ry - t * e[1], rz - t * e[2]
    return ellip(qx * u[0] + qy * u[1] + qz * u[2], qx * v[0] + qy * v[1] + qz * v[2], qx * w[0] + qy * w[1] + qz * w[2], (min(a, b), a, b))


def blob(G, c, r, Rm):
    X, Y, Z = G; rx, ry, rz = X - c[0], Y - c[1], Z - c[2]
    return ellip(*(rx * Rm[0, k] + ry * Rm[1, k] + rz * Rm[2, k] for k in range(3)), r)


def cyl(G, c, r, a0, a1, axis=1):
    """a capped cylinder of radius r round the line through c along axis (0 x, 1 y), from a0 to a1 on it"""
    torch = _torch()[0]; X, Y, Z = G
    if axis == 1:
        dr = torch.sqrt((X - c[0]) ** 2 + (Z - c[2]) ** 2) - r; s = Y
    else:
        dr = torch.sqrt((Y - c[1]) ** 2 + (Z - c[2]) ** 2) - r; s = X
    da = torch.abs(s - 0.5 * (a0 + a1)) - 0.5 * abs(a1 - a0)
    return torch.clamp(torch.maximum(dr, da), max=0.0) + torch.sqrt(dr.clamp_min(0) ** 2 + da.clamp_min(0) ** 2)


def planes_sdf(G, P):
    """a convex hull's plane distance (exact inside, a bound outside)"""
    from scipy.spatial import ConvexHull
    X, Y, Z = G; E = ConvexHull(P).equations; out = None
    for n0, n1, n2, d0 in E:
        d = n0 * X + n1 * Y + n2 * Z + d0; out = d if out is None else _torch()[0].maximum(out, d)
    return out


def redistance(inside, h):
    """the signed distance (mm) of a voxel set, from its Euclidean distance transforms. Its surface lies on voxel faces:
    fine for the stress solve's voxels, not for a shape that's drawn (core_field)"""
    from scipy.ndimage import distance_transform_edt as edt
    return (edt(~inside) - edt(inside)) * h + np.where(inside, 0.5 * h, -0.5 * h)


def tri_dist(P, a, b, c, chunk=8192):
    """unsigned distance from each point P (n, 3, a torch tensor) to the nearest of the triangles (a, b, c) (m, 3 each)"""
    torch, dev = _torch(); T = lambda x: torch.as_tensor(np.asarray(x), dtype=torch.float32, device=dev)[None]
    a, b, c = T(a), T(b), T(c); ba, cb, ac = b - a, c - b, a - c; nor = torch.cross(ba, ac, dim=-1)
    d2 = lambda x: (x * x).sum(-1); dot = lambda x, y: (x * y).sum(-1)
    ea, eb, ec = torch.cross(ba, nor, dim=-1), torch.cross(cb, nor, dim=-1), torch.cross(ac, nor, dim=-1)
    out = []
    for i in range(0, len(P), chunk):
        p = P[i:i + chunk, None]; pa, pb, pc = p - a, p - b, p - c
        edge = torch.sign(dot(ea, pa)) + torch.sign(dot(eb, pb)) + torch.sign(dot(ec, pc)) < 2.0   # past an edge: the edges
        de = torch.minimum(torch.minimum(d2(ba * (dot(ba, pa) / d2(ba)).clamp(0, 1)[..., None] - pa),
                                         d2(cb * (dot(cb, pb) / d2(cb)).clamp(0, 1)[..., None] - pb)),
                           d2(ac * (dot(ac, pc) / d2(ac)).clamp(0, 1)[..., None] - pc))
        out.append(torch.sqrt(torch.where(edge, de, dot(nor, pa) ** 2 / d2(nor)).min(1).values))
    return torch.cat(out)


def core_field(pts, G, rnd=0.0):
    """the exact signed distance of the convex hull of pts, its edges rounded by rnd (0: sharp): inside the hull moved
    in by rnd, its planes' distance (exact inside a convex hull); outside it, the distance to its nearest triangle;
    less rnd. A rounding past what the hull's thickness allows is capped at 0.9 of its inradius from the centroid.
    2026-10-30: replaces redistance() of the hull's voxels (and again for the rounding), which put the body's surface on
    2 mm voxel faces: flat faces came out terraced up to 1.0 mm off, rounded ones up to 3.3 mm (Zach: "a strange
    bumpyness"); growth then built on the steps. The old field is _core_voxel(), check()'s control"""
    from scipy.spatial import ConvexHull, HalfspaceIntersection
    pts = np.asarray(pts, float); h = ConvexHull(pts); E = h.equations.copy(); c0 = pts[h.vertices].mean(0)
    rnd = min(rnd, 0.9 * -(E[:, :3] @ c0 + E[:, 3]).max())
    if rnd > 0:
        E[:, 3] += rnd; V = HalfspaceIntersection(E, c0).intersections; h = ConvexHull(V)
    else:
        V = pts
    tri = V[h.simplices]; A = planes_sdf(G, V[h.vertices]); out = A > 0
    A[out] = tri_dist(_torch()[0].stack([g[out] for g in G], 1), tri[:, 0], tri[:, 1], tri[:, 2])
    return (A - rnd).cpu().numpy(), rnd


def _core_voxel(pts, G, rnd=0.0):
    """SUPERSEDED 2026-10-30 by core_field(): the hull's field from its voxels, as union() made it until then. Kept as
    check()'s negative control: it must read the terraces"""
    F0 = redistance((planes_sdf(G, pts) <= 0).cpu().numpy(), VOX)
    return (redistance(F0 < -rnd, VOX) - rnd) if rnd > 0 else F0
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
