ZacharyShaver/FPVTank_Prototype/(commit log)

2024-10-14 Add Models and Instructions
    First commit of the FPV Tank project
    [big-bevel-gear-21-v11.stl, big-bevel-gear-41-v13.stl, big_track_v11.stl, body-rover-v13.stl, camera-mount-left-v11.stl, camera-mount-main-v11.stl, camera-mount-right-v11.stl, esc-mount-left-v12.stl]
2024-10-31 upd sockets
    udp sockets and tkinter window
2024-11-04 Finished Project
    wifi car on an Adafruit Metro M0 using a Adafruit Motor Hat V2 to power motors. Connected to a 5V 3A power supply and receives key commands from a udp python server
2026-09-26 Reorganise into the CAD repo layout (phase A)
    - Rename the Instructables PDF out of its colon filename (git plumbing:
    Windows couldn't check it out) and move the FPV-Rover V2.0 download to
    reference/fpv-rover-v2/, the 41-tooth gears to alternate-wheel-mounts/.
    - Move the 2024 controller and robot code to archive/v1-2024/.
    - Remove .DS_Store and __pycache__; add .gitignore.
    - Bring in the local-only files: the Aug 2026 pan/tilt STLs
    (archive/pan-tilt-2026-08/) and the Pi 5 fit-check models
    (reference/raspberry-pi-5/; the 31 MB STEP stays untracked).
    - Add Zach's Fusion rev 1 exports (head-v2/fusion/rev1-2026-09-24/).
    - Turn the 2026-09-25 session's scripts into tools/, head-v2/fixes/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
    [BODY_NUMBA1 (1) (1).stl, Body15.stl, Body31.stl, Body55.stl, Body56.stl, Pan_Tilt_pan_cap.stl, ball_minus_revised.stl, ball_servo_post_revised.stl]
2026-09-27 Camera snap posts and finished-part STEPs, re-verified after the move off OneDrive
    Brings the 2026-09-26 camera-post work into the repo, where build_all.py regenerates it:
    - fixes/campost.py: two snap posts replace the camera board's two screws. They push in from
    outside through Zach's old screw tubes. export_campost.py, plate_campost.py and
    figure_campost.py make the print STLs, the full 3MF plate, the Fusion tool bodies and the
    picture sheet.
    - fixes/step_models.py: the finished parts as STEP solids in Zach's frame, for Fusion, plus
    one full-model file. ball_plus is sewn from its checked STL, because its exact BREP loses
    490 mm3 through STEP readers.
    - fixes/pins_on_bed.py and ex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
    [build_all.py, export.py, figure_campost.py, mesh_report.py, pins_on_bed.py, plate_campost.py, regression.py, step_models.py]
2026-09-27 Phase B: bring the CAD over from FPVTank_Control
    Copies every tracked file under Control's docs/chassis/ (at dev 138cb6a), plus three CAD lessons:
    - docs/chassis/head-v2/ goes to head-v2/generator/, whole, so the generators' relative paths still
    work: the SDF generators, the camera dummy, the variant folders (including the 360-degree pan
    coil) and the briefs;
    - parts/, img/ and the chassis notes go to chassis-v1/;
    - flat-cable, coincident-faces and surface-sampling go to docs/lessons/.
    All 199 files are byte-identical to Control's, and their content matches Control's git blobs.
    Generated print STLs and caches stay behind; head-v2/generator/*/print/ is now ignored.
    tools/config.py reads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
    [Body1.3mf, axle.obj, axle.step, axle_blank.obj, ball_concept_fixed.stl, ball_concept_pan.stl, ball_concept_tilt.stl, ball_minus.obj]
2026-09-27 Phase B: point the docs at the new layout
    - READMEs for head-v2/generator/, chassis-v1/ and docs/lessons/ describe what landed, not the plan.
    - README.md, CLAUDE.md and reference/solids/README.md: the generator is here, and Control holds no CAD.
    - Old paths inside the moved docs now point at their new homes: ../FPVTank_Prototype/Version 1/...,
    Current/raspberry-pi-5-model_files/, docs/chassis/..., and ../../lessons/.
    - head-v2/NOTES.md: phase B is done. The two generator tasks that never landed are carried as open
    items, along with the cradle-to-pan-coil fit, which is blocked on where the ribbon twists.
    - HANDOFF.md and MOVE-PLAN.md move to docs/reorg-2026-09/, with MOVE-PLAN marked done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
2026-09-27 Cradle blank and cut list: regenerate from the current generator
    The fork blank and features.md dated from 09-19 10:12, before that day's cradle fixes. Among them was
    "stop the ball fouling the nest". The old blank's bowl sat up to 3.6 mm off the current one (roots
    is unchanged, 0.000 mm).
    step_mesh_prep.py printed the flange-screw angles as a fixed "90/210/330". The triad was rotated to
    SCREW_A = 30/150/270 on 09-19 (d19e608 in Control), so the table has been wrong since. It now reads
    SCREW_A.
    [fork_blank.obj]
2026-09-27 Cradle onto the pan coil drum, medium pins, MuJoCo head model
    Work from the earlier 2026-09-27 session, uncommitted until now:
    - tree_parts_b.py (PAN_COIL): the cradle bolts straight onto the drum's
    mounting disc with 3 x M3 x 12; the ribbon groove comes down on the
    centre line; the pan-horn pocket is gone. fork.obj regenerated.
    - Seam pins and camera posts: medium is Zach's pick (plate3mf.py,
    plate_campost.py).
    - sim/mujoco/: the head as a MuJoCo model (servo joints, the 2:1 gear
    pair), with its README.
    - decisions.md: the cradle-on-drum, fold-rule, medium-pin and MuJoCo
    entries. Lessons: zero overlap is not a fit; a passing score can hide
    a broken sim. CLAUDE.md, README.md and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
    [fork.obj]
2026-09-27 Pan coil print set 2: parts that can be assembled
    Zach asked how the drum's gear gets into its hole. It couldn't: moulded
    on the drum it was 22.6 mm across, under a 10.5 mm journal and a 17.2 mm
    bay top hole, and the gear bay was a closed box. Set 1 is superseded.
    - The small gear is its own part (gear_out), on a D-shaped seat at the
    barrel's end, held by one M3 x 8 button head from below.
    - The gear bay's floor is a separate plate on 4 x M2 x 6, so both gears
    go in from underneath.
    - The well and the gear bay print as one part (base), Zach's pick.
    Found before set 2 printed, and fixed:
    - the gear pair had zero play; 0.3 comes off the small gear (1.9 deg);
    - the 6809's turning inner rac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
    [bay.obj, drum.obj, floor.obj, gear_out.obj, screw_out.obj, well.obj]
2026-10-02 Head rev 2: Zach's Fusion revision, camera posts rebuilt on his moved tubes
    Zach's rev 2 export (head-v2/fusion/rev2-2026-09-27/): both camera-post tubes moved +2.0 in Z, the rib
    between them removed, and the IR-cut holder's opening reshaped. He moved the tubes because the lens sits
    centred between the board's holes, not 1.6 off it as the photo had it.
    - camera_dummy_centred.*: the board with the lens centred on its holes. camera_dummy.* keeps the photo
    offset, because the rev-1 regression rows were run with it (kit.camera(centred=...)).
    - fixes/campost_rev2.py, ball_plus_rev2.py, export_campost_rev2.py, figure_rev2.py: the camera posts
    rebuilt for his tubes, the IR cutout extended 2 mm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
    [ball_minus_revised_27.stl, ball_plus_revised_9_27.stl, camera_dummy.step, camera_dummy_centred.step, camera_dummy_centred.stl, camera_dummy_centred_origin.step, camera_dummy_centred_origin.stl, camera_dummy_origin.step]
2026-10-02 Servo wires' own route, pan coil sets 3 and 4, cradle plug chute
    The tilt servo's lead was taped to the ribbon, and that spoilt the ribbon's fold. The servo's own lead and
    plug now stay coiled inside the ball, and Zach's Dupont jumpers plug into it and run down a hidden route
    of their own:
    - Round 1: a fixed hollow stub (tree_parts_b.stub) replaces the -Y axle and end cap. The ball turns on
    it, and the wires run through its middle on the tilt axis, so they twist instead of bending. The old
    axle never fitted: Zach's socket is r 10.04 and the axle was r 9.95; the stub is r 9.80. A 5 mm hole
    runs down inside the cradle's -Y wall (WIRE_PTS) into the plug chute's mouth.
    - Round 2, pan coil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
    [bay.obj, drum.obj, floor.obj, fork.obj, gear_in.obj, gear_out.obj, screw_out.obj, servo.obj]
2026-10-13 Baseline for the research sprint: pan coil sets 5-11, bench stand v2, chassis v2 brainstorms, nose section
    Everything since 546be68 that sessions left uncommitted, as the fixed starting point the
    research sprint's dataset and results trace back to (research plan "Checks That Can Fail",
    due 2026-10-27):
    - head-v2: pan coil sets 5 to 11 (wires down the axis, 6704, shelf ring merged back into the
    base), their checks with negative controls, print scripts, bench stand v2 (raised, wire post)
    - chassis-v2: the hull, rugged, tail-arm, guard-arm, trainer and line-up brainstorms, and
    nose.py (the stand's pocket in the Trainer's nose floor, clamp ring and posts)
    - chassis-v1: Zach's TEST-PRINT-2 Fu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
    [Configuration 1.step, TEST-PRINT-2_Configuration 1_LeftBattery.stl, TEST-PRINT-2_Configuration 1_Pan_Tilt_pan_cap.stl, TEST-PRINT-2_Configuration 1_RASPBERRY_PI_5_WITH_ACTIVE_COOLER.stl, TEST-PRINT-2_Configuration 1_RightBattery.stl, TEST-PRINT-2_Configuration 1_Tank_body.stl, TEST-PRINT-2_Configuration 1_ball_brearing_r (1).stl, TEST-PRINT-2_Configuration 1_ball_brearing_r.stl]
2026-10-13 Research sprint A: retrospective iteration dataset, check-failure log, statistics and figure
    26 design findings Sep 27 - Oct 12 (median 1.6 h from finding to fix ready over 20 exact-time
    rows; 10 caught before printing; 5 slipped past a passing check) and 10 recorded cases of a
    check itself being wrong (7 false passes). Retrospective; time_basis marks how exact each row is.
    [check_failures.csv, iterations.csv]
2026-10-13 Research sprint B: start the live iteration log (nose print adhesion failure)
    [iterations_live.csv]
2026-10-13 Research sprint C and D: mutation harness, tumble simulation, surrogate; D/E protocol before any results
    - harness/: 22 seeded faults on the pan coil model (each a real past mistake or one of its kind), run against the
    nine existing checks unchanged; suites S0 (seated pairs only) and S1 (all nine)
    - tumble/tumble.py: MuJoCo drop simulation of the Trainer under a pill shell; top height, peak, width, CoM height,
    and a friction scale the surrogate is not given
    - tumble/sweep.py, surrogate.py: Sobol ground truth; a Gaussian process with calibration, active learning,
    uncertainty gating and its own controls
    - tumble/PROTOCOL.md: H2 and H3 stated before fitting or dropping anything; explorato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
    [surrogate.py, sweep.py, tumble.py]
2026-10-13 Research sprint D/E: surrogate controls, printable hull test bodies with a coin pocket, drop-test card
    - surrogate.py: gating and sentinels on held-out designs only; out-of-range and hidden-friction controls; figure
    - scale_model.py: each test body is a design's convex hull (rest states on a table depend only on hull and mass),
    an exact CadQuery solid with one coin pocket and a spacer; predict() simulates the same body and mass layout
    - DROP_TEST.md: Zach's 15-minute protocol (6 attitudes x 5 drops, mass low then high)
    - harness/run.py: one thread per worker; fresh model per task (pool workers had kept the last mutant)
2026-10-13 Research sprint D results: tumble ground truth, surrogate scored against the recorded H2, post-hoc sentinels
    400 designs: P(upright) 0.26-0.76; top height dominates. GP surrogate at 120 designs: RMSE 0.039, 87% coverage
    of 90% intervals; gated at 0.6 it decides 266/280 designs with 2 wrong. Out-of-range control met. The recorded
    hidden-friction control was not met (0/8): friction barely moves P here; post-hoc stronger changes also go
    mostly unseen by 8 sentinels, so the sentinel control is weak. Written up in PROTOCOL.md as recorded.
    [posthoc_sentinels.py]
2026-10-13 Research sprint E: drop predictions for the three test bodies, committed before any print or drop
    E1 tub / E2 dome / E3 tall at quarter scale (surrogate P(upright) 0.36 / 0.47 / 0.69 at full scale), mass low and
    high (12 quarters under or over the spacer), six starting attitudes, 200 simulated drops each, friction 0.65x-1.5x
    as the prediction's spread. Spacer added to the mass model.
2026-10-13 Research sprint C results: 22 seeded faults; pairs alone 12, suite 21, + screw alignment 22 (all 14 historical)
    The unmutated design passes all checks; no check is vacuous (each kills >= 2). M20 (tab block 0.6 out of place,
    its pilot off the tab screw) survived the nine-check suite: no check tested that screw holes line up. Added
    pan_coil_b_check.screw_alignment with a 0.6-off control (blocks 6/6); it kills M20 and five others. Logged as
    check failure C11, the first one found by the harness rather than by a person. S1 results kept as *_S1 files.
    [E1_tub.stl, E2_dome.stl, E3_tall.stl, check_failures.csv, mutation_matrix.csv, mutation_matrix_S1.csv, test_tall.stl]
2026-10-13 research E: run 1 drop data, raw sheet and transcription (unscored)
    [run1.csv]
2026-10-13 research E: run 1 body mapping and loading, as confirmed by Zach before scoring
    [run1.csv]
2026-10-14 research E: predictions at 30 cm and a release-height check (40/80 mm); note the sheet/video mismatch
    predict_drops.py takes --drop-mm/--tag/--bodies and refuses to overwrite the committed 60 mm file on a
    non-default run. A 60 mm rerun reproduced the committed predictions exactly.
2026-10-14 research E: E1 readings from the video (27 drops), 24/27 agree with the sheet; fix my misread of two side rests
    Also records that Zach's nose/tail look swapped against the card, left/right merge for symmetric bodies, and the
    classify() on-end label swap (to correct at scoring).
    [video_E1.csv]
2026-10-14 research E: run 2 drop data (mass low, spacer first), raw and transcribed, unscored
    [run2.csv]
2026-10-14 research E: drop scores. Model beats naive in all 6 groups (Brier 0.58 vs 1.29) and tracks the mass control; it under-predicts self-righting everywhere and its uncertainty band misses that
    [iterations_live.csv]
2026-10-14 research E post hoc: printed mass layout from the G-code doesn't explain the self-righting miss (Brier 0.578 -> 0.570)
    scale_model.predict takes an optional layout; with the old layout it reproduces the committed predictions exactly.
    [iterations_live.csv]
2026-10-14 research E: replacement spacers (0.5 mm play, chamfers, M3 pull hole, ID dots); the first ones broke coming out
    [spacer_v2_E1.stl, spacer_v2_E2.stl, spacer_v2_E3.stl]
2026-10-14 research E post hoc: the committed predictions dropped the wrong faces (heading turned about the body axis)
    Fixed (world_yaw), with start_check() and a failing control. With the fix the model scores worse (Brier 0.578 ->
    0.861, naive 1.293): simulated bodies stay on ends and sides that real 6 cm drops knock them off. The contact is
    too dead. Logged as L06 and C12.
    [check_failures.csv, iterations_live.csv]
2026-10-14 research: simulator audit. The sweep's shell had a fixed mass and height, which made the tall-shell design rule an artifact
    With the shell's mass scaled by its area, the best designs fall to the tub's P(upright). Option SHELL_MASS; the
    default reproduces the committed sweep. Also: two naming swaps, a dead contact (restitution 0.08), and tests that
    passed (penetration, face stability, time step, settle rule).
    [iterations_live.csv]
2026-10-14 research: live log times are commit times (with hashes); L02's open item points to what answered it
    [iterations_live.csv]
2026-10-14 research: cover-weight sweep corrects the audit. The tall-shape advantage holds for a light cover (0.53-0.62 vs the tub's 0.39 at 1-1.5 mm) and fades by 4-5 mm
    [iterations_live.csv]
2026-10-14 research: L08 commit time
    [iterations_live.csv]
2026-10-14 research E: bounce explains the miss (exploratory fit, restitution ~0.55, Brier 0.443); restitution 0.4-0.7 predicted for the slow-motion video before it is taken
    [iterations_live.csv]
2026-10-14 research: L09 commit time
    [iterations_live.csv]
2026-10-14 research E: pre-register H4. 30 cm predictions with the bounce fitted at 6 cm, before any 30 cm data are seen; bounce measurement tool with a synthetic test
    predict_drops.py takes --dampratio and --old-start, and refuses to write the committed file unless it is an exact
    rerun.
2026-10-14 research E: H4 control predictions at 30 cm (start fixed, dead contact), before any 30 cm data are seen
2026-10-14 research D post hoc: the same tall boxy wide shell wins with a realistic cover, dead or bouncy (P upright 0.65-0.67 vs the tub's 0.40); 'peaked' wording corrected
    [posthoc_sweep_v2.py, tumble.py]
2026-10-14 research E: slow-motion result. Flat drops rock rather than hop; restitution ~0.2-0.4, below the predicted 0.4-0.7, so bounce alone doesn't explain the miss
    measure_bounce.py: colour mode, template tracking, --fps for Apple's edited slow-motion export.
    [iterations_live.csv]
2026-10-14 research: L10 commit time
    [iterations_live.csv]
2026-10-14 research E: H4 model 4, 30 cm predictions with the measured bounce (~0.3), before any 30 cm data are seen
2026-10-14 research E: H4 amendment before any 30 cm data. The marked-height redo is primary; the first (guessed-height) session is secondary
2026-10-14 research E: H4 primary data (30 cm redo), raw and verbatim, unscored; three questions open before scoring
2026-10-14 research E: run 3 (30 cm) transcription and its three readings, fixed before scoring
    [run3_30cm.csv]
2026-10-14 research E: H4 supported. On the unseen 30 cm redo the bounce model beats dead contact (Brier 0.634 vs 1.156, CI of the difference 0.40-0.64) and naive (1.506)
    Still overconfident about mass at 30 cm. One 'c' corrected to x by Zach and rescored.
    [iterations_live.csv, run3_30cm.csv]
2026-10-14 research: L11 commit time
    [iterations_live.csv]
2026-10-14 research: naming note, PROTOCOL's H4 (30 cm) is the sprint plan's H3b
2026-10-14 research E: 40 mm PLA ball for the restitution measurement (prints like the bodies: 2 walls, 10% infill)
    [ball_pla_40.stl]
2026-10-14 research: the default contact sinks bodies 7-17 mm into the floor on impact (Zach, in the viewer); the audit's rest-only penetration test missed it (C13, L12)
    [check_failures.csv, iterations_live.csv]
2026-10-14 research: L12 commit time
    [iterations_live.csv]
2026-10-14 research: view_drop.py, watch simulated drops in the MuJoCo viewer from any start; dead, bounce or stiff contact
    [view_drop.py]
2026-10-14 research E post hoc: a hard floor with the measured bounce explains both heights unfitted (Brier 0.472 at 6 cm, 0.638 at 30 cm vs fitted 0.443/0.634)
    [iterations_live.csv]
2026-10-14 research E: pre-register H3c. Hard floor with measured bounce vs dead and fitted, at a new height (15 cm), before any drop
2026-10-14 research: the hard floor isn't converged at 0.5 ms (C14, L13); time-step option for predictions
    [check_failures.csv, iterations_live.csv]
2026-10-14 research E: converged hard floor (0.1 ms) re-scored (6 cm 0.483, 30 cm 0.693); H3c amended before any 15 cm drop (converged model primary; ball bounce added)
    [iterations_live.csv]
2026-10-14 research E: the PLA ball measured (12 drops, restitution 0.39, range 0.24-0.61); H3c amended again before any 15 cm drop (hard floor at 0.39 added)
    measure_ball.py fits each drop as one ballistic path (shared gravity and floor, free impact times); the ball's
    width checks the scale (gravity 9.8-11.0 m/s^2). test_measure_ball.py recovers known restitution within 0.004.
    Slower bounces (0.2-0.9 m/s) are livelier: median 0.78. bounce_curve takes the contact time constant and time step
    (defaults unchanged).
2026-10-14 research: L14 (the ball measured); L13 commit time
    [iterations_live.csv]
2026-10-14 research: phone_mount.py, a tripod adapter for a bare iPhone 15 (slow-mo drop video), with fit checks; preview server for tumble/out
    The fit checks' dummy screw and phone (models/_fig_*.stl) are regenerated each run and ignored.
    [phone_mount_iphone15.stl]
2026-10-14 research E: simulation vs the real drops, every model side by side (sim_vs_reality.md); post hoc 8, the 0.39 hard floor scores 0.456 (6 cm) and 0.672 (30 cm)
2026-10-15 research (exploratory): a Gaussian-process surrogate of the shape sweep; 3.6 pts from the simulator on held-out shapes (its own 200-drop noise: 3.4), ~140,000x faster; ranks the best shapes right but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
    [surrogate_gp.py]
2026-10-15 research: past the sweep's edge (taller peaks at 200-220, then falls to 0.41 at 400 mm; wider peaks at 175-200); the surrogate is overconfident at the best designs (C15: 1 of 6 inside its 90% band, ~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
    explore_wider.py generalised to explore_edge.py (--key width|top); width results unchanged. audit/surrogate_peak_check.py
    checks H2's calibration where decisions are made. Post hoc 9 in PROTOCOL.md; AUDIT.md limits; check_failures C15.
    surrogate_gp.py is marked as a second, independent GP; the sprint's surrogate is surrogate.py (H2).
    [check_failures.csv]
2026-10-15 research: L15 (the surrogate at the best designs)
    [iterations_live.csv]
2026-10-16 research F: paper draft v3. Pilot results for H1-H4 added (section 3), Figure 1 (one panel each for H1, H2, H3), aims and risks updated from the pilot, refs 5-7; three pages
    Placeholders left for Zach: name, [Org], the August 2026 start, and the 15 cm (H3c) result.
2026-10-16 research F: draft v3, Zach's first-pass review. A summary box states the claim and the chain (planted faults for the CAD checks, the simulator for the surrogate, real drops for the simulator); the op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
2026-10-16 research F: draft v3. Escapes bullet now carries the evidence (once assembly became a check, no assembly or access fault reached the bench after Oct 3, and the next was caught by the sweep; wire rout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
2026-10-16 research F: draft v3 back to three pages (837dc66's PDF had overflowed to five: print wraps differently from screen, and 0.17 in of slack was under a line). Pages 1 and 3 now keep 0.35 in; a few word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
2026-10-17 research E: drop stand for the 15 cm drops (pinch clamp on a pinned arm, 150 mm gauge), with checks and controls; H3c third amendment before any 15 cm drop: released from the stand, predictions and s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
    Checks: jaws open to 95 mm at the pads (widest grip 84.9; control: 90 mm handles fail); no collisions through the
    travel (control: a wide bridge collides); all 18 body x start settings reach a 150 mm lowest point (control: one
    post hole fails all). One plate, 1 h 54 min, 95 g.
    [drop_stand_arm.stl, drop_stand_base.stl, drop_stand_gauge.stl, drop_stand_jaws.stl, drop_stand_pins.stl, drop_stand_post.stl]
2026-10-17 tools: orca.py fails when Orca's arrange leaves a part off the plate (the drop stand's post, jaws, gauge and pins went to an unsliced second plate; control: the original six-part slice now fails nami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
    [iterations_live.csv]
2026-10-17 research E: H3c data (15 cm, from the drop stand), raw and verbatim, unscored; one mark open (a "c") before scoring
2026-10-17 research E: run 4 (15 cm) transcription and its readings, fixed before scoring
    [run4_15cm.csv]
2026-10-17 research E: H3c supported. On the unseen 15 cm drops (from the stand, 179 scored) the converged hard floor beats dead contact (Brier 0.675 vs 1.118, CI of the difference 0.35-0.54) and naive (1.520).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
2026-10-17 research: L17 logged (H3c confirmed at 15 cm)
    [iterations_live.csv]
2026-10-17 research E: run 4's "c" was a typo for x (Zach, after the first scoring); rescored on all 180 drops, no number moved by more than 0.005 and H3c still supported (0.677 vs dead 1.120)
    [run4_15cm.csv]
2026-10-17 research: L17 updated to the 180-drop rescore
    [iterations_live.csv]
2026-10-17 research F: draft v3 with the 15 cm result. H3's placeholder filled (third blind test held: primary hard floor 0.68 vs default floor 1.12, CI of the difference 0.35-0.54; the measured-bounce floor 0.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
2026-10-24 checks: the check library, draft 1, and the adversary's first backtest (PARTIAL on P23)
    The paper's method as everyday work. checks/README.md: principles (fail closed, controls run every time, the
    mutant set only grows, the bench outranks every check), the agent loop, a check's statuses, rot signals,
    requirements R1-R12, the baseline, and open questions for Zach. .claude/agents/: adversary, gatekeeper, bench
    intake, auditor. checks/registry.csv: all 37 existing checks (10 mutation-scored, 24 legacy, 3 on watch).
    checks/audit.py: the registry's integrity audit; its control flags 7 of 7 planted faults; on the real registry it
    flags 9, among them P05 traced to no check and K02 (insertion) with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
    [registry.csv]
2026-10-25 research F: draft v4 from the section-by-section review of v3 (review-v3.md); 3 pages from Edge's print dialog
    Zach's calls on 21 flags, each checked against the repo. Changed: the counts (A check caught wrong 19 times, 13
    false passes, 9 in the pilot, after logging C16-C19 from backtest 1); the agent dates (building since Feb 2025, the
    agent on software since July 2026 and on CAD since September, from Control's git log and the session records);
    "code-based CAD in Python (CadQuery and signed-distance models)"; the Escapes bullet (a lesson alone let an access
    fault through, a lesson with a check caught the next assembly fault; forces are 8 of 16 bench escapes); the
    pre-registration sentence (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
    [check_failures.csv, registry.csv]
2026-10-25 research F: v4 prints at 3 pages; the print CSS kept the body's default 8px margin; PDF added
    8094072 said v4 fit three pages, from a screen measurement (0.36 / 0.32 / 0.25 in). In print it did not: Zach's
    PDFs came out at 5 pages. Those went through the Microsoft Print to PDF printer, which lays the page out again, but
    the root cause was in the paper. Its print CSS reset the body's padding, not its default 8px margin, so print had
    16px less width and less height than designed (the PDF's page geometry shows the content box 8px in). v3 had the
    same bug and fit by 0.04 in. v4's print CSS now sets margin:0.
    pagefit.py --print is now the fit test: it prints each sheet alone with headless Edge (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
2026-10-25 research F: review-v3 records Zach's §1 calls; flag 1.2 leads with its question
    1.1 leave as is (v4 keeps "19 times"), 1.2 counted, 1.4 held for the space check, 1.5 reworded,
    3.7 done with 1.2. Flag 1.2 is cut to its question and the count change, with the v3 -> v4
    before/after under the table.
2026-10-25 research F: draft v5 from the review of v4 (review-v4.md); 3 pages
    Each kind of check, not every check, was tested (the audit flags three without a working control).
    "Before the pilot" dates the ten cases. "All but the newest four" changed how their kind of check is
    done: C16-C19 are still open. H3 names the naive guess; H2 says what the sentinels were; the agent-
    errors risk says checks must catch the mutants; Aim 1's "they" is "its checks" again; Fig. 1B's
    caption says tumble reruns. Fit trims are listed in review-v4.md. pagefit --print: 0.30 / 0.22 /
    0.15 in; PDF from pagefit --pdf, 3 pages. v4 superseded, kept as it was.
2026-10-25 research F: draft v6 from a cold read of v5 (review-v5.md); 3 pages
    A fresh agent with only the paper read v5 as a SPARC panelist (3 / 5) and listed 29 questions; each
    was checked against the repo. Fig. 1C plots the registered 15 cm primary (the 0.31 hard floor) at
    every height, and labels the first model by its start bug. The 30 cm test is named as the
    registered main test. H2 gives the gate's record where it matters: of the 10 designs that truly
    clear 60%, it accepted 3, sent 6 on and wrongly rejected 1 (recomputed, seed 7). H1 states the
    out-of-sample 7 of 8. Aim 2 points MuJoCo at the forces behind half the escapes; Kennedy and
    O'Hagan replaces [4] at the calibration step; Aim 3 compares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
2026-10-25 research: post hoc 10, the blind tests' CIs resampled by cluster; both results hold
    A cold read asked whether resampling single drops makes the CIs too narrow. Resampling whole
    cells (5 drops from one start, 36 per height) widens them: 30 cm 0.38-0.68 (was 0.40-0.64), 15 cm
    0.31-0.59 (was 0.35-0.54). By body-and-weight group (6) they barely move. Both stay far from 0.
    The paper keeps the registered CIs (Zach, 2026-10-25); review-v5.md's interview answer updated.
    [posthoc_cluster_ci.py]
2026-10-25 research H5 (exploratory search, pre-registered test): E4_weeble's drop predictions, committed before any E4 drop
    The sweep's shell family (tub length, flat top) peaked at P(upright) 0.65-0.68 for the robot and 0.54 for its best
    print (E3). shell3.py is a wider family (a superellipsoid shell, 10 knobs, the same robot inside, the same print
    method); search3.py ran it in stages on 30 cores in about 27 minutes: statics of 131,072 designs, 800 designs at
    120 drops, a cross-entropy search on the CoM margin under four footprint caps, and 28 finalists under every contact
    model, both frictions and the coins high (174,240 simulated drops in all). Single-rest-state shells start at about
    377 x 362 x 27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
    [E4_weeble.stl]
2026-10-25 research (exploratory): drop-pose lab on the Trainer: arm poses, wheels in flight, a chassis search for steps
    All simulation, after the E4 search; no physical test. Seven model errors were found by tracing single runs and fixed
    before the numbers below; each is written into the scripts' docstrings.
    - fig_e4_ground.py: E4's shell is cut 32 mm off the floor (the tyres touch, approach and departure as the bare tub);
    as a cage of 12 hoops it keeps upright its only rest state (margin 23-45 mm, 4-6 hoops add rests).
    - pose3.py: guard arm E held still on the Trainer. 4,466 clear poses, ~300k drops: best 0.565 upright against 0.452
    with no arm; the stowed guard arch is worse (0.410). The capsul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
    [chassis3.py, fig_e4_ground.py, pose3.py, render_chassis3.py, render_pose3.py, render_wheels3.py, wheels3.py]
2026-10-26 Leak audit: a scanner, a pre-commit hook and a redacted report; Wi-Fi and the printer's address moved to local files
    tools/leakscan.py scans the tree, the staged changes, every commit (blobs, author emails and messages) or a folder,
    including the metadata in photos, PNGs, PDFs, STEP files, STL headers, MP4s and CAD zips, with an allowlist
    (tools/leakscan_allow.txt) and a redacted report. docs/audit/2026-10-25-leak-report.md is the audit of the whole
    history, with the calls left for Zach at the top.
    Fixed in the tree: the 2024 archive sketches read their Wi-Fi from gitignored wifi_secrets files (templates
    wifi_secrets.example.*); tools/config.py reads the printer from the untracked tools/con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
    [DCMotorTest.ino, WiFiClient.ino, code.py, render2.py]
2026-10-26 Gallery: a public site of the visuals, built from this repo and published from a separate public repo
    tools/gallery/build.py builds site/out from tools/gallery/manifest.json: pages wrapped with a back link, private
    claude.ai links stripped, thumbnails, video pages and an index. Gates: every link resolves (case-exact), sizes under
    GitHub's limits, external loads only from the allowed CDNs, nothing unlinked ships, and leakscan finds nothing.
    tools/gallery/publish.py pushes the build to ZacharyShaver/scorpion-gallery under the GitHub noreply identity (dry run
    unless --yes). Live at https://zacharyshaver.github.io/scorpion-gallery/.
    The 14 chassis and head 3D pages are held: they embed third-pa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
2026-10-26 chassis-v2 step layout (exploratory): the step search's best layout at the Trainer's length, built
    SCORPION_WHEELS=step builds the layout research/tumble/chassis3.py found for driving down steps: Ø92 wheels on a
    shorter wheelbase (axles -77/+53), the belly 54 mm off the ground (was 32) with each pod hung on a drop plate, the packs
    forward. trainer.py checks it with controls and writes the Step Trainer page (chassis-v2/out/trainerstep.html).
    research/tumble/built3.py drives the built meshes down steps on the hard floor: down 63% of runs against the Trainer's
    51% (research/results/chassis3/built.json). sens3.py splits the gain: it needs the short wheelbase and the raised belly
    together, and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
    [built3.py, chassis3.py, render_steps.py, rugged.py, sens3.py, trainer.py, wheels.py]
2026-10-26 Third-party files: a record of each, and the ones not cleared for sharing kept locally and gitignored
    THIRD_PARTY.md lists what comes from others. FPV-Rover V2.0 (CC BY-NC-SA 4.0), the Luengoa tracks (CC BY-NC) and the
    Raspberry Pi 5 model (CC0) stay tracked with their records. The saved Printables and Instructables pages, the PCA9685
    models and the MG90S servo and horn models (licences not recorded) stay on disk, gitignored; their SOURCE.md and
    README records say where they came from and how a fresh clone gets them back.
2026-10-27 Gallery: third-party parts only as stand-in boxes or with credit; a first section for the paper's reviewers
    Parts with no recorded licence (the PCA9685 board, the MG90S servo and horn) may appear on a published page only as
    plain boxes; credited ones (FPV-Rover V2.0, the Luengoa tracks, the Raspberry Pi 5 model) carry their licence in a
    footer. The gate matches meshes by shape, since the servo is fused into bigger meshes under other labels. The
    reviewers' section follows "Checks That Can Fail" in order (H1, H2, H3). THIRD_PARTY.md and the pan coil's SOURCE.md
    record that the servo and horn exports from Zach's assembly stay tracked (his call, 2026-10-26). 208 tests pass.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
2026-10-27 Tumble protocol: E4's H5 drops stopped halfway, not scored
    Zach ran about half the drops; every one came to rest upright, and by hand the print would not sit any other way.
    He stopped the run as a waste of time. No marks were kept, so H5 is recorded as seen, not scored; the mass-high
    control was not run.
2026-10-27 Gauges: the Scorpion's requirements as tests that read a number off any design, and the searches run on them
    G1 upright after a fall, G2 step up and G3 turn-around space, each worst over the friction band with a control, and
    G4/G5 hills proposed (2.5 m of slope, held to each design's static tip angle by static_check). The generative searches
    built on them: shapes, a tail, the drive, the lean rerun, the body's shape, the shape study (T3) and the hills run with
    the wheels and packs unlocked.
    The knob log (knobs.py, knobs_page.py): every T3 knob one at a time on all five gauges, stowed and braced, with two
    new knobs (tyre width, tail mount height) and a side-slope probe; a reel of gauge tries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
2026-10-28 Gauges: G6 crest and G7 push proposed, and the knob log works through the candidate knobs
    G6 crawls over a rounded ridge and reads the steepest one crossed; G7 reads the heaviest box shoved 0.5 m at the
    friction band's worst. Both negative controls pass (a lower belly and a longer box read lower on the crest; less
    gearing and half grip read lower on the push). A gauge's terrain or objects now go in after the robot's body, so its
    free joint stays first in the state, and the tyres take contact priority so a tread below the floor's friction counts.
    The knob log reads both on every setting and adds tyre grip, tail foot size and a push face. Findings: T3's crest
    sits on a plateau and reads 25 or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
2026-10-28 Gauges: G4-G7 adopted with targets, and the knob page shows each knob's shape
    Zach adopted the hills (G4/G5), crest (G6) and push (G7) gauges on 2026-10-27:
    hills as steep as they go, crest at least 20 deg, push at least 3 kg. The README
    gains an iteration-2 targets table (box, best design, T3). The Scorpion Knobs
    page now draws a side view of each knob's lowest and highest setting, and a 3D
    view with a setting slider and a T3 ghost in the opened row (models.json).
2026-10-28 Gauges: G4-G7 on the scorecard, G3 found to read the CoM's offset, and a knob review
    card.py reads the hills, crest and push on every design the Scorpion Gauges page shows,
    with each gauge's controls in the same pass (all pass), and G1-G3 for T3 with a 170 mm
    tail mount. That variant and T5 on the Trainer body meet every target with a number.
    The page now shows the shape study's finalists (GAUGES_CURRENT moved from the body
    search). The hills and the push re-read the same; the crest moved up to 15 degrees on
    three designs, so a crest difference under 15 is noise. export.py had dropped each
    G1-G3 control's claim and reading (a comment swallowed them).
    card.py com shows G3 reads mostly the Co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
    [card.py, export.py]
2026-10-28 Gauges: a capability search pushes every gauge to its ceiling, two dead knobs dropped, and the gauge pages in the gallery
    The capability search (gauges/capability.py, capability_page.py) left all 28 knobs free and pushed each gauge
    alone, with no weights between them: 1,024 Sobol designs, then CEM refinement in 8 streams, then full reads of
    each stream's best. Ceilings in this sim: upright 1.00, step 225 mm (140 mm wheels, at twice T3's turn), turn about
    389 mm (T3's own), hills 60 deg up and 65 down and push 8 kg (a 5.5 kg six-wheeler), crest 45 deg. The designs split
    into two families with nothing between them, and T3 with its tail mount at 170 mm is still the best all-rounder.
    The all-rou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
2026-10-31 Review fixes: the mesh report fails closed, resumed runs refuse mixed code, pinned dependencies, and the pan coil's controls run
    - tree_parts: a self-intersection count that errors reads UNKNOWN instead of 0.
    - tools/stamp.py: a results file a long run resumes from carries a stamp of the code that wrote it; a resume over
    other code stops unless --resume-anyway, and the mix is logged.
    - tools/requirements.txt pinned; the generator's requirements point to it.
    - pan_coil_b_check: --broken runs every controlled check's negative control and exits 1 when one still passes; the
    insertion control closes the shaft's channel (pan_coil_b.SHAFT_SLOT_R 0); the slide steps 2 mm. Registry K02 updated.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
    [registry.csv]
2026-10-31 Gauges: one-piece bodies grown by FEM, the tail's second link, and a realistic build with a repeatable step for the search
    - One-piece bodies (unibody.py, fem.py, drops.py, body.py, body_tree.py): the robot as one signed distance field,
    grown where a GPU voxel FEM finds the printed wall overstressed in one-wheel landings, capped at 2 kg on TPU
    bumpers, falls as the verdict. The core field is exact (no voxel terraces) and the mesher leaves no folds
    (unibody.py check). design_knobs grows any searched design; the stress solver's multigrid no longer NaNs on an
    empty coarse row, and a landing falls back to the plain solve.
    - The tail: a second link on an elbow with planar IK and a walk, a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
    [blend.py, body.py, body_tree.py, capability.py, capability_page.py, cohere_sheet.py, crest.py, drops.py]
2026-10-31 One-click tests for the realistic run, and desk-model minis
    - oneclick/*.bat (README.txt there) run gauges/tomorrow.py on capability_real without an agent: status, results
    (finals run if missing, the page), repeat (the best read with three seed sets: does a reading move with luck?),
    onepiece (the best grown as one piece and read beside the realistic build), film (a 150 mm step and the spin),
    checks (every check of 2026-10-31 with its control). --quick smoke-tests each.
    - gauges/mini.py: a design as one solid desk model at quarter scale (body, wheels, tail and flippers stowed, axle
    stubs so nothing prints loose; it refuses a model in pieces). Mini T3 and the low step-and-turn winner p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
    [mini.py, tomorrow.py]
2026-11-03 Gauges: G7 tow, G8 rough ground, importance weights, an obstacle course, and gauge films
    - G7 tow (tow.py): push read the robot's weight, so the tow run (SCORPION_CAP=capability_tow) reads a towed sled
    instead; tow still tracks weight (r 0.88, about 1.16 x its own), so Zach chose importance weights over per-kg.
    - Importance weights (weights.py): one weight per gauge, the all-rounder their weighted worst rank (all 1 until
    Zach sets them; equal weights reproduce the old worst rank). weights.py check has the controls.
    - G8 rough ground (rough.py): the rock size a design drives 2 m across, the step's pooled rule at 0.9 of tries,
    at x2.5 grip. capability_rough wires it in as an eighth gauge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
2026-11-03 Twin: the Trainer's tub, the sim's own housing, printed to fit the real parts in
    - twin/trainer_tub.py exports the Trainer's tub (chassis-v2/rugged.py tub(), the only housing the sims ever
    modelled) as drawn: 276 x 140 x 50 mm, about 10 h, printing 2026-11-03. Its checks place his parts where the sim
    does, with controls: the 24 mm ESC fits its 26.5 bay, the packs have 1.5 mm of side play, ESC and pack end to end
    leave no room for the T-plugs, the Pi stack stands 5.3 mm over the top.
    - fit_cups.py (a test cup per part) and boxes.py (free-standing boxes) were superseded before printing, marked in
    twin/README.md.
    - tools/config.py: TWIN and TWIN_OUT. print-on-k2: leveling before a print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
2026-11-03 Review fixes: tyre springs in real N/mm, the course's terrain grip, a two-link tail's mass, a crash and a stale resume
    A code and math review (docs/audit/2026-11-03-code-and-math-review.md). Each fix has a check with a control.
    - The tyre and bumper springs (robots.spring_solref): MuJoCo's direct solref is per unit mass, and tyre_k went in
    as written, so a "30 N/mm" tyre was about 15 N/mm on a 2 kg robot. python gauges/robots.py spring: 0.5 and 2 kg
    balls stay on the contact 12.80 and 25.70 ms, a spring's pi sqrt(m/k); the old conversion gives 18.20 for both.
    Moves snap, drops and unibody's falls only (G1-G8 use the hard contact).
    - The course's rocks and ridge (course.Rig): the tyres'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
    [course.py, drops.py, robots.py, search.py, snap.py, unibody.py]
2026-11-10 Twin: the brain box and its holders, print noise and the spring stack; noisy copies; the Fable review
    A week of work, 2026-11-04 to 2026-11-10.
    Twin
    - The Pi's box rebuilt from the Printables case, its rings bored for the HAT screws (pi_box.py); printed, fits.
    - The modular floor: the peg test (5.1 holes for a 5 mm peg, from the bench), then four holder shapes,
    each superseding the last: holders.py, bricks.py, part_boxes.py, and part_boxes.py in 7 mm units.
    - One brain box layout to react to (brain_box.py), its parts review page, the grid layouts and their
    wire-length check, and the fit against the sims' bodies (sim_fit.py).
    - retention.py: the drop test of holders. Its "the lid holds i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
    [brain_box.py, bricks.py, capability.py, grid_eval.py, grid_eval_page.py, grid_layouts.py]
2026-11-11 After the review: a mule first, the parts ordered, the spring stack plate printed
    - decisions.md, 2026-11-10: Zach takes a mule first (the gauges' plain box or T3,
    not chosen); the spring stack's PLA parts are queued and started; the TPU clips
    wait; everything on the parts list is ordered, the MDD3A drivers skipped; the
    Pi's regulator is the Mini560 Pro, with its check before the Pi rides on it.
    - SHOPPING.md: an AliExpress pass (about $90-150 for the buy-now parts); the
    Y-harness line corrected (the first link was a series adapter, which can't
    split one pack); the coming motor is the 330 rpm ratio the sim models; the
    tapped T-plug leads noted as owned.
    - The Fable review correct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
2026-11-11 Spring stack: the PLA parts on the bench, the clips in TPU; a design skill and print lessons
    - Bench, 2026-11-11: the PLA stack goes together. Boxes drop on with no force,
    move 0.1-0.3 mm, and both ESCs fit both boxes, so the two-peg joint (4.6
    locating, 4.0 backup, 5.1 holes) is tested on the ESC and PCA boxes.
    - The clip strip is twelve clips, four of each blade. Its scale test is done on
    the stack: a clip alone stands on its prongs and bends in its floor.
    - tools/orca.py --material TPU: Creality's Generic TPU preset for the K2 Pro and
    a purge line at its flow. The PLA path renders as before. First TPU print from
    here, started; its result isn't in.
    - The hoop has no pegs by desig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
2026-11-11 One design workflow: design-part runs the check library; the TPU clips on the bench
    - design-part is the single workflow; each step reads or writes checks/ (registry,
    predictions, the findings ledger). checks/README.md points back at it.
    - Registry: the twin checks as K38-K42 (legacy), and K43, a proposed sideways
    stop, from the kick test.
    - Ledger L18-L20 and the first predictions file, scored: the PLA stack held,
    the TPU prongs lock in, it survives 5 drops; a kick slides it along the hoop.
    - print-on-k2: the TPU line and the prong fit, from the bench.
    [iterations_live.csv, registry.csv]
